rodrigoqweds90/Proyecto-Robot/CAD/Nuevo/vistas_torso/conceptos/estilo_2.jpg

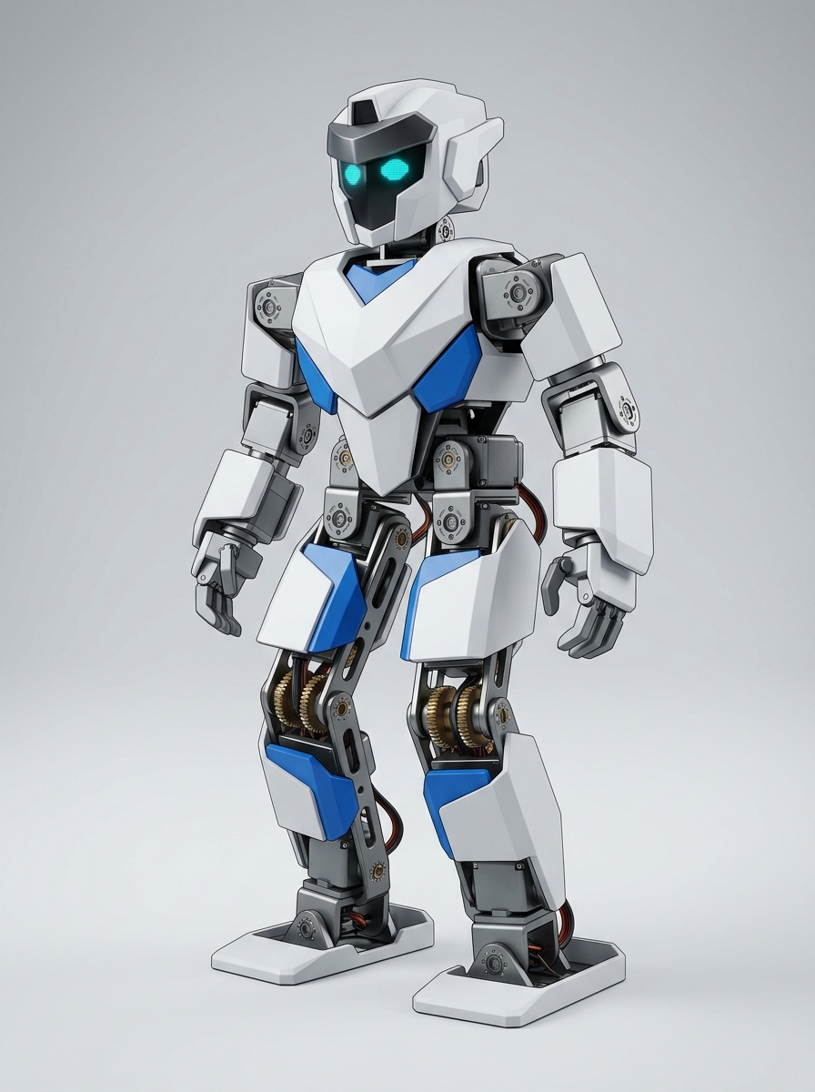
CAD/Nuevo/vistas_torso/conceptos/estilo_2.jpg
