rodrigoqweds90/Proyecto-Robot/CAD/Nuevo/vistas_torso/conceptos/concepto_4_gundam.jpg

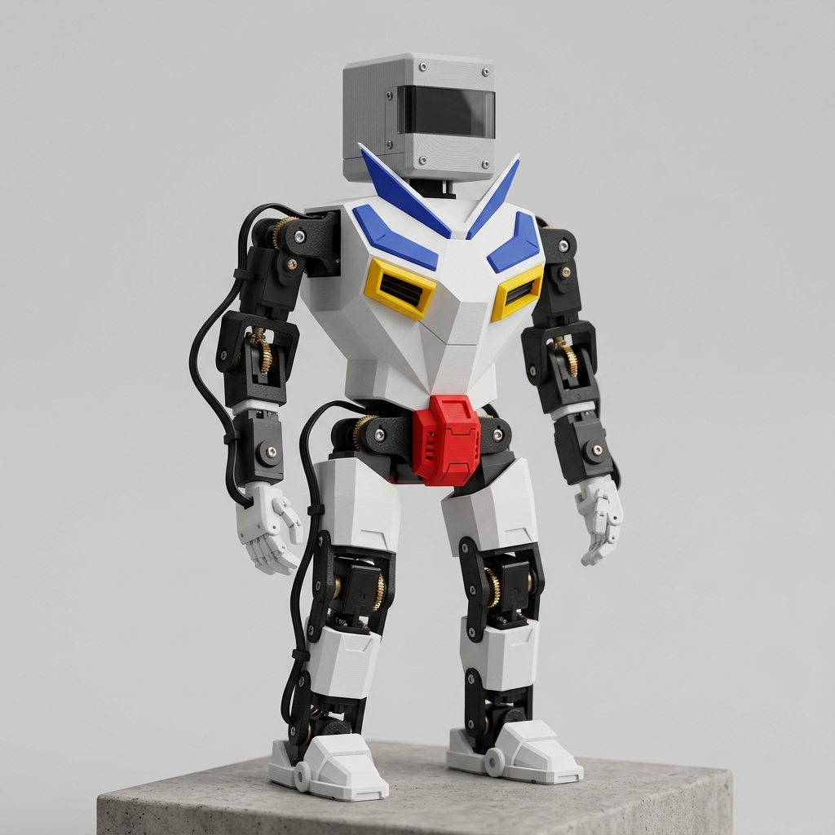
CAD/Nuevo/vistas_torso/conceptos/concepto_4_gundam.jpg
