rodrigoqweds90/Proyecto-Robot/movimientos/LEEME.txt

Poses y secuencias de la app (exportadas con "Exportar movimientos").
En otra PC: app RobotControl -> Configuracion -> Importar movimientos... -> elegir movimientos_robot.json
Cada secuencia es un ciclo de paso para "Repetir en bucle" (arrancar con el robot en Inicio).
Se actualiza corriendo herramientas/secuencias_finales.py y exportando de nuevo.
