rodrigoqweds90/Proyecto-Robot/CAD/Nuevo/conceptos/antebrazo/forearm_hand_concepts_1789850828380.jpg

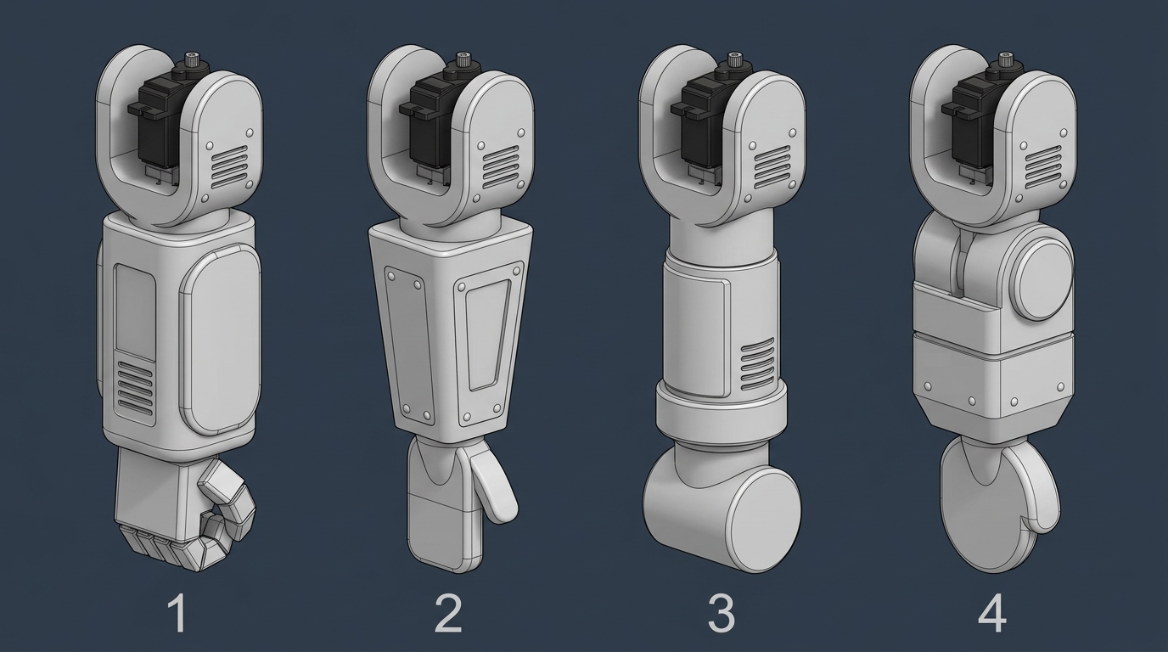
CAD/Nuevo/conceptos/antebrazo/forearm_hand_concepts_1789850828380.jpg
