rodrigoqweds90/Proyecto-Robot/CAD/Nuevo/fea/Bracket01_B_aligerada_esfuerzo.png

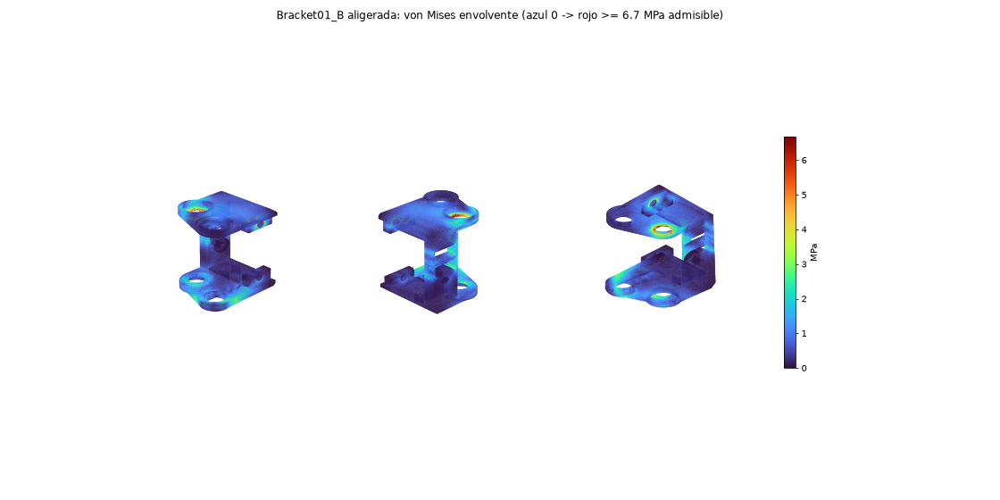
CAD/Nuevo/fea/Bracket01_B_aligerada_esfuerzo.png
