rodrigoqweds90/Proyecto-Robot/CAD/Nuevo/fea/Bracket02_W_aligerada_esfuerzo.png

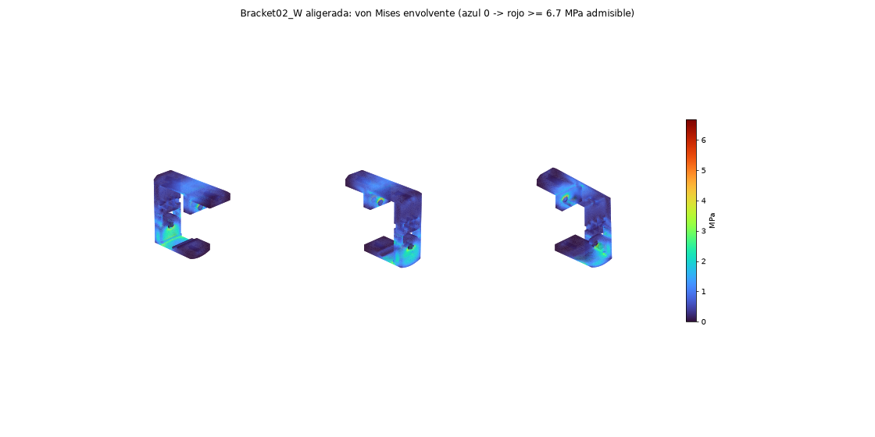
CAD/Nuevo/fea/Bracket02_W_aligerada_esfuerzo.png
