rodrigoqweds90/Proyecto-Robot/CAD/Nuevo/fea/Bracket03_B_esfuerzo.png

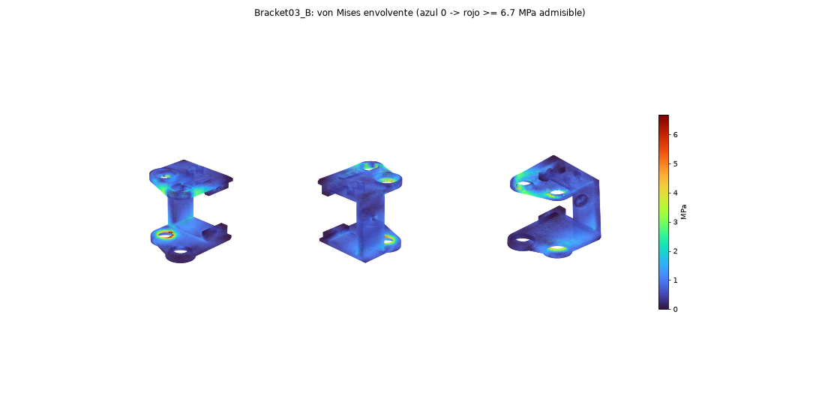
CAD/Nuevo/fea/Bracket03_B_esfuerzo.png
