rodrigoqweds90/Proyecto-Robot/CAD/Nuevo/fea/Bracket05_B_esfuerzo.png

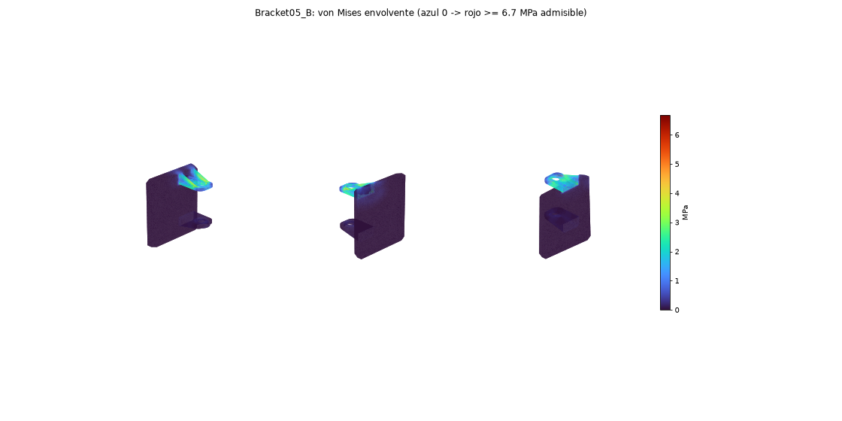
CAD/Nuevo/fea/Bracket05_B_esfuerzo.png
