rodrigoqweds90/Proyecto-Robot/CAD/Nuevo/fea/Bracket08_B_esfuerzo.png

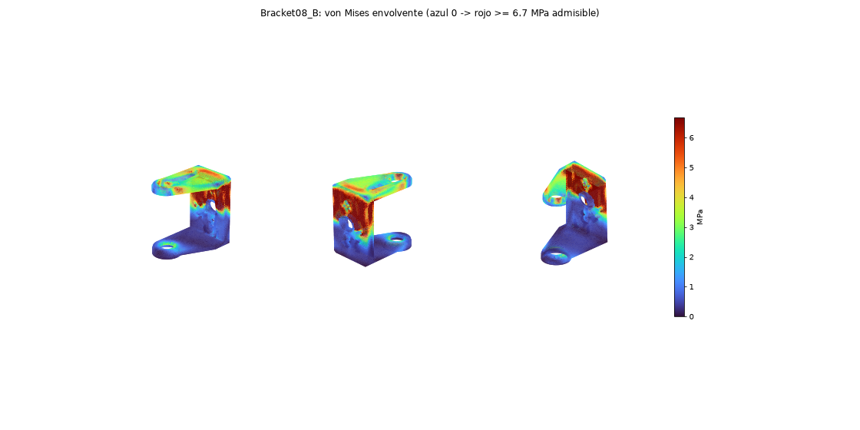
CAD/Nuevo/fea/Bracket08_B_esfuerzo.png
