rodrigoqweds90/Proyecto-Robot/CAD/Nuevo/fea/Bracket11_B_esfuerzo.png

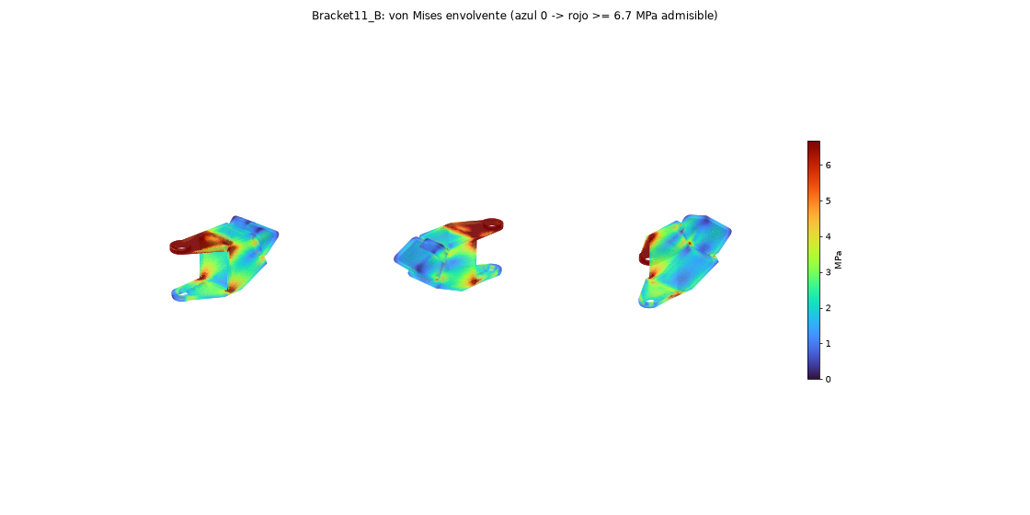
CAD/Nuevo/fea/Bracket11_B_esfuerzo.png
