rodrigoqweds90/Proyecto-Robot/CAD/Nuevo/fea/Link_W_esfuerzo.png

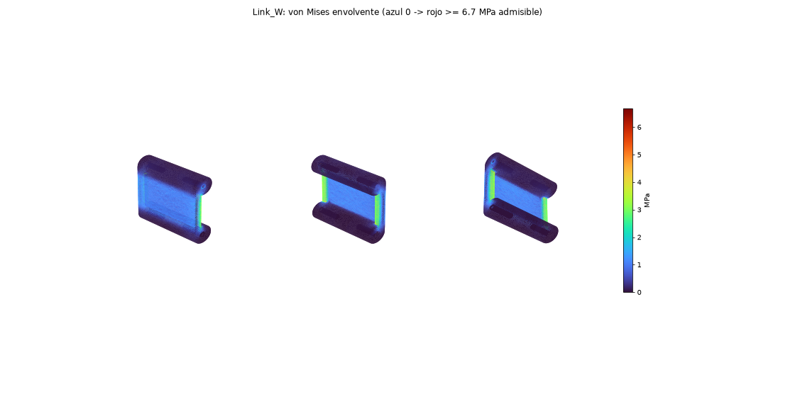
CAD/Nuevo/fea/Link_W_esfuerzo.png
