rodrigoqweds90/Proyecto-Robot/CAD/Nuevo/fea/Pelvis_esfuerzo.png

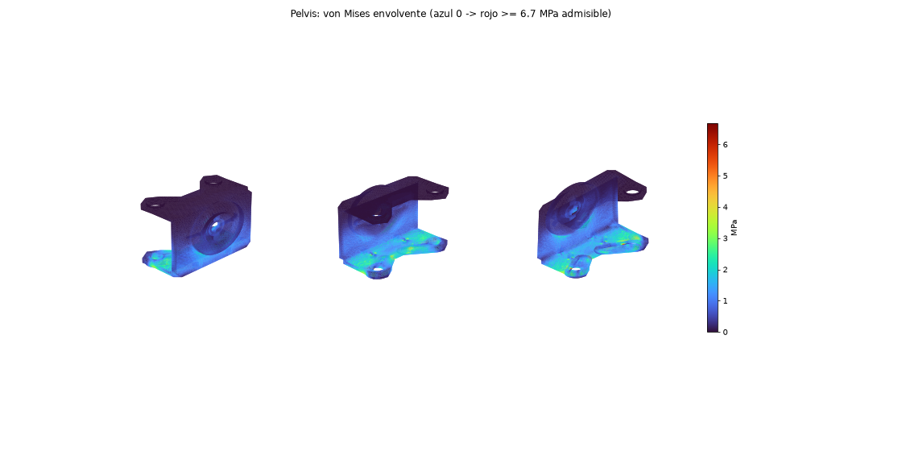
CAD/Nuevo/fea/Pelvis_esfuerzo.png
