rodrigoqweds90/Proyecto-Robot/CAD/Nuevo/fea/Torso_cuerpo_aligerada_esfuerzo.png

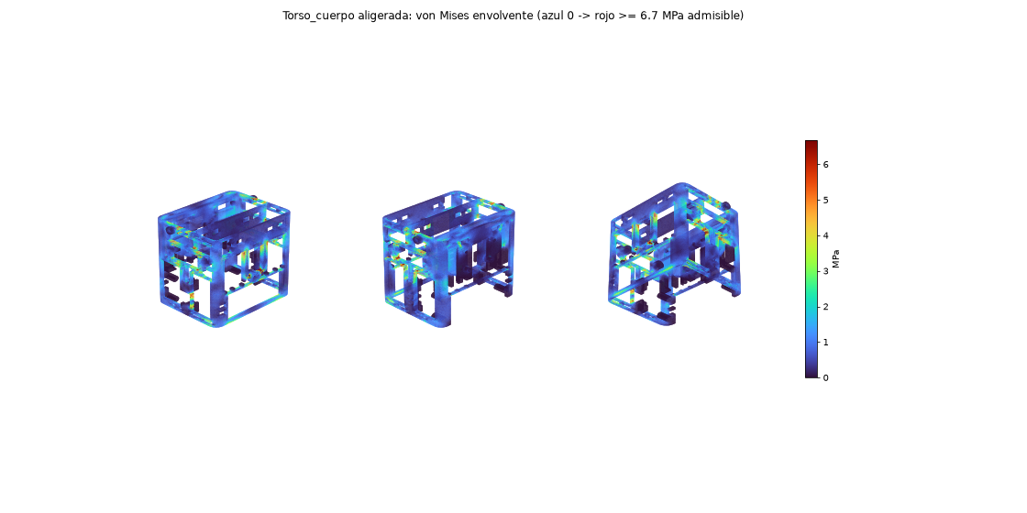
CAD/Nuevo/fea/Torso_cuerpo_aligerada_esfuerzo.png
