rodrigoqweds90/Proyecto-Robot/CAD/Nuevo/fea/ver_pelvis.png

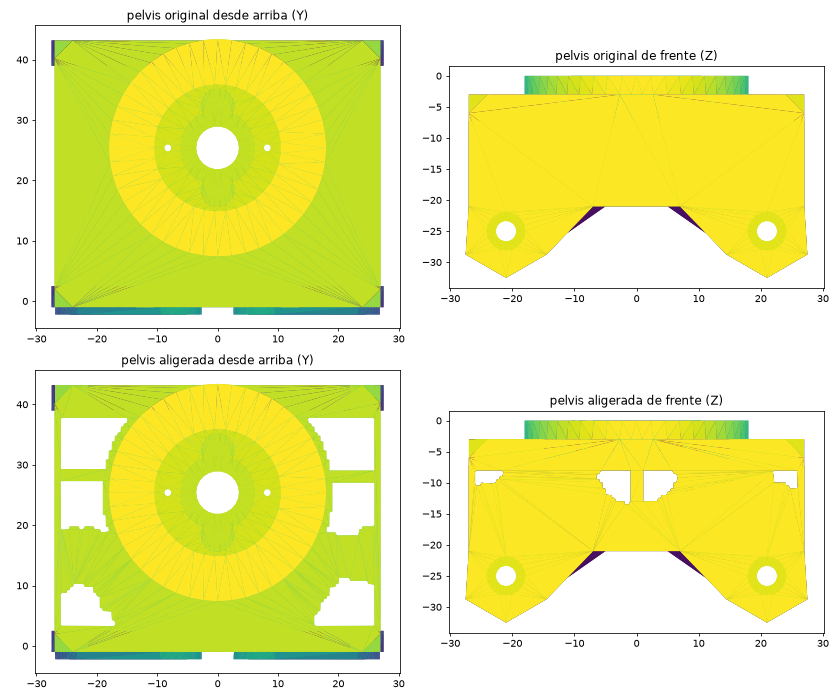
CAD/Nuevo/fea/ver_pelvis.png
