rodrigoqweds90/Proyecto-Robot/CAD/Nuevo/fea/ver_pie.png

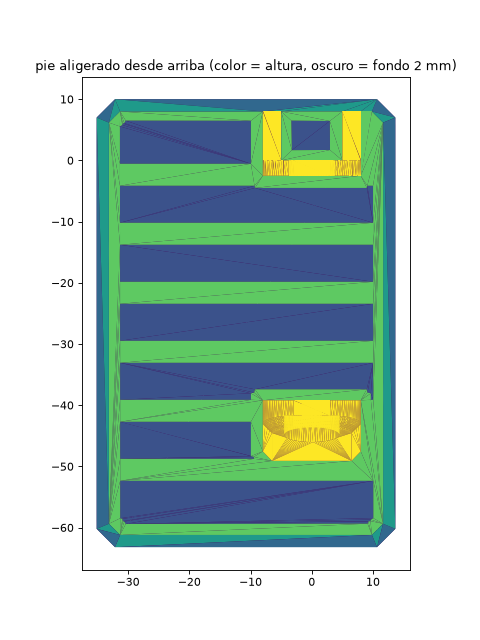
CAD/Nuevo/fea/ver_pie.png
