rodrigoqweds90/Proyecto-Robot/CAD/Nuevo/vistas/cabeza_4_vistas.png

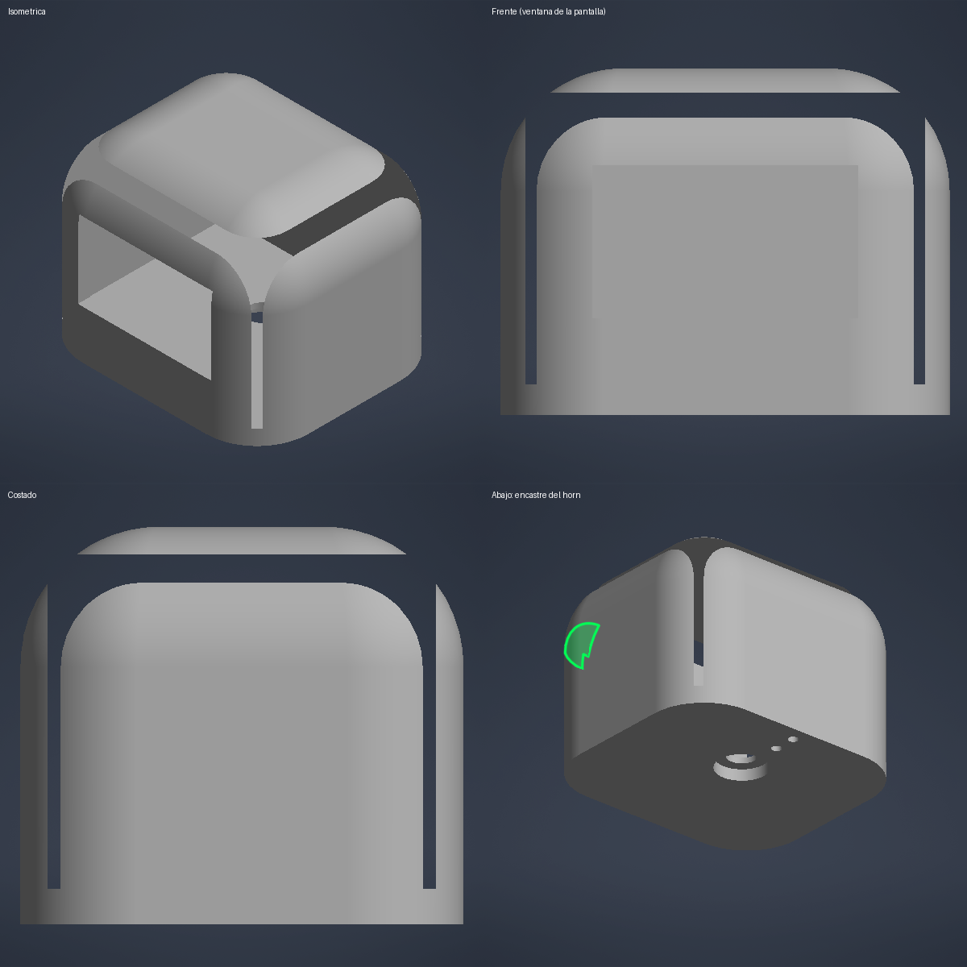
CAD/Nuevo/vistas/cabeza_4_vistas.png
