rodrigoqweds90/Proyecto-Robot/CAD/Nuevo/vistas/cabeza_abajo.png

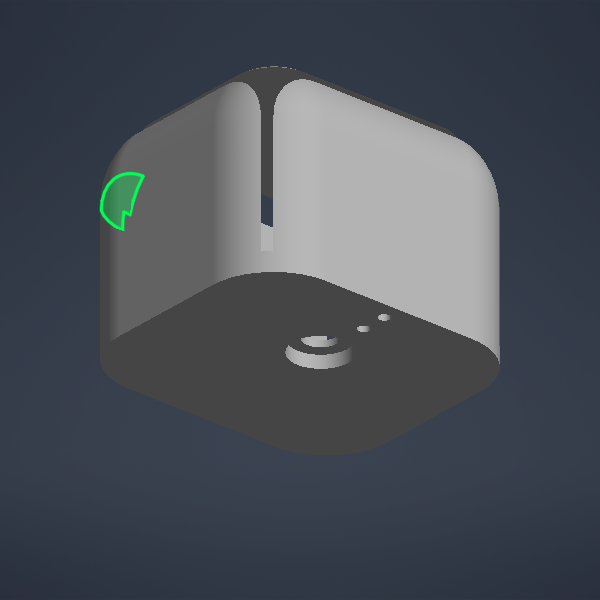
CAD/Nuevo/vistas/cabeza_abajo.png
