rodrigoqweds90/Proyecto-Robot/CAD/Nuevo/vistas/cabeza_atras.png

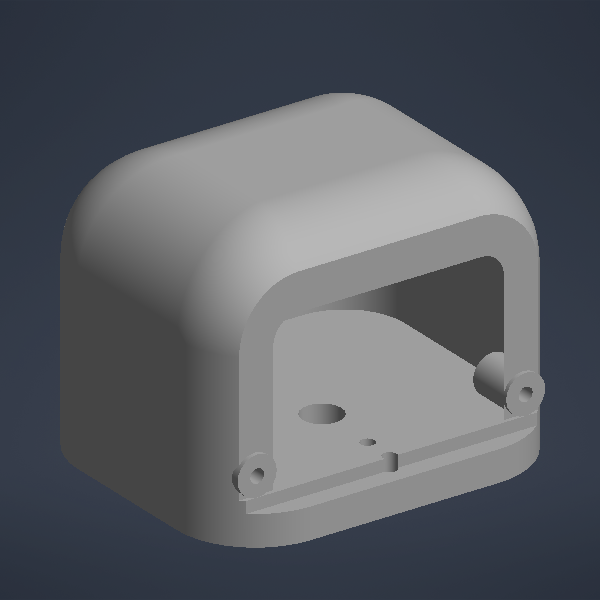
CAD/Nuevo/vistas/cabeza_atras.png
