rodrigoqweds90/Proyecto-Robot/CAD/Nuevo/vistas/cabeza_costado.png

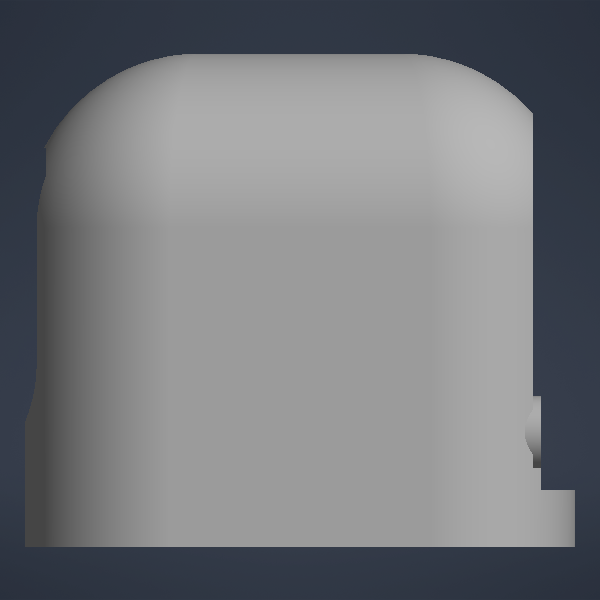
CAD/Nuevo/vistas/cabeza_costado.png
