rodrigoqweds90/Proyecto-Robot/CAD/Nuevo/vistas/cabeza_frente.png

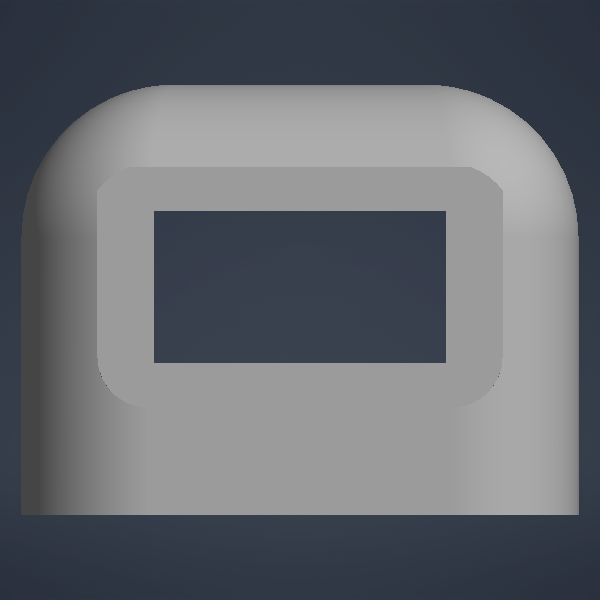
CAD/Nuevo/vistas/cabeza_frente.png
