rodrigoqweds90/Proyecto-Robot/CAD/Nuevo/vistas/cabeza_iso.png

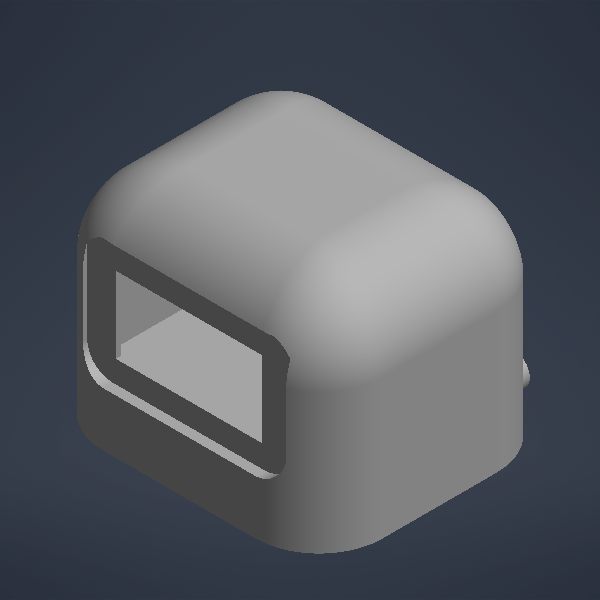
CAD/Nuevo/vistas/cabeza_iso.png
