rodrigoqweds90/Proyecto-Robot/CAD/Nuevo/vistas/cabeza_tresc.png

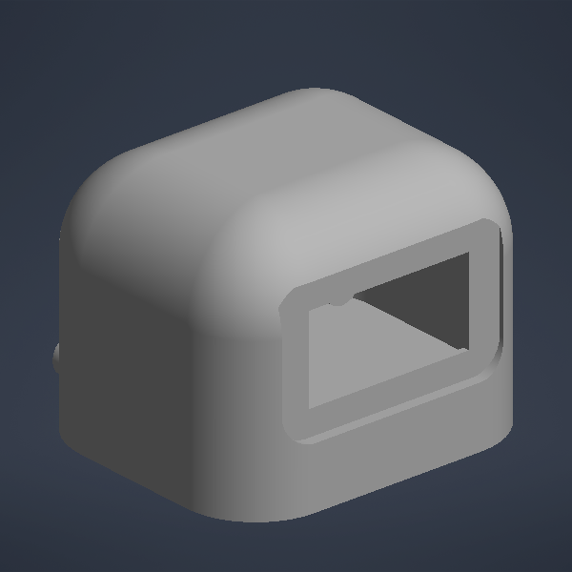
CAD/Nuevo/vistas/cabeza_tresc.png
