rodrigoqweds90/Proyecto-Robot/CAD/Nuevo/vistas_robot/atras.png

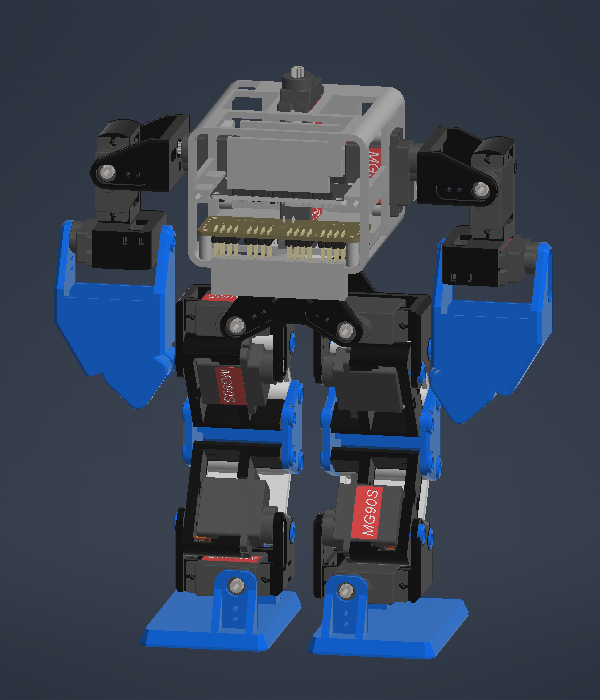
CAD/Nuevo/vistas_robot/atras.png
