rodrigoqweds90/Proyecto-Robot/CAD/Nuevo/vistas_robot/costado.png

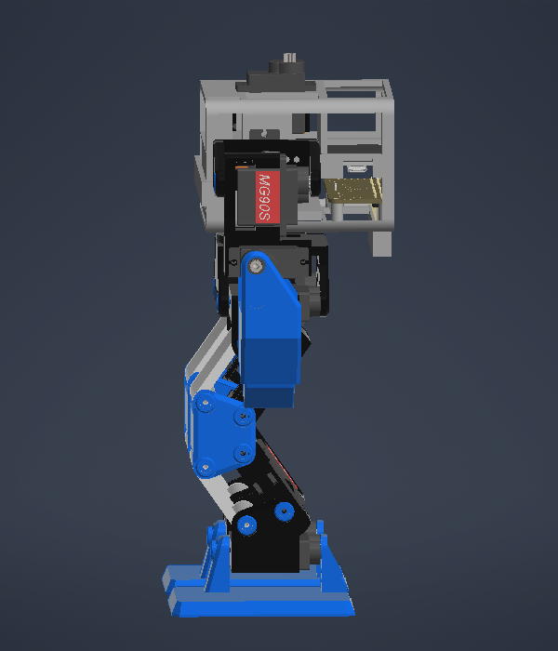
CAD/Nuevo/vistas_robot/costado.png
