rodrigoqweds90/Proyecto-Robot/CAD/Nuevo/vistas_robot/frente.png

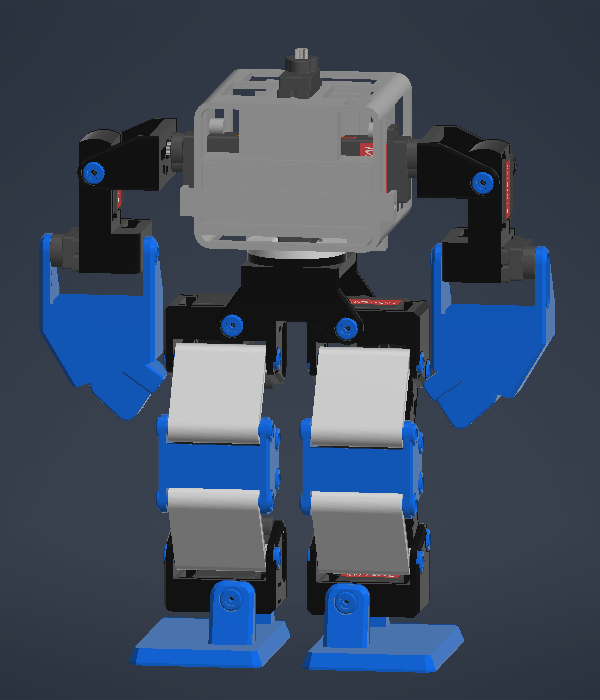
CAD/Nuevo/vistas_robot/frente.png
