rodrigoqweds90/Proyecto-Robot/CAD/Nuevo/vistas_robot/pelvis_0.png

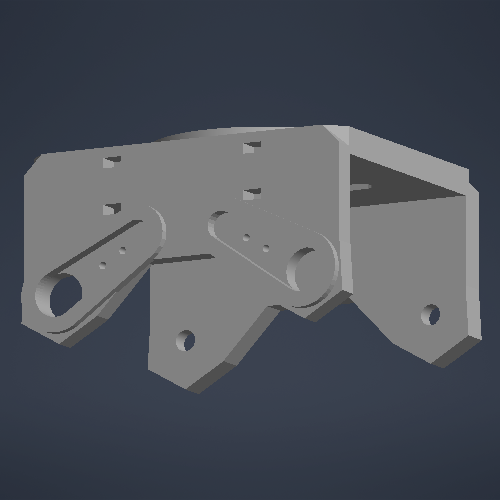
CAD/Nuevo/vistas_robot/pelvis_0.png
