rodrigoqweds90/Proyecto-Robot/CAD/Nuevo/vistas_robot/pelvis_1.png

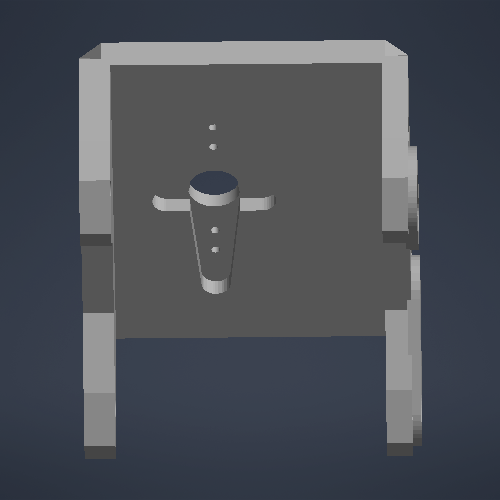
CAD/Nuevo/vistas_robot/pelvis_1.png
