rodrigoqweds90/Proyecto-Robot/CAD/Nuevo/vistas_robot/pelvis_2.png

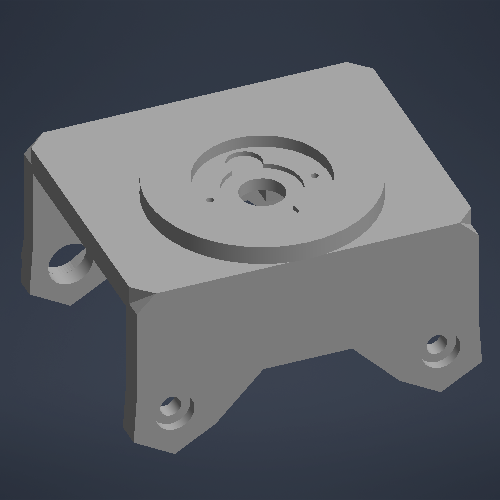
CAD/Nuevo/vistas_robot/pelvis_2.png
