rodrigoqweds90/Proyecto-Robot/CAD/Nuevo/vistas_robot/pelvis_3.png

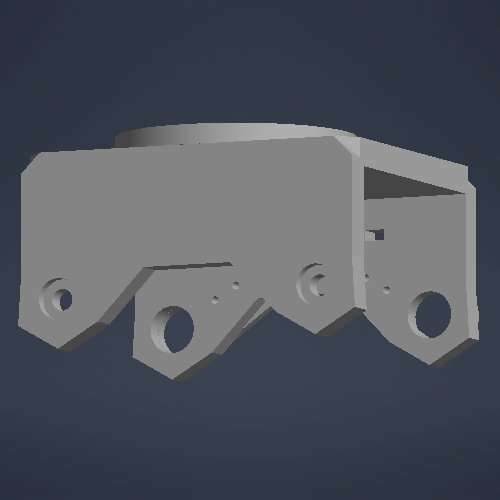
CAD/Nuevo/vistas_robot/pelvis_3.png
