rodrigoqweds90/Proyecto-Robot/CAD/Nuevo/vistas_robot/pelvis_4_vistas.png

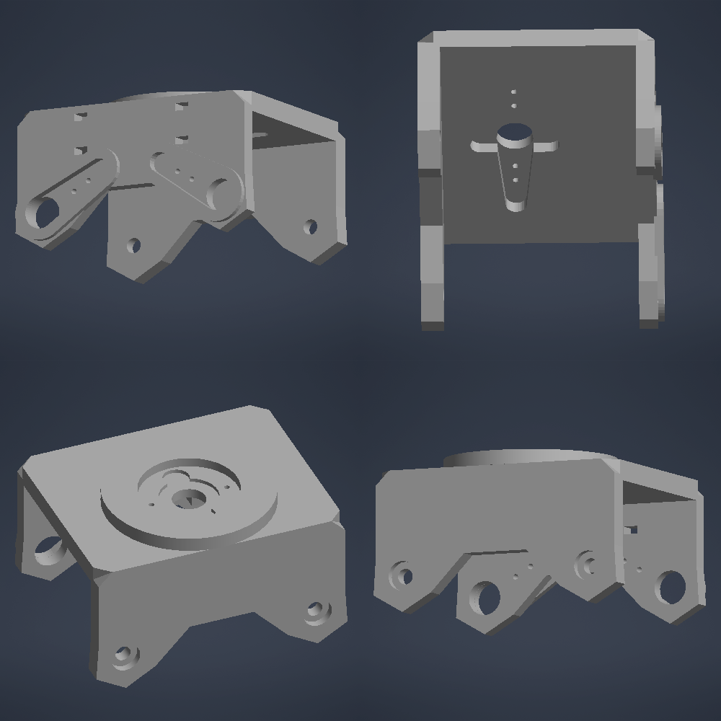
CAD/Nuevo/vistas_robot/pelvis_4_vistas.png
