rodrigoqweds90/Proyecto-Robot/CAD/Nuevo/vistas_robot/tres_cuartos_atras.png

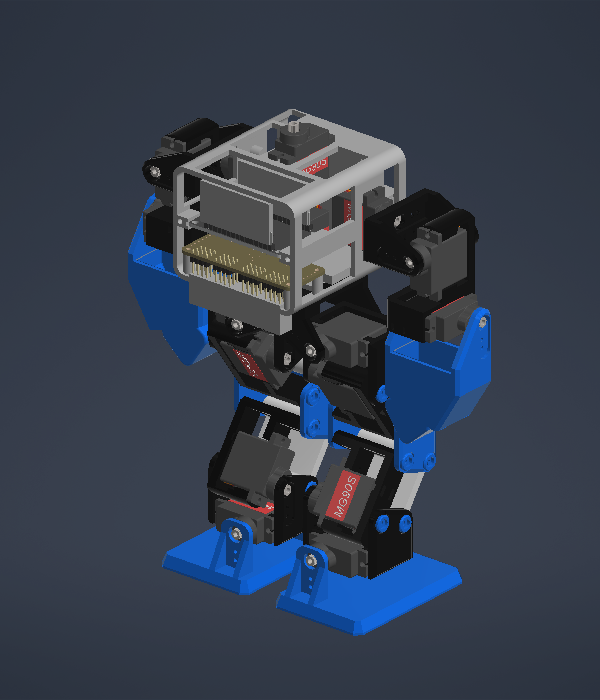
CAD/Nuevo/vistas_robot/tres_cuartos_atras.png
