rodrigoqweds90/Proyecto-Robot/CAD/Nuevo/vistas_torso/analisis_desplazamiento_torso.png

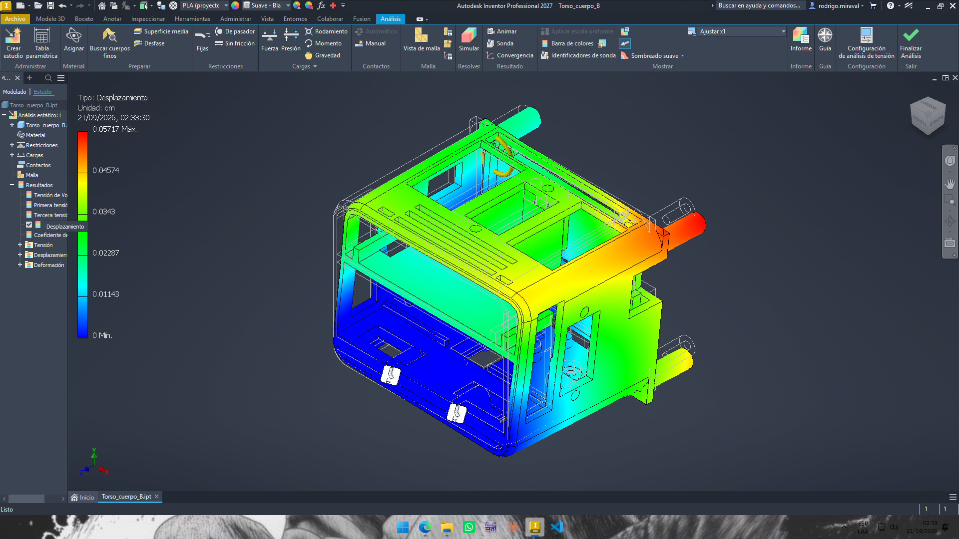
CAD/Nuevo/vistas_torso/analisis_desplazamiento_torso.png
