rodrigoqweds90/Proyecto-Robot/CAD/Nuevo/vistas_torso/b02A_2.png

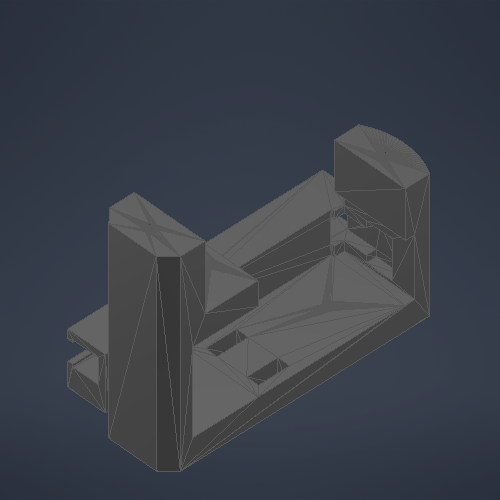
CAD/Nuevo/vistas_torso/b02A_2.png
