rodrigoqweds90/Proyecto-Robot/CAD/Nuevo/vistas_torso/b02A_3.png

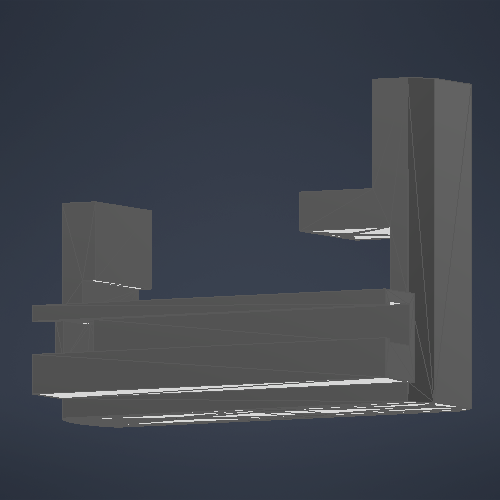
CAD/Nuevo/vistas_torso/b02A_3.png
