rodrigoqweds90/Proyecto-Robot/CAD/Nuevo/vistas_torso/boceto_atras.png

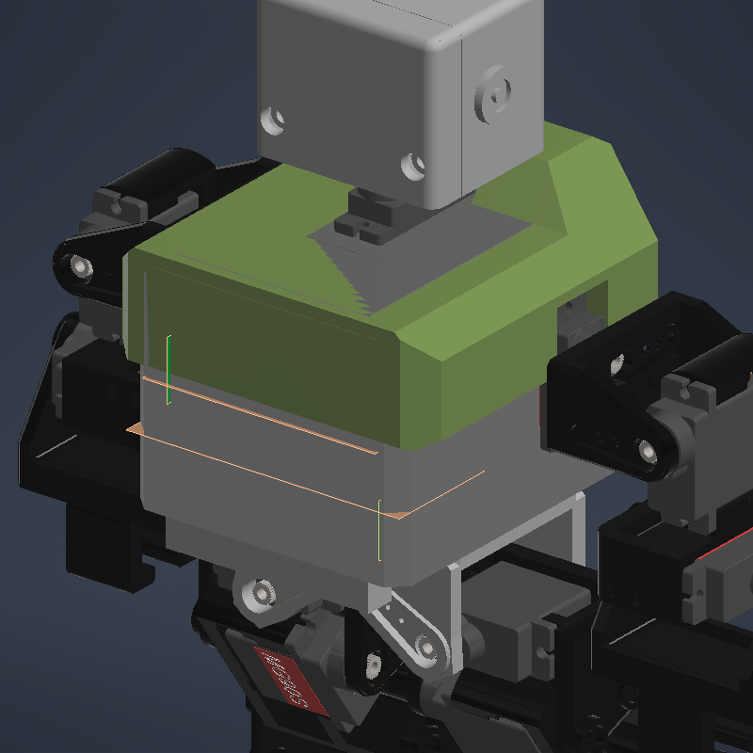
CAD/Nuevo/vistas_torso/boceto_atras.png
