rodrigoqweds90/Proyecto-Robot/CAD/Nuevo/vistas_torso/boceto_costado.png

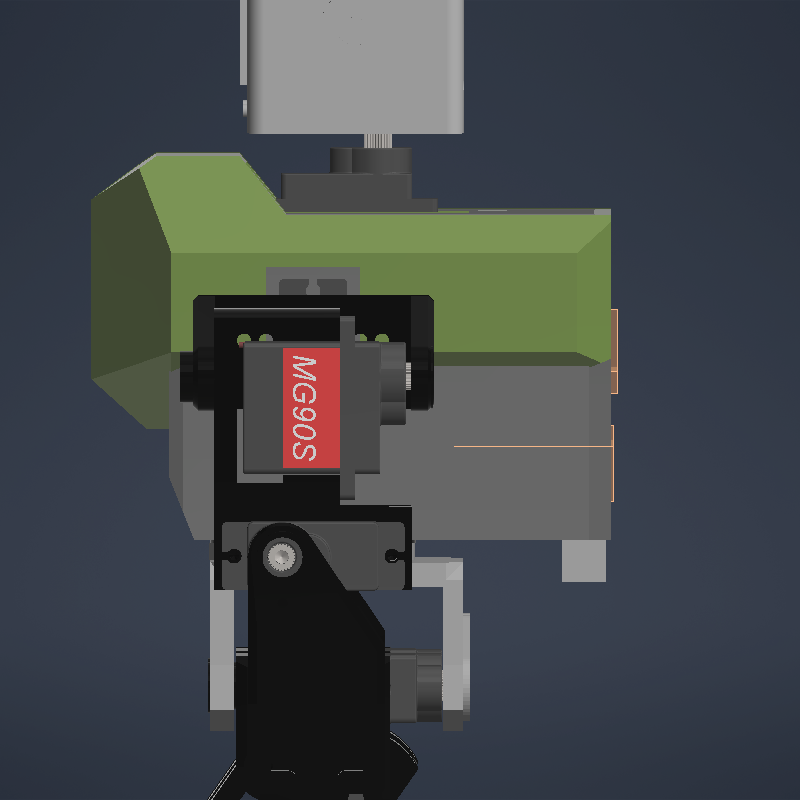
CAD/Nuevo/vistas_torso/boceto_costado.png
