rodrigoqweds90/Proyecto-Robot/CAD/Nuevo/vistas_torso/boceto_frente.png

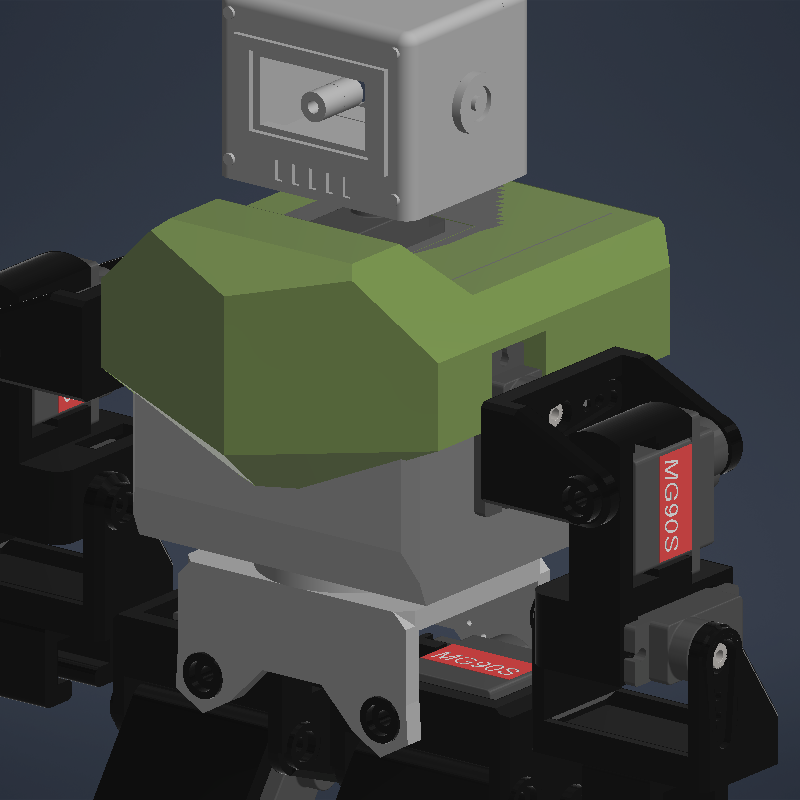
CAD/Nuevo/vistas_torso/boceto_frente.png
