rodrigoqweds90/Proyecto-Robot/CAD/Nuevo/vistas_torso/boceto_robot.png

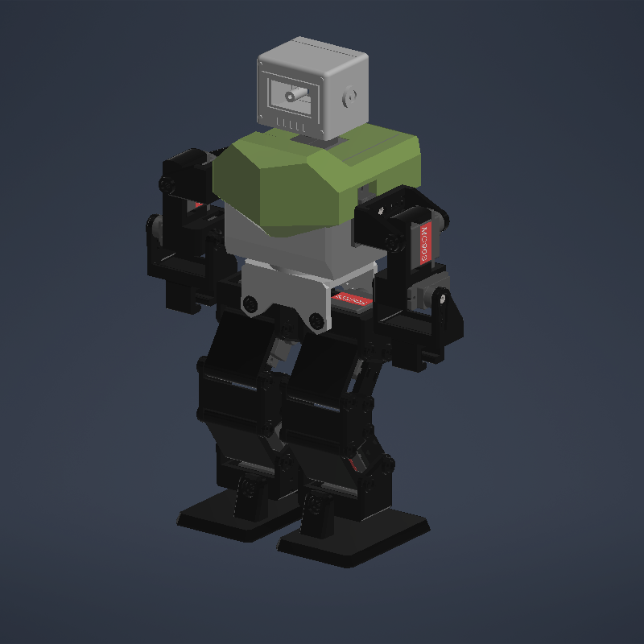
CAD/Nuevo/vistas_torso/boceto_robot.png
