rodrigoqweds90/Proyecto-Robot/CAD/Nuevo/vistas_torso/Bracket02_A_canal.png

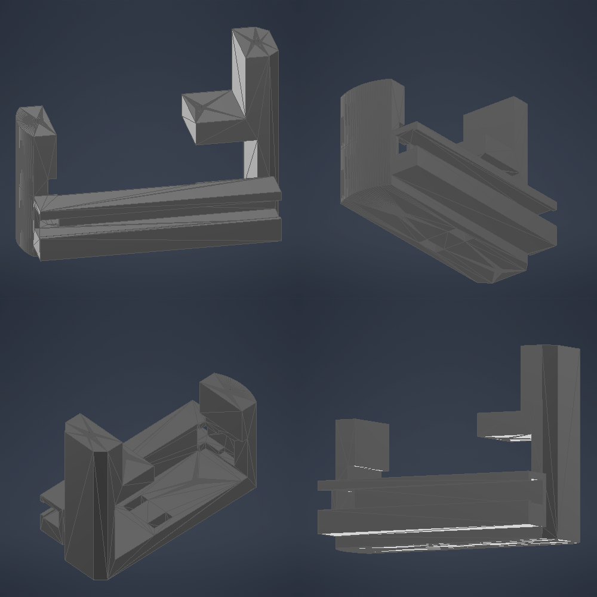
CAD/Nuevo/vistas_torso/Bracket02_A_canal.png
