rodrigoqweds90/Proyecto-Robot/CAD/Nuevo/vistas_torso/Bracket02_brida.png

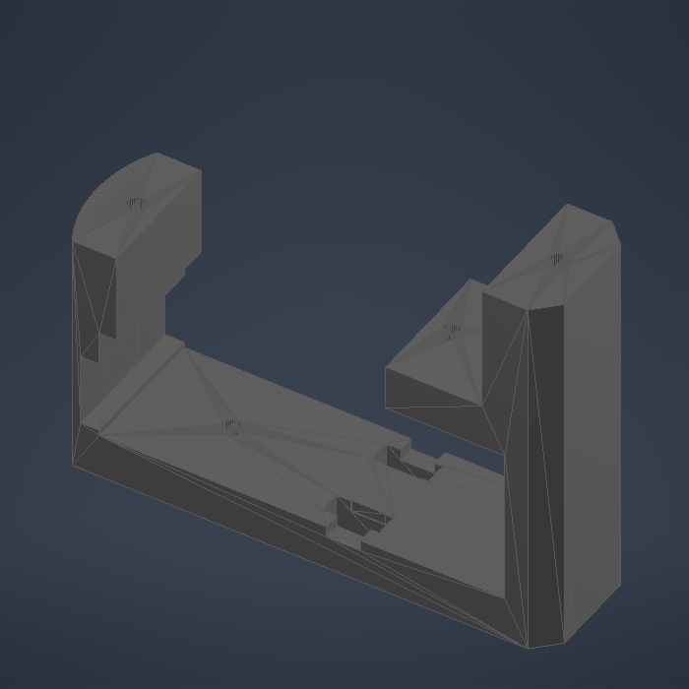
CAD/Nuevo/vistas_torso/Bracket02_brida.png
