rodrigoqweds90/Proyecto-Robot/CAD/Nuevo/vistas_torso/cabeza_0.png

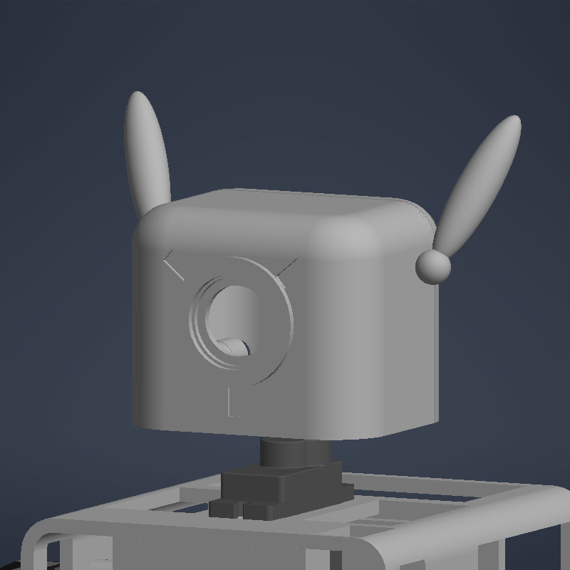
CAD/Nuevo/vistas_torso/cabeza_0.png
