rodrigoqweds90/Proyecto-Robot/CAD/Nuevo/vistas_torso/cabeza_1.png

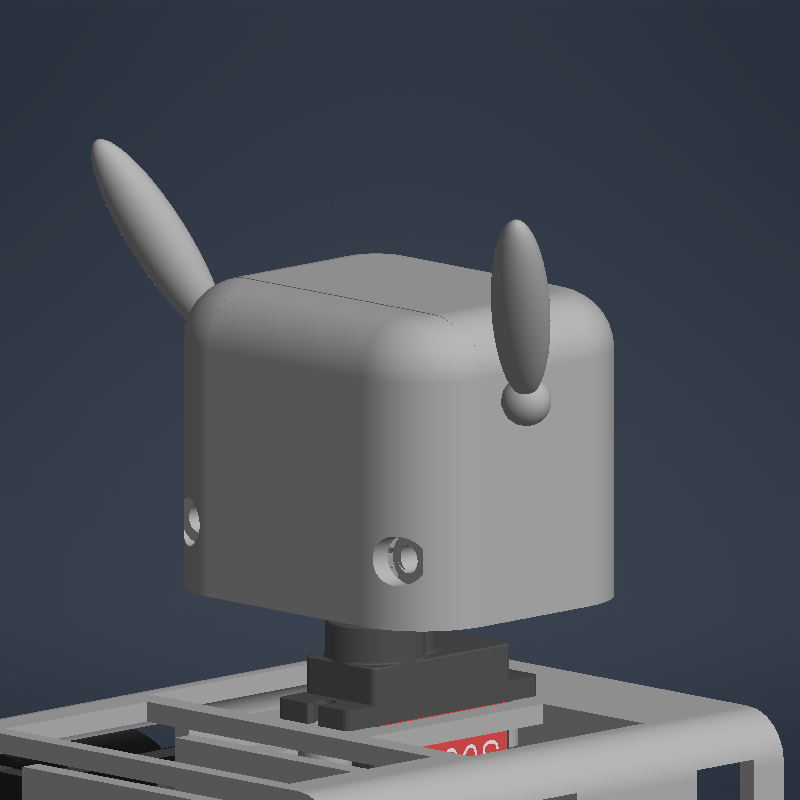
CAD/Nuevo/vistas_torso/cabeza_1.png
