rodrigoqweds90/Proyecto-Robot/CAD/Nuevo/vistas_torso/cabeza_2.png

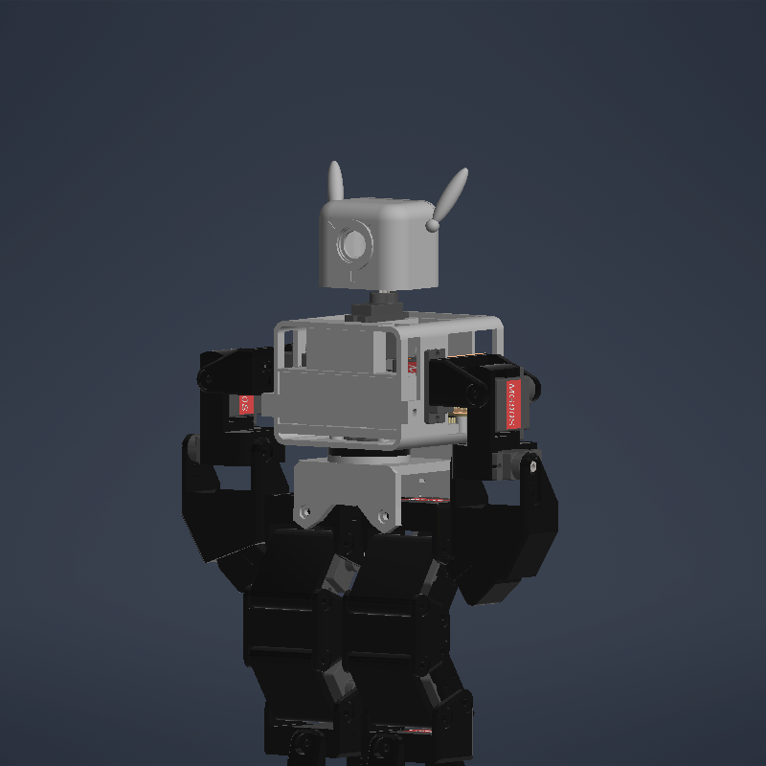
CAD/Nuevo/vistas_torso/cabeza_2.png
