rodrigoqweds90/Proyecto-Robot/CAD/Nuevo/vistas_torso/cabeza_check.png

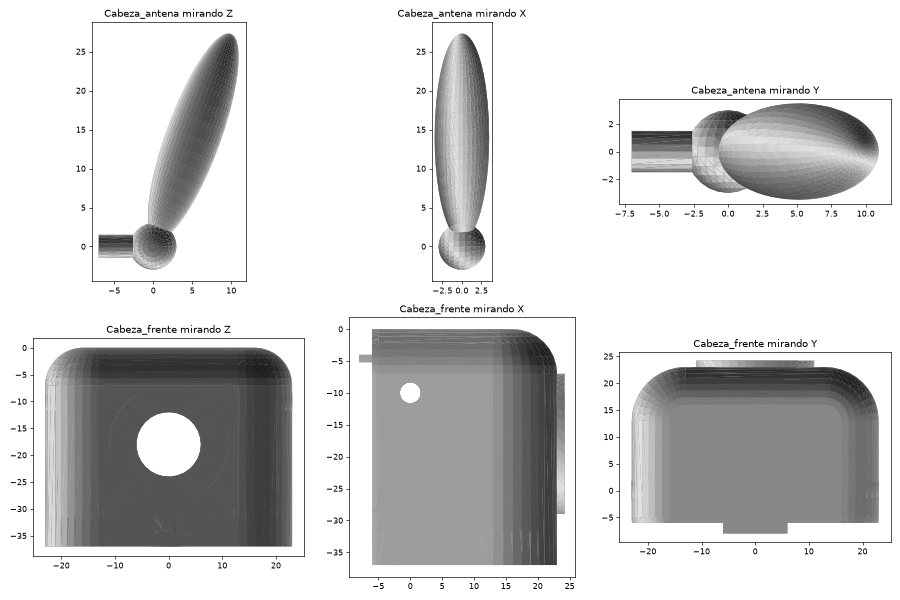
CAD/Nuevo/vistas_torso/cabeza_check.png
