rodrigoqweds90/Proyecto-Robot/CAD/Nuevo/vistas_torso/cabeza_nueva.png

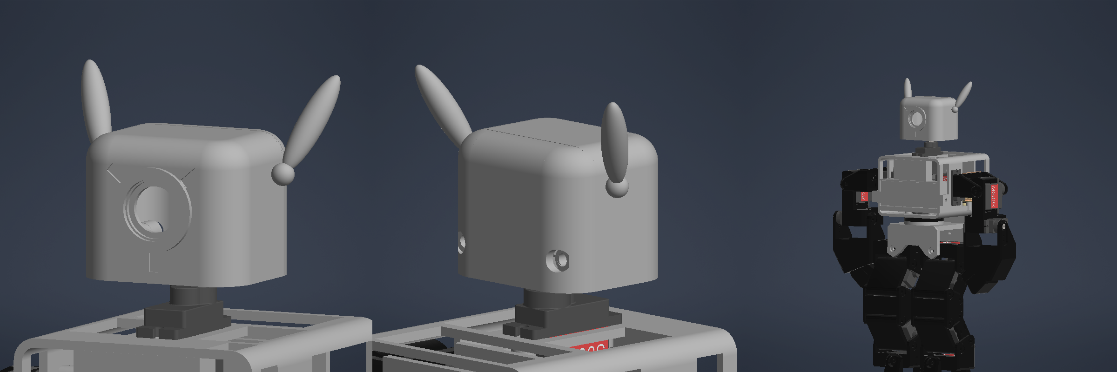
CAD/Nuevo/vistas_torso/cabeza_nueva.png
