rodrigoqweds90/Proyecto-Robot/CAD/Nuevo/vistas_torso/canal_Bracket02_W_iso3.png

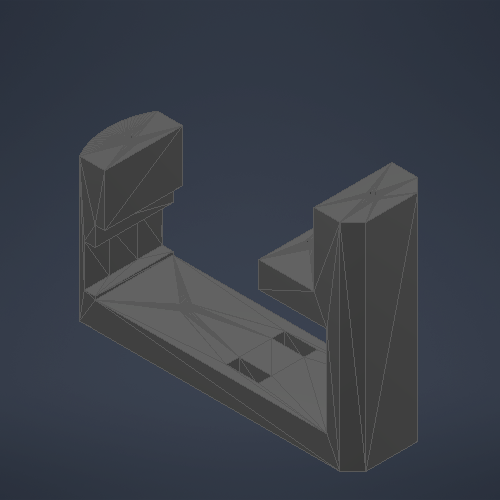
CAD/Nuevo/vistas_torso/canal_Bracket02_W_iso3.png
