rodrigoqweds90/Proyecto-Robot/CAD/Nuevo/vistas_torso/canal_brazo.png

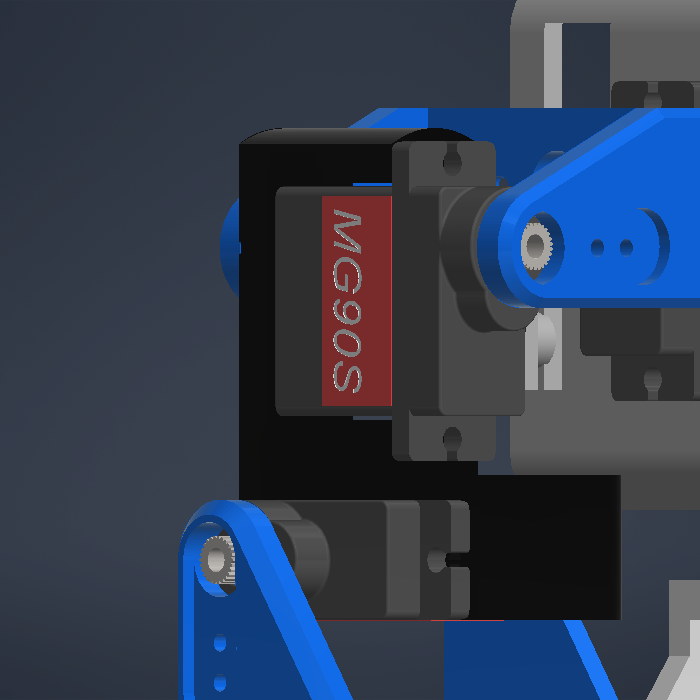
CAD/Nuevo/vistas_torso/canal_brazo.png
