rodrigoqweds90/Proyecto-Robot/CAD/Nuevo/vistas_torso/canal_muslo_afuera.png

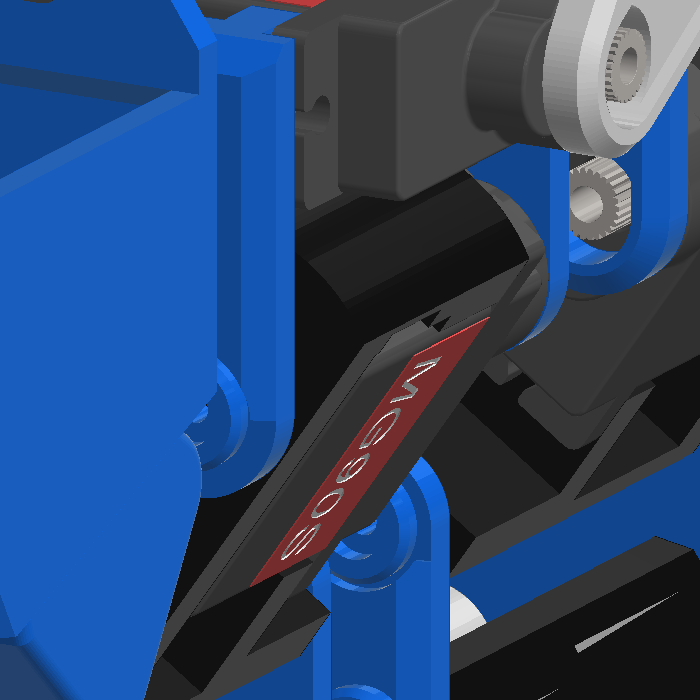
CAD/Nuevo/vistas_torso/canal_muslo_afuera.png
