rodrigoqweds90/Proyecto-Robot/CAD/Nuevo/vistas_torso/canal_muslo_atras.png

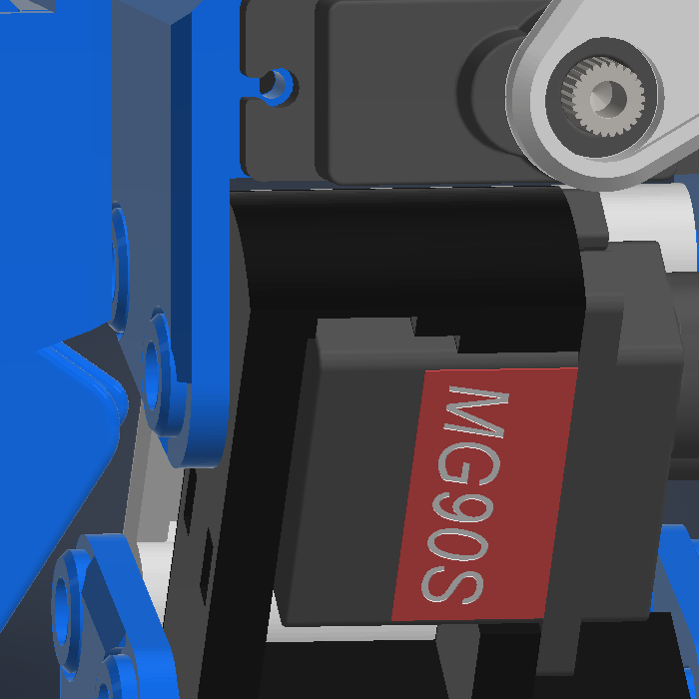
CAD/Nuevo/vistas_torso/canal_muslo_atras.png
