rodrigoqweds90/Proyecto-Robot/CAD/Nuevo/vistas_torso/canal_tibia_atras.png

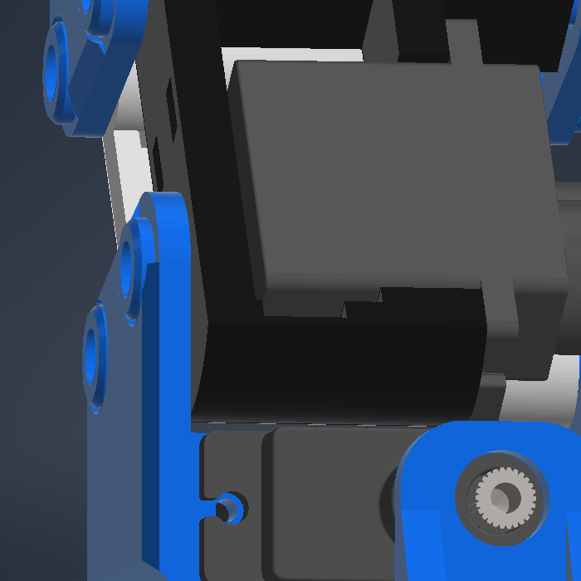
CAD/Nuevo/vistas_torso/canal_tibia_atras.png
