rodrigoqweds90/Proyecto-Robot/CAD/Nuevo/vistas_torso/caras_estilo.png

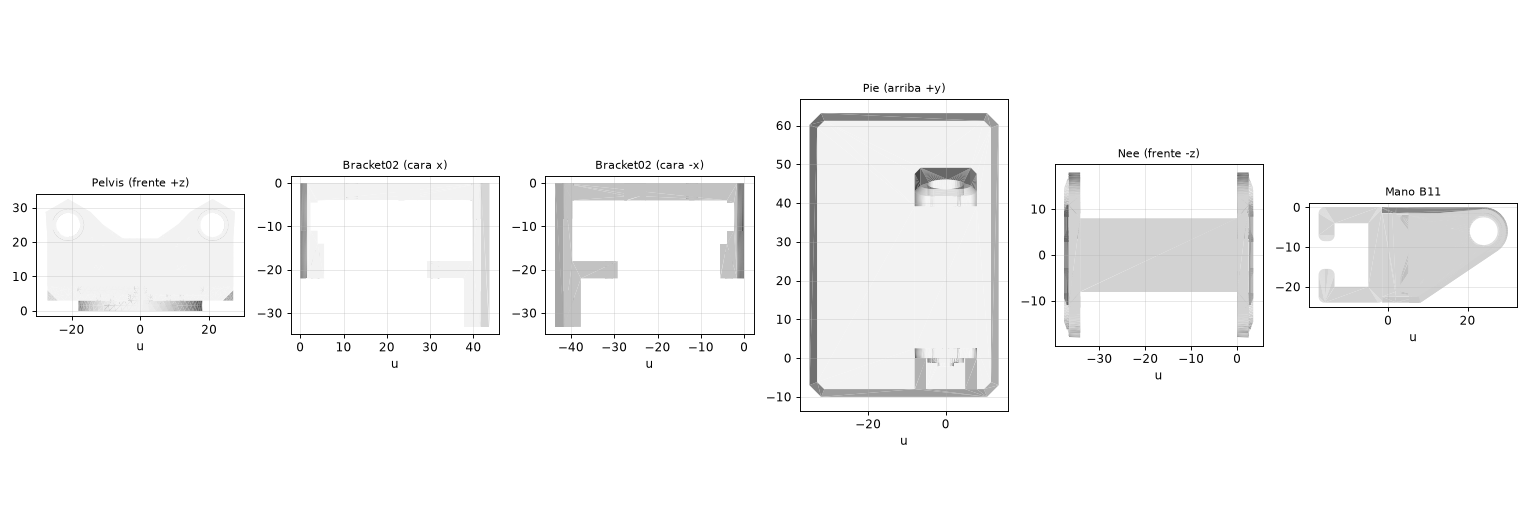
CAD/Nuevo/vistas_torso/caras_estilo.png
