rodrigoqweds90/Proyecto-Robot/CAD/Nuevo/vistas_torso/chaflan_esquina.png

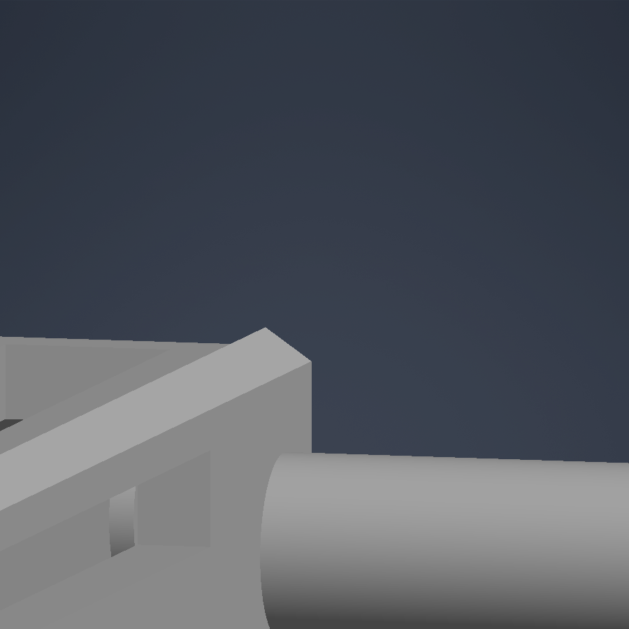
CAD/Nuevo/vistas_torso/chaflan_esquina.png
