rodrigoqweds90/Proyecto-Robot/CAD/Nuevo/vistas_torso/chaflan_frente.png

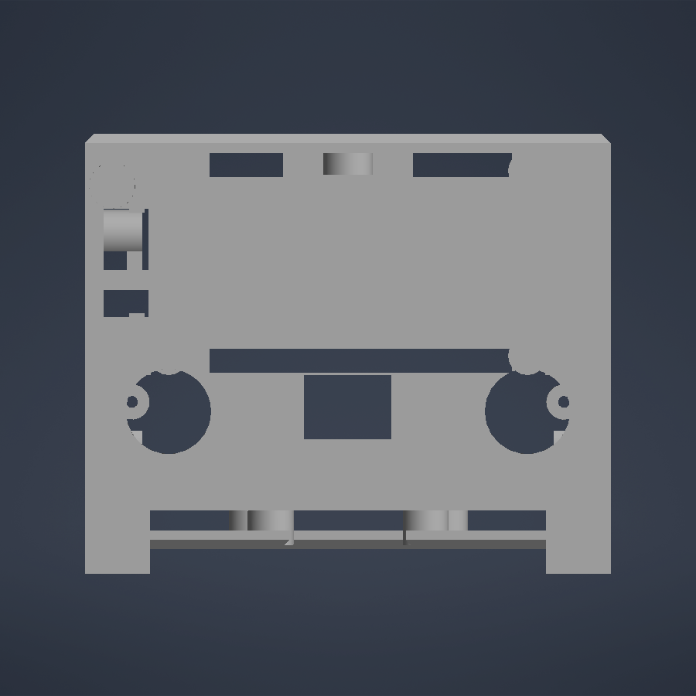
CAD/Nuevo/vistas_torso/chaflan_frente.png
