rodrigoqweds90/Proyecto-Robot/CAD/Nuevo/vistas_torso/chaflan_recto.png

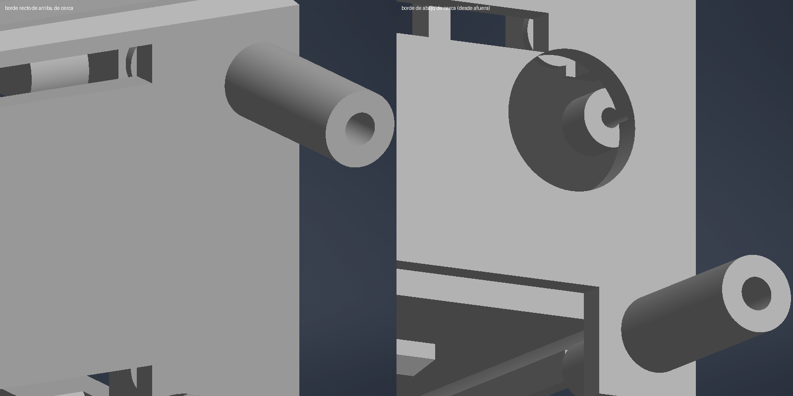
CAD/Nuevo/vistas_torso/chaflan_recto.png
