rodrigoqweds90/Proyecto-Robot/CAD/Nuevo/vistas_torso/chaflan_revision.png

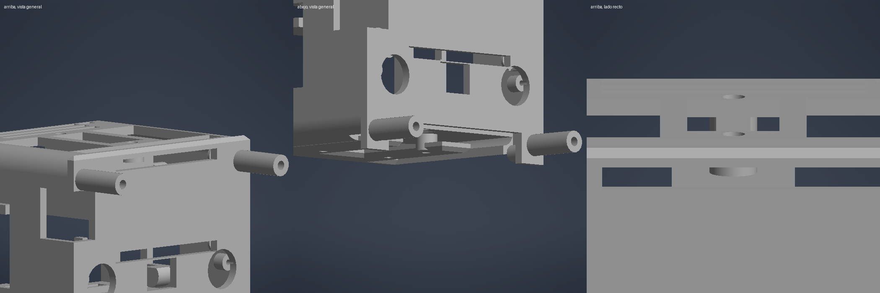
CAD/Nuevo/vistas_torso/chaflan_revision.png
