rodrigoqweds90/Proyecto-Robot/CAD/Nuevo/vistas_torso/clasico_0.png

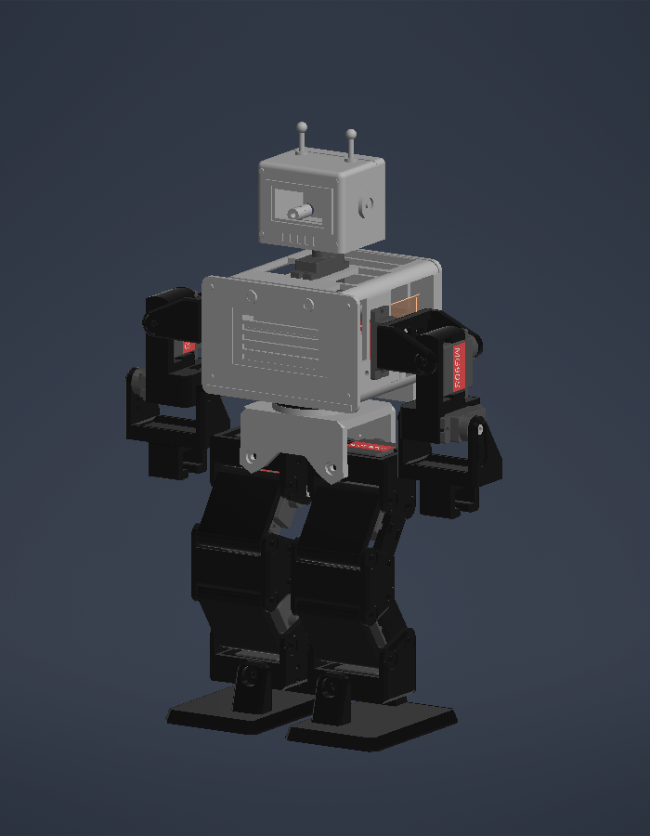
CAD/Nuevo/vistas_torso/clasico_0.png
