rodrigoqweds90/Proyecto-Robot/CAD/Nuevo/vistas_torso/clasico_1.png

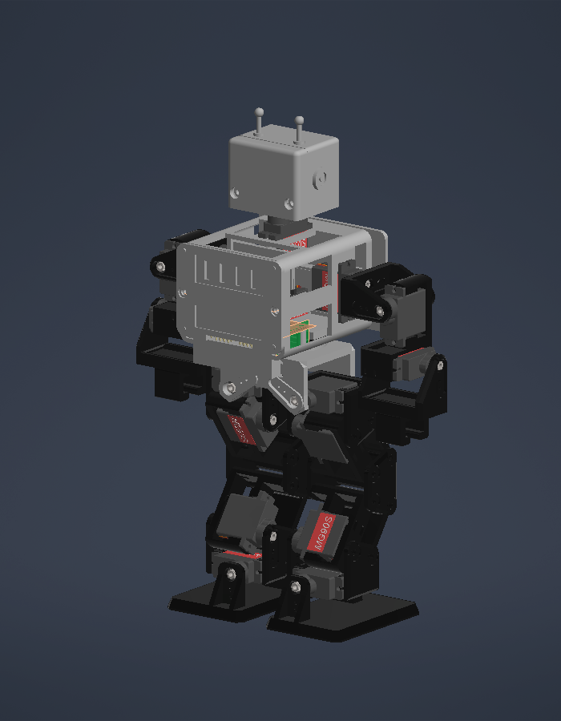
CAD/Nuevo/vistas_torso/clasico_1.png
