rodrigoqweds90/Proyecto-Robot/CAD/Nuevo/vistas_torso/clasico_2.png

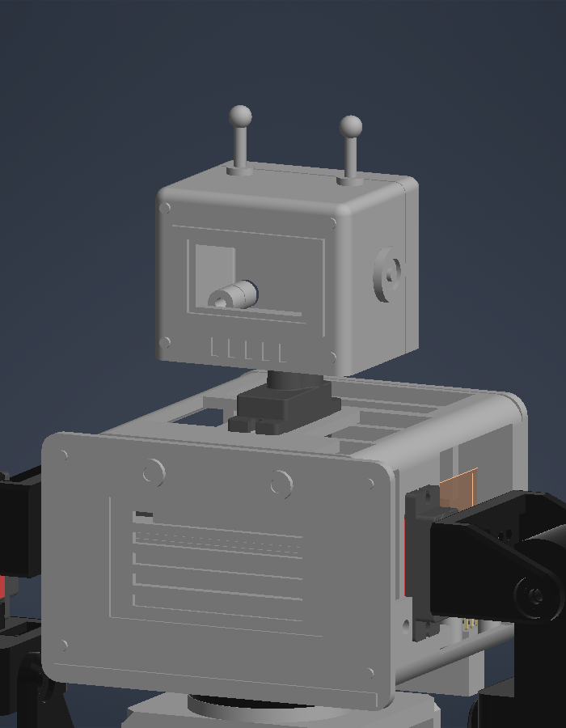
CAD/Nuevo/vistas_torso/clasico_2.png
