rodrigoqweds90/Proyecto-Robot/CAD/Nuevo/vistas_torso/clasico_atras.png

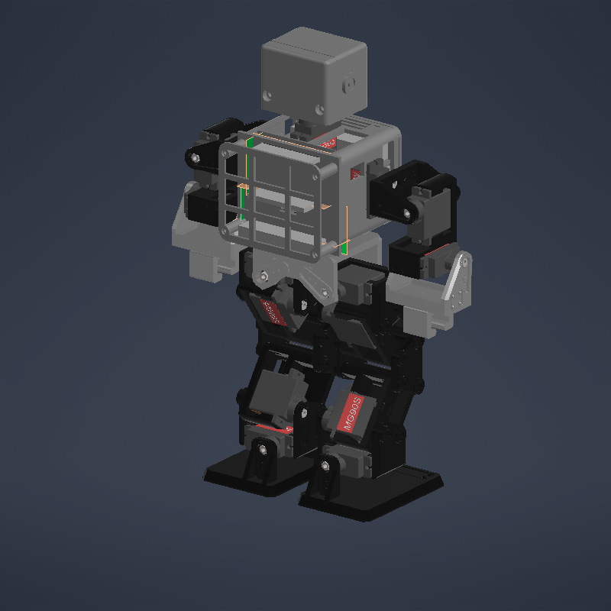
CAD/Nuevo/vistas_torso/clasico_atras.png
