rodrigoqweds90/Proyecto-Robot/CAD/Nuevo/vistas_torso/clasico_piernas.png

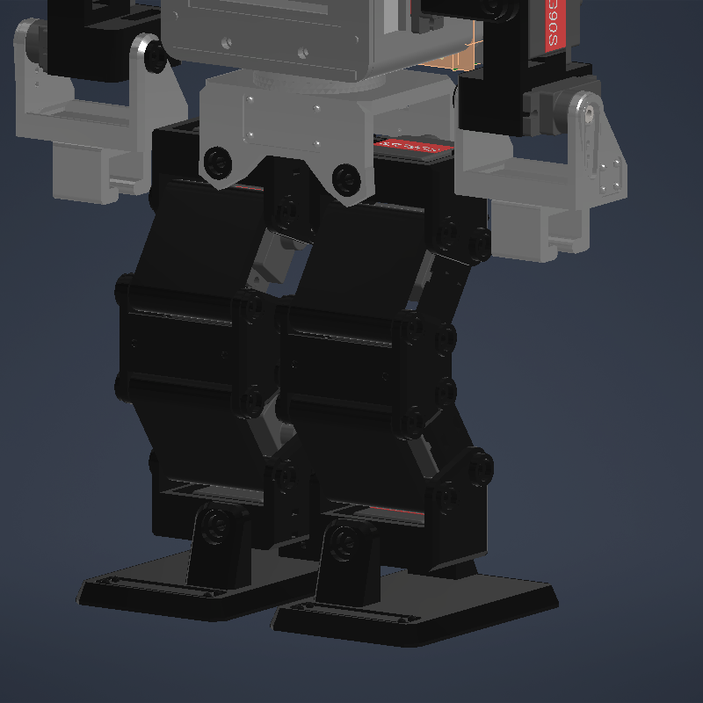
CAD/Nuevo/vistas_torso/clasico_piernas.png
