rodrigoqweds90/Proyecto-Robot/CAD/Nuevo/vistas_torso/clasico_piernas_torso.png

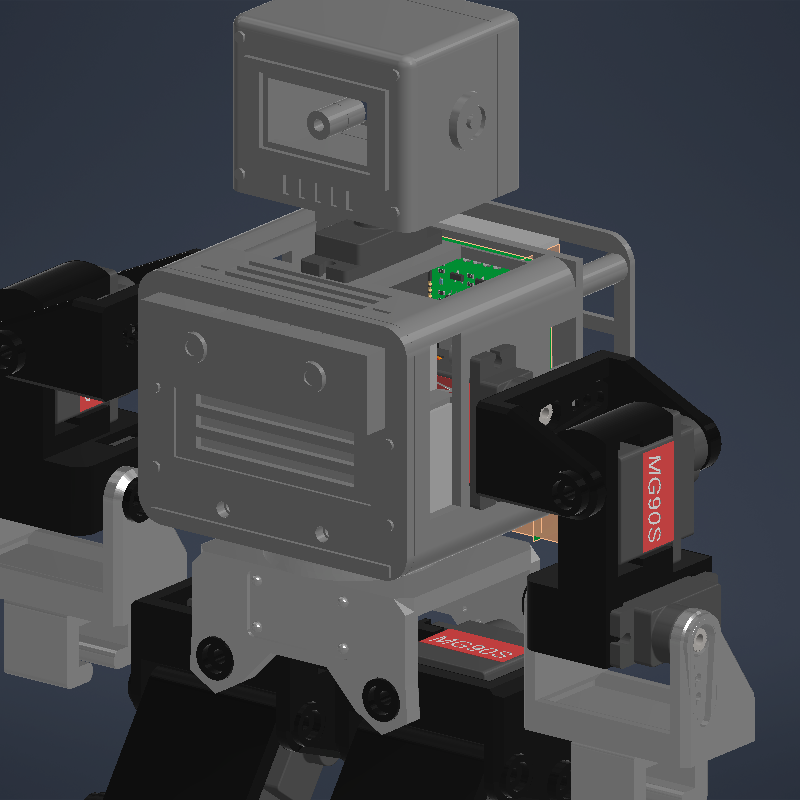
CAD/Nuevo/vistas_torso/clasico_piernas_torso.png
