rodrigoqweds90/Proyecto-Robot/CAD/Nuevo/vistas_torso/collar_opciones.png

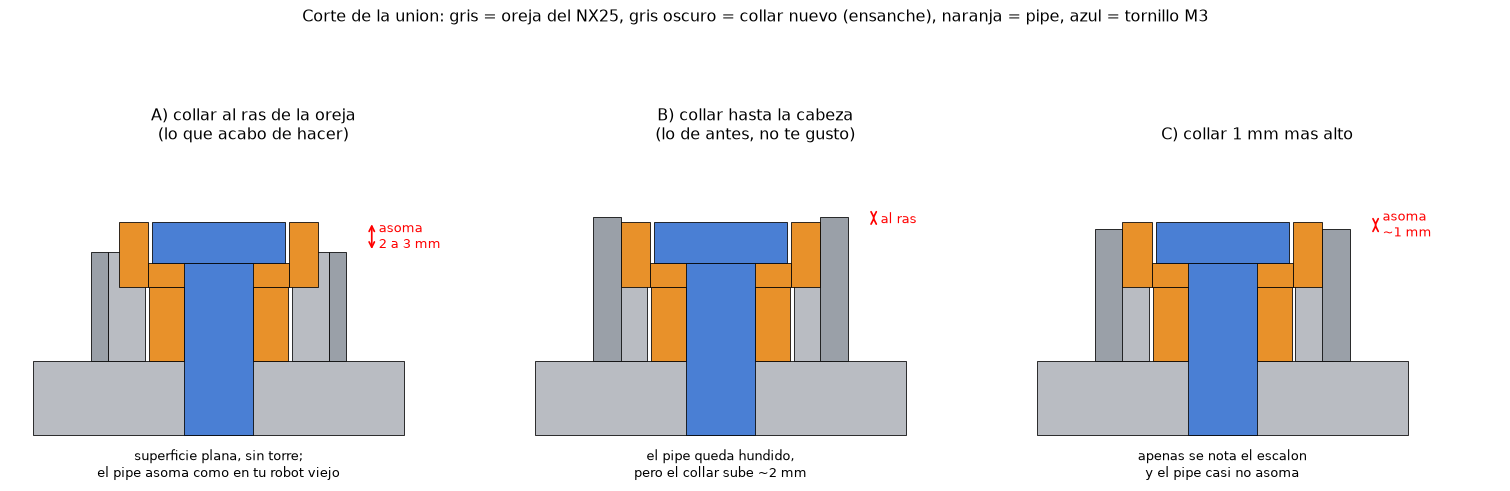
CAD/Nuevo/vistas_torso/collar_opciones.png
