rodrigoqweds90/Proyecto-Robot/CAD/Nuevo/vistas_torso/comparacion_mio_vs_suyo.png

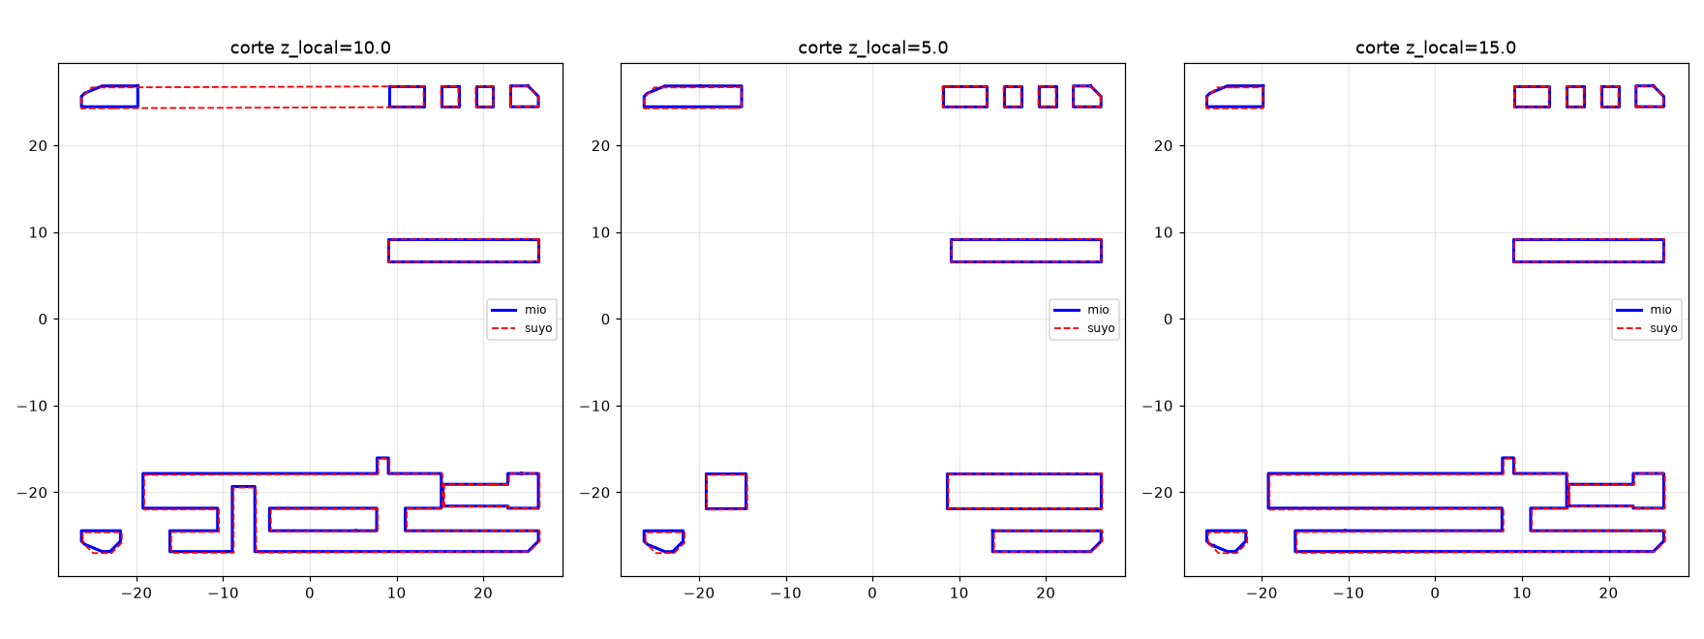
CAD/Nuevo/vistas_torso/comparacion_mio_vs_suyo.png
