rodrigoqweds90/Proyecto-Robot/CAD/Nuevo/vistas_torso/completo_0.png

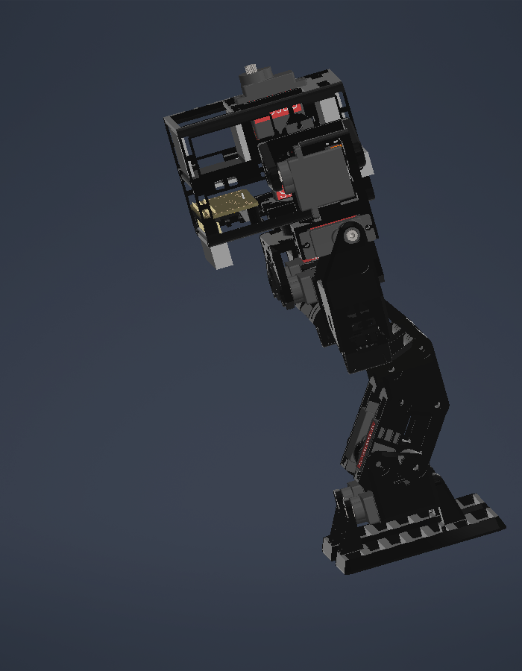
CAD/Nuevo/vistas_torso/completo_0.png
