rodrigoqweds90/Proyecto-Robot/CAD/Nuevo/vistas_torso/completo_1.png

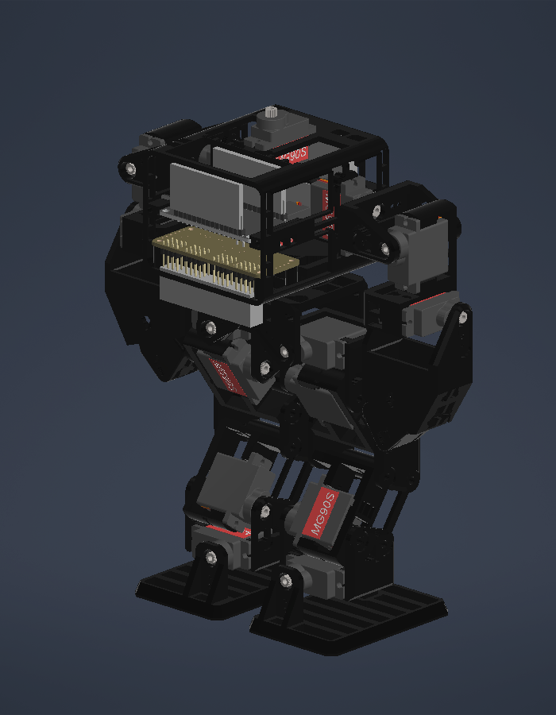
CAD/Nuevo/vistas_torso/completo_1.png
