rodrigoqweds90/Proyecto-Robot/CAD/Nuevo/vistas_torso/completo_2.png

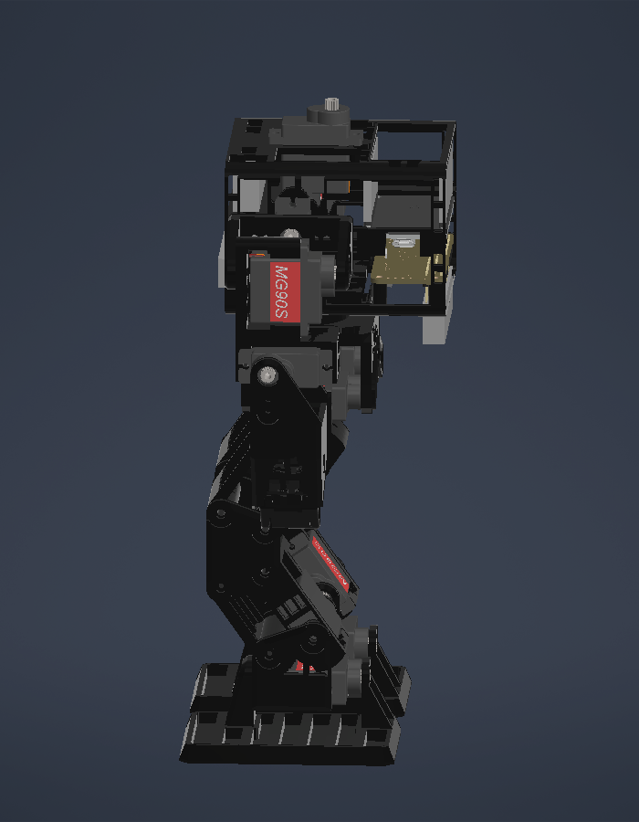
CAD/Nuevo/vistas_torso/completo_2.png
