rodrigoqweds90/Proyecto-Robot/CAD/Nuevo/vistas_torso/completo_3.png

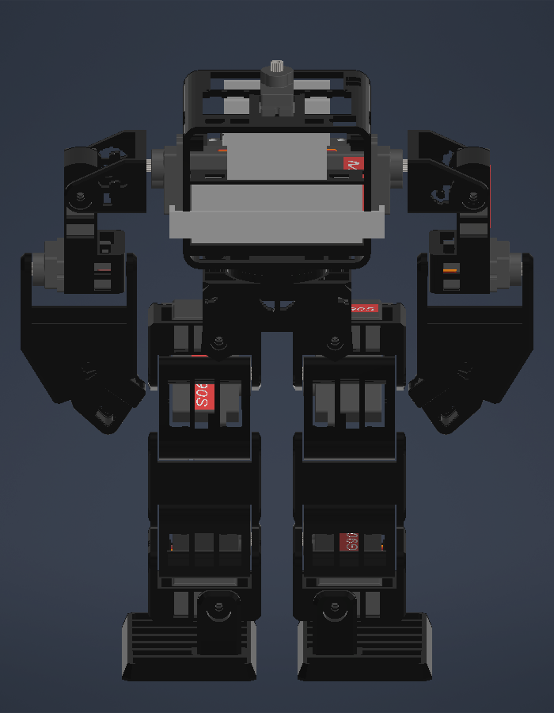
CAD/Nuevo/vistas_torso/completo_3.png
