rodrigoqweds90/Proyecto-Robot/CAD/Nuevo/vistas_torso/conceptos/concepto_1_mecha.jpg

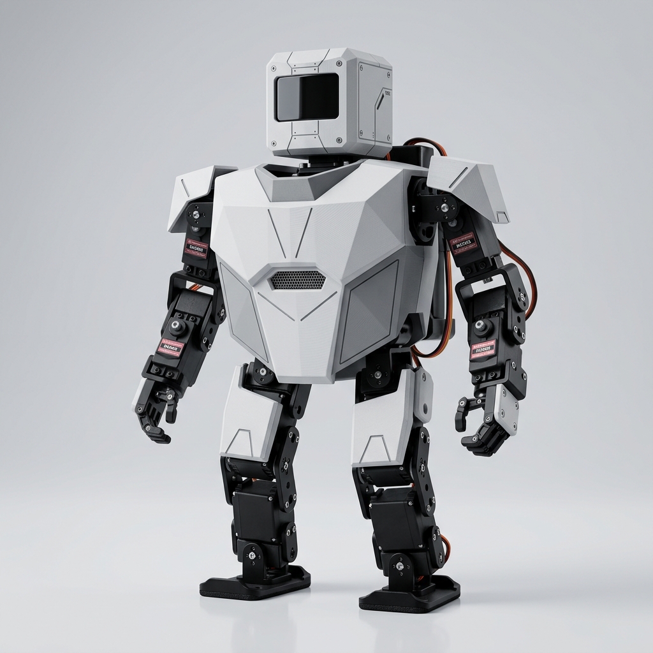
CAD/Nuevo/vistas_torso/conceptos/concepto_1_mecha.jpg
