rodrigoqweds90/Proyecto-Robot/CAD/Nuevo/vistas_torso/conceptos/concepto_2_retro.jpg

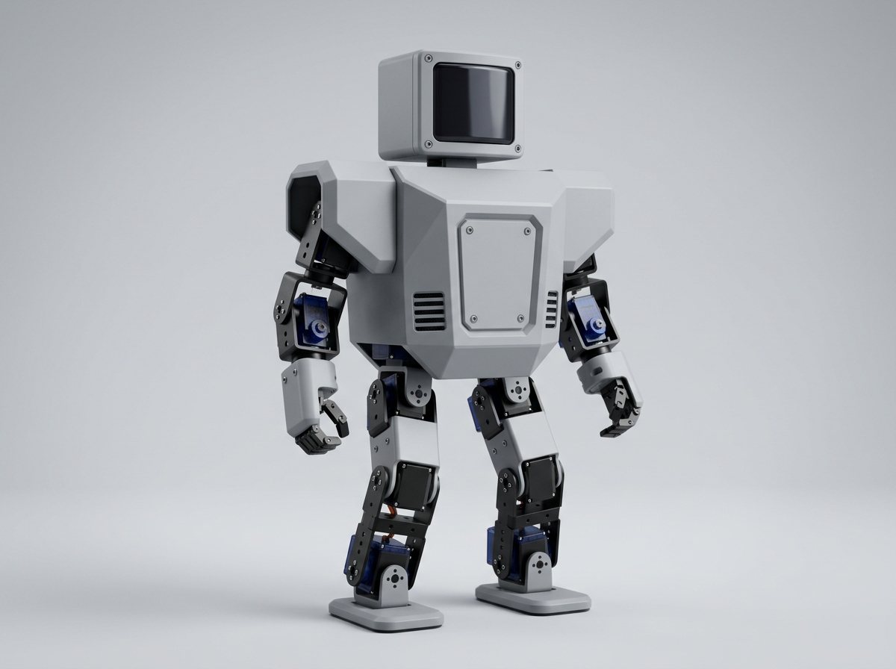
CAD/Nuevo/vistas_torso/conceptos/concepto_2_retro.jpg
