rodrigoqweds90/Proyecto-Robot/CAD/Nuevo/vistas_torso/conceptos/concepto_3_deportivo.jpg

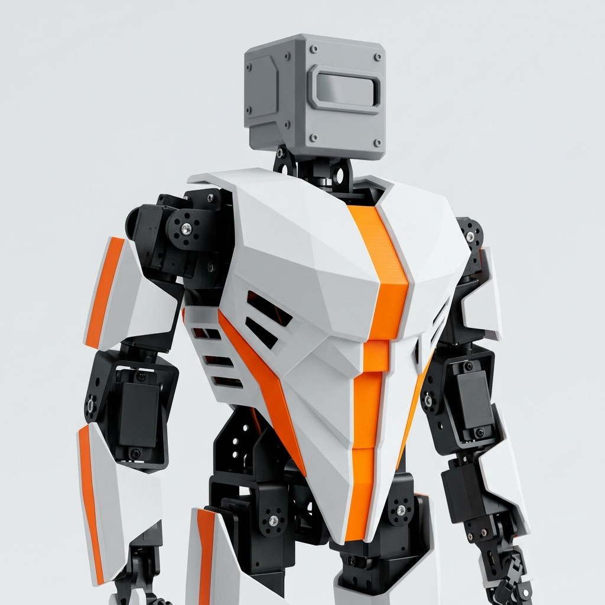
CAD/Nuevo/vistas_torso/conceptos/concepto_3_deportivo.jpg
