rodrigoqweds90/Proyecto-Robot/CAD/Nuevo/vistas_torso/conceptos/concepto_5_hojalata.jpg

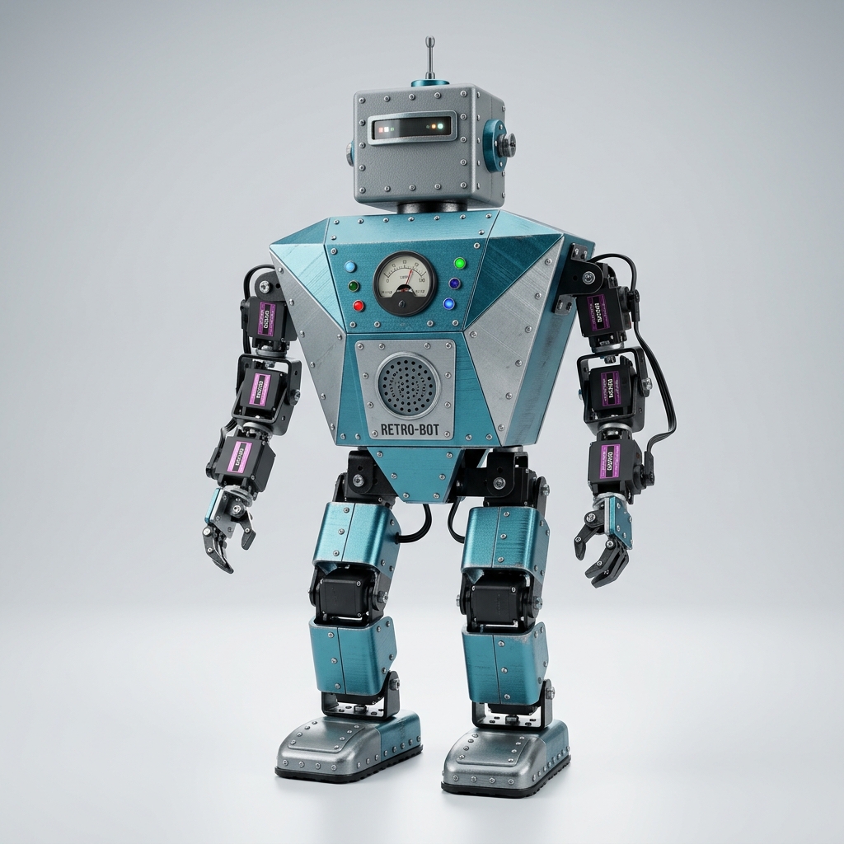
CAD/Nuevo/vistas_torso/conceptos/concepto_5_hojalata.jpg
