rodrigoqweds90/Proyecto-Robot/CAD/Nuevo/vistas_torso/conceptos/concepto_6_blindado.jpg

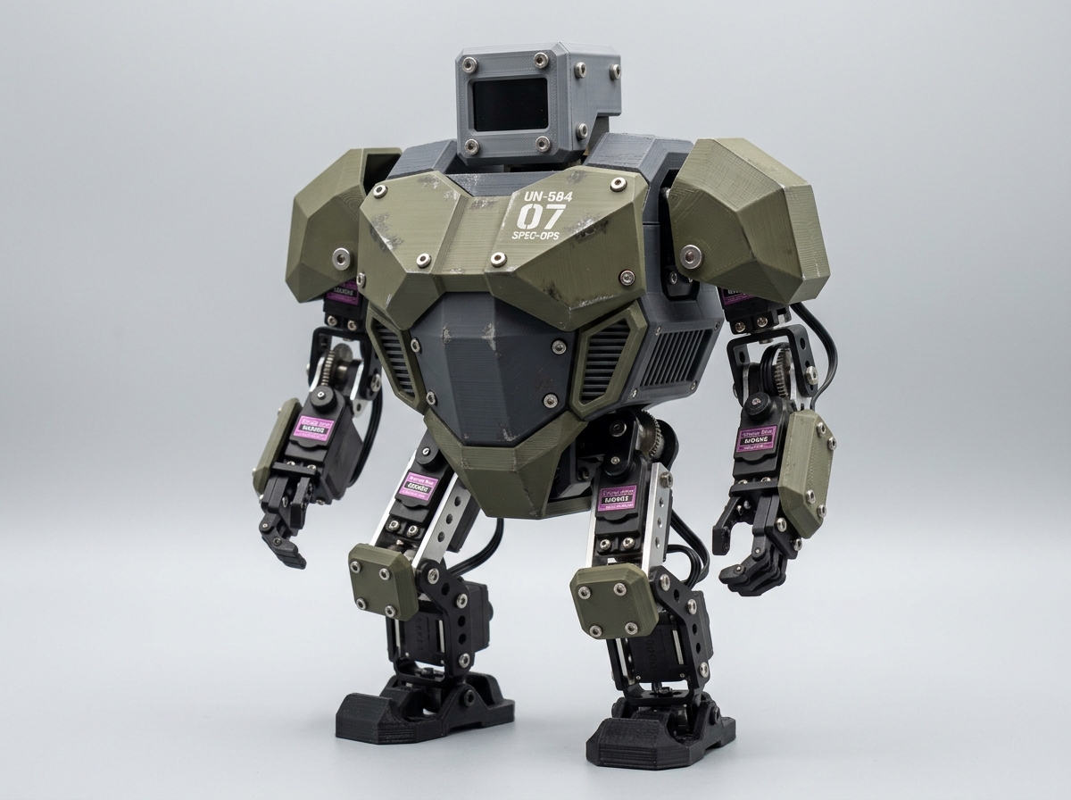
CAD/Nuevo/vistas_torso/conceptos/concepto_6_blindado.jpg
