rodrigoqweds90/Proyecto-Robot/CAD/Nuevo/vistas_torso/conceptos/concepto_7_nucleo.jpg

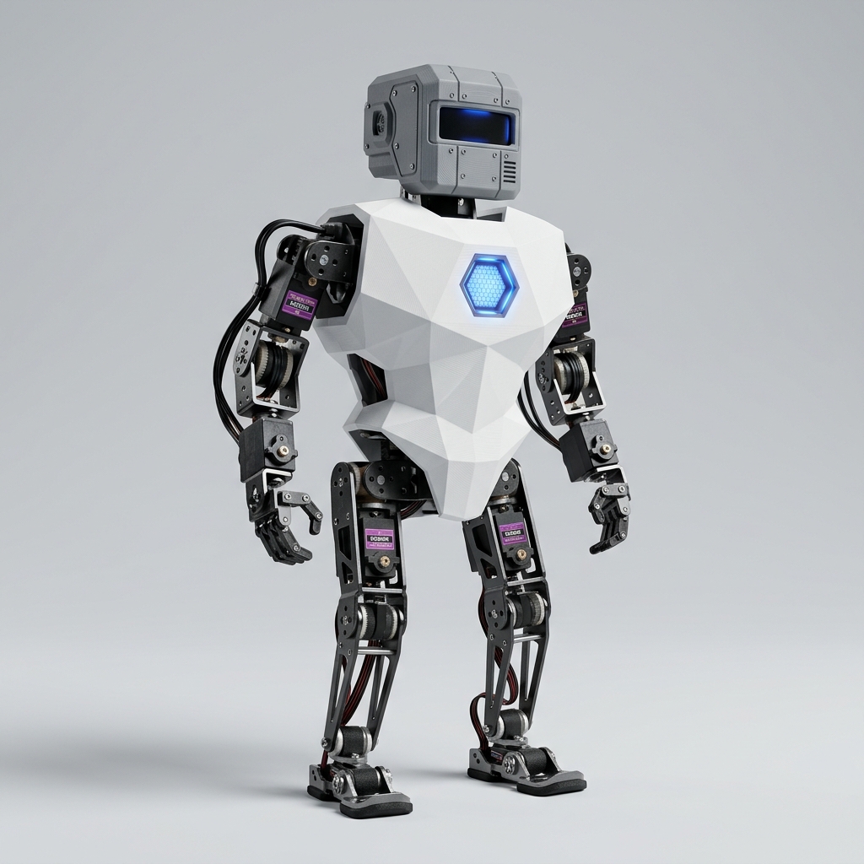
CAD/Nuevo/vistas_torso/conceptos/concepto_7_nucleo.jpg
