rodrigoqweds90/Proyecto-Robot/CAD/Nuevo/vistas_torso/conceptos/estilo_1.jpg

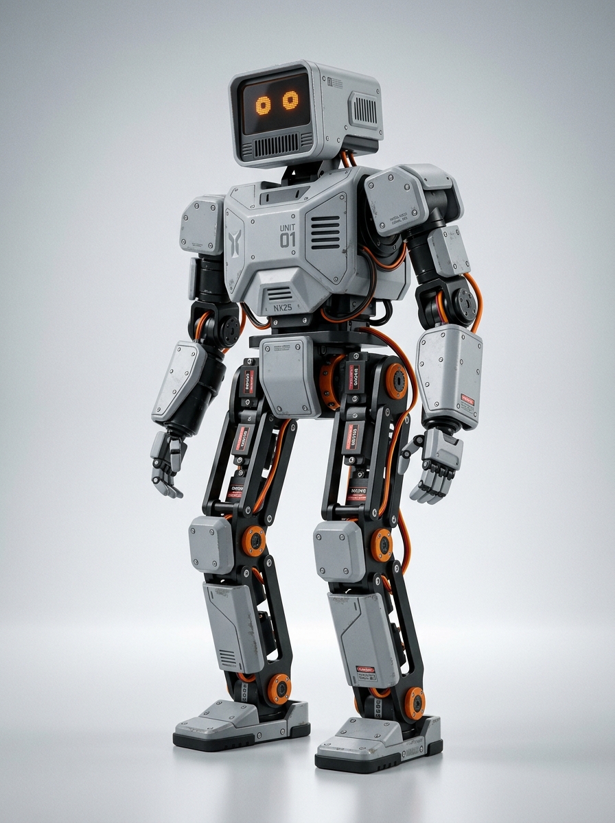
CAD/Nuevo/vistas_torso/conceptos/estilo_1.jpg
