rodrigoqweds90/Proyecto-Robot/CAD/Nuevo/vistas_torso/conceptos/estilo_3.jpg

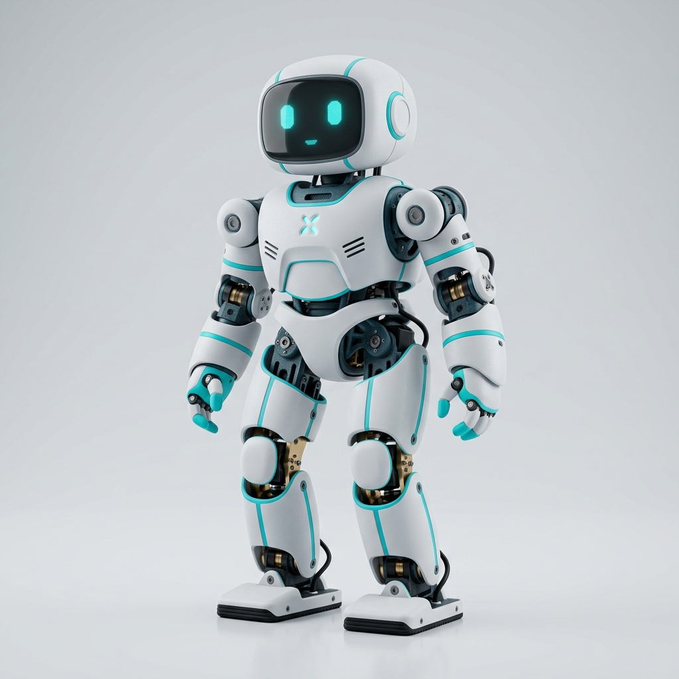
CAD/Nuevo/vistas_torso/conceptos/estilo_3.jpg
