rodrigoqweds90/Proyecto-Robot/CAD/Nuevo/vistas_torso/conceptos/hoja_1_oliva.jpg

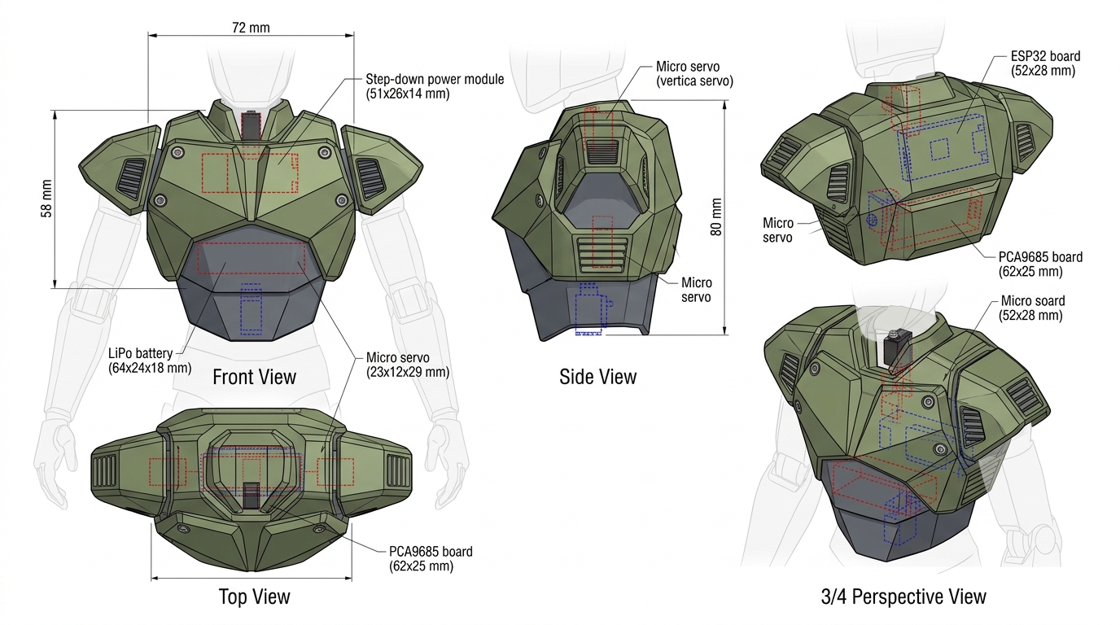
CAD/Nuevo/vistas_torso/conceptos/hoja_1_oliva.jpg
