rodrigoqweds90/Proyecto-Robot/CAD/Nuevo/vistas_torso/conceptos/hoja_2_quilla.jpg

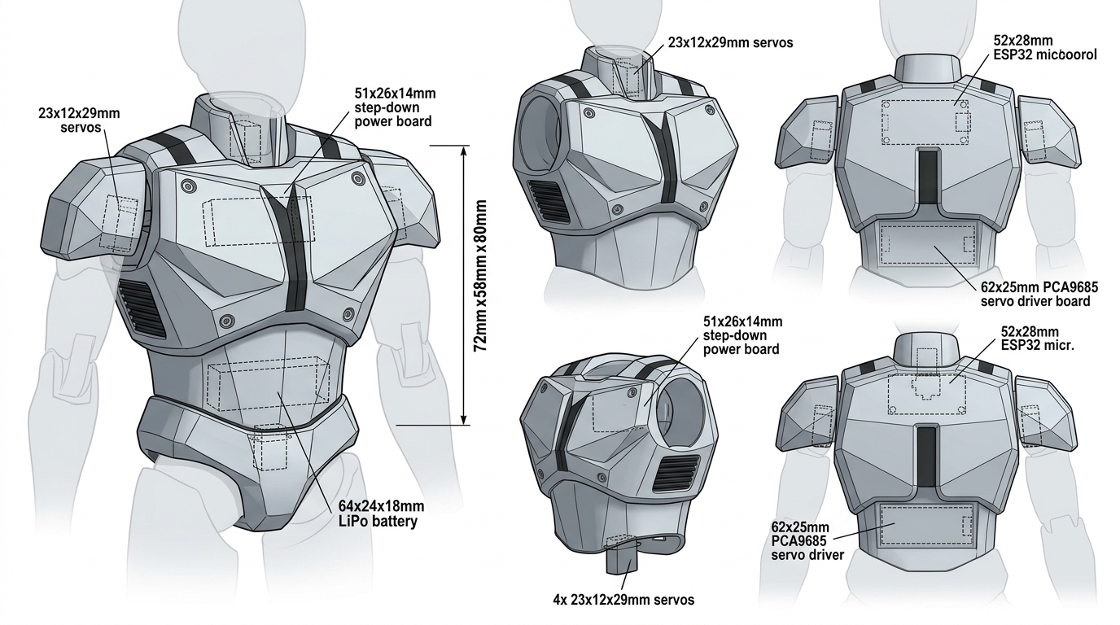
CAD/Nuevo/vistas_torso/conceptos/hoja_2_quilla.jpg
