rodrigoqweds90/Proyecto-Robot/CAD/Nuevo/vistas_torso/corte_collar.png

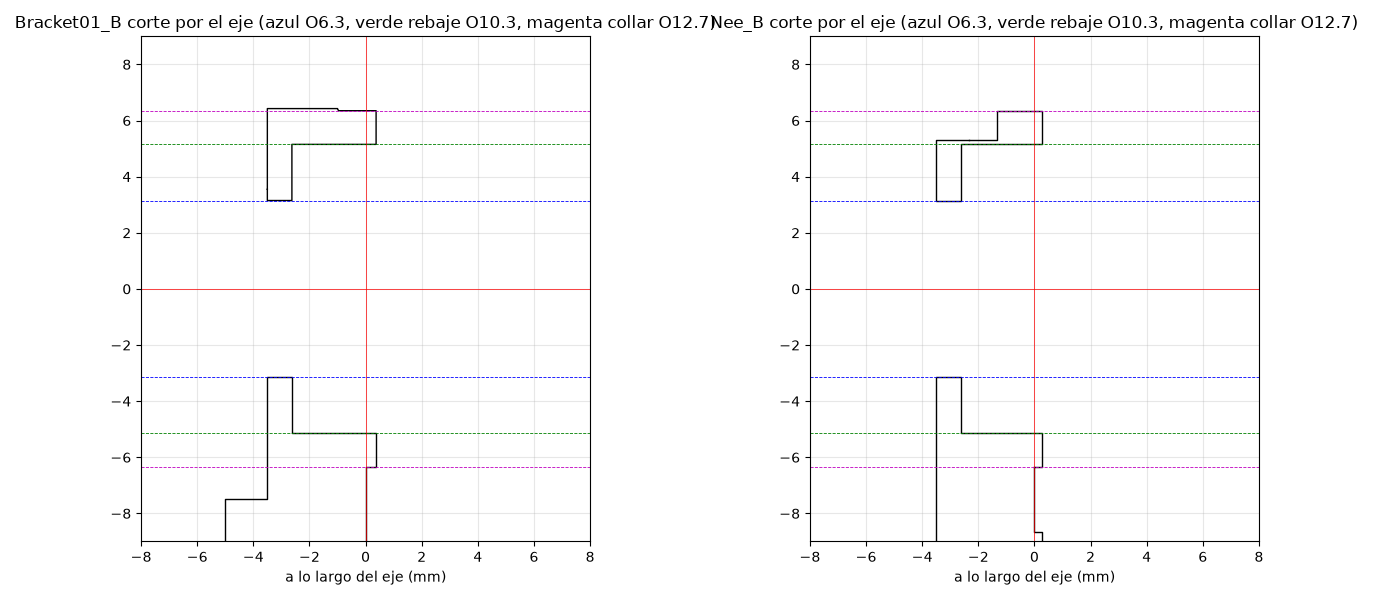
CAD/Nuevo/vistas_torso/corte_collar.png
