rodrigoqweds90/Proyecto-Robot/CAD/Nuevo/vistas_torso/corte_pipe_v7.png

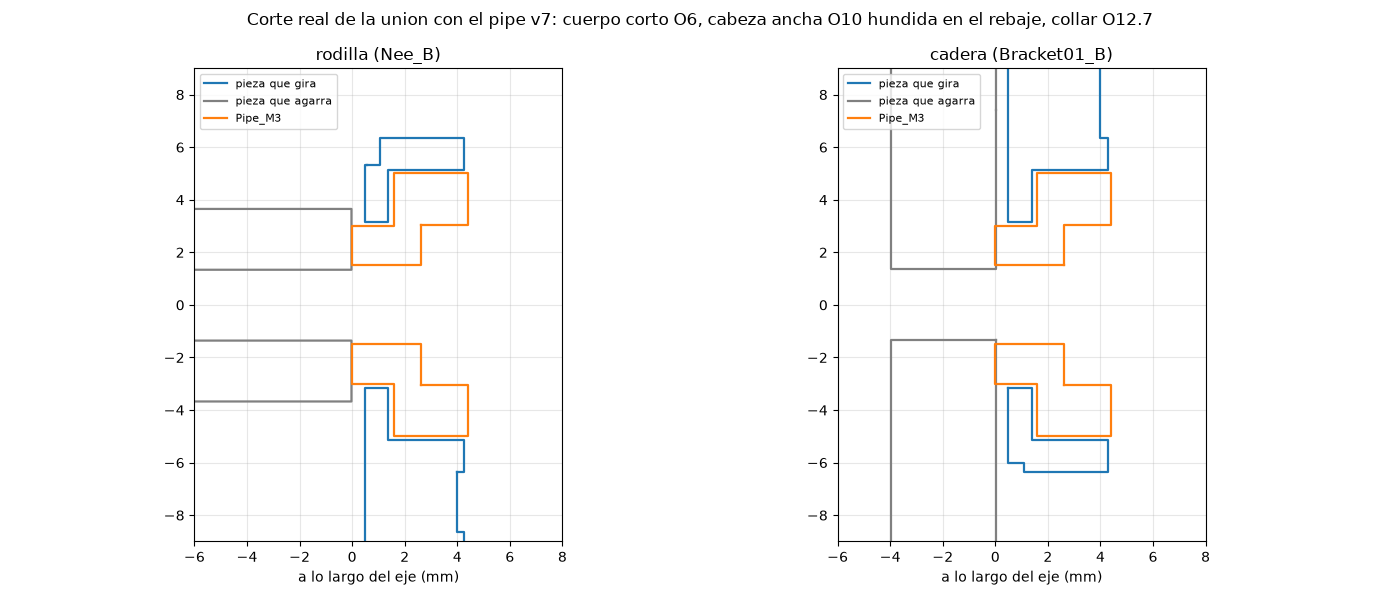
CAD/Nuevo/vistas_torso/corte_pipe_v7.png
