rodrigoqweds90/Proyecto-Robot/CAD/Nuevo/vistas_torso/corte_xl4015.png

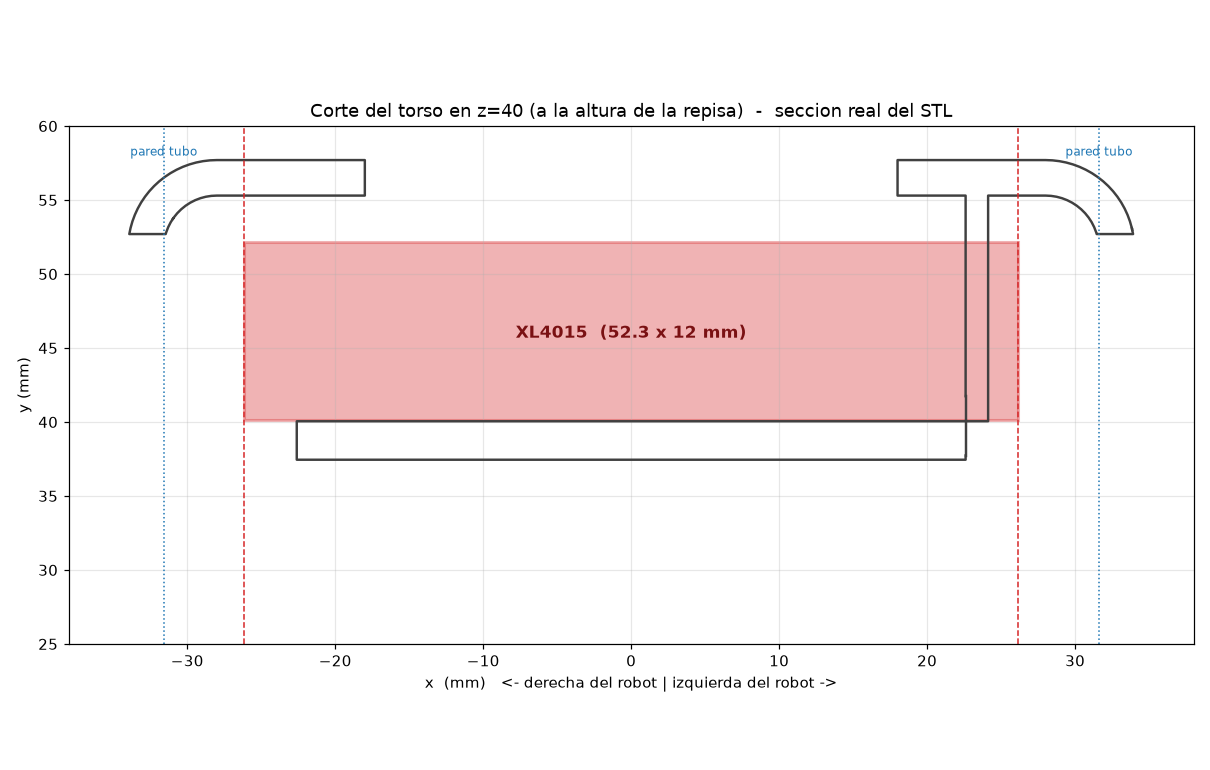
CAD/Nuevo/vistas_torso/corte_xl4015.png
