rodrigoqweds90/Proyecto-Robot/CAD/Nuevo/vistas_torso/costado.png

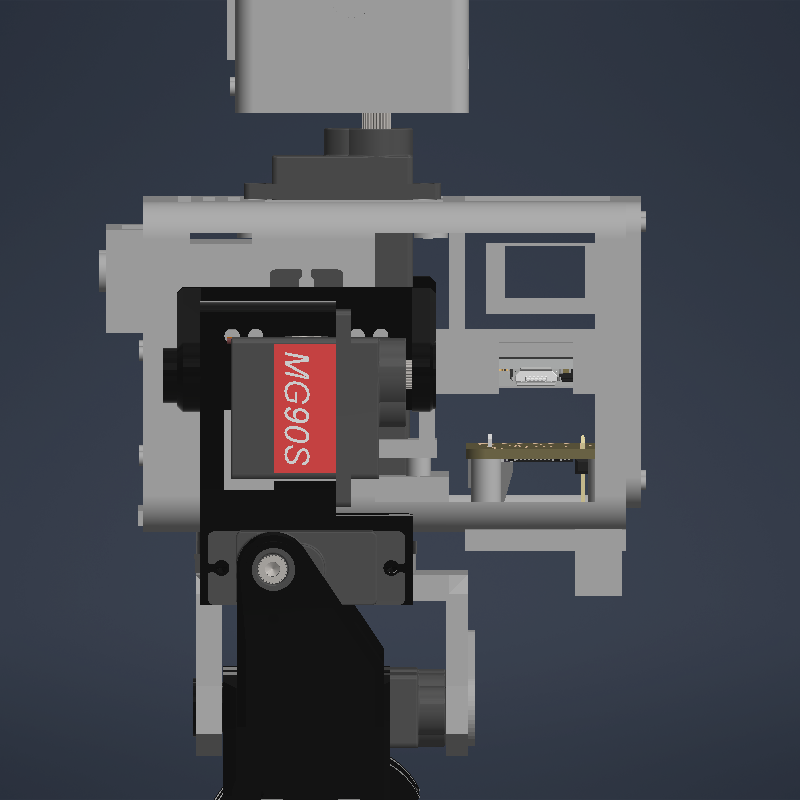
CAD/Nuevo/vistas_torso/costado.png
