rodrigoqweds90/Proyecto-Robot/CAD/Nuevo/vistas_torso/costado_aligerado.png

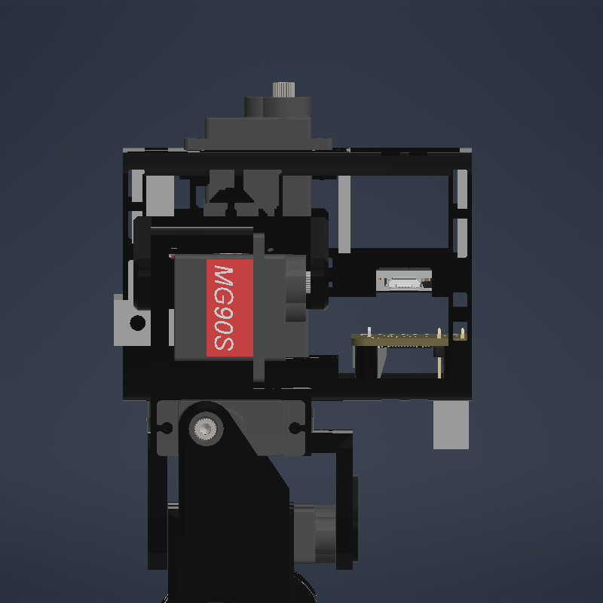
CAD/Nuevo/vistas_torso/costado_aligerado.png
