rodrigoqweds90/Proyecto-Robot/CAD/Nuevo/vistas_torso/costado_B.png

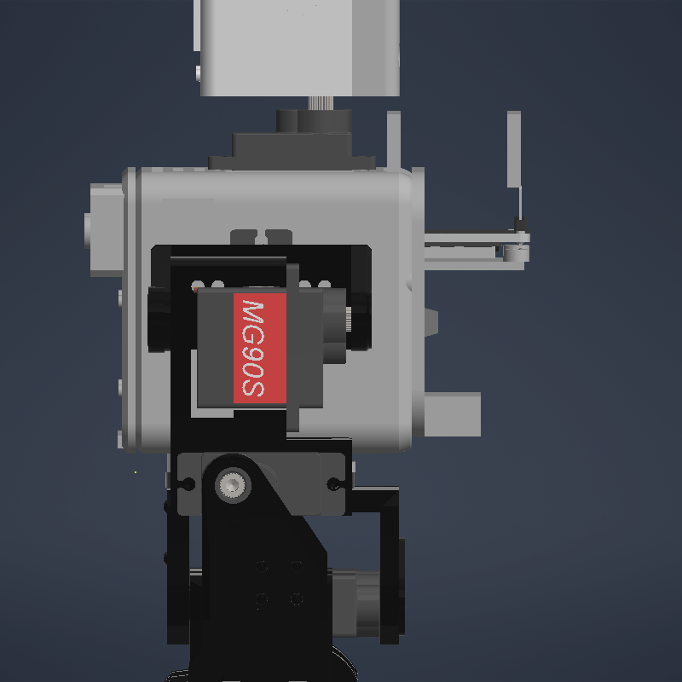
CAD/Nuevo/vistas_torso/costado_B.png
