rodrigoqweds90/Proyecto-Robot/CAD/Nuevo/vistas_torso/costado_B_fichas.png

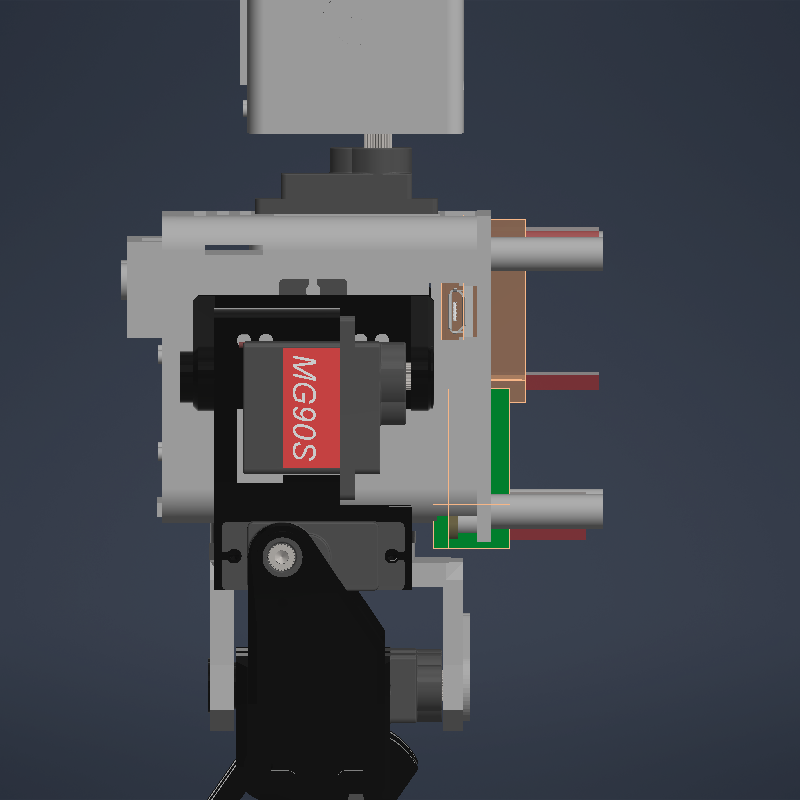
CAD/Nuevo/vistas_torso/costado_B_fichas.png
