rodrigoqweds90/Proyecto-Robot/CAD/Nuevo/vistas_torso/dentro_1.png

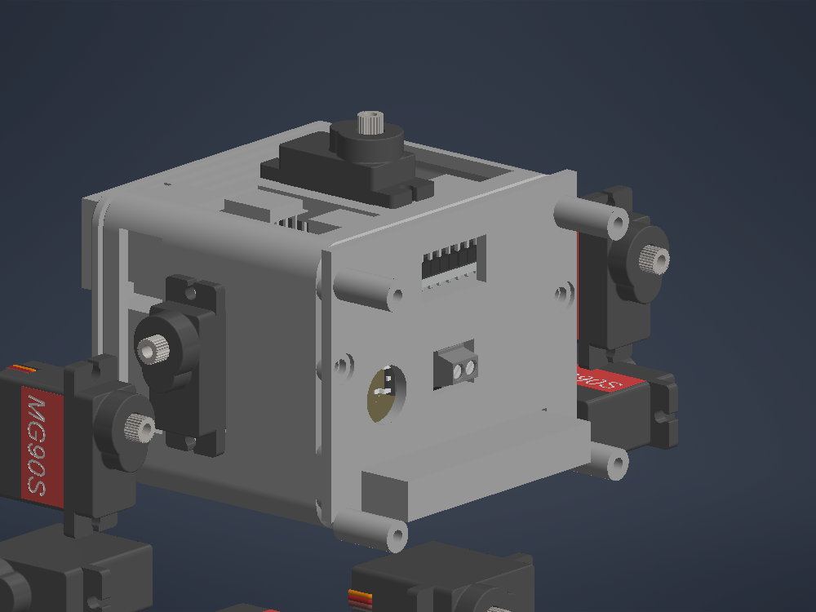
CAD/Nuevo/vistas_torso/dentro_1.png
