rodrigoqweds90/Proyecto-Robot/CAD/Nuevo/vistas_torso/dentro_2.png

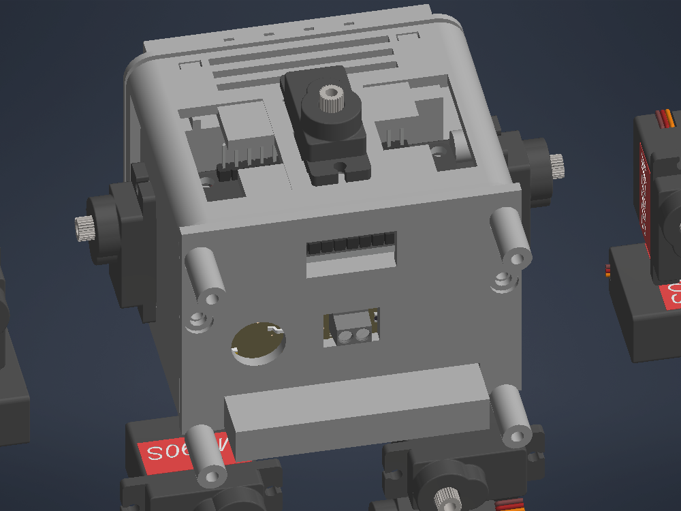
CAD/Nuevo/vistas_torso/dentro_2.png
