rodrigoqweds90/Proyecto-Robot/CAD/Nuevo/vistas_torso/despues_return.png

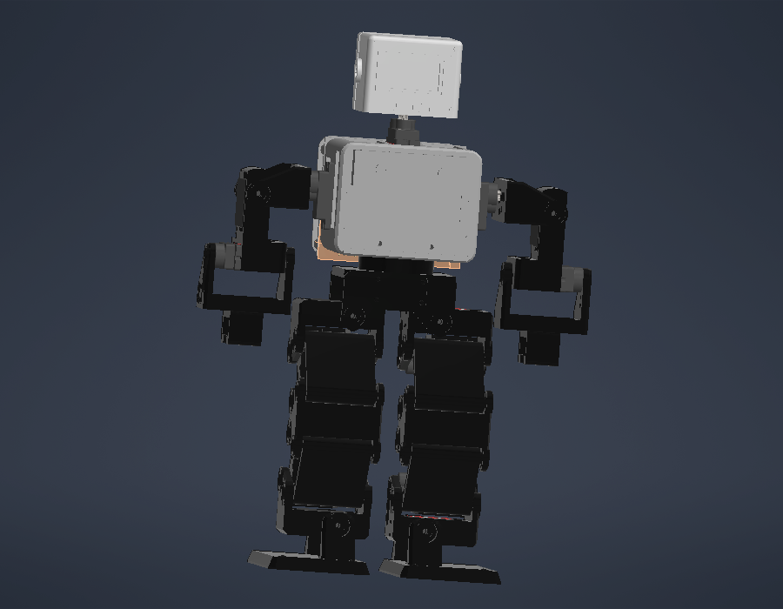
CAD/Nuevo/vistas_torso/despues_return.png
