rodrigoqweds90/Proyecto-Robot/CAD/Nuevo/vistas_torso/disposicion_final.png

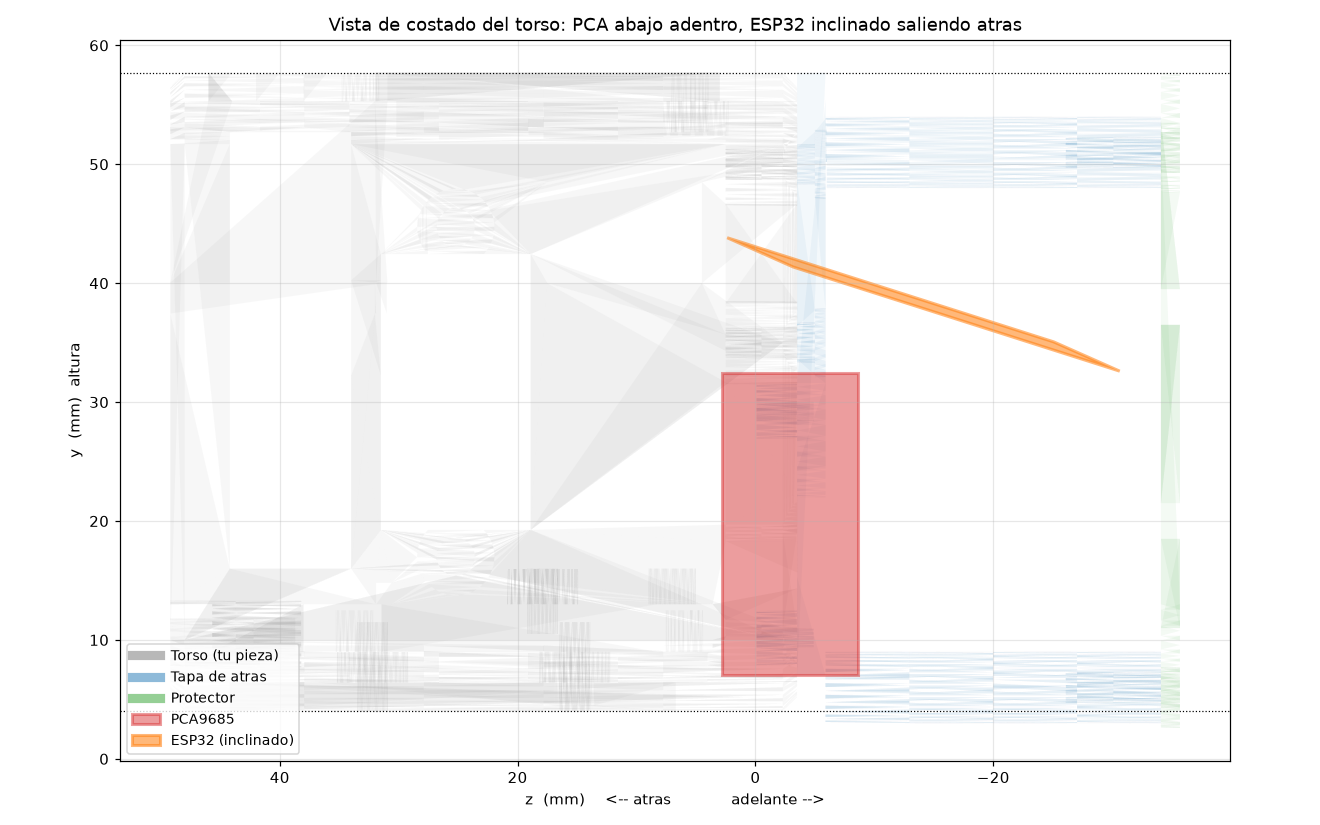
CAD/Nuevo/vistas_torso/disposicion_final.png
