rodrigoqweds90/Proyecto-Robot/CAD/Nuevo/vistas_torso/electronica_completa.png

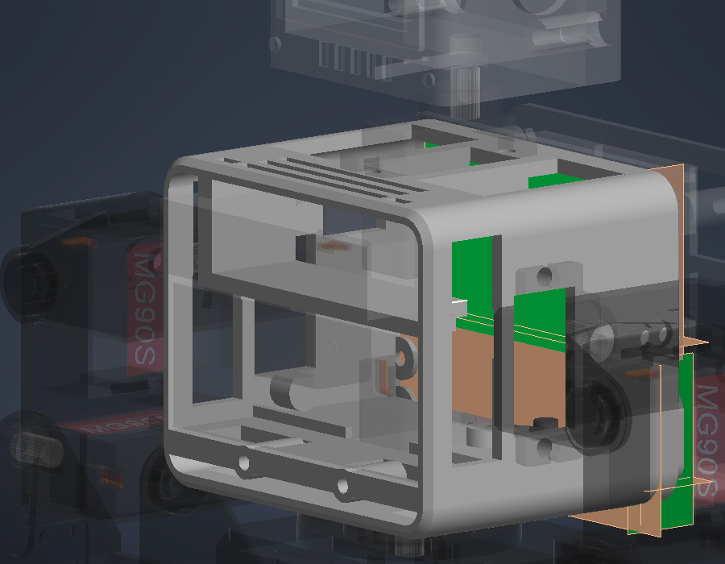
CAD/Nuevo/vistas_torso/electronica_completa.png
