rodrigoqweds90/Proyecto-Robot/CAD/Nuevo/vistas_torso/estilo1_piernas.png

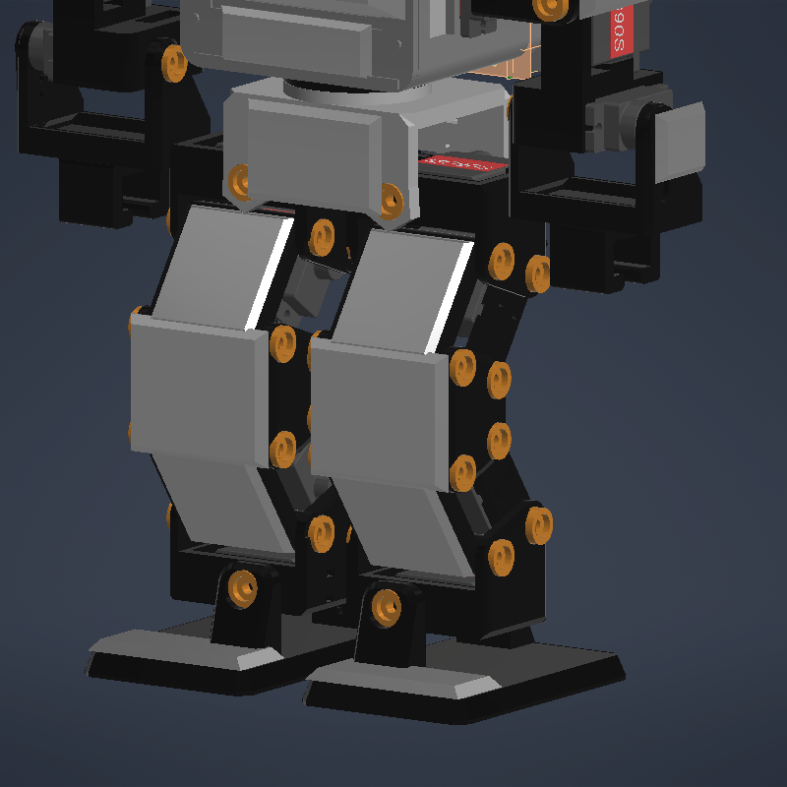
CAD/Nuevo/vistas_torso/estilo1_piernas.png
