rodrigoqweds90/Proyecto-Robot/CAD/Nuevo/vistas_torso/estilo1_robot.png

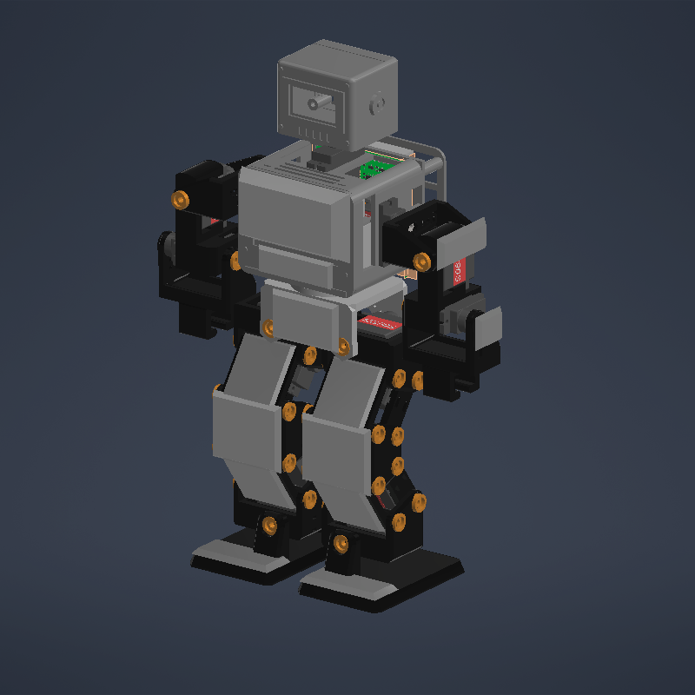
CAD/Nuevo/vistas_torso/estilo1_robot.png
