rodrigoqweds90/Proyecto-Robot/CAD/Nuevo/vistas_torso/estilo1_torso.png

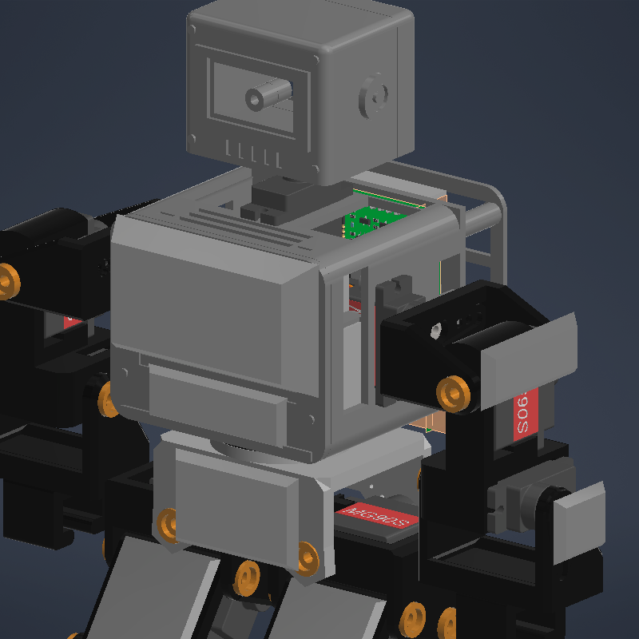
CAD/Nuevo/vistas_torso/estilo1_torso.png
