rodrigoqweds90/Proyecto-Robot/CAD/Nuevo/vistas_torso/estilo_piernas1_atras.png

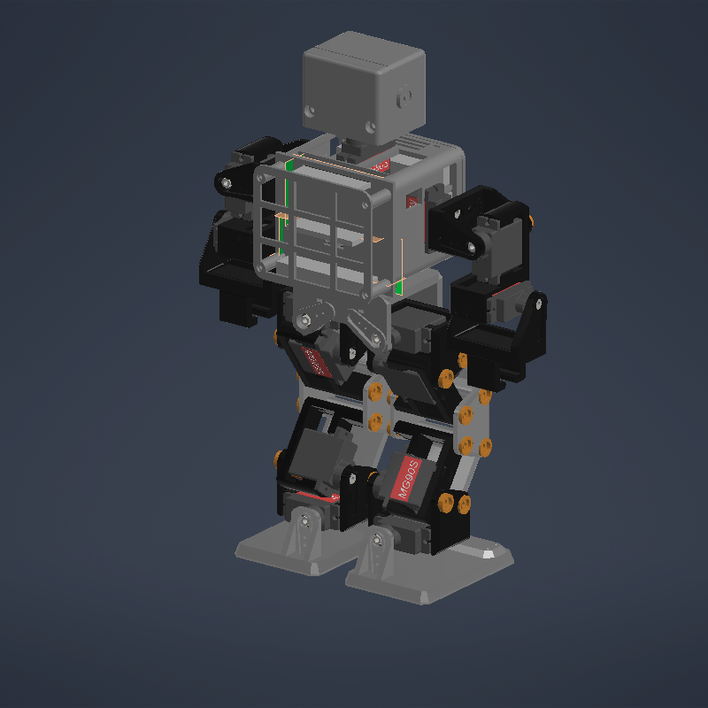
CAD/Nuevo/vistas_torso/estilo_piernas1_atras.png
