rodrigoqweds90/Proyecto-Robot/CAD/Nuevo/vistas_torso/estilo_piernas1_torso.png

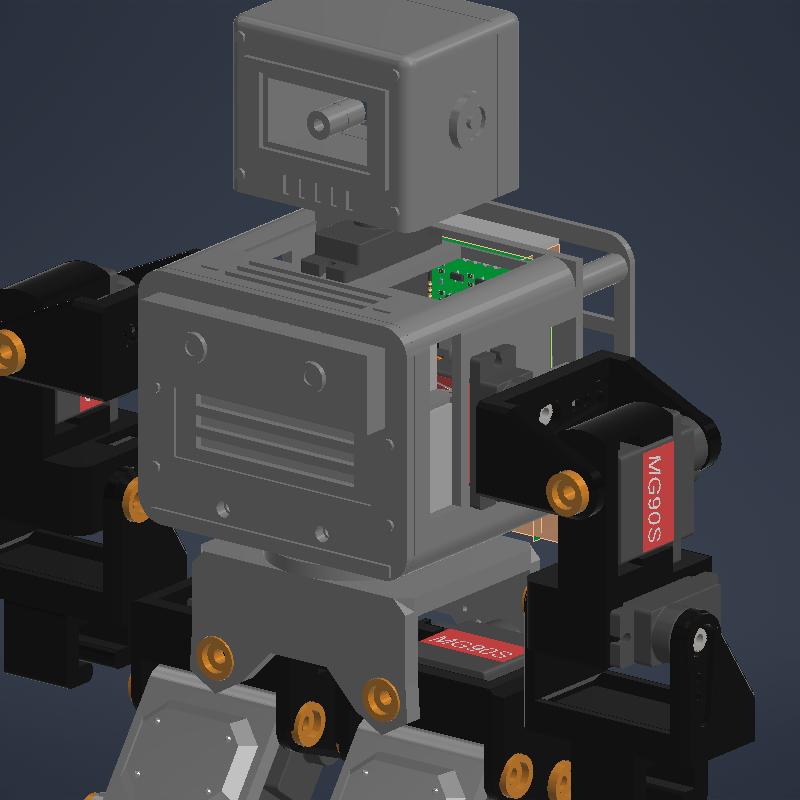
CAD/Nuevo/vistas_torso/estilo_piernas1_torso.png
