rodrigoqweds90/Proyecto-Robot/CAD/Nuevo/vistas_torso/final_atras.png

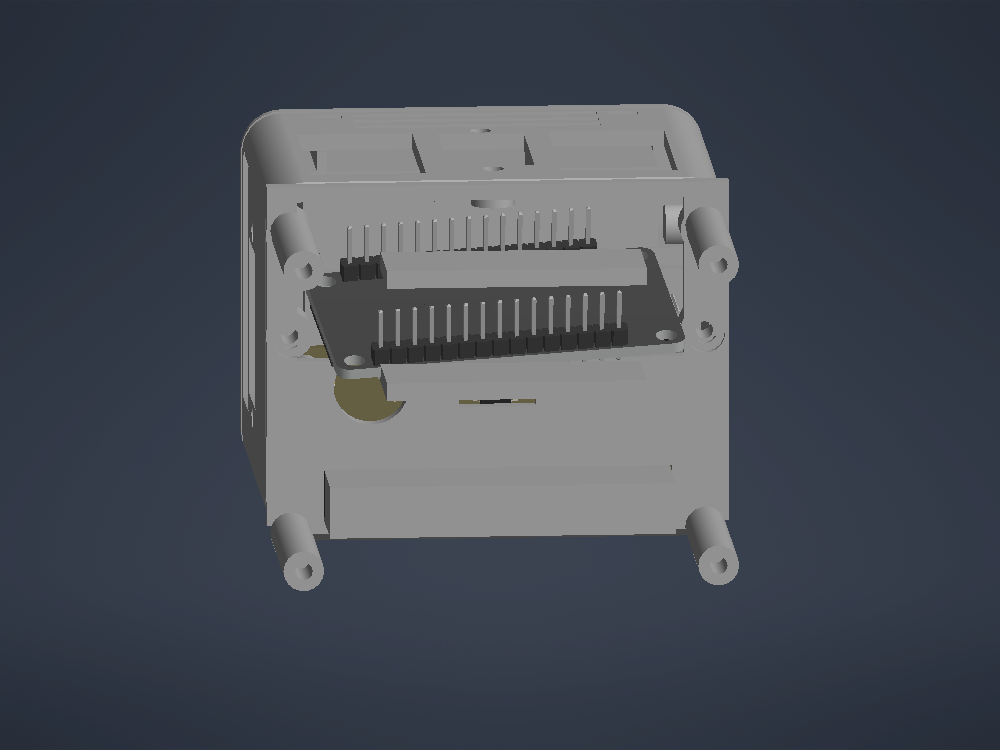
CAD/Nuevo/vistas_torso/final_atras.png
