rodrigoqweds90/Proyecto-Robot/CAD/Nuevo/vistas_torso/final_atras_izq.png

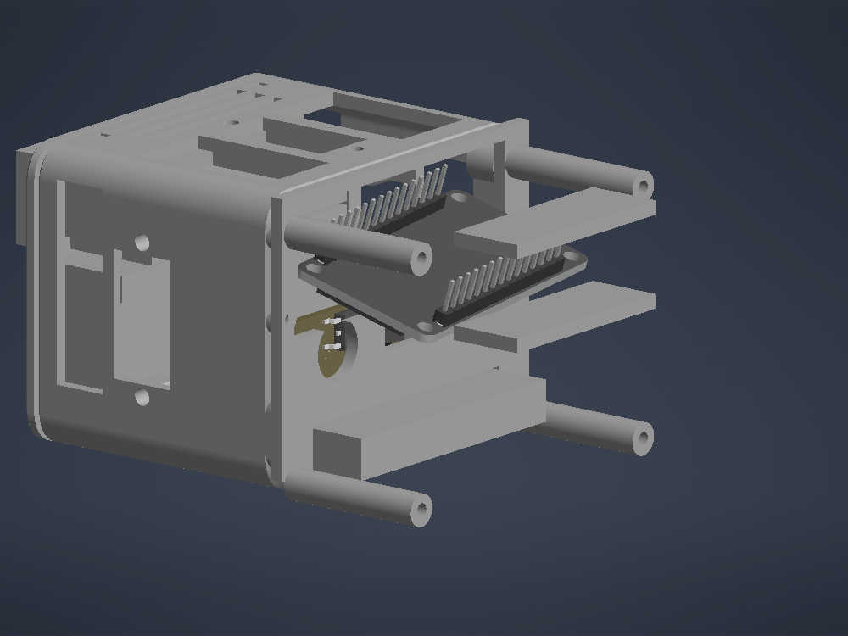
CAD/Nuevo/vistas_torso/final_atras_izq.png
