rodrigoqweds90/Proyecto-Robot/CAD/Nuevo/vistas_torso/final_costado.png

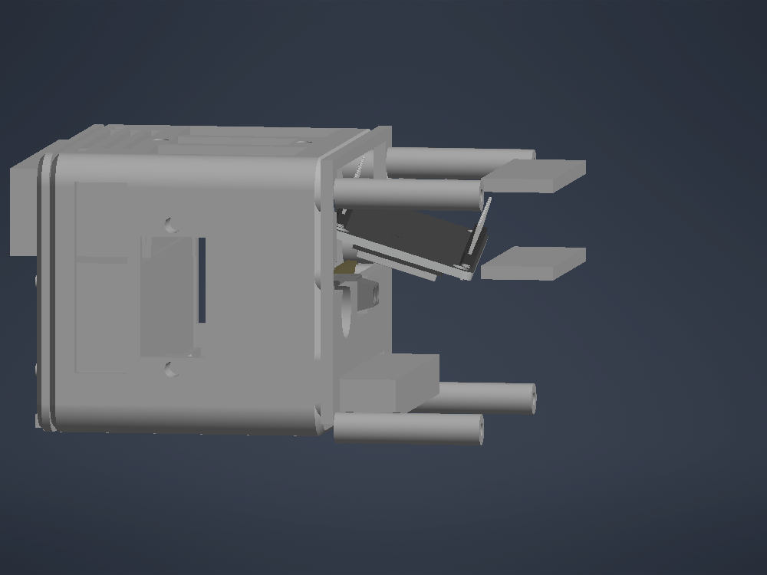
CAD/Nuevo/vistas_torso/final_costado.png
