rodrigoqweds90/Proyecto-Robot/CAD/Nuevo/vistas_torso/horn_Bracket01_B.png

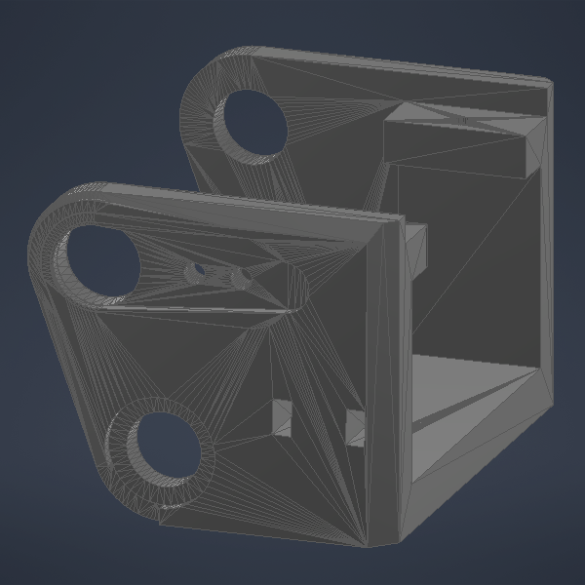
CAD/Nuevo/vistas_torso/horn_Bracket01_B.png
