rodrigoqweds90/Proyecto-Robot/CAD/Nuevo/vistas_torso/horn_Bracket07_B.png

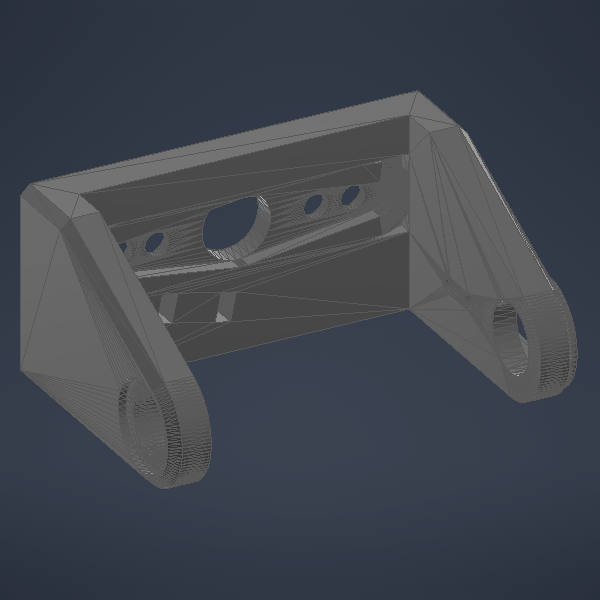
CAD/Nuevo/vistas_torso/horn_Bracket07_B.png
