rodrigoqweds90/Proyecto-Robot/CAD/Nuevo/vistas_torso/horn_cortes.png

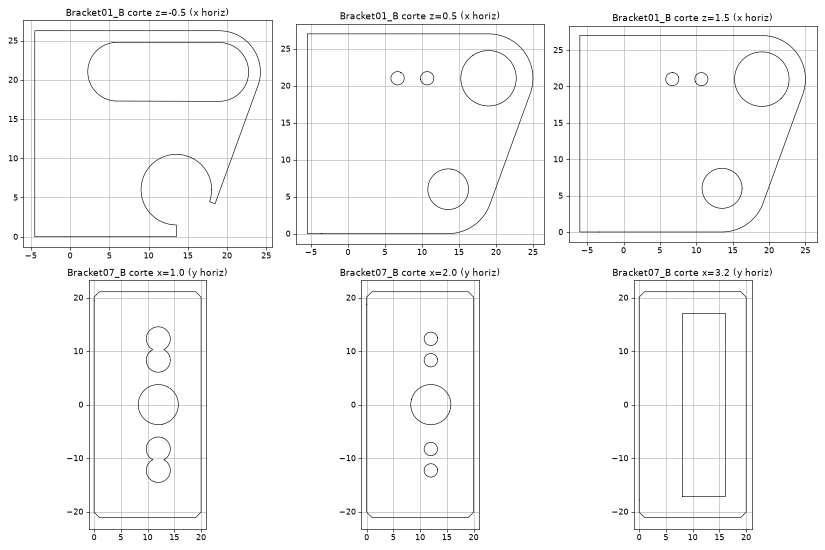
CAD/Nuevo/vistas_torso/horn_cortes.png
