rodrigoqweds90/Proyecto-Robot/CAD/Nuevo/vistas_torso/hueco_cable2.png

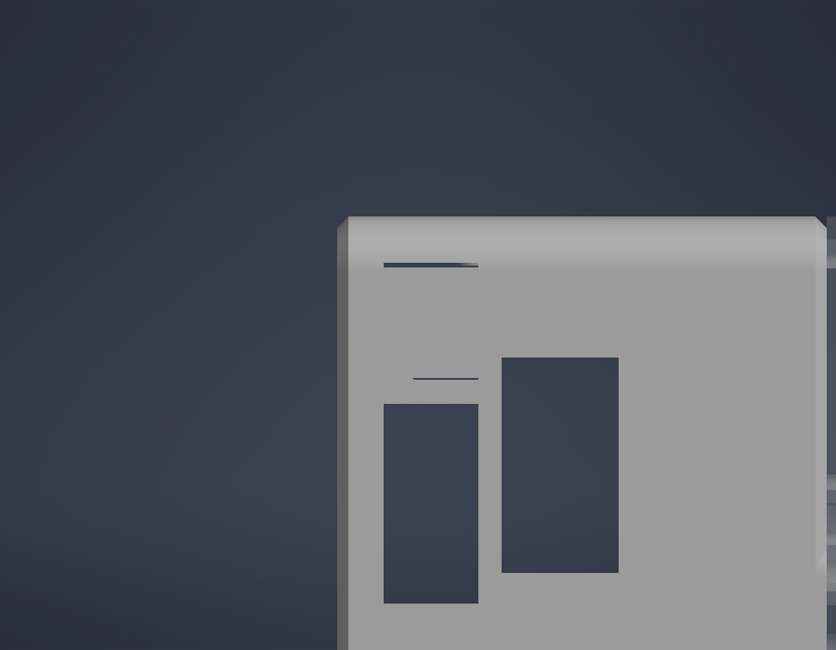
CAD/Nuevo/vistas_torso/hueco_cable2.png
