rodrigoqweds90/Proyecto-Robot/CAD/Nuevo/vistas_torso/hueco_cable.png

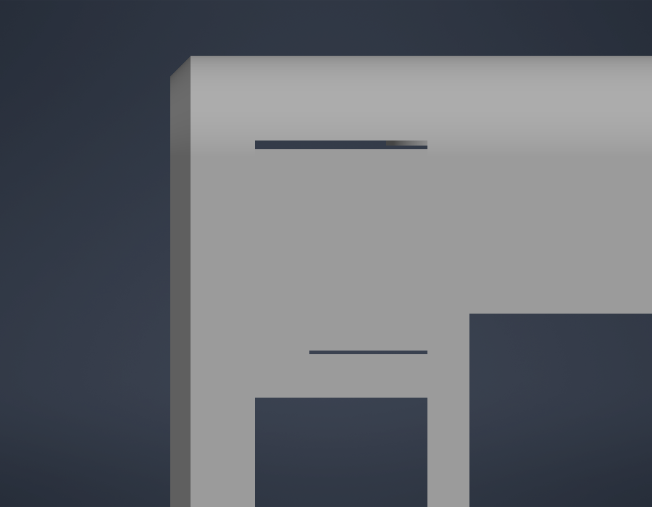
CAD/Nuevo/vistas_torso/hueco_cable.png
