rodrigoqweds90/Proyecto-Robot/CAD/Nuevo/vistas_torso/imu.png

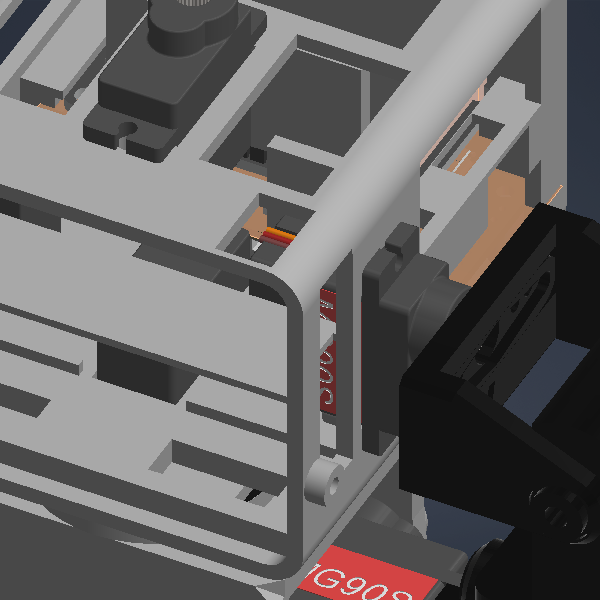
CAD/Nuevo/vistas_torso/imu.png
