rodrigoqweds90/Proyecto-Robot/CAD/Nuevo/vistas_torso/inventor_final.png

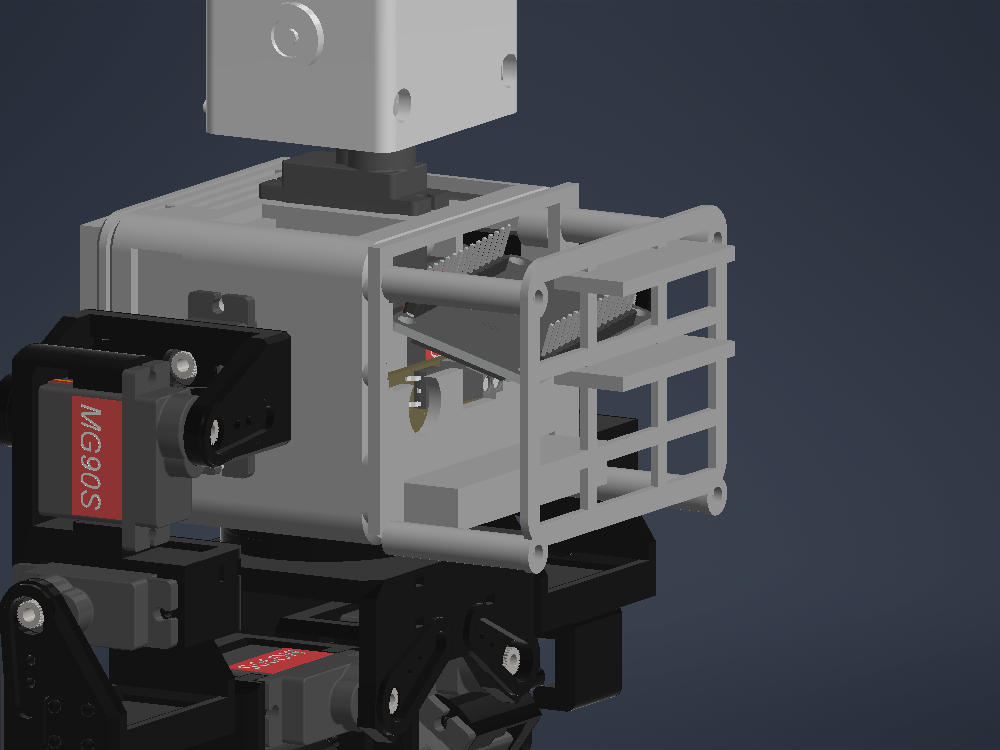
CAD/Nuevo/vistas_torso/inventor_final.png
