rodrigoqweds90/Proyecto-Robot/CAD/Nuevo/vistas_torso/mano_1.png

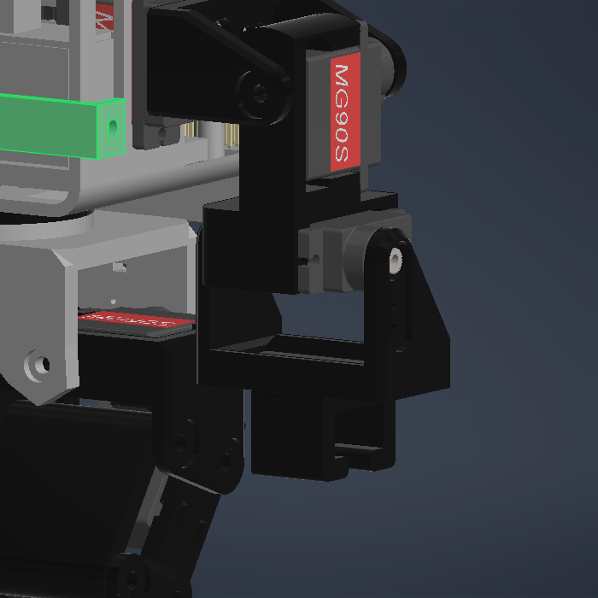
CAD/Nuevo/vistas_torso/mano_1.png
