rodrigoqweds90/Proyecto-Robot/CAD/Nuevo/vistas_torso/mano_2.png

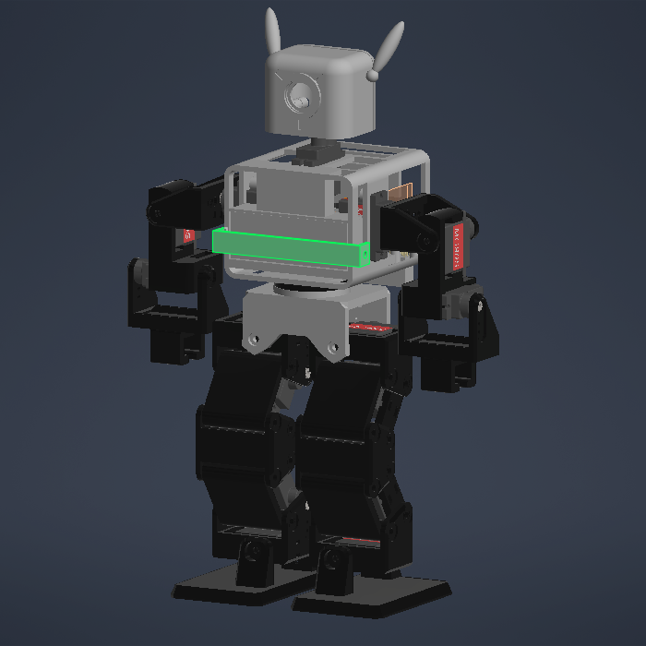
CAD/Nuevo/vistas_torso/mano_2.png
