rodrigoqweds90/Proyecto-Robot/CAD/Nuevo/vistas_torso/mano_ahora_0.png

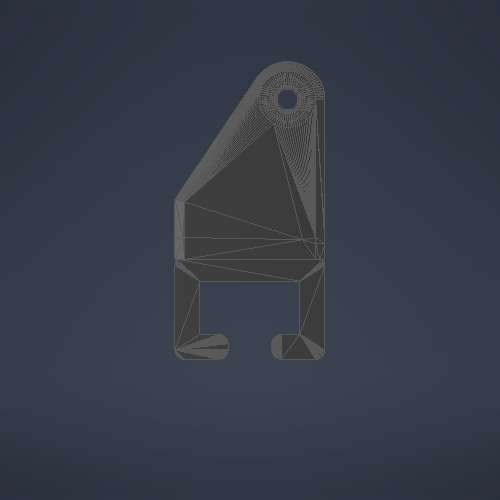
CAD/Nuevo/vistas_torso/mano_ahora_0.png
