rodrigoqweds90/Proyecto-Robot/CAD/Nuevo/vistas_torso/mano_antes_0.png

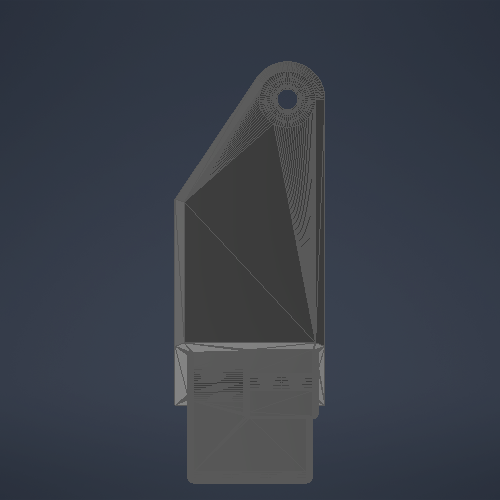
CAD/Nuevo/vistas_torso/mano_antes_0.png
