rodrigoqweds90/Proyecto-Robot/CAD/Nuevo/vistas_torso/mano_bocetos_afuera.png

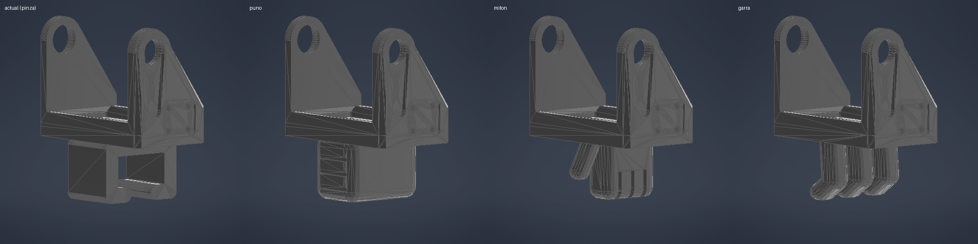
CAD/Nuevo/vistas_torso/mano_bocetos_afuera.png
