rodrigoqweds90/Proyecto-Robot/CAD/Nuevo/vistas_torso/mano_bocetos_robot.png

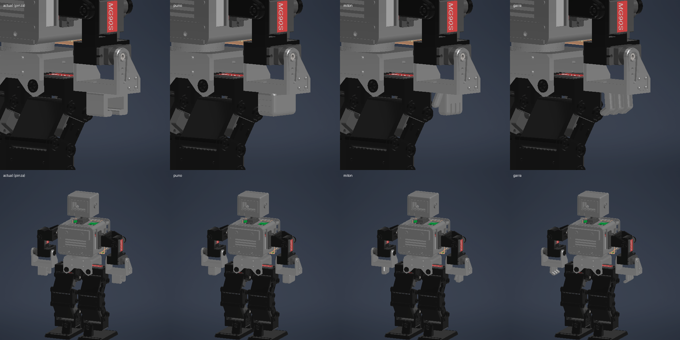
CAD/Nuevo/vistas_torso/mano_bocetos_robot.png
