rodrigoqweds90/Proyecto-Robot/CAD/Nuevo/vistas_torso/mano_comparacion.png

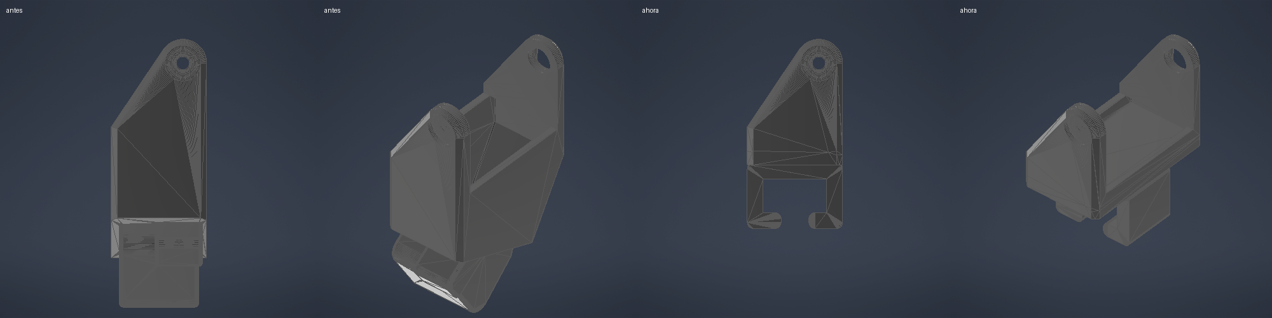
CAD/Nuevo/vistas_torso/mano_comparacion.png
