rodrigoqweds90/Proyecto-Robot/CAD/Nuevo/vistas_torso/mano_cortes.png

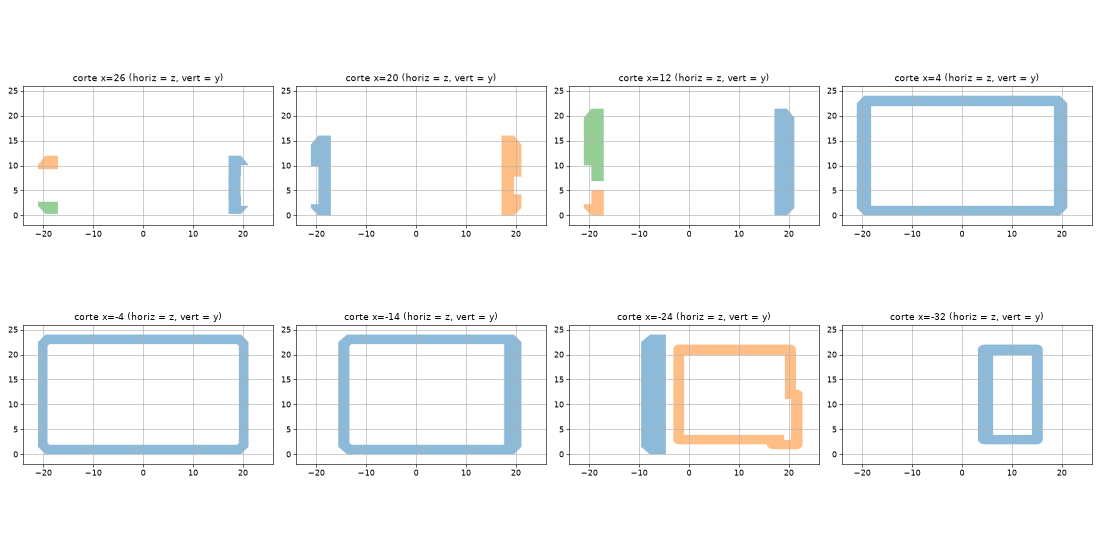
CAD/Nuevo/vistas_torso/mano_cortes.png
