rodrigoqweds90/Proyecto-Robot/CAD/Nuevo/vistas_torso/mano_espacio_cortes.png

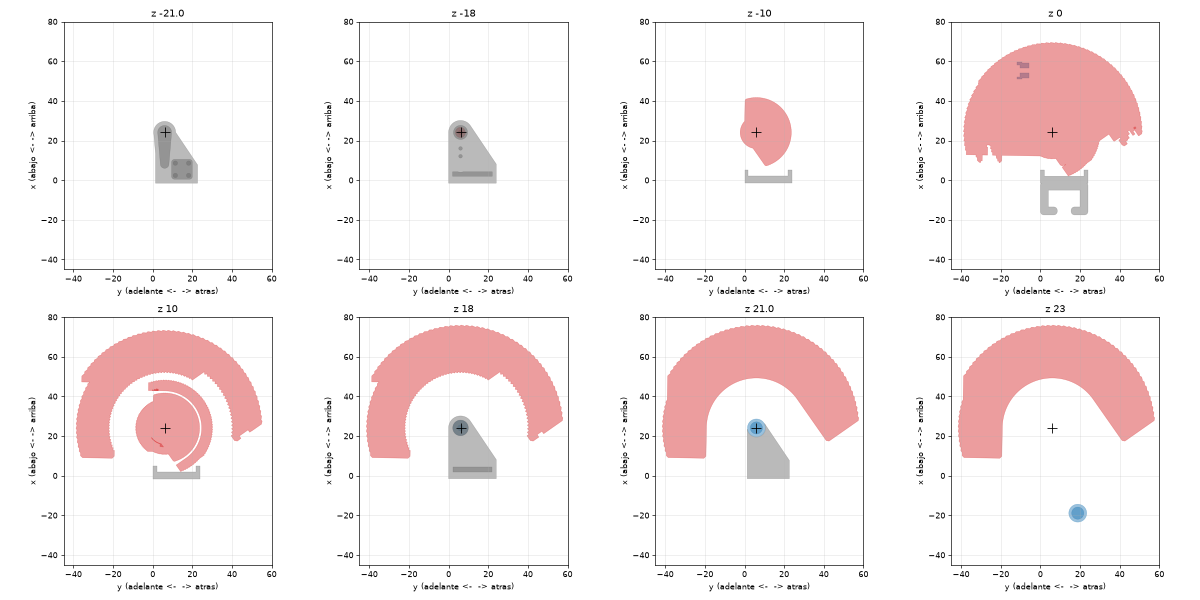
CAD/Nuevo/vistas_torso/mano_espacio_cortes.png
