rodrigoqweds90/Proyecto-Robot/CAD/Nuevo/vistas_torso/mano_nueva.png

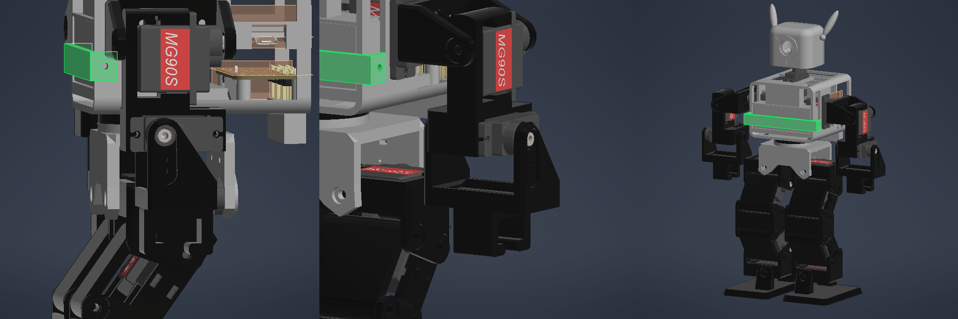
CAD/Nuevo/vistas_torso/mano_nueva.png
