rodrigoqweds90/Proyecto-Robot/CAD/Nuevo/vistas_torso/mejoras.png

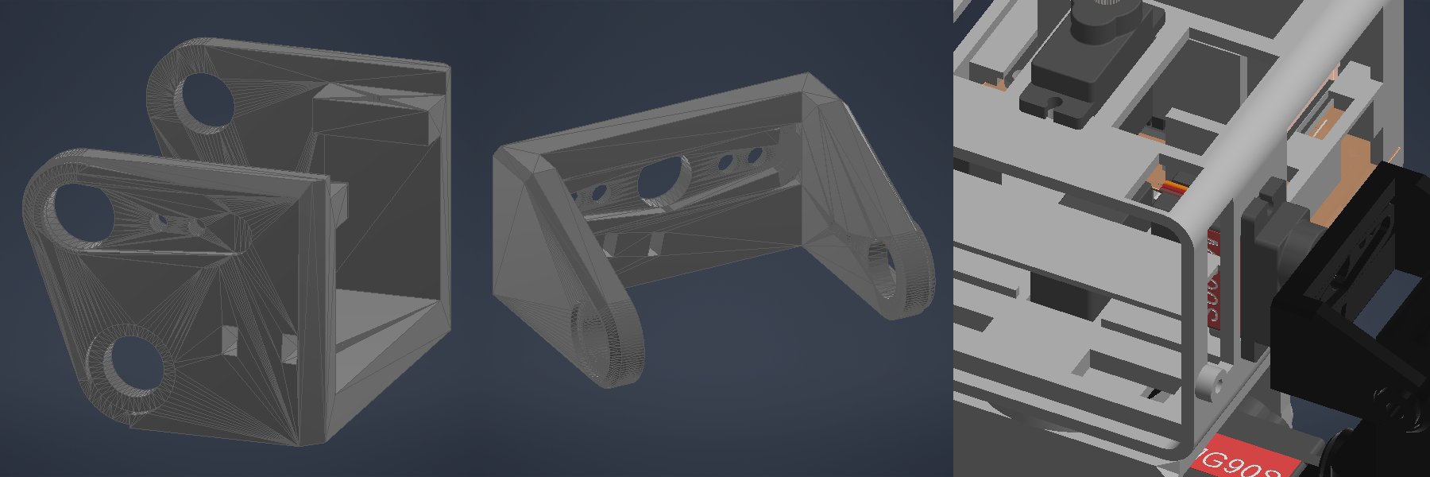
CAD/Nuevo/vistas_torso/mejoras.png
