rodrigoqweds90/Proyecto-Robot/CAD/Nuevo/vistas_torso/molde_pierna_detalle.png

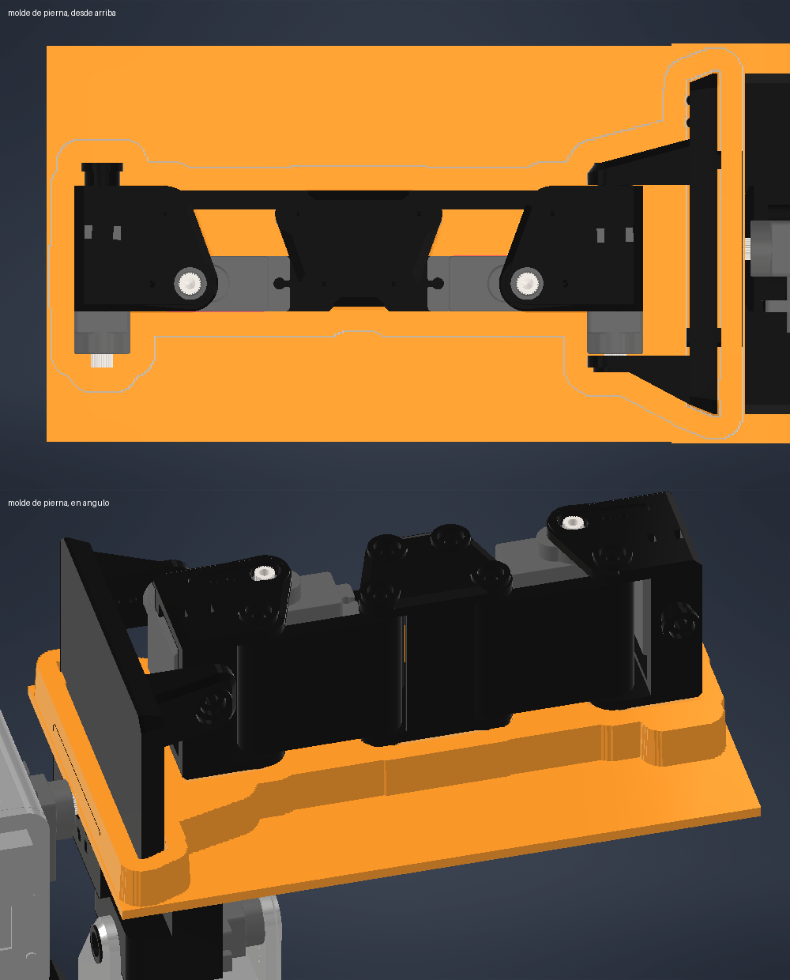
CAD/Nuevo/vistas_torso/molde_pierna_detalle.png
