rodrigoqweds90/Proyecto-Robot/CAD/Nuevo/vistas_torso/muescas_cable.png

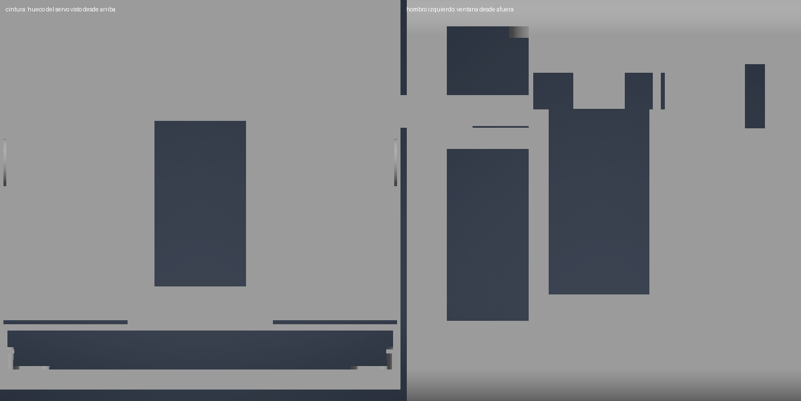
CAD/Nuevo/vistas_torso/muescas_cable.png
