rodrigoqweds90/Proyecto-Robot/CAD/Nuevo/vistas_torso/orientacion_impresion.png

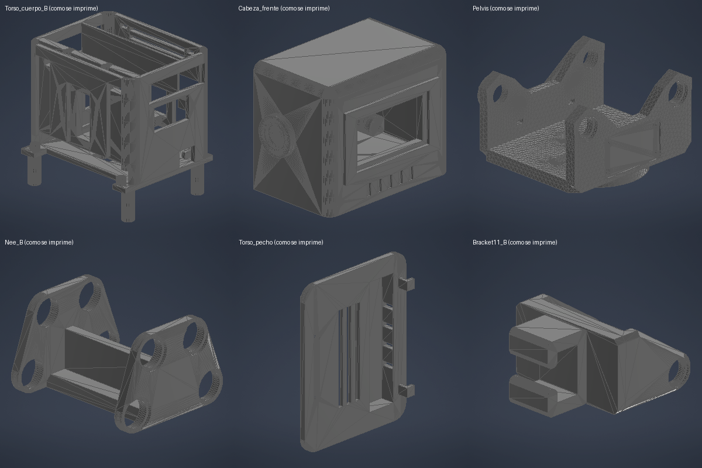
CAD/Nuevo/vistas_torso/orientacion_impresion.png
