rodrigoqweds90/Proyecto-Robot/CAD/Nuevo/vistas_torso/pecho_chaflan2.png

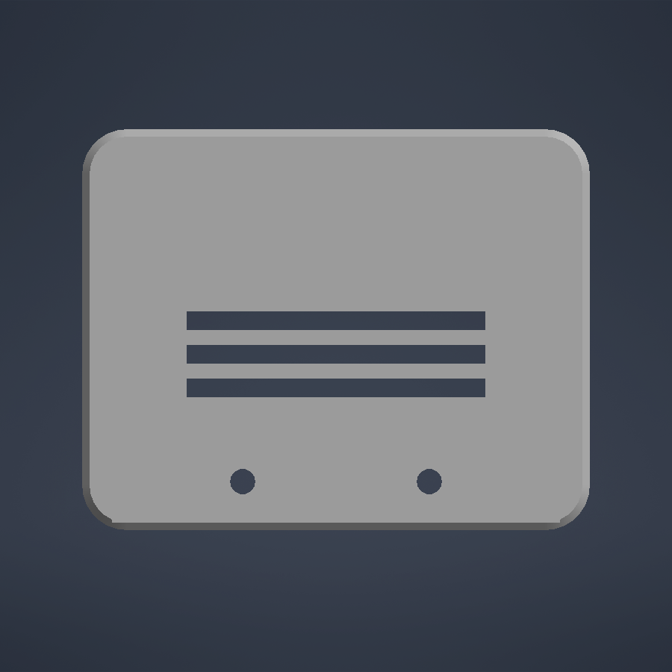
CAD/Nuevo/vistas_torso/pecho_chaflan2.png
