rodrigoqweds90/Proyecto-Robot/CAD/Nuevo/vistas_torso/pecho_chaflan.png

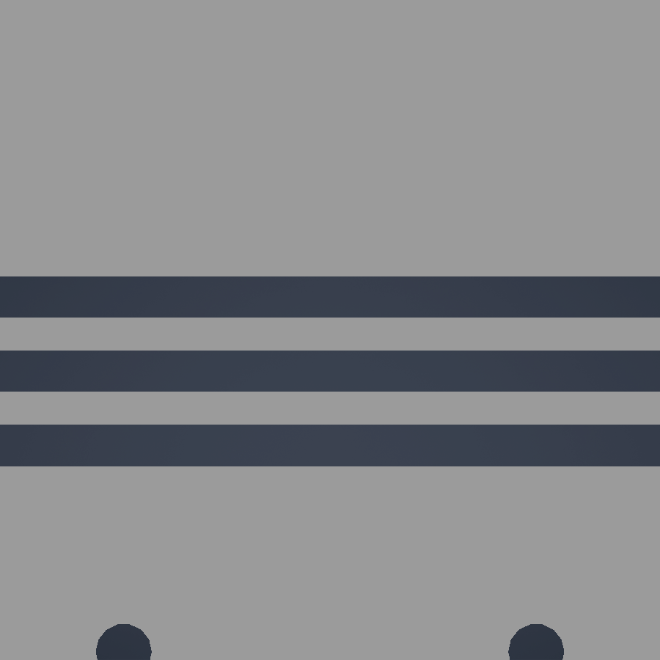
CAD/Nuevo/vistas_torso/pecho_chaflan.png
