rodrigoqweds90/Proyecto-Robot/CAD/Nuevo/vistas_torso/piezas_complejas.png

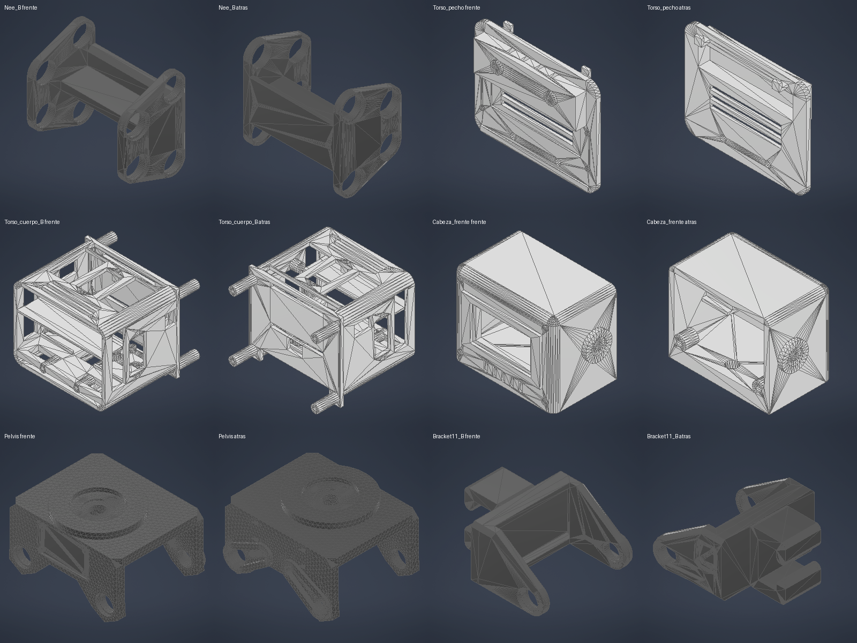
CAD/Nuevo/vistas_torso/piezas_complejas.png
