rodrigoqweds90/Proyecto-Robot/CAD/Nuevo/vistas_torso/piezas_pierna.png

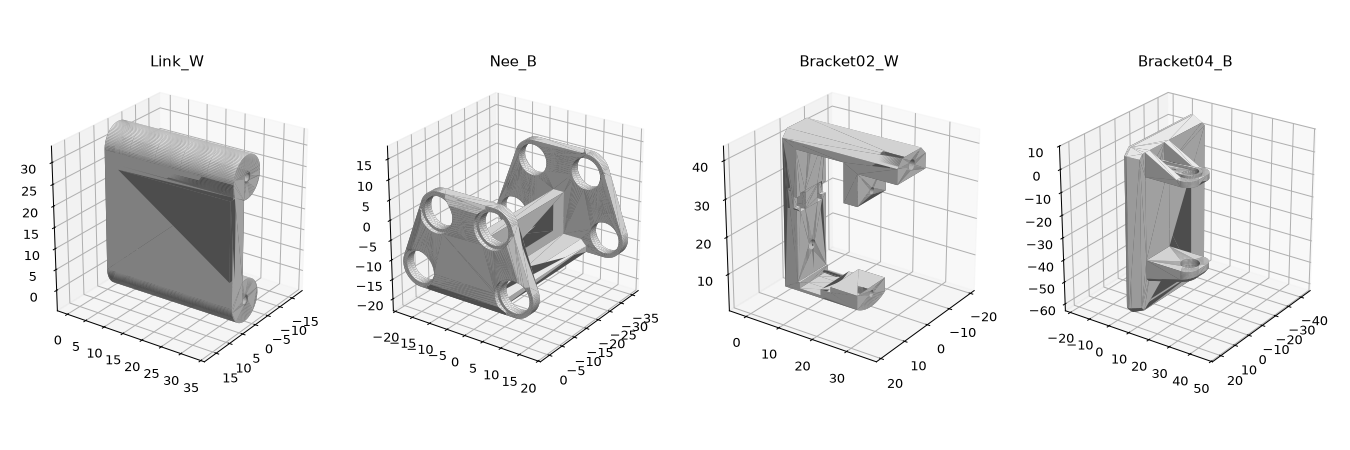
CAD/Nuevo/vistas_torso/piezas_pierna.png
