rodrigoqweds90/Proyecto-Robot/CAD/Nuevo/vistas_torso/pipe_0.png

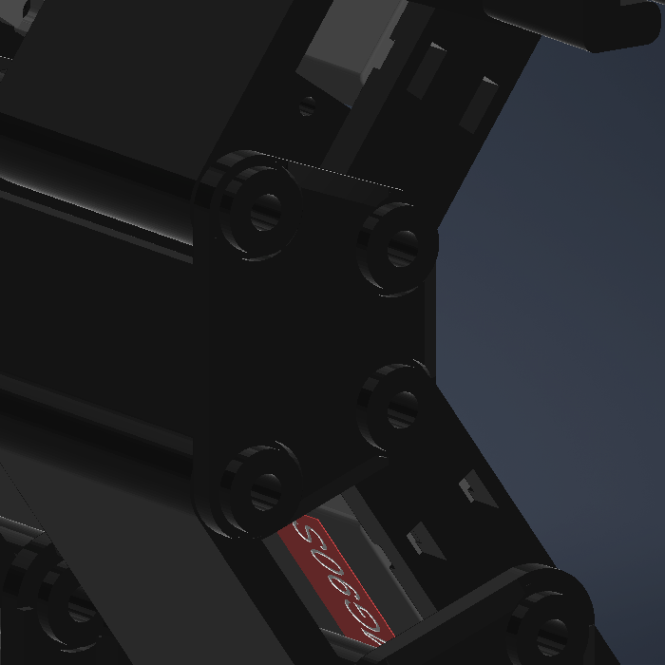
CAD/Nuevo/vistas_torso/pipe_0.png
