rodrigoqweds90/Proyecto-Robot/CAD/Nuevo/vistas_torso/pipe_1.png

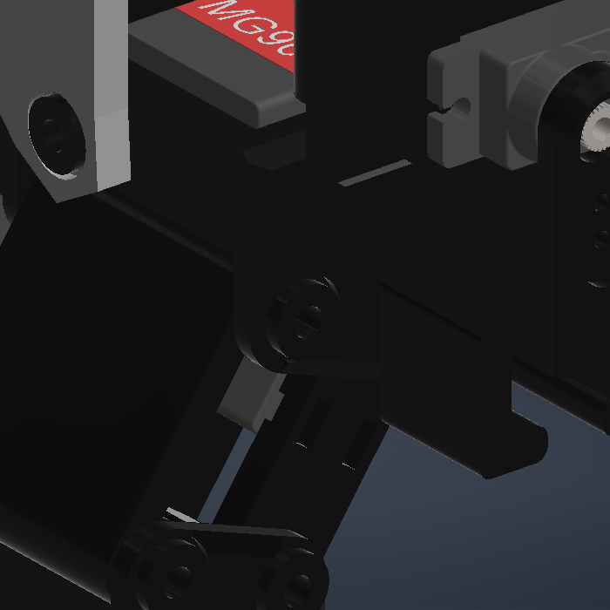
CAD/Nuevo/vistas_torso/pipe_1.png
