rodrigoqweds90/Proyecto-Robot/CAD/Nuevo/vistas_torso/pipe_2.png

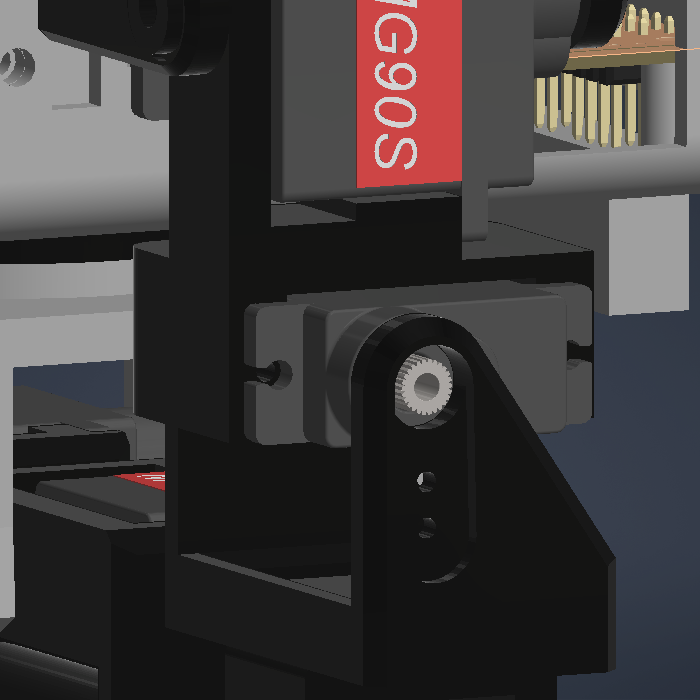
CAD/Nuevo/vistas_torso/pipe_2.png
