rodrigoqweds90/Proyecto-Robot/CAD/Nuevo/vistas_torso/pipe_collar.png

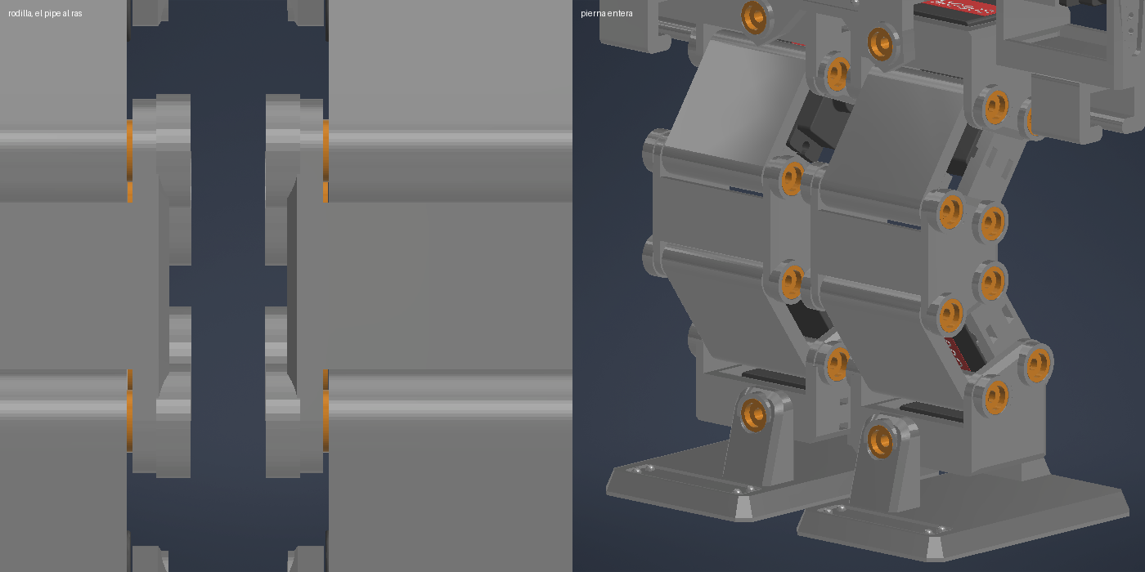
CAD/Nuevo/vistas_torso/pipe_collar.png
