rodrigoqweds90/Proyecto-Robot/CAD/Nuevo/vistas_torso/pipe_opciones.png

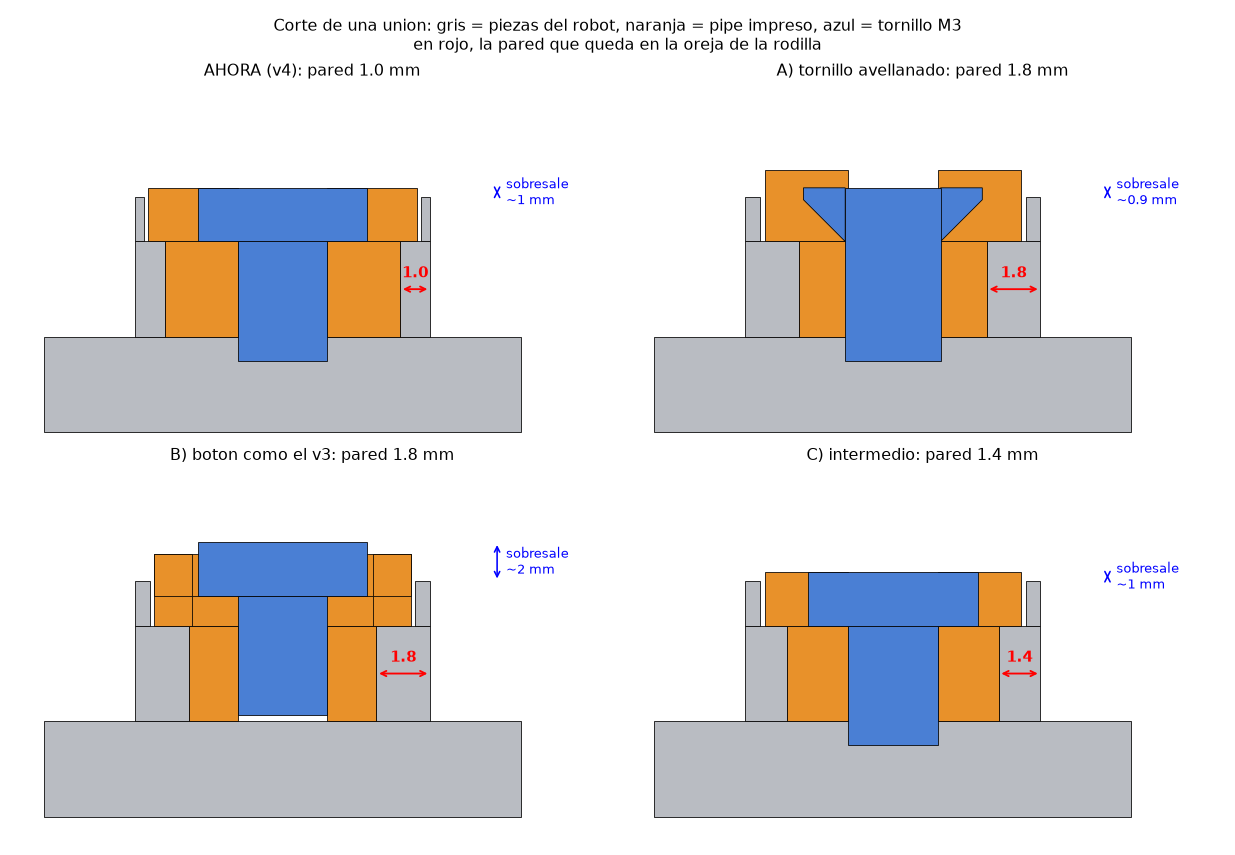
CAD/Nuevo/vistas_torso/pipe_opciones.png
