rodrigoqweds90/Proyecto-Robot/CAD/Nuevo/vistas_torso/pipe_v5_rodilla.png

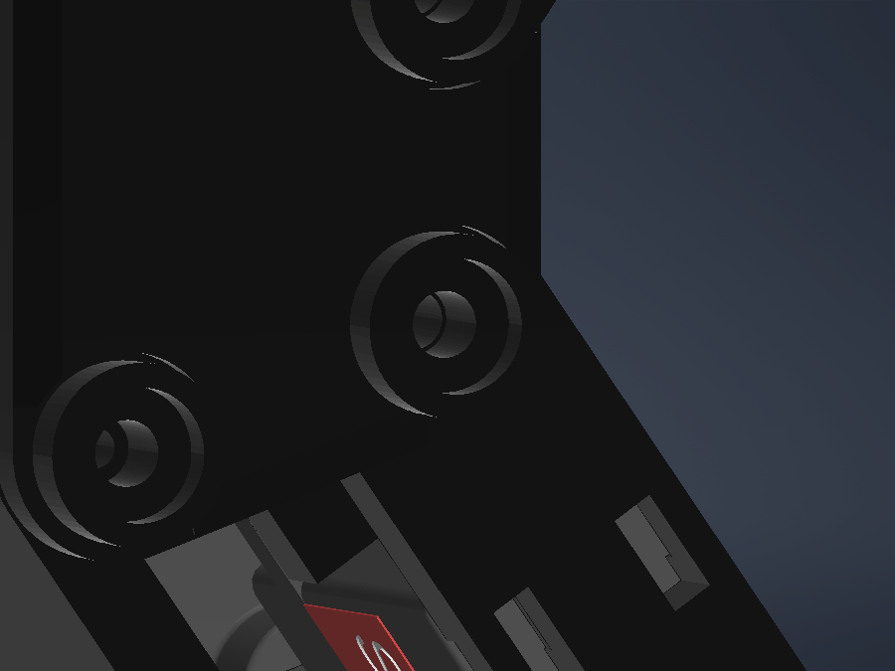
CAD/Nuevo/vistas_torso/pipe_v5_rodilla.png
