rodrigoqweds90/Proyecto-Robot/CAD/Nuevo/vistas_torso/pipes.png

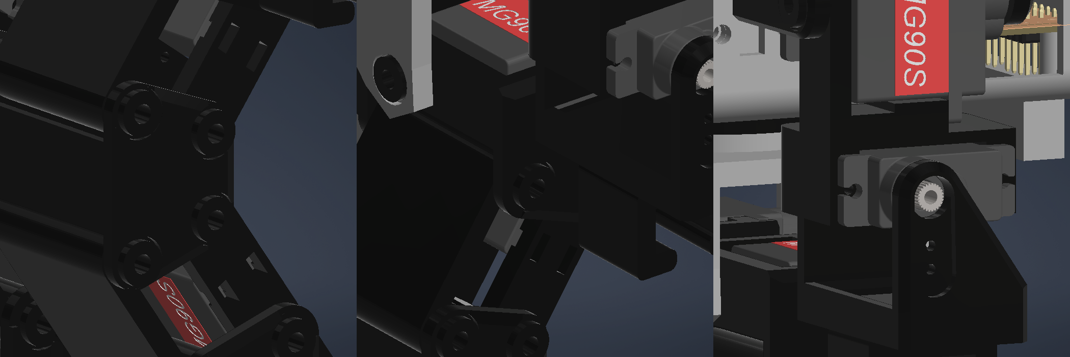
CAD/Nuevo/vistas_torso/pipes.png
