rodrigoqweds90/Proyecto-Robot/CAD/Nuevo/vistas_torso/placa_impresion.png

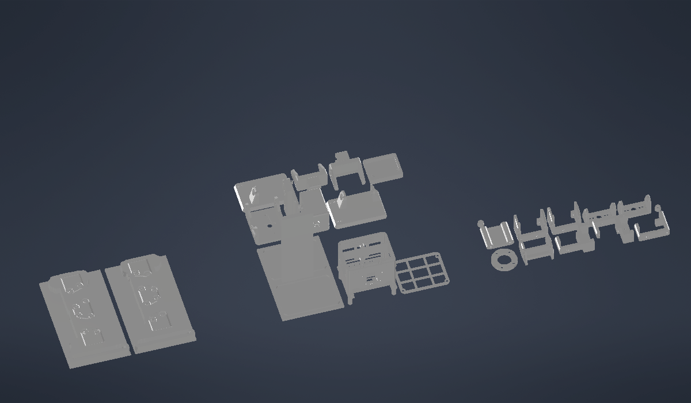
CAD/Nuevo/vistas_torso/placa_impresion.png
