rodrigoqweds90/Proyecto-Robot/CAD/Nuevo/vistas_torso/propuesta_costado.png

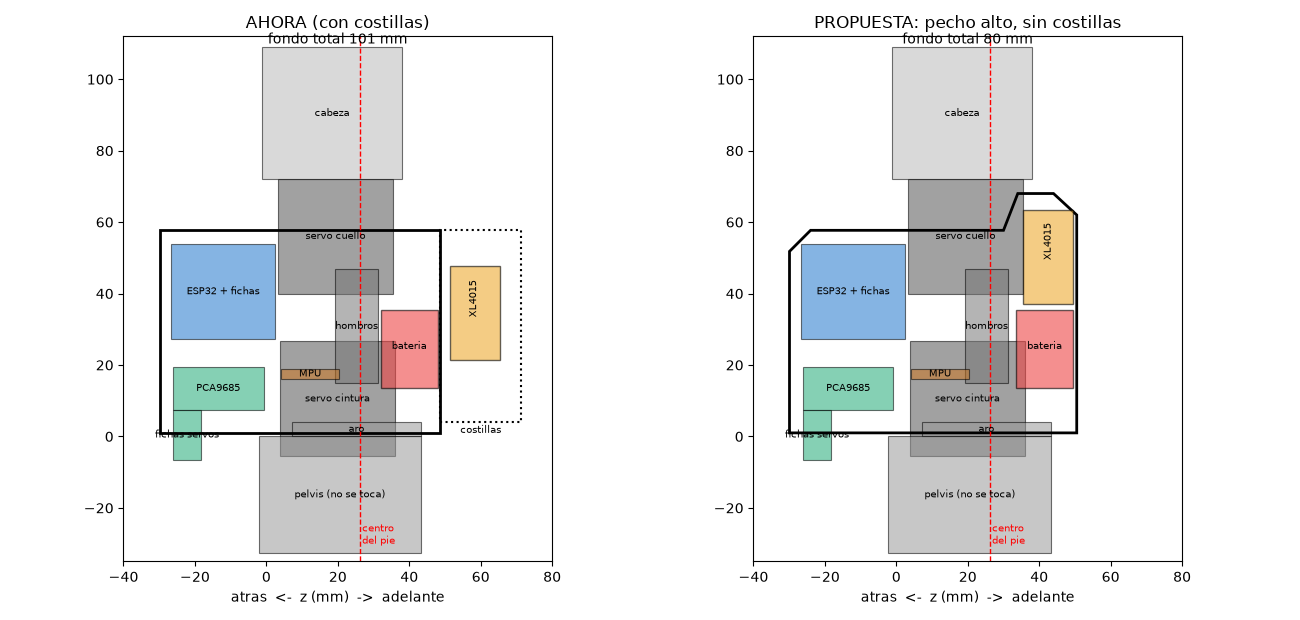
CAD/Nuevo/vistas_torso/propuesta_costado.png
