rodrigoqweds90/Proyecto-Robot/CAD/Nuevo/vistas_torso/recto_1.png

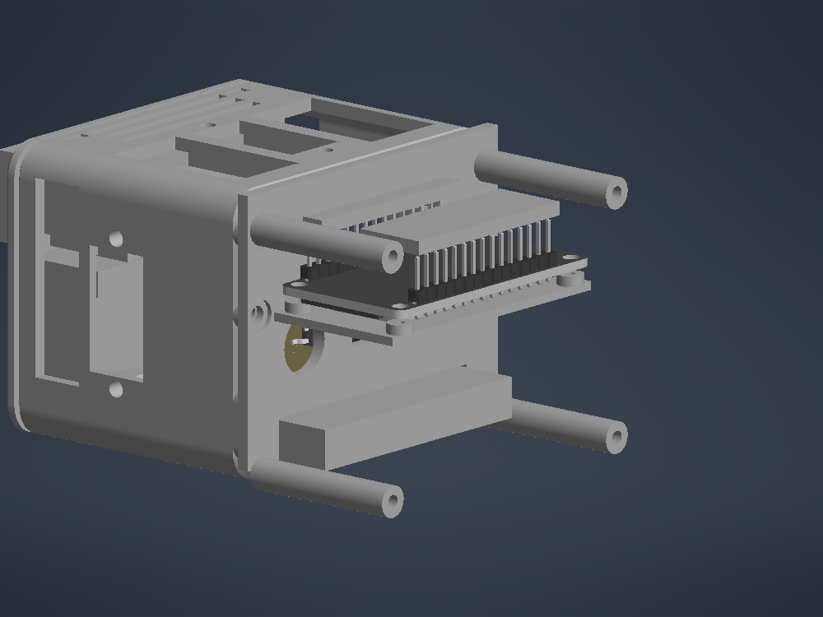
CAD/Nuevo/vistas_torso/recto_1.png
