rodrigoqweds90/Proyecto-Robot/CAD/Nuevo/vistas_torso/recto_2.png

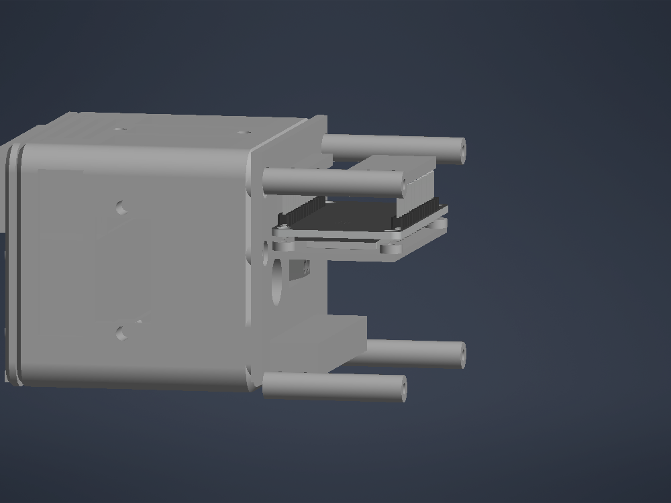
CAD/Nuevo/vistas_torso/recto_2.png
