rodrigoqweds90/Proyecto-Robot/CAD/Nuevo/vistas_torso/revision_frente.png

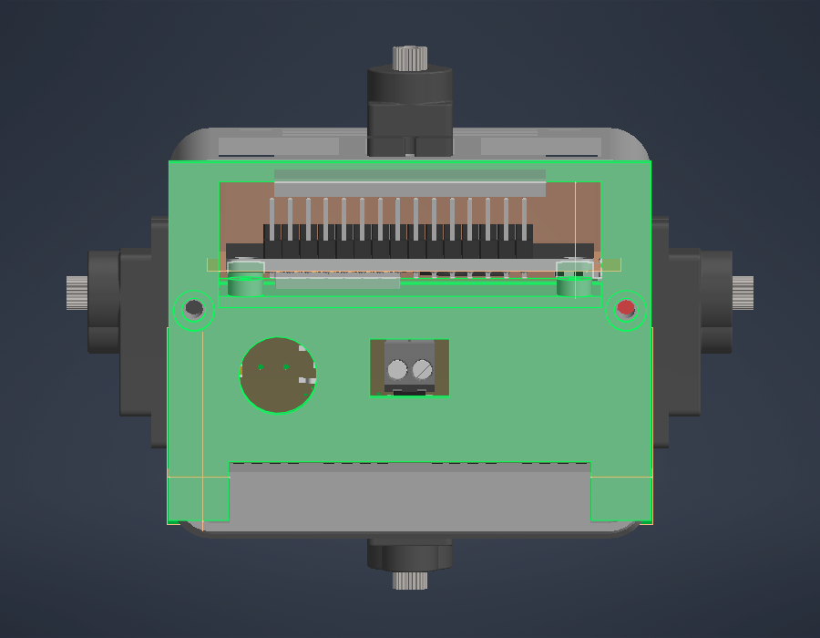
CAD/Nuevo/vistas_torso/revision_frente.png
