rodrigoqweds90/Proyecto-Robot/CAD/Nuevo/vistas_torso/robot_aligerado.png

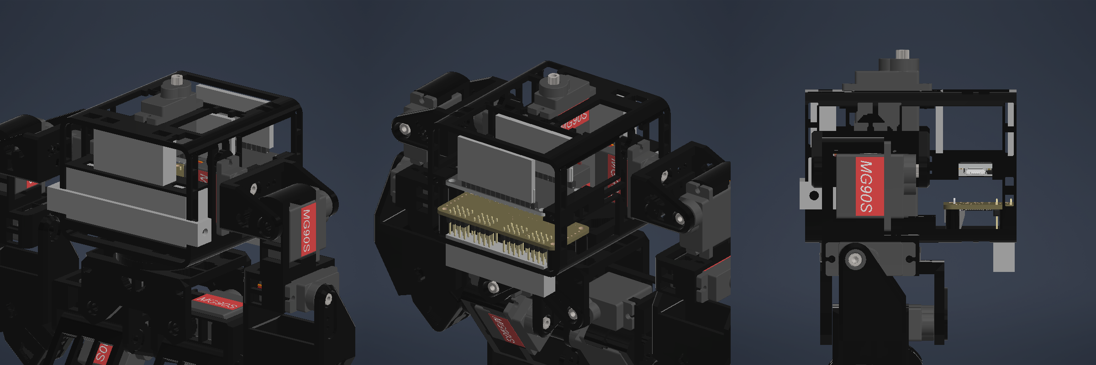
CAD/Nuevo/vistas_torso/robot_aligerado.png
