rodrigoqweds90/Proyecto-Robot/CAD/Nuevo/vistas_torso/robot_aligerado_completo.png

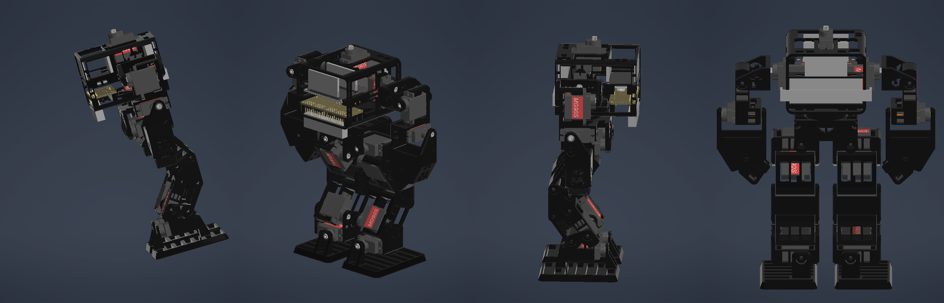
CAD/Nuevo/vistas_torso/robot_aligerado_completo.png
