rodrigoqweds90/Proyecto-Robot/CAD/Nuevo/vistas_torso/robot_clasico.png

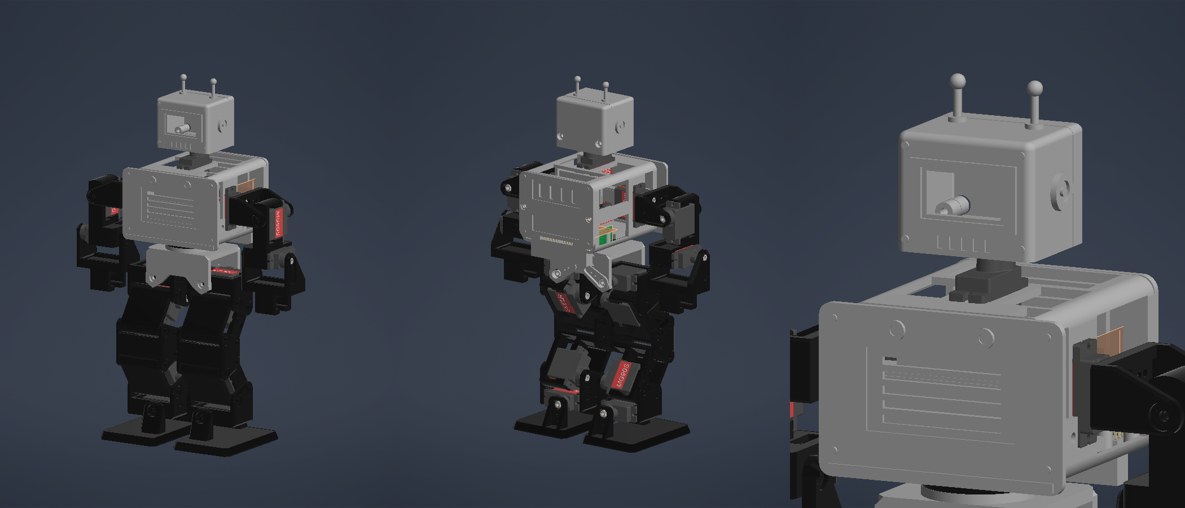
CAD/Nuevo/vistas_torso/robot_clasico.png
