rodrigoqweds90/Proyecto-Robot/CAD/Nuevo/vistas_torso/robot_en_soporte.png

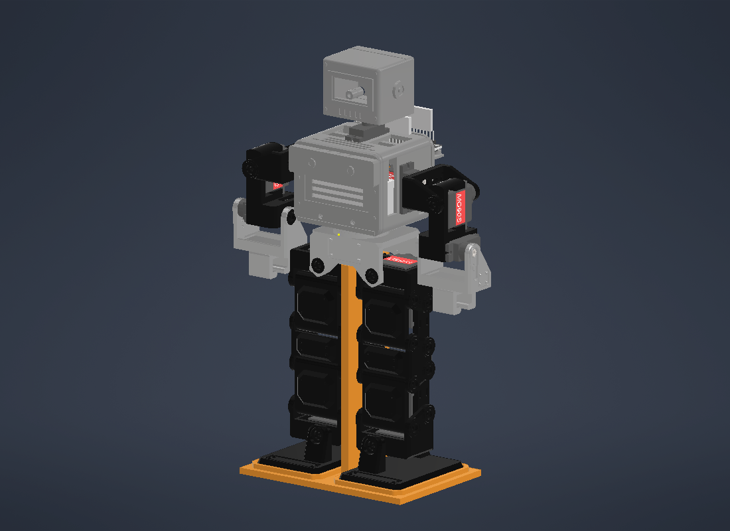
CAD/Nuevo/vistas_torso/robot_en_soporte.png
