rodrigoqweds90/Proyecto-Robot/CAD/Nuevo/vistas_torso/robot_y_piezas.png

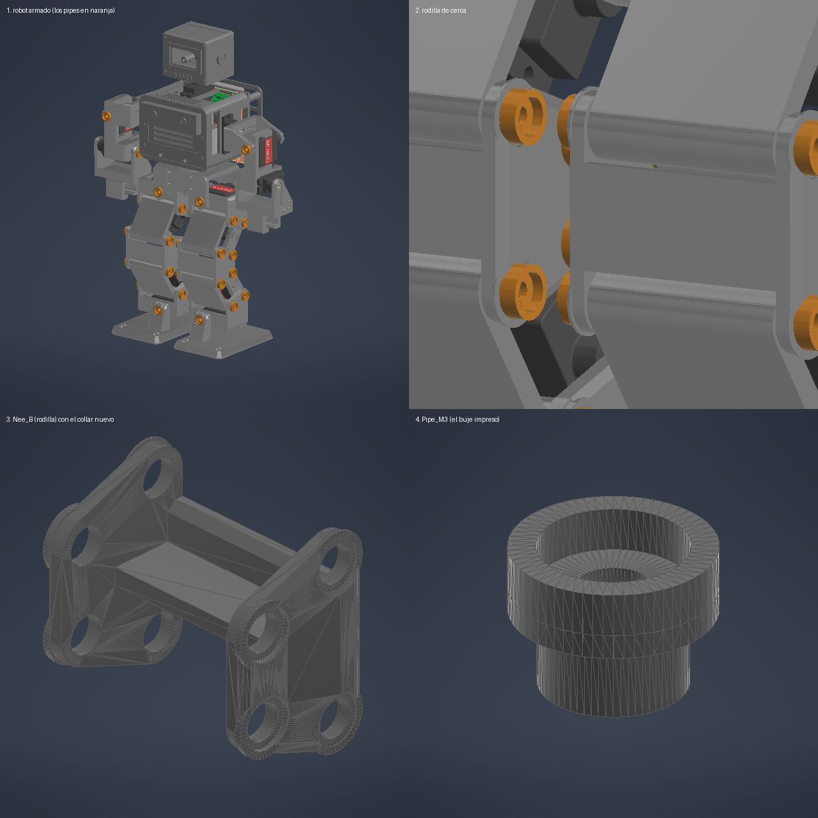
CAD/Nuevo/vistas_torso/robot_y_piezas.png
