rodrigoqweds90/Proyecto-Robot/CAD/Nuevo/vistas_torso/solo_torso.png

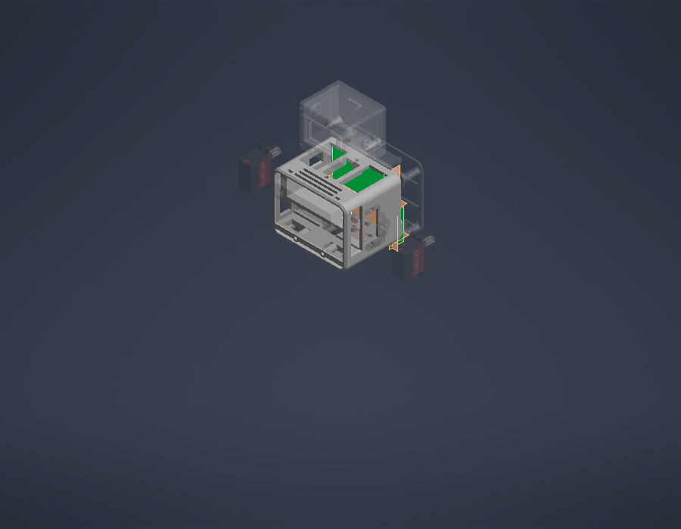
CAD/Nuevo/vistas_torso/solo_torso.png
