rodrigoqweds90/Proyecto-Robot/CAD/Nuevo/vistas_torso/soporte_parado_frente.png

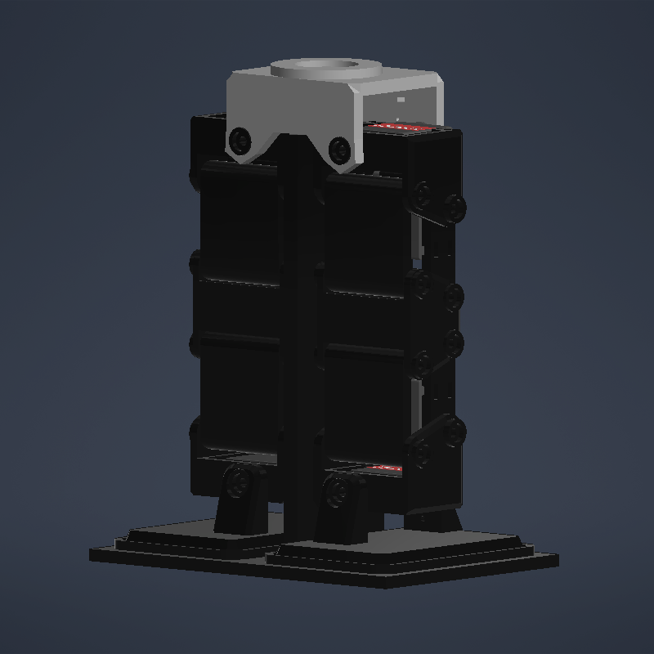
CAD/Nuevo/vistas_torso/soporte_parado_frente.png
