rodrigoqweds90/Proyecto-Robot/CAD/Nuevo/vistas_torso/soportes_pierna_atras.png

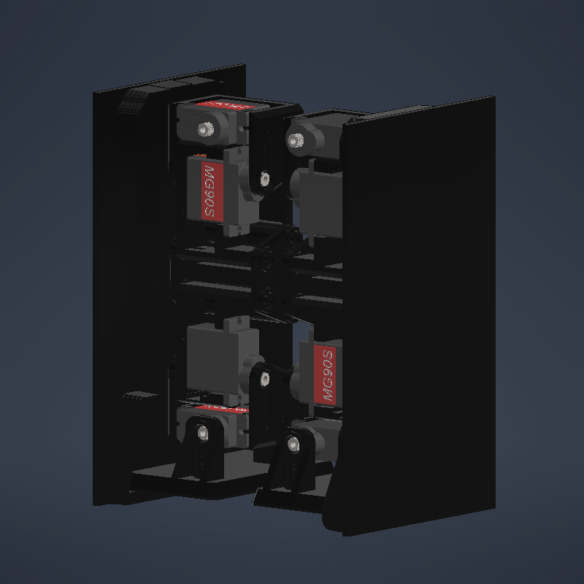
CAD/Nuevo/vistas_torso/soportes_pierna_atras.png
