rodrigoqweds90/Proyecto-Robot/CAD/Nuevo/vistas_torso/torso_ajustes.png

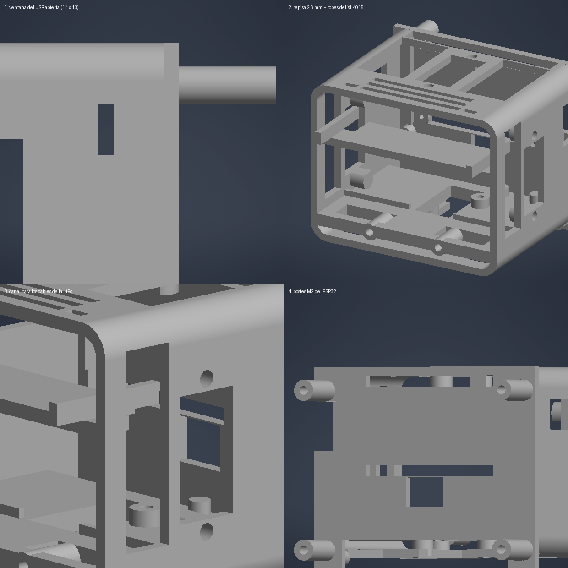
CAD/Nuevo/vistas_torso/torso_ajustes.png
