rodrigoqweds90/Proyecto-Robot/CAD/Nuevo/vistas_torso/torso_condensador.png

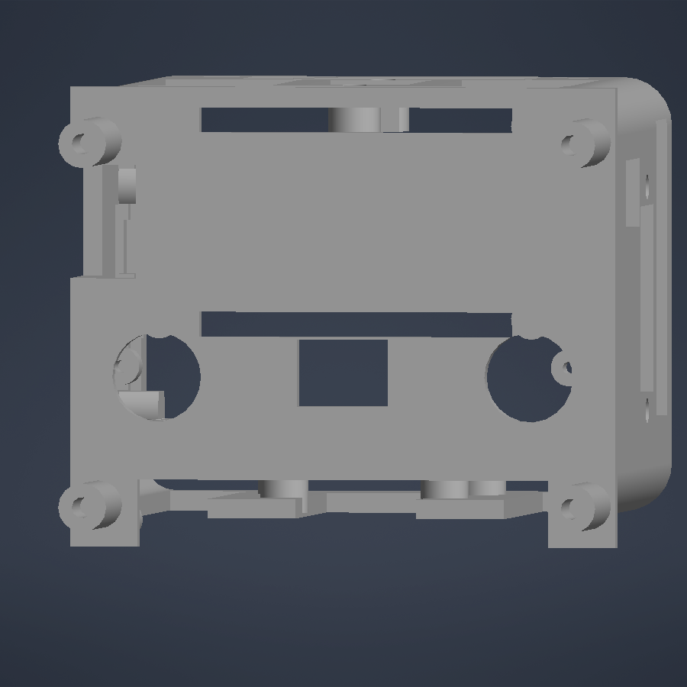
CAD/Nuevo/vistas_torso/torso_condensador.png
