rodrigoqweds90/Proyecto-Robot/CAD/Nuevo/vistas_torso/torso_techo.png

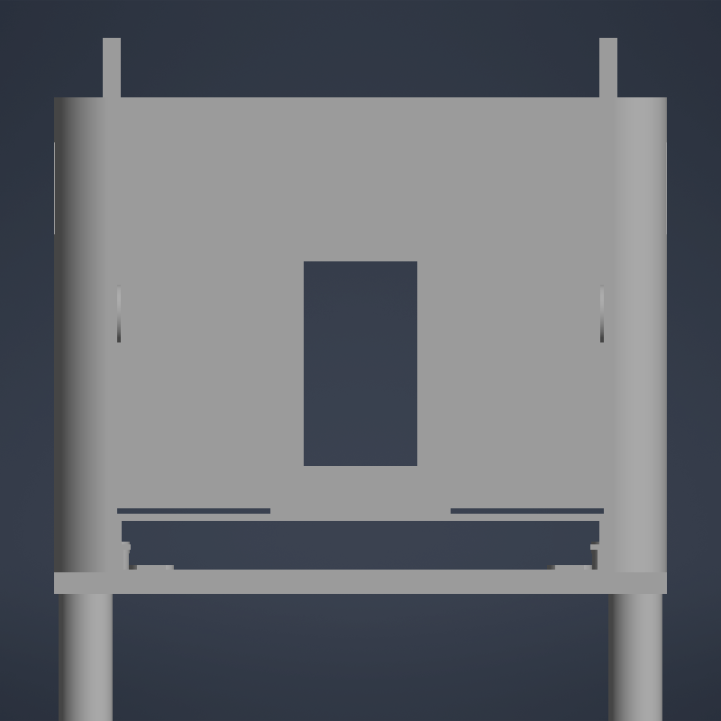
CAD/Nuevo/vistas_torso/torso_techo.png
