rodrigoqweds90/Proyecto-Robot/CAD/Nuevo/vistas_torso/tresc_atras_B.png

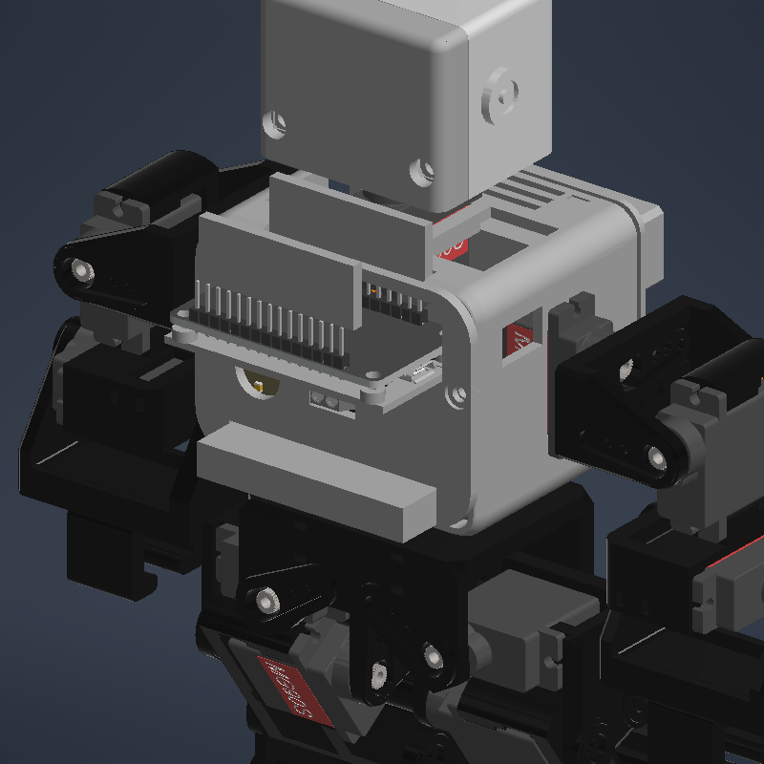
CAD/Nuevo/vistas_torso/tresc_atras_B.png
