rodrigoqweds90/Proyecto-Robot/CAD/Nuevo/vistas_torso/tresc_frente_aligerado.png

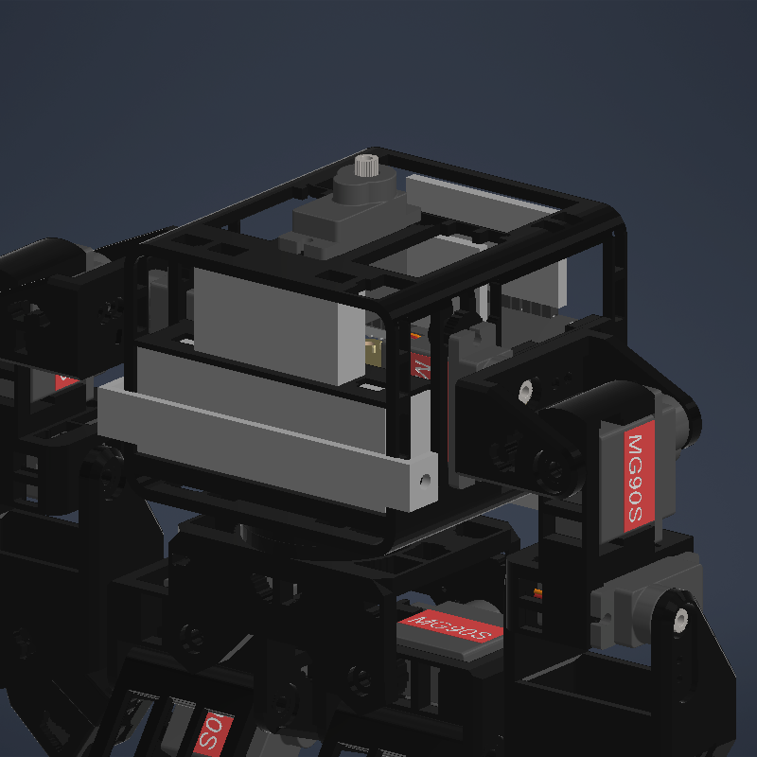
CAD/Nuevo/vistas_torso/tresc_frente_aligerado.png
