rodrigoqweds90/Proyecto-Robot/CAD/Nuevo/vistas_torso/usuario_editado.png

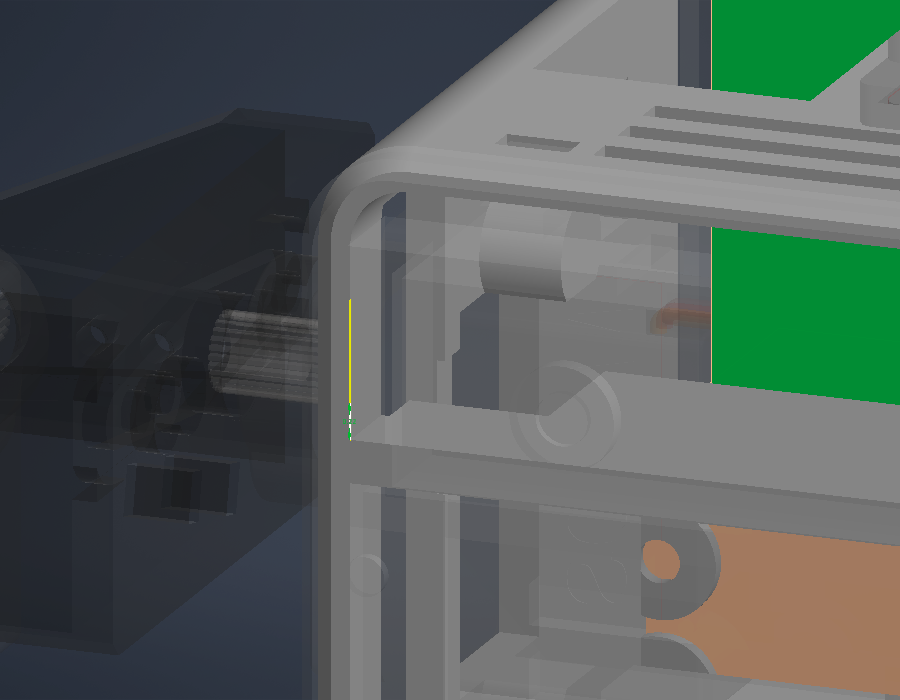
CAD/Nuevo/vistas_torso/usuario_editado.png
