rodrigoqweds90/Proyecto-Robot/CAD/Nuevo/vistas_torso/xl4015_arriba2.png

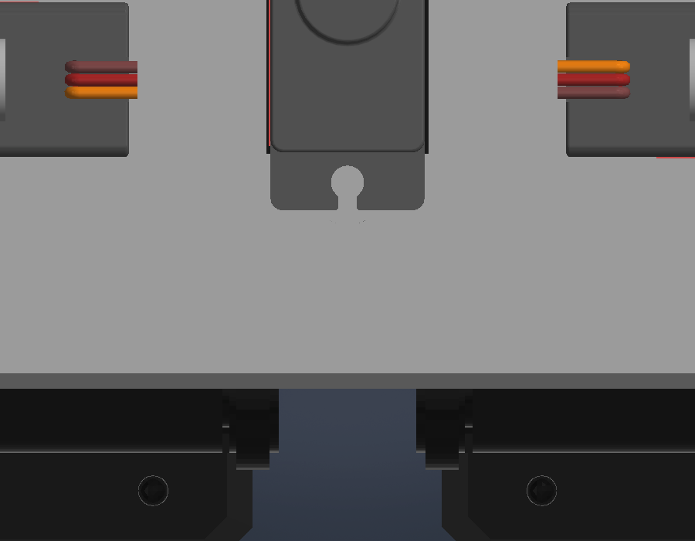
CAD/Nuevo/vistas_torso/xl4015_arriba2.png
