rodrigoqweds90/Proyecto-Robot/CAD/Nuevo/vistas_torso/xl4015_costado.png

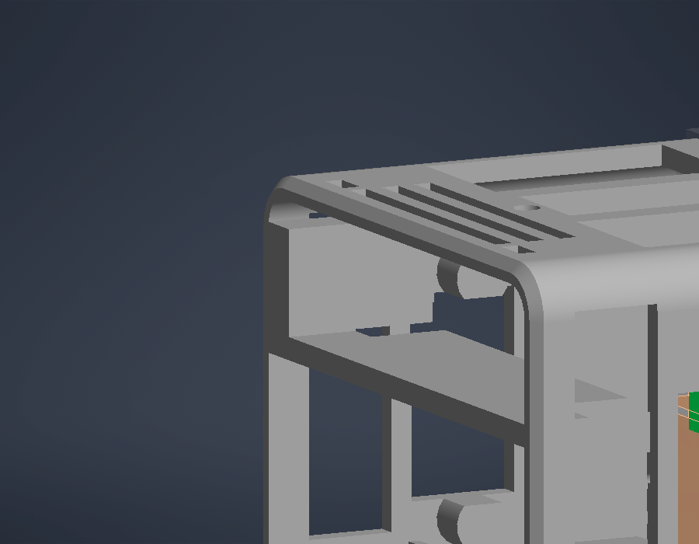
CAD/Nuevo/vistas_torso/xl4015_costado.png
