rodrigoqweds90/Proyecto-Robot/CAD/Nuevo/vistas_torso/xl4015_nuevo.png

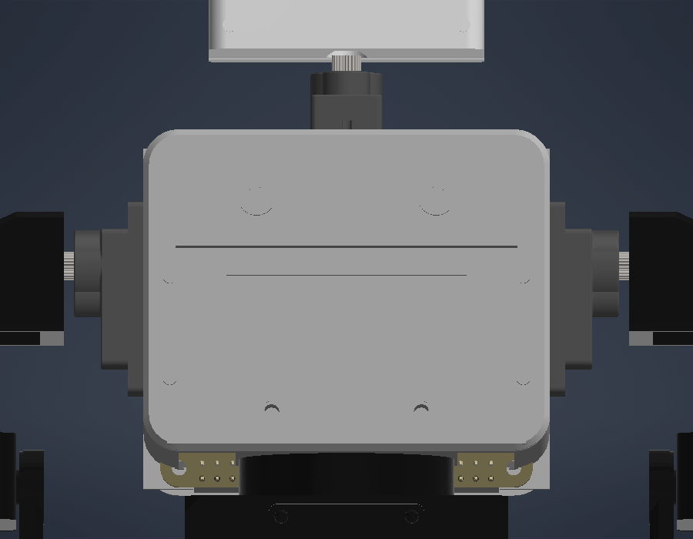
CAD/Nuevo/vistas_torso/xl4015_nuevo.png
