rodrigoqweds90/Proyecto-Robot/CAD/Nuevo/vistas_torso/xl4015_v4.png

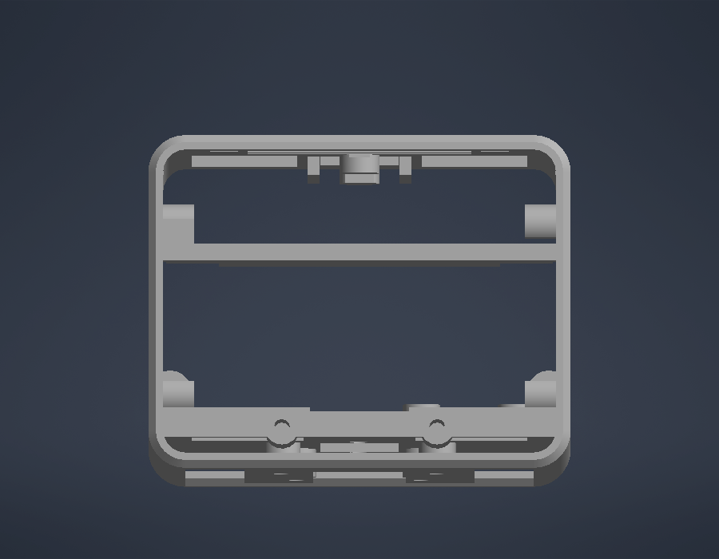
CAD/Nuevo/vistas_torso/xl4015_v4.png
