rodrigoqweds90/Proyecto-Robot/CAD/NX25_original/vistas/Bracket02_W_iso1.png

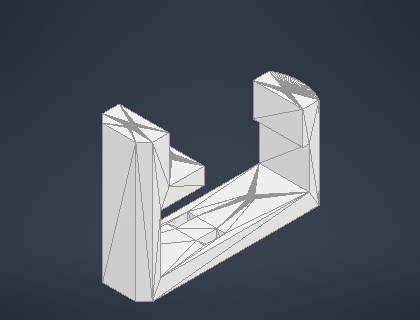
CAD/NX25_original/vistas/Bracket02_W_iso1.png
