rodrigoqweds90/Proyecto-Robot/CAD/NX25_original/vistas/Bracket04_B_iso2.png

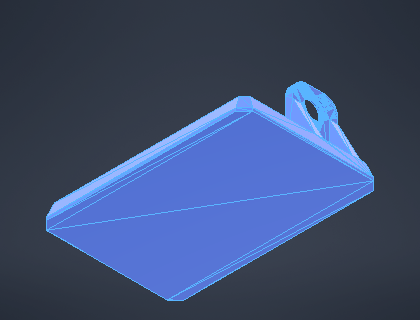
CAD/NX25_original/vistas/Bracket04_B_iso2.png
