rodrigoqweds90/Proyecto-Robot/CAD/NX25_original/vistas/Bracket06_W_iso1.png

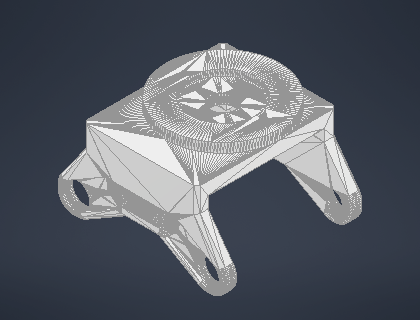
CAD/NX25_original/vistas/Bracket06_W_iso1.png
