rodrigoqweds90/Proyecto-Robot/CAD/NX25_original/vistas/Bracket09_W_iso2.png

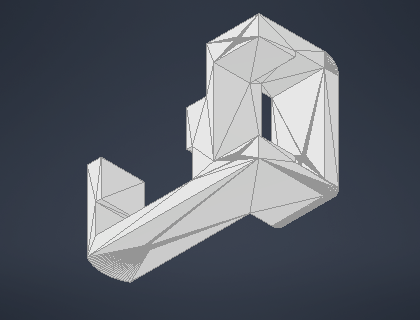
CAD/NX25_original/vistas/Bracket09_W_iso2.png
