rodrigoqweds90/Proyecto-Robot/CAD/NX25_original/vistas/hoja_pierna_3.png

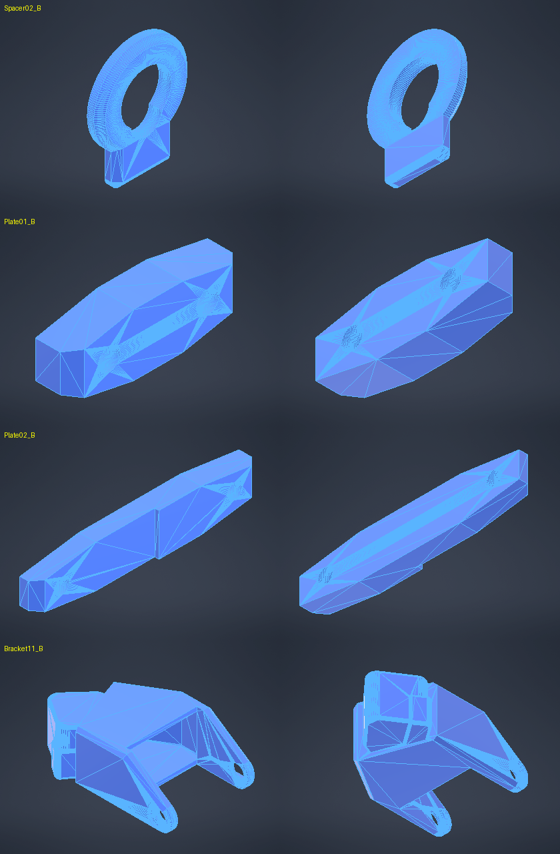
CAD/NX25_original/vistas/hoja_pierna_3.png
