rodrigoqweds90/Proyecto-Robot/CAD/NX25_original/vistas/Link_W_iso1.png

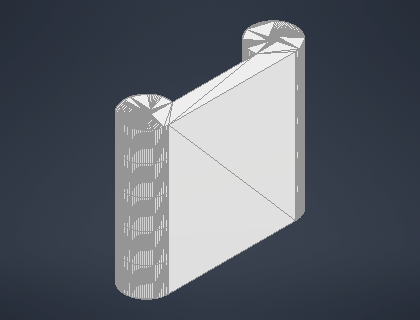
CAD/NX25_original/vistas/Link_W_iso1.png
