rodrigoqweds90/Proyecto-Robot/CAD/NX25_original/vistas/Plate02_B_iso1.png

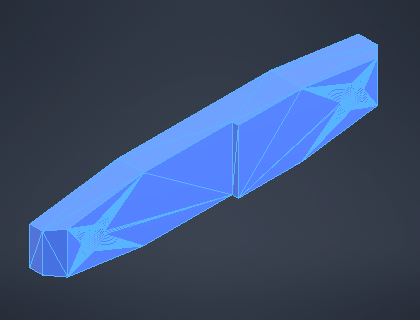
CAD/NX25_original/vistas/Plate02_B_iso1.png
