rodrigoqweds90/Proyecto-Robot/CAD/Robot2/revision/robot2_inventor_34.png

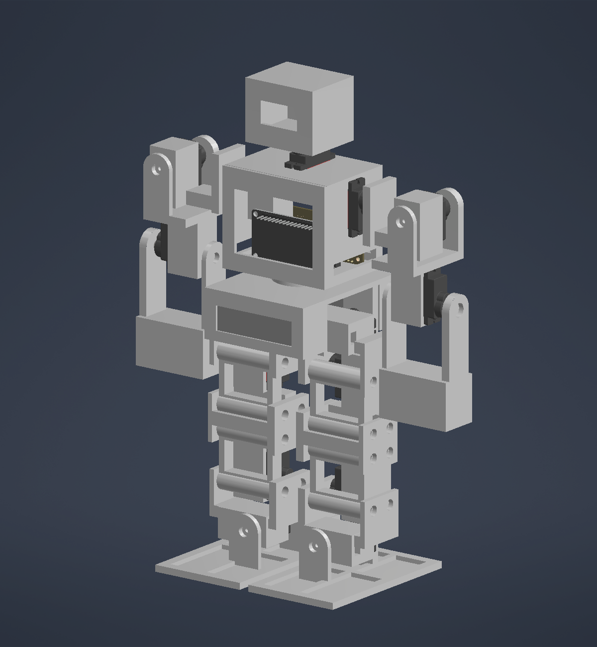
CAD/Robot2/revision/robot2_inventor_34.png
