rodrigoqweds90/Proyecto-Robot/CAD/Robot2/revision/robot2_vistas.png

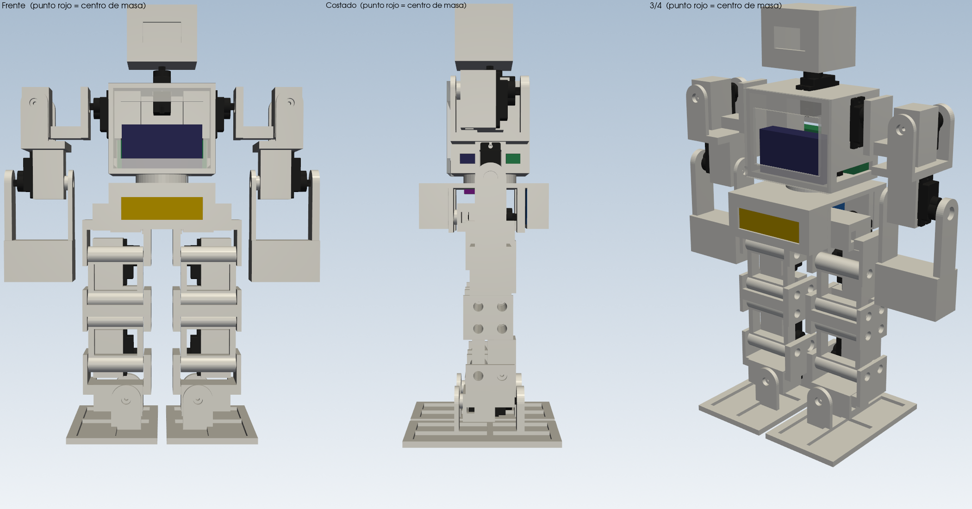
CAD/Robot2/revision/robot2_vistas.png
