rodrigoqweds90/Proyecto-Robot/CAD/Componentes/MG90S_horns_tipos.png

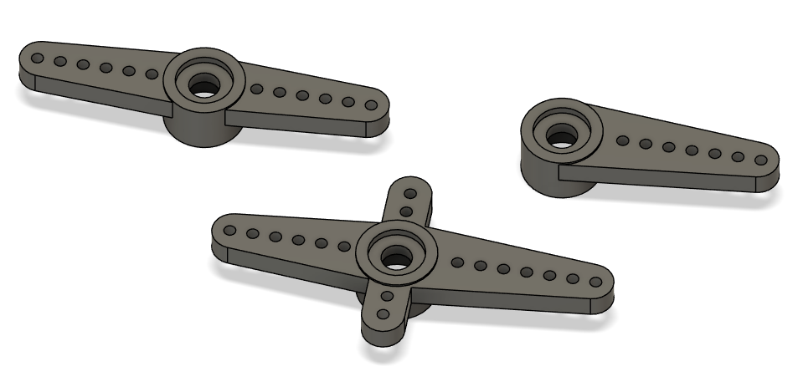
CAD/Componentes/MG90S_horns_tipos.png
