rodrigoqweds90/Proyecto-Robot/CAD/Componentes/vistas/freecad_SG90-1-arm-horn.png

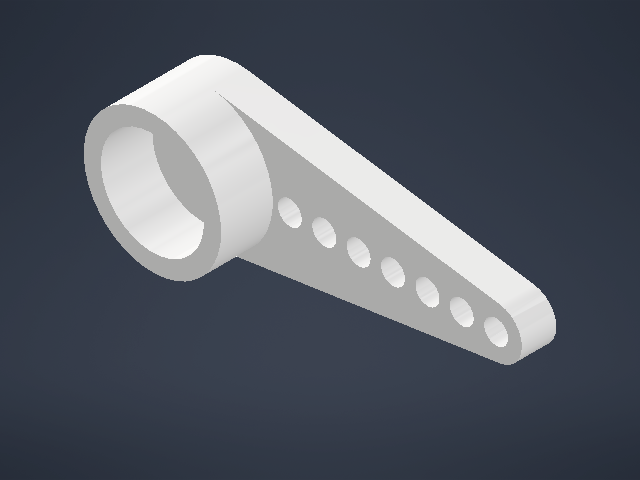
CAD/Componentes/vistas/freecad_SG90-1-arm-horn.png
