rodrigoqweds90/Proyecto-Robot/CAD/Componentes/vistas/freecad_SG90-2-arms-horn.png

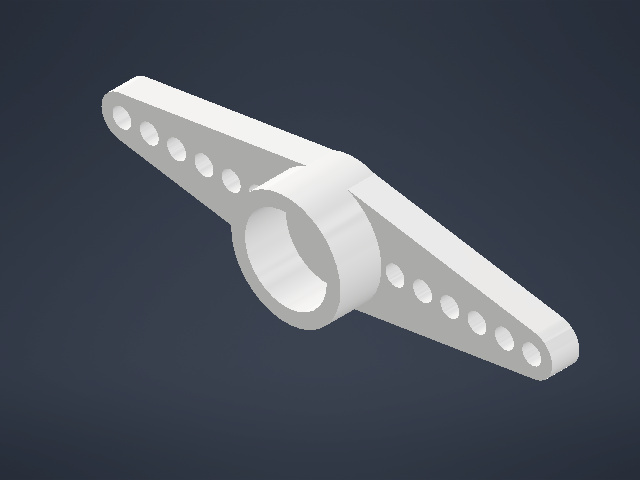
CAD/Componentes/vistas/freecad_SG90-2-arms-horn.png
