rodrigoqweds90/Proyecto-Robot/CAD/Componentes/vistas/MG90S_grabcad_mg90s9.png

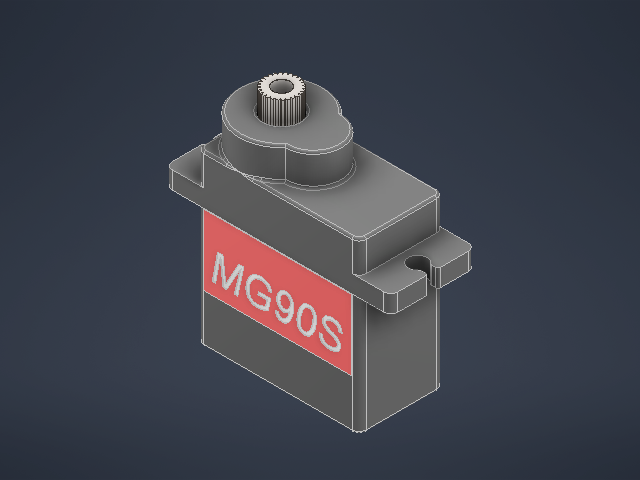
CAD/Componentes/vistas/MG90S_grabcad_mg90s9.png
