rodrigoqweds90/Proyecto-Robot/CAD/Componentes/vistas/MG90S_grabcad_towerpro.png

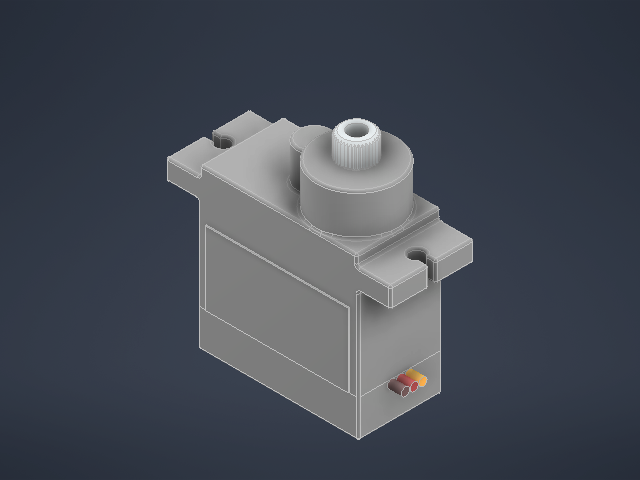
CAD/Componentes/vistas/MG90S_grabcad_towerpro.png
