rodrigoqweds90/Proyecto-Robot/CAD/Componentes/vistas/PCA9685_adafruit_815.png

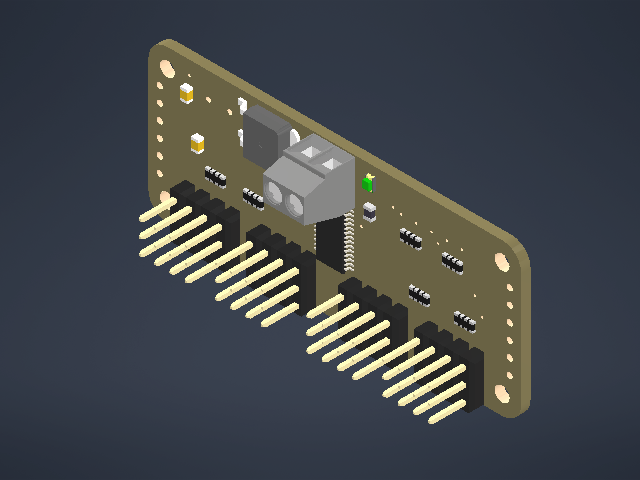
CAD/Componentes/vistas/PCA9685_adafruit_815.png
