rodrigoqweds90/Proyecto-Robot/CAD/Componentes/MG90S_horn_github.stl

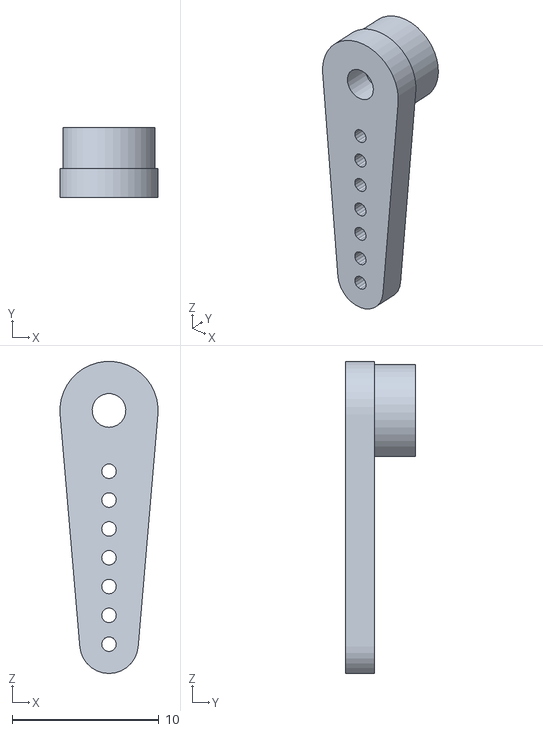
[picture p216: CAD file, 2026-09-30]
CAD/Componentes/MG90S_horn_github.stl
6.68 x 4.80 x 21.3
