rodrigoqweds90/Proyecto-Robot/CAD/Nuevo/__tracked_surface.stl

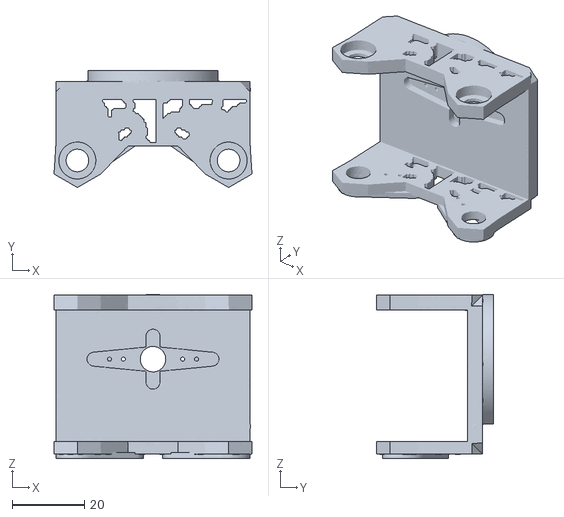
[picture p217: CAD file, 2026-09-30]
CAD/Nuevo/__tracked_surface.stl
55.0 x 32.5 x 45.6
