rodrigoqweds90/Proyecto-Robot/CAD/Nuevo/fea/aligeradas/Bracket10_W.stl

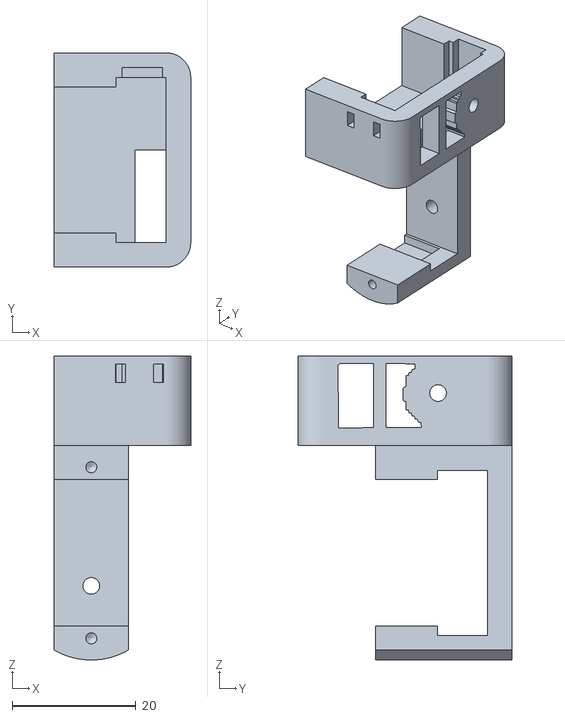
[picture p218: CAD file, 2026-09-30]
CAD/Nuevo/fea/aligeradas/Bracket10_W.stl
22.1 x 34.7 x 49.2
