rodrigoqweds90/Proyecto-Robot/CAD/Nuevo/fea/aligeradas_sin_filtro/Bracket04_B.stl

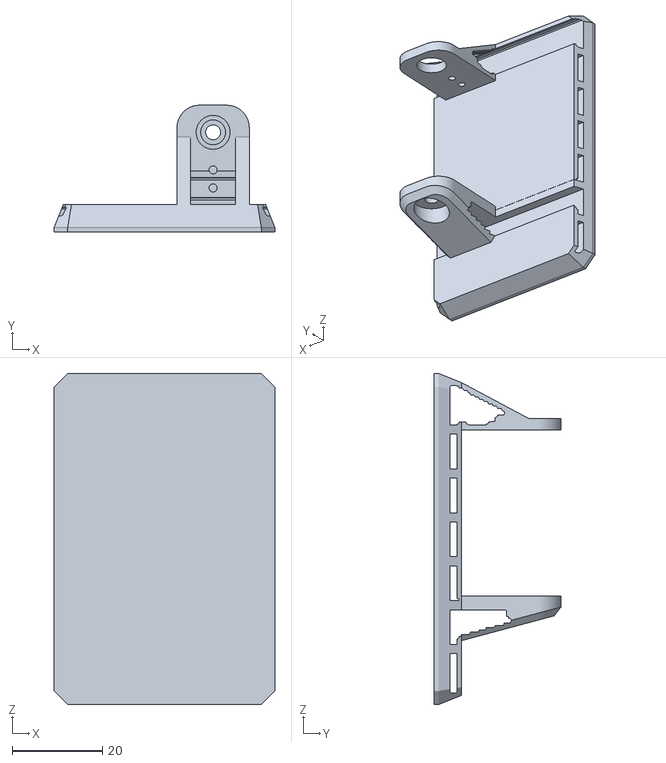
[picture p219: CAD file, 2026-09-30]
CAD/Nuevo/fea/aligeradas_sin_filtro/Bracket04_B.stl
48.8 x 28.0 x 73.2
