rodrigoqweds90/Proyecto-Robot/CAD/Nuevo/fea/tmp_aligerada_27964.stl

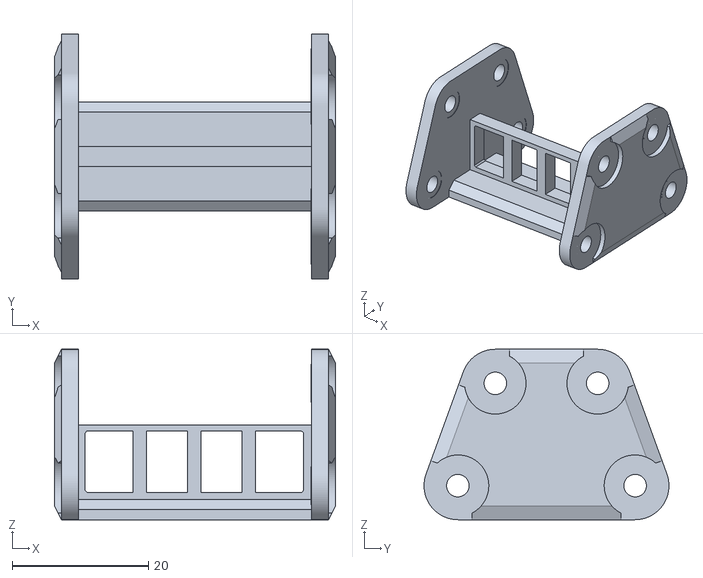
[picture p220: CAD file, 2026-09-30]
CAD/Nuevo/fea/tmp_aligerada_27964.stl
41.2 x 35.9 x 25.0
