rodrigoqweds90/Proyecto-Robot/CAD/Nuevo/imprimir_B/Bracket03_B_cadera.stl

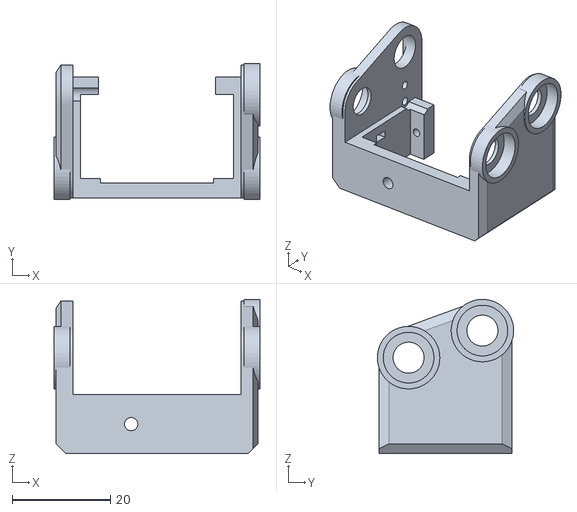
[picture p221: CAD file, 2026-10-19]
CAD/Nuevo/imprimir_B/Bracket03_B_cadera.stl
41.8 x 27.7 x 31.4
