rodrigoqweds90/Proyecto-Robot/CAD/Nuevo/para_imprimir/sin_aligerar/Nee_B.stl

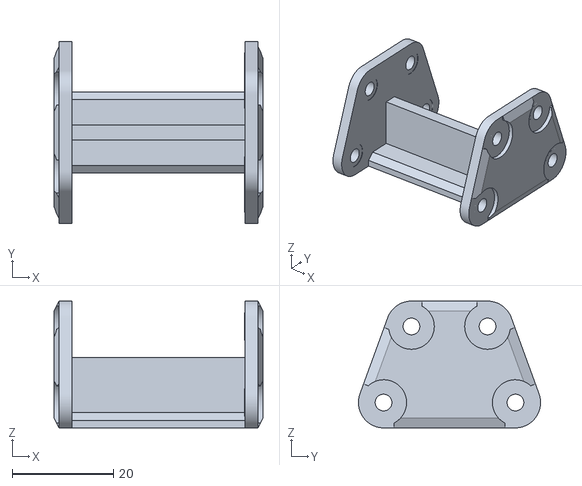
[picture p223: CAD file, 2026-09-30]
CAD/Nuevo/para_imprimir/sin_aligerar/Nee_B.stl
41.2 x 35.9 x 25.0
