rodrigoqweds90/Proyecto-Robot/CAD/Nuevo/piezas_boceto/espacio_codo.stl

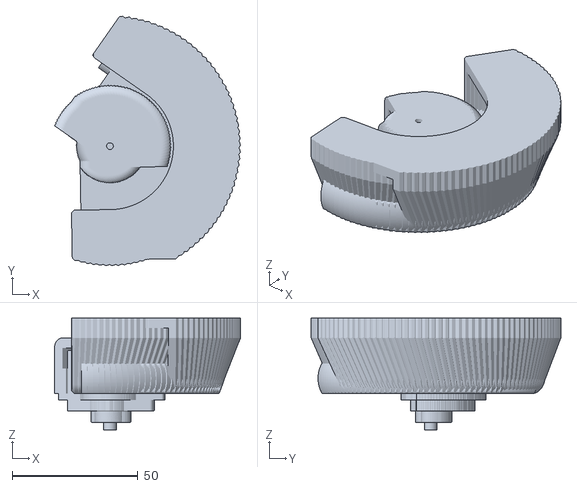
[picture p224: CAD file, 2026-09-30]
CAD/Nuevo/piezas_boceto/espacio_codo.stl
73.9 x 99.2 x 44.5
