rodrigoqweds90/Proyecto-Robot/CAD/Nuevo/piezas_boceto/mano_garra/Bracket12_B.stl

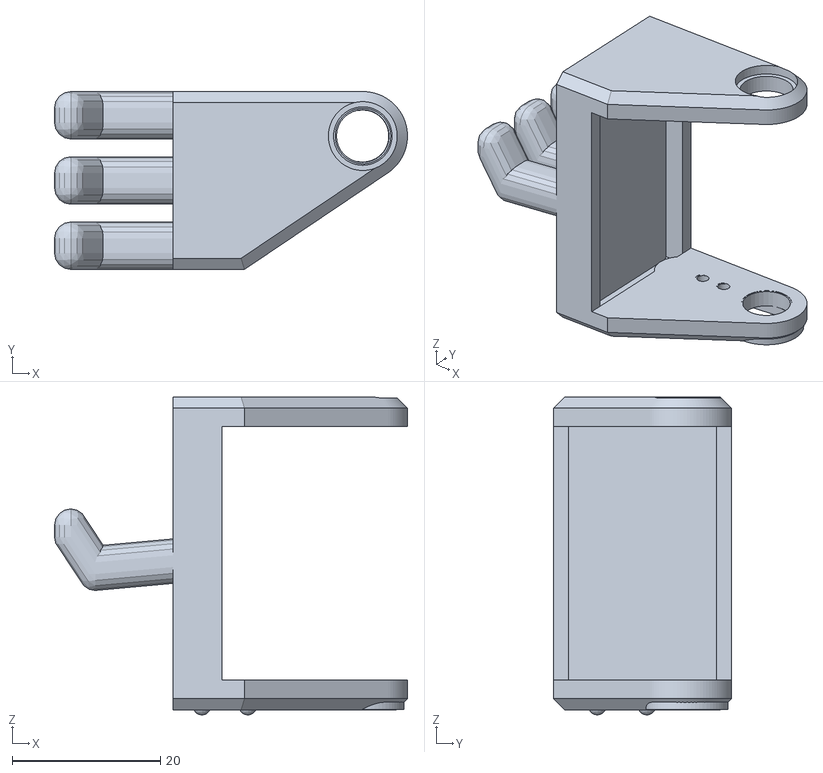
[picture p225: CAD file, 2026-09-30]
CAD/Nuevo/piezas_boceto/mano_garra/Bracket12_B.stl
47.6 x 24.0 x 42.9
