rodrigoqweds90/Proyecto-Robot/CAD/Nuevo/piezas_canales/Bracket08_B_brida.stl

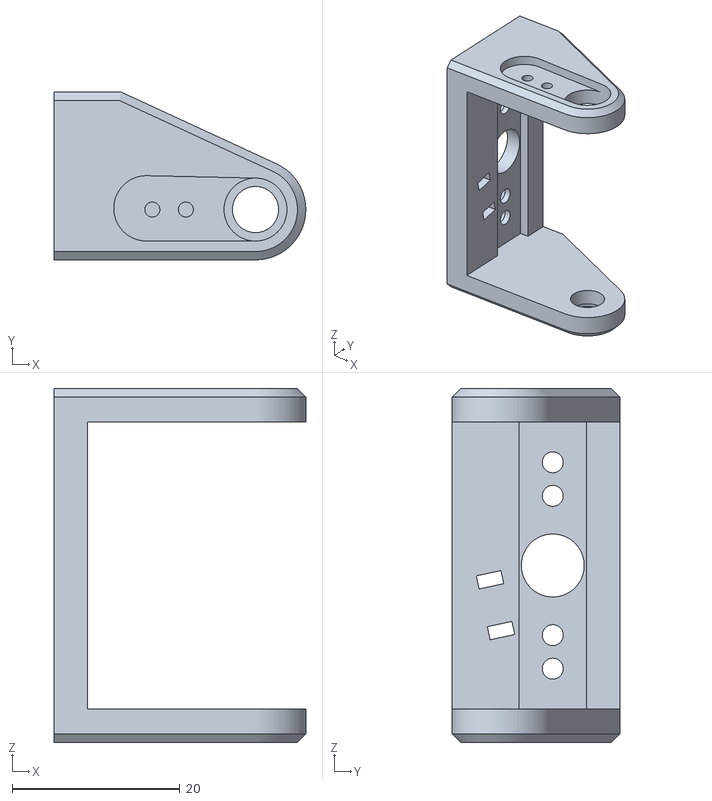
[picture p227: CAD file, 2026-09-30]
CAD/Nuevo/piezas_canales/Bracket08_B_brida.stl
30.0 x 20.0 x 42.2
