rodrigoqweds90/Proyecto-Robot/CAD/Nuevo/piezas_rediseno/Bracket11_B.stl

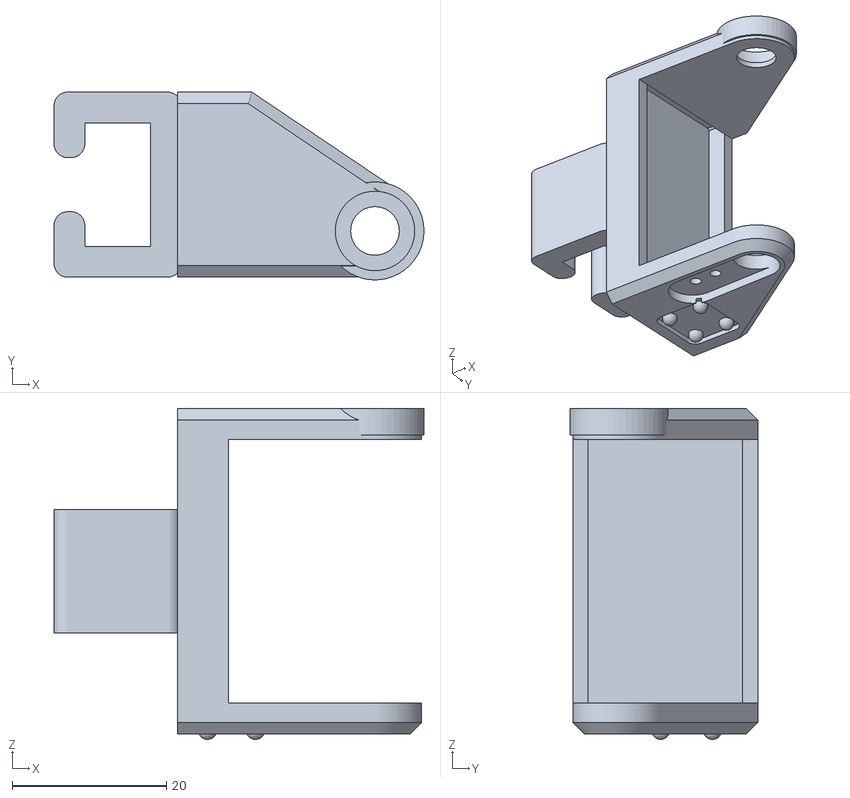
[picture p228: CAD file, 2026-09-30]
CAD/Nuevo/piezas_rediseno/Bracket11_B.stl
48.0 x 24.3 x 42.9
