rodrigoqweds90/Proyecto-Robot/CAD/Nuevo/piezas_soportes/Molde_calibrador_der.stl

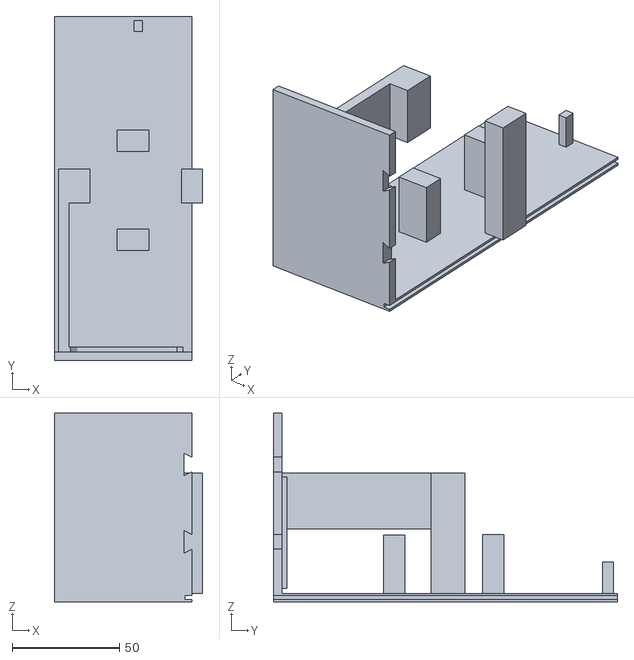
[picture p229: CAD file, 2026-10-19]
CAD/Nuevo/piezas_soportes/Molde_calibrador_der.stl
68.9 x 160.4 x 88.0
