rodrigoqweds90/Proyecto-Robot/CAD/Nuevo/Robot_imprimir_2026-09-17/1_piernas/2x_Bracket01_B.stl

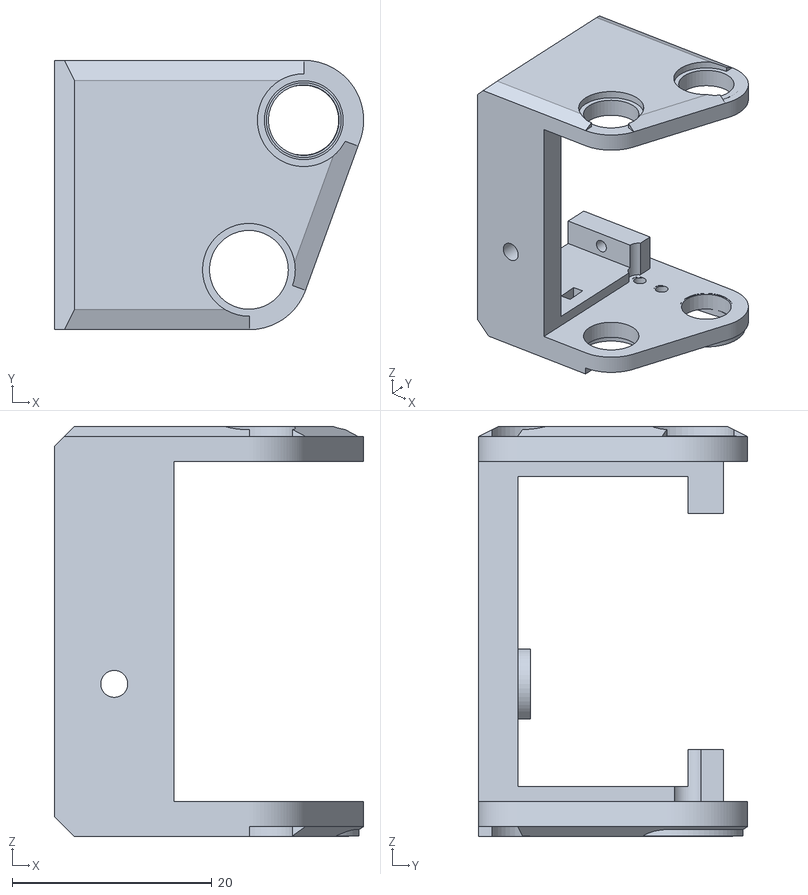
[picture p230: CAD file, 2026-09-30]
CAD/Nuevo/Robot_imprimir_2026-09-17/1_piernas/2x_Bracket01_B.stl
31.0 x 27.0 x 41.1
