rodrigoqweds90/Proyecto-Robot/CAD/Nuevo/Robot_imprimir_2026-09-17/2_cadera_y_torso/1x_Torso_cuerpo.stl

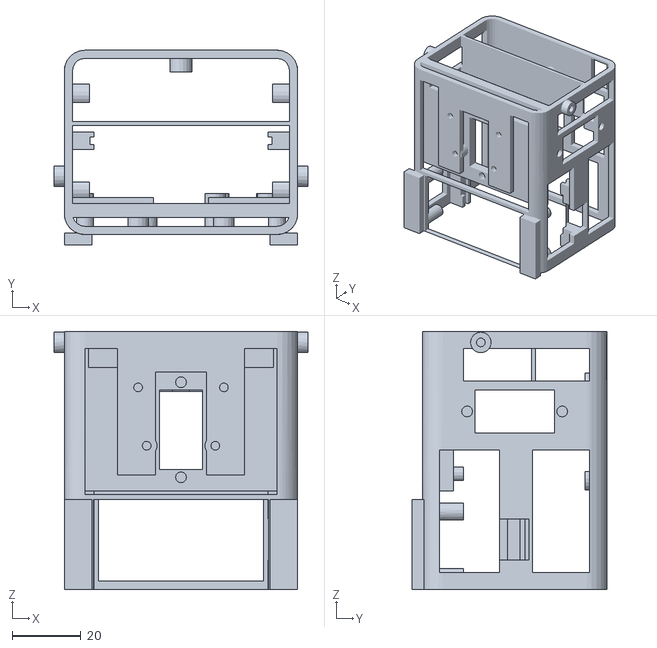
[picture p231: CAD file, 2026-09-30]
CAD/Nuevo/Robot_imprimir_2026-09-17/2_cadera_y_torso/1x_Torso_cuerpo.stl
74.0 x 56.7 x 75.2
