rodrigoqweds90/Proyecto-Robot/CAD/Nuevo/Robot_imprimir_2026-09-17/3_brazos/1x_Bracket10_W.stl

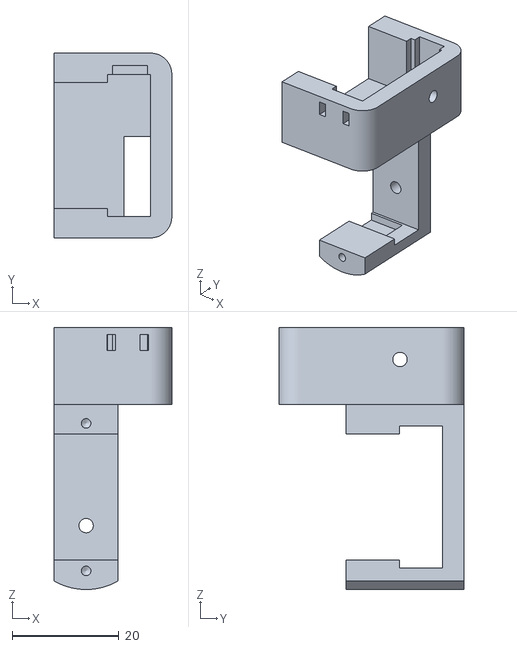
[picture p232: CAD file, 2026-09-30]
CAD/Nuevo/Robot_imprimir_2026-09-17/3_brazos/1x_Bracket10_W.stl
22.1 x 34.7 x 49.2
