rodrigoqweds90/Proyecto-Robot/CAD/Nuevo/Robot_imprimir_2026-09-17/4_cabeza/1x_Cabeza_tapa.stl

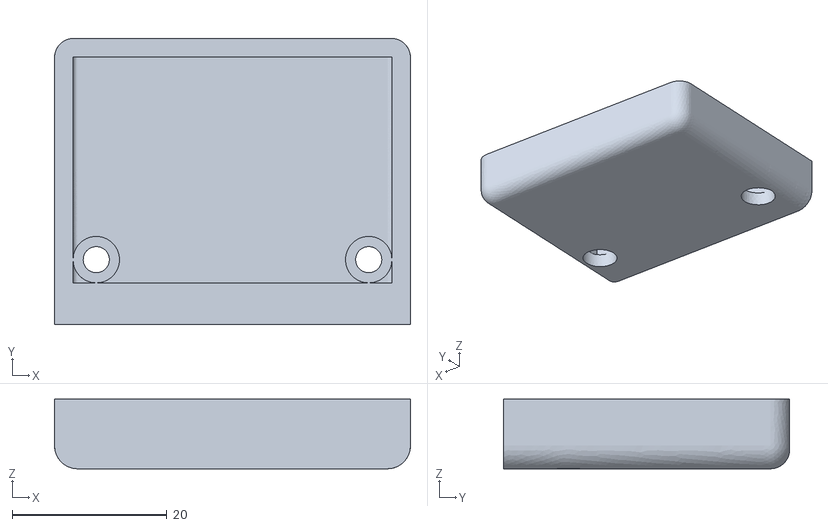
[picture p233: CAD file, 2026-09-30]
CAD/Nuevo/Robot_imprimir_2026-09-17/4_cabeza/1x_Cabeza_tapa.stl
46.0 x 37.0 x 9.00
