rodrigoqweds90/Proyecto-Robot/CAD/Nuevo/Robot_imprimir_2026-09-17/5_pipes/33x_Pipe_M3.stl

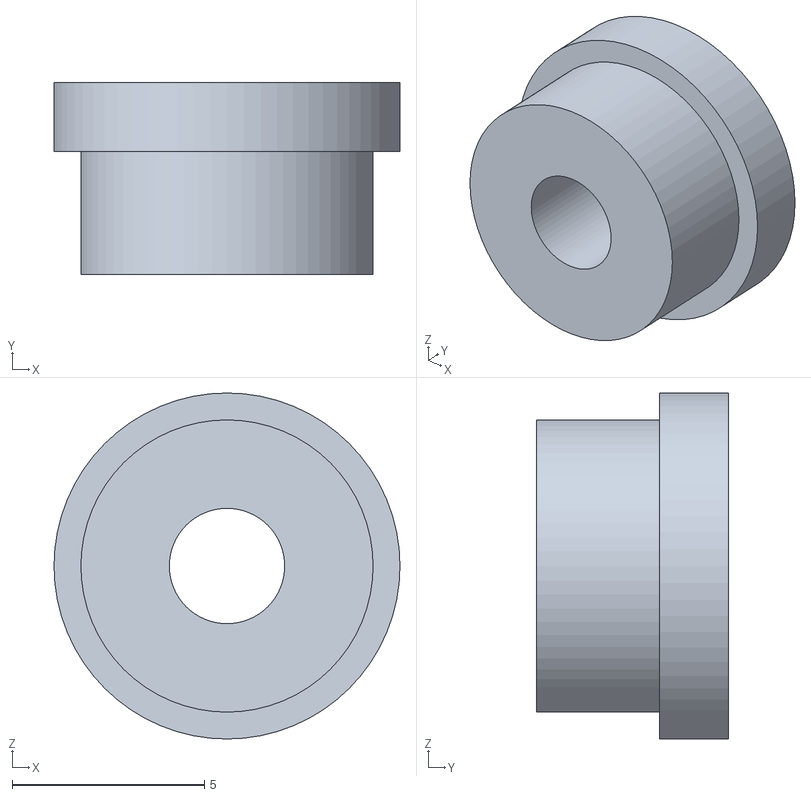
[picture p234: CAD file, 2026-09-30]
CAD/Nuevo/Robot_imprimir_2026-09-17/5_pipes/33x_Pipe_M3.stl
9.00 x 5.00 x 9.00
