rodrigoqweds90/Proyecto-Robot/CAD/Nuevo/step/Torso_barra_bateria.stp

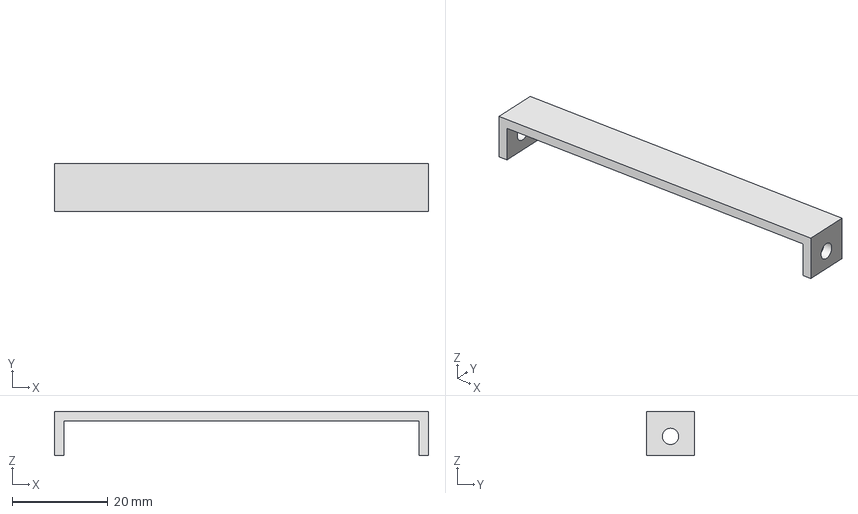
[picture p235: CAD file, 2026-09-30]
CAD/Nuevo/step/Torso_barra_bateria.stp
78.0 x 10.0 x 9.20 mm
