rodrigoqweds90/Proyecto-Robot/CAD/Nuevo/stl/ESP32_real.stl

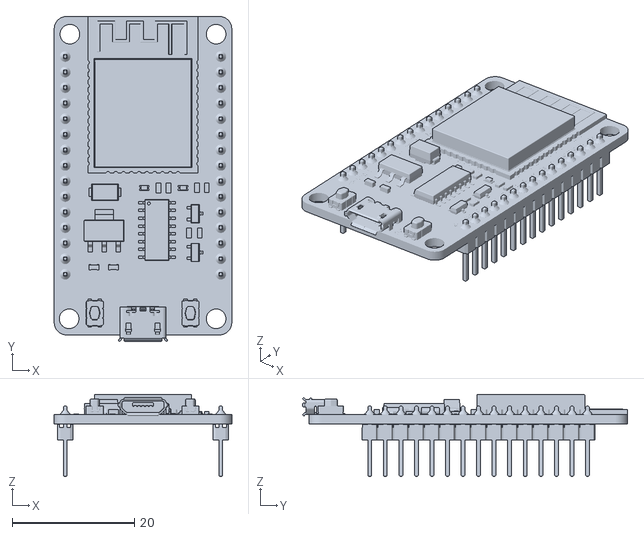
[picture p236: CAD file, 2026-09-30]
CAD/Nuevo/stl/ESP32_real.stl
29.0 x 53.1 x 13.4
