rodrigoqweds90/Proyecto-Robot/CAD/Nuevo/stl_con_canales/Bracket09_W.stl

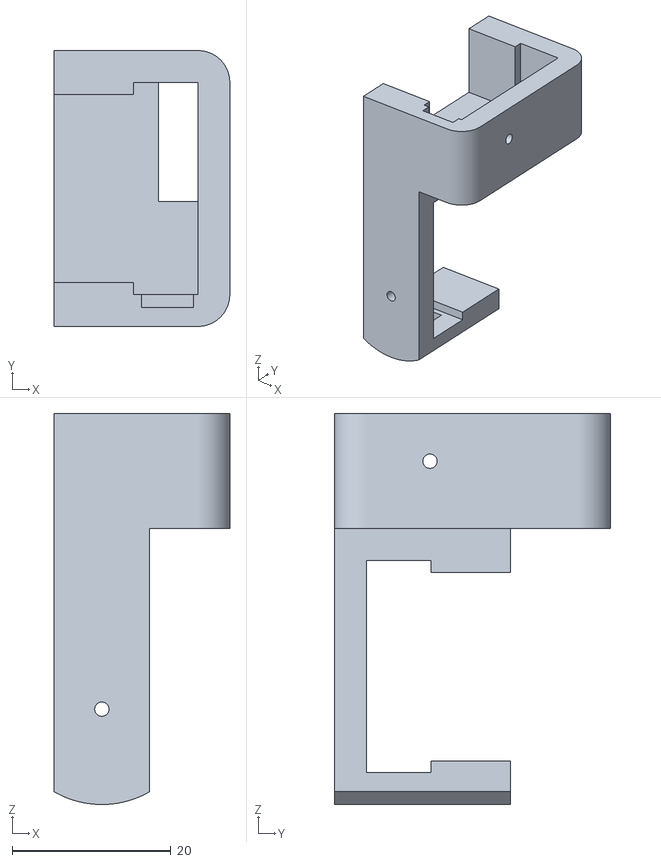
[picture p237: CAD file, 2026-09-30]
CAD/Nuevo/stl_con_canales/Bracket09_W.stl
22.1 x 34.7 x 49.2
