rodrigoqweds90/Proyecto-Robot/CAD/NX25_original/stl/UpperCover_Plate.stl

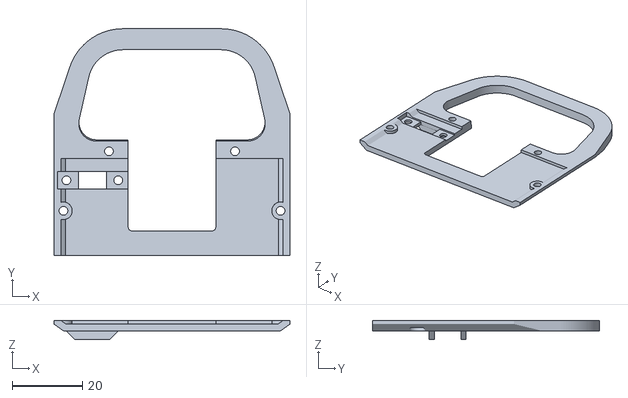
[picture p238: CAD file, 2026-09-30]
CAD/NX25_original/stl/UpperCover_Plate.stl
67.4 x 64.7 x 5.50
