rodrigoqweds90/Proyecto-Robot/CAD/Robot2/piezas/R2_canilla_izq.stl

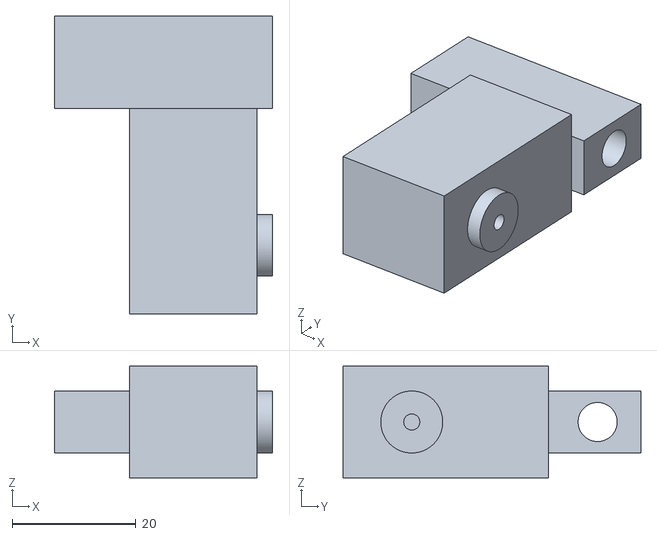
[picture p239: CAD file, 2026-10-19]
CAD/Robot2/piezas/R2_canilla_izq.stl
35.2 x 48.1 x 18.0
