rodrigoqweds90/Proyecto-Robot/CAD/Robot2/revision/R2_pie_der.stl

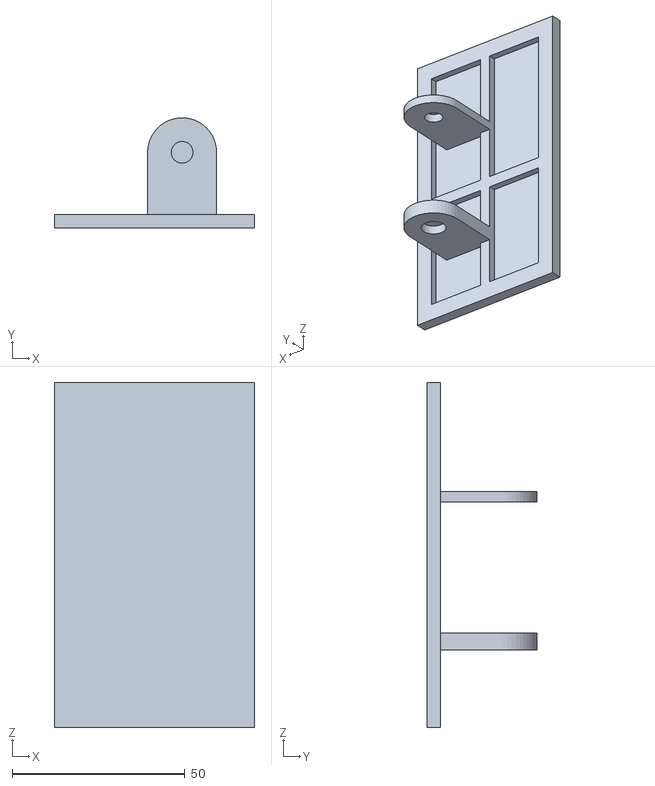
[picture p240: CAD file, 2026-10-19]
CAD/Robot2/revision/R2_pie_der.stl
58.0 x 32.0 x 100.0
