rodrigoqweds90/Proyecto-Robot/CAD/Nuevo/fea/aligeradas/Bracket04_B.stl

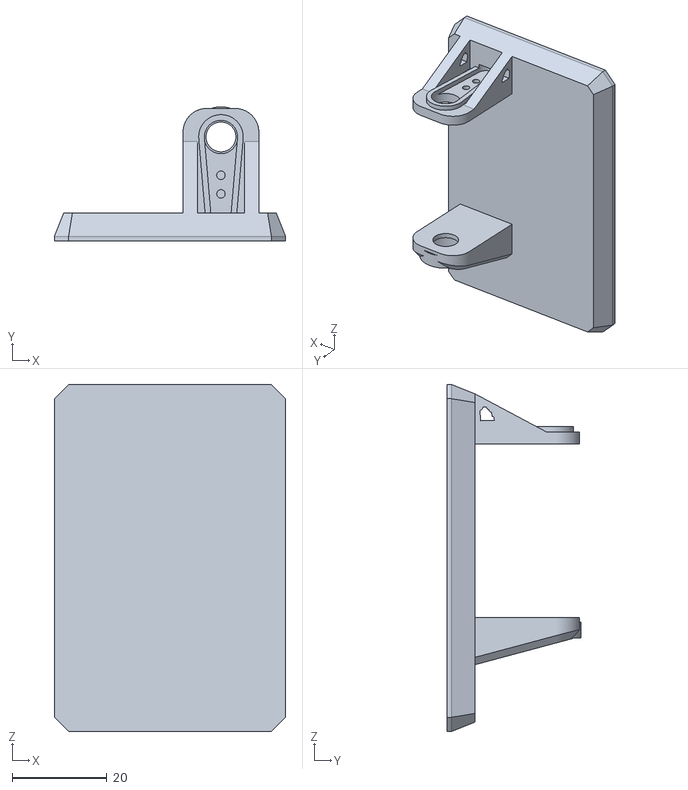
[picture p241: CAD file, 2026-09-30]
CAD/Nuevo/fea/aligeradas/Bracket04_B.stl
48.8 x 28.4 x 73.2
