rodrigoqweds90/Proyecto-Robot/CAD/Nuevo/mio_centrado.stl

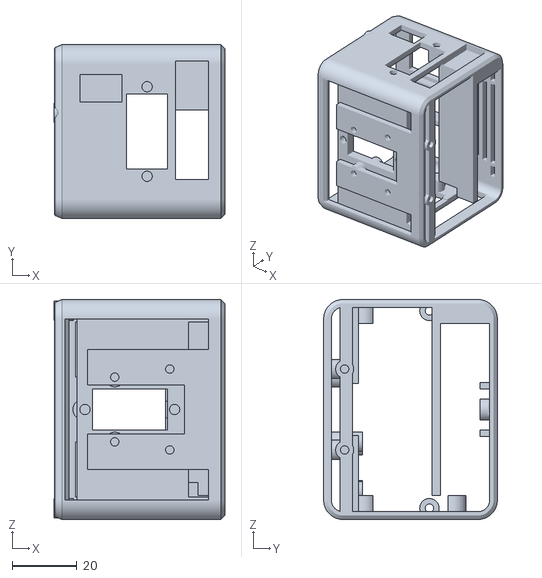
[picture p243: CAD file, 2026-09-30]
CAD/Nuevo/mio_centrado.stl
52.7 x 53.7 x 68.0
