rodrigoqweds90/Proyecto-Robot/CAD/Nuevo/para_imprimir/Torso_espalda.stl

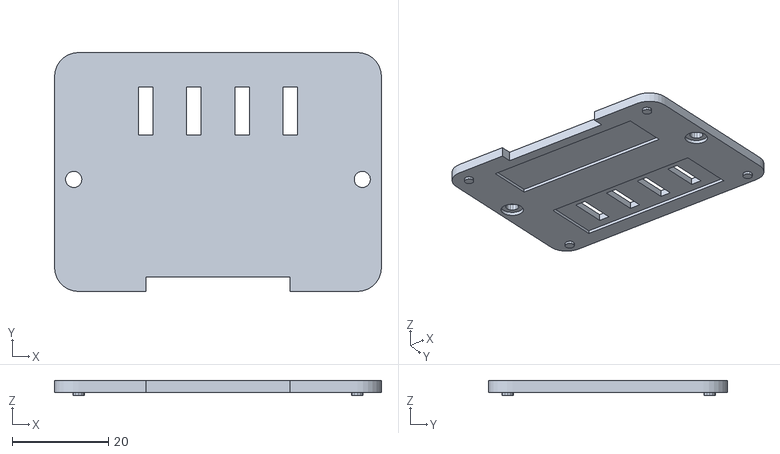
[picture p244: CAD file, 2026-09-30]
CAD/Nuevo/para_imprimir/Torso_espalda.stl
68.0 x 49.7 x 3.20
