rodrigoqweds90/Proyecto-Robot/CAD/Nuevo/piezas_boceto/_Cabeza_tapa_0.stl

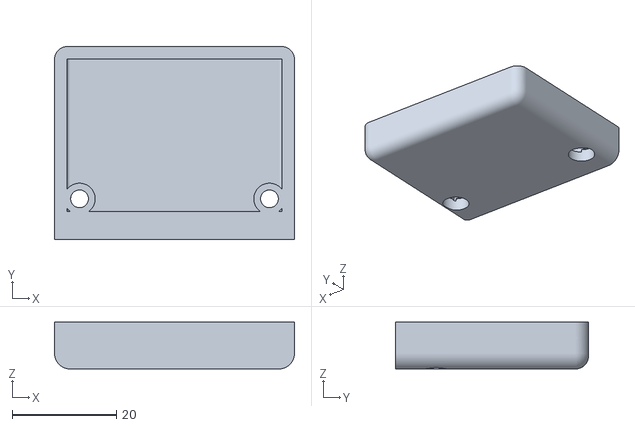
[picture p245: CAD file, 2026-09-30]
CAD/Nuevo/piezas_boceto/_Cabeza_tapa_0.stl
46.0 x 37.0 x 9.00
