rodrigoqweds90/Proyecto-Robot/CAD/Nuevo/piezas_canales/Bracket02_W_brida.stl

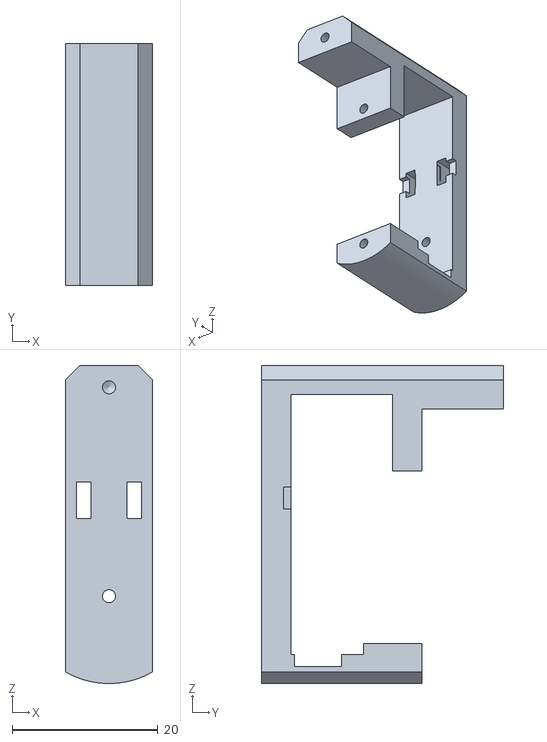
[picture p246: CAD file, 2026-09-30]
CAD/Nuevo/piezas_canales/Bracket02_W_brida.stl
12.0 x 33.2 x 43.7
