rodrigoqweds90/Proyecto-Robot/CAD/Nuevo/piezas_soportes/Molde_calibrador.stl

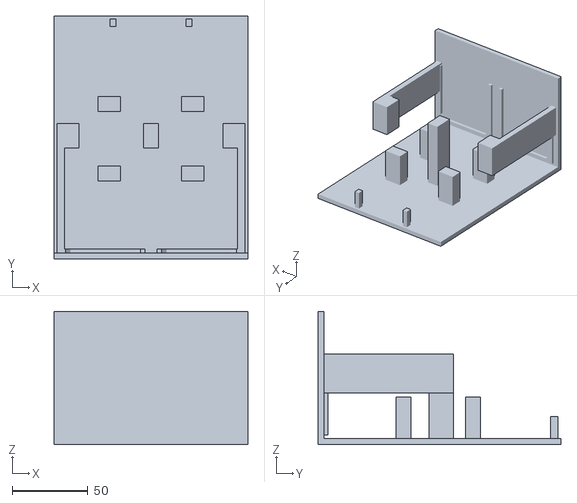
[picture p247: CAD file, 2026-10-19]
CAD/Nuevo/piezas_soportes/Molde_calibrador.stl
128.0 x 160.4 x 88.0
