rodrigoqweds90/Proyecto-Robot/CAD/Nuevo/Robot_imprimir_2026-09-17/2_cadera_y_torso/1x_Spacer01_W.stl

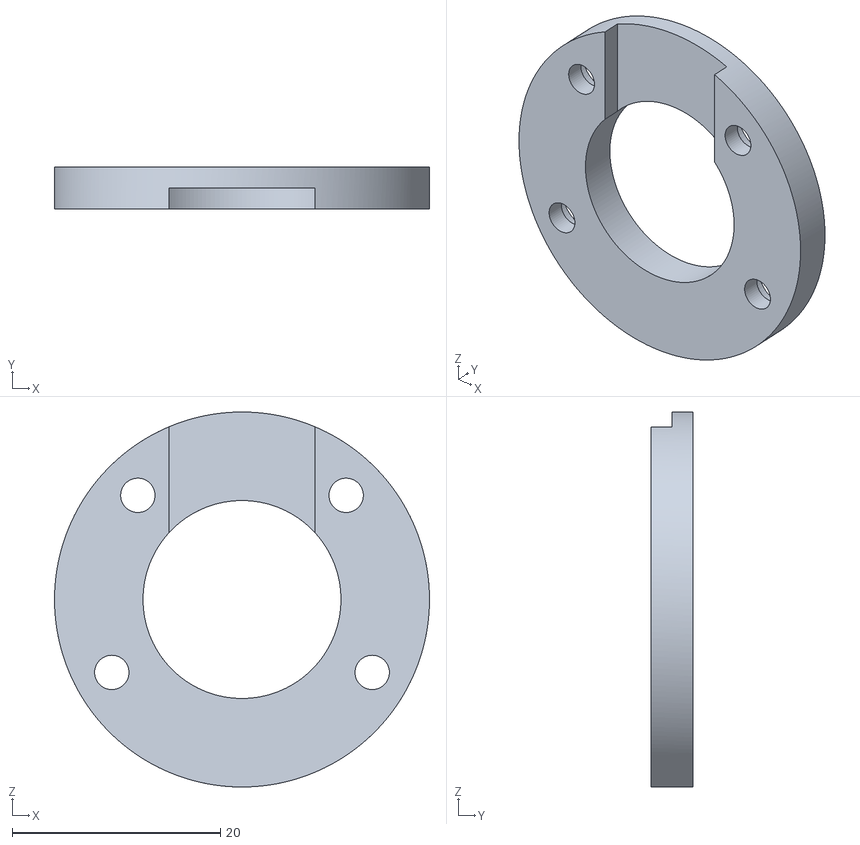
[picture p248: CAD file, 2026-09-30]
CAD/Nuevo/Robot_imprimir_2026-09-17/2_cadera_y_torso/1x_Spacer01_W.stl
36.0 x 4.00 x 36.0
