rodrigoqweds90/Proyecto-Robot/CAD/Nuevo/Robot_imprimir_2026-09-17/3_brazos/1x_Bracket11_B.stl

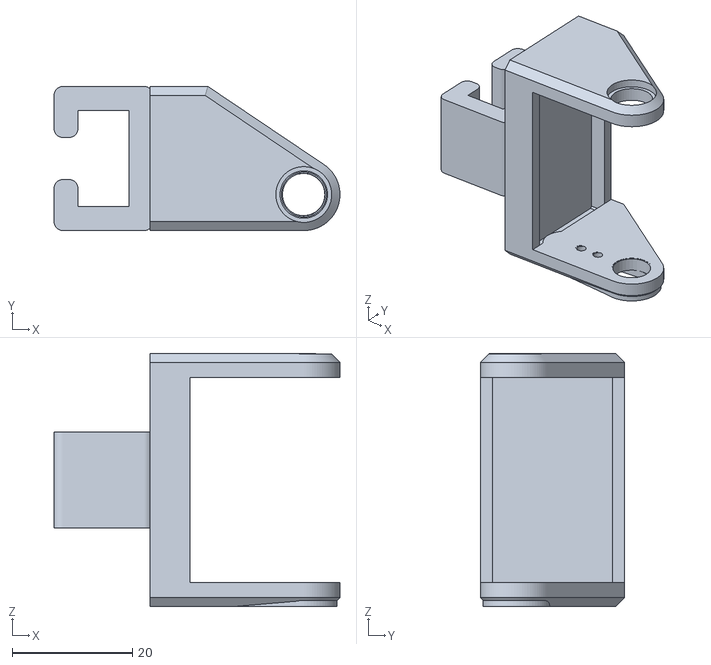
[picture p249: CAD file, 2026-09-30]
CAD/Nuevo/Robot_imprimir_2026-09-17/3_brazos/1x_Bracket11_B.stl
47.6 x 24.0 x 42.2
