rodrigoqweds90/Proyecto-Robot/CAD/Nuevo/Robot_imprimir_2026-09-17/4_cabeza/1x_Cabeza_frente.stl

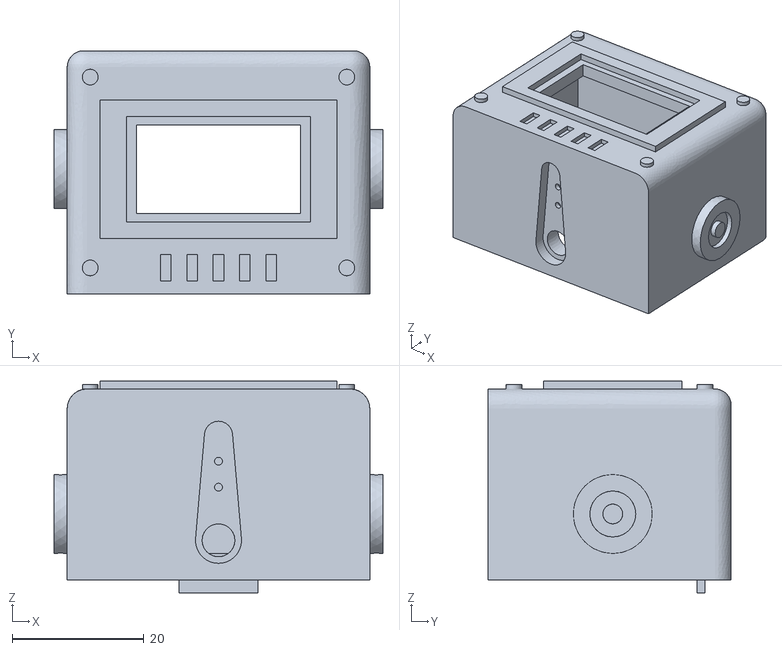
[picture p250: CAD file, 2026-09-30]
CAD/Nuevo/Robot_imprimir_2026-09-17/4_cabeza/1x_Cabeza_frente.stl
50.0 x 37.0 x 32.2
