rodrigoqweds90/Proyecto-Robot/CAD/Nuevo/step/Pelvis.stp

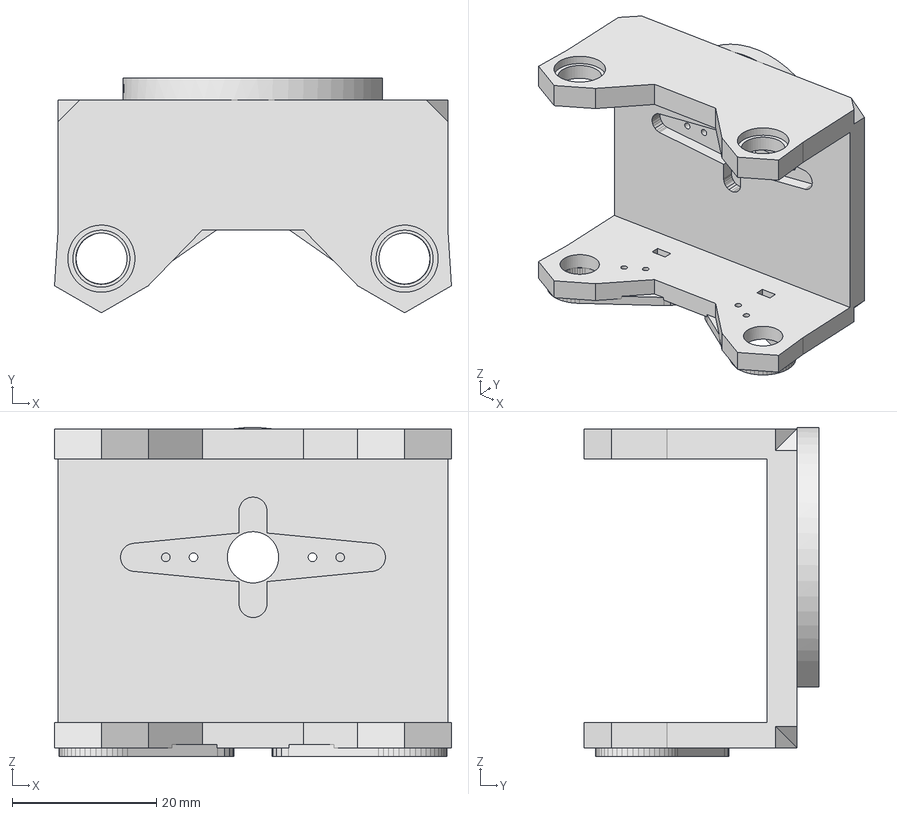
[picture p251: CAD file, 2026-09-30]
CAD/Nuevo/step/Pelvis.stp
55.0 x 32.5 x 45.6 mm
