rodrigoqweds90/Proyecto-Robot/CAD/Nuevo/stl/Torso_atras_B.stl

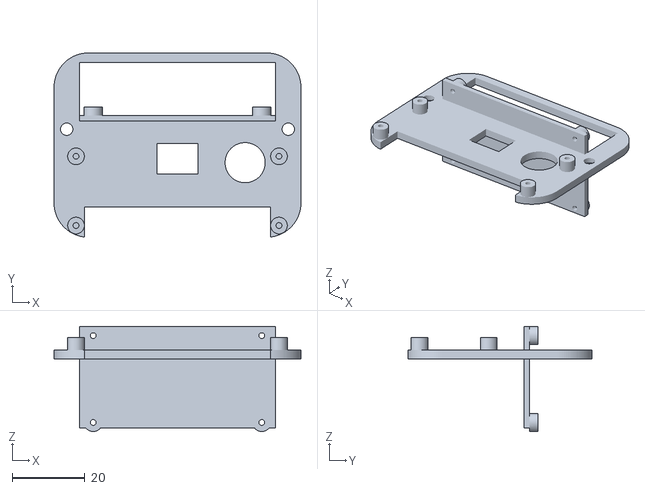
[picture p252: CAD file, 2026-09-30]
CAD/Nuevo/stl/Torso_atras_B.stl
68.0 x 50.7 x 28.9
