rodrigoqweds90/Proyecto-Robot/CAD/Robot2/piezas/R2_canilla_link_der.stl

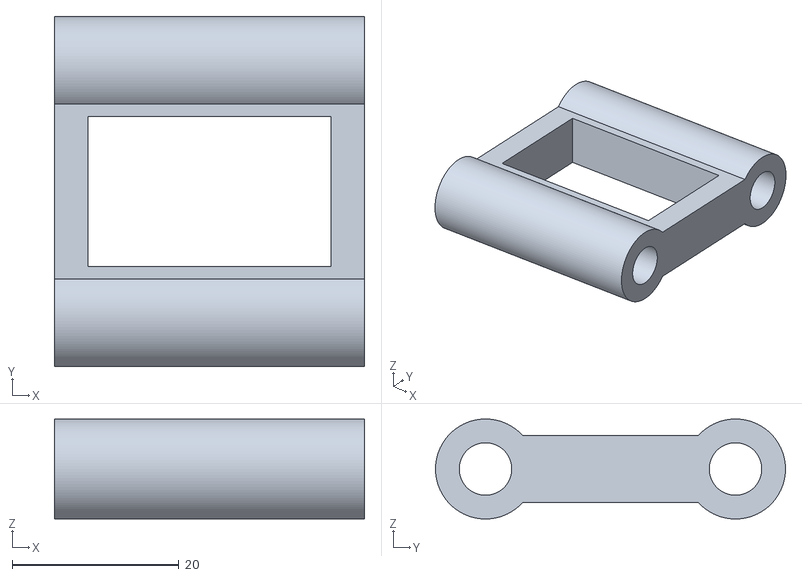
[picture p253: CAD file, 2026-10-19]
CAD/Robot2/piezas/R2_canilla_link_der.stl
37.2 x 42.0 x 12.0
