rodrigoqweds90/Proyecto-Robot/CAD/Robot2/revision/R2_tobillo_izq.stl

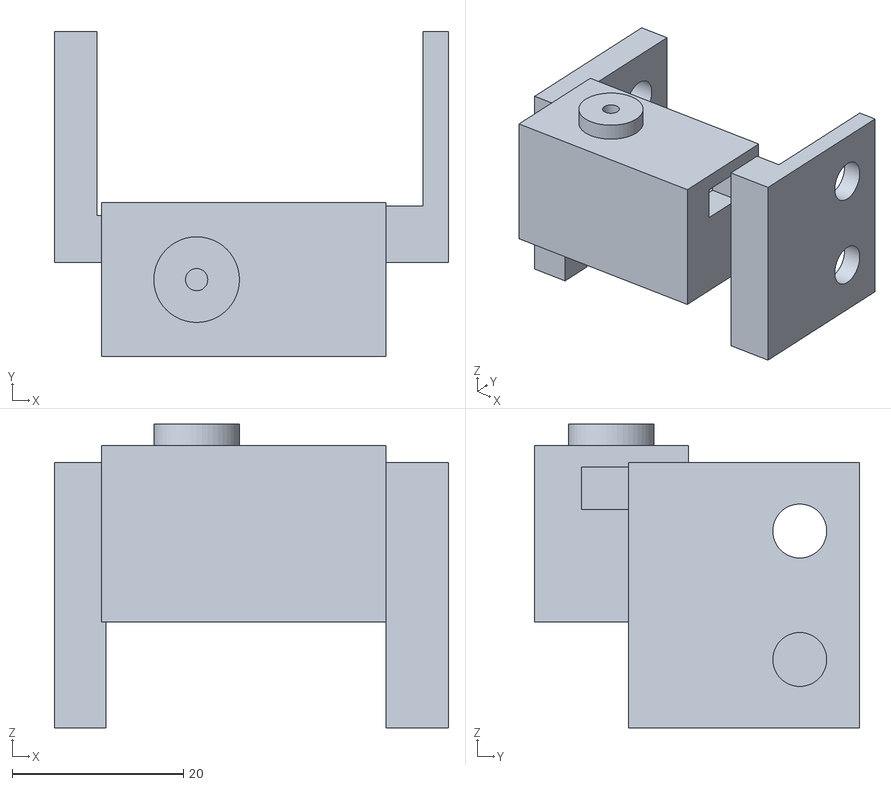
[picture p254: CAD file, 2026-10-19]
CAD/Robot2/revision/R2_tobillo_izq.stl
46.0 x 38.0 x 35.5
