rodrigoqweds90/Proyecto-Robot/CAD/Componentes/MG90S_horn_cruz.SLDPRT

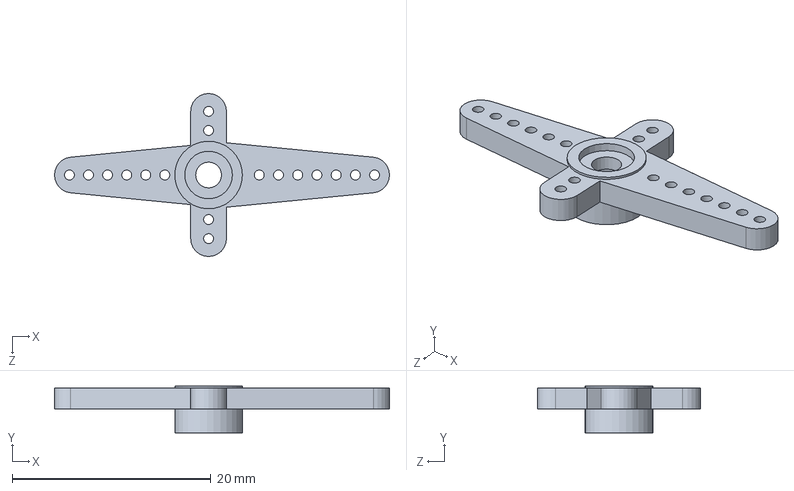
[picture p255: CAD file, 2026-09-30]
CAD/Componentes/MG90S_horn_cruz.SLDPRT
33.7 x 4.70 x 16.4 mm
