rodrigoqweds90/Proyecto-Robot/CAD/Nuevo/fea/aligeradas/Bracket08_B.stl

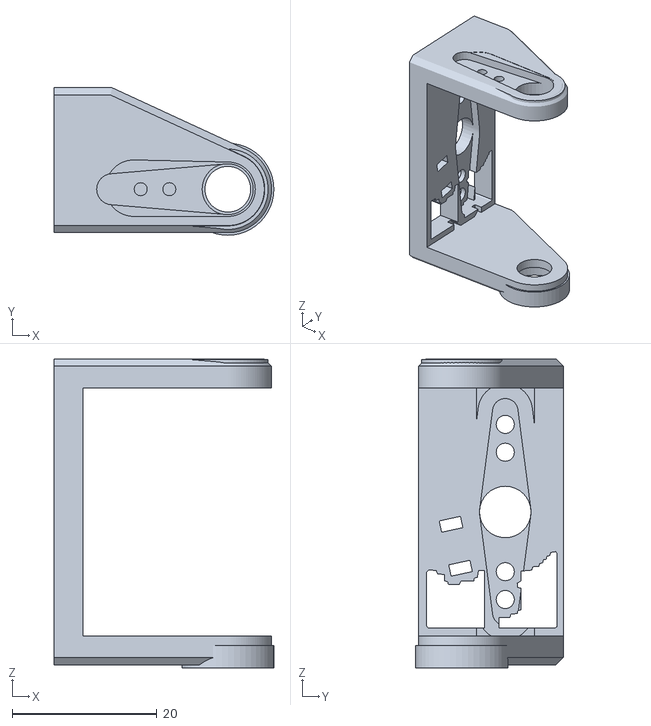
[picture p256: CAD file, 2026-09-30]
CAD/Nuevo/fea/aligeradas/Bracket08_B.stl
30.3 x 20.3 x 42.6
