rodrigoqweds90/Proyecto-Robot/CAD/Nuevo/fea/aligeradas_sin_filtro/Bracket01_B.stl

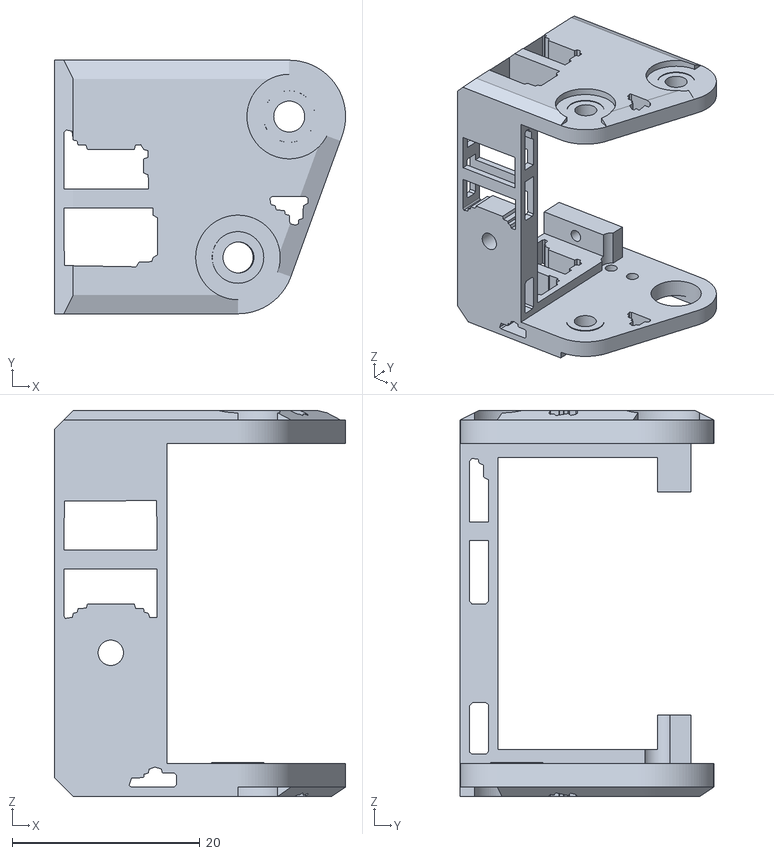
[picture p257: CAD file, 2026-09-30]
CAD/Nuevo/fea/aligeradas_sin_filtro/Bracket01_B.stl
31.0 x 27.0 x 41.1
