rodrigoqweds90/Proyecto-Robot/CAD/Nuevo/fea/tmp_espejo_28988.stl

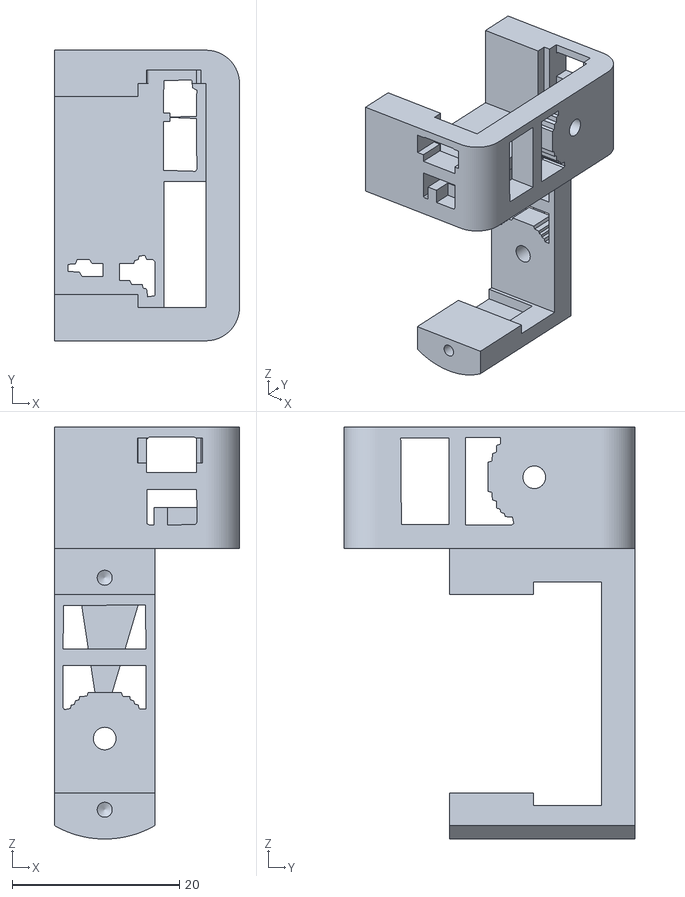
[picture p258: CAD file, 2026-09-30]
CAD/Nuevo/fea/tmp_espejo_28988.stl
22.1 x 34.7 x 49.2
