rodrigoqweds90/Proyecto-Robot/CAD/Nuevo/piezas_estilo/Nee_B.stl

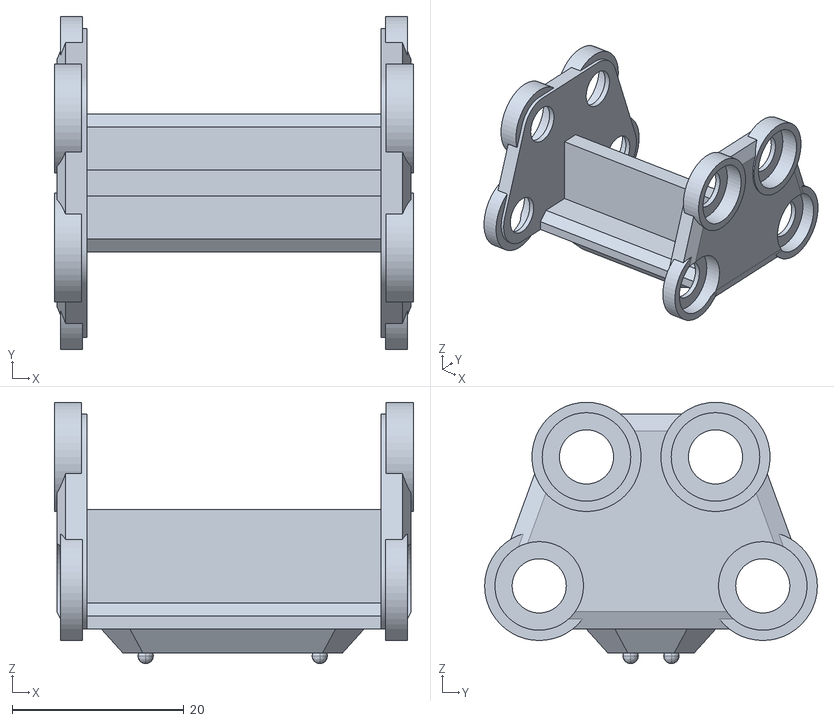
[picture p259: CAD file, 2026-09-30]
CAD/Nuevo/piezas_estilo/Nee_B.stl
41.7 x 38.7 x 30.4
