rodrigoqweds90/Proyecto-Robot/CAD/Nuevo/piezas_m3/Pipe_M3.stl

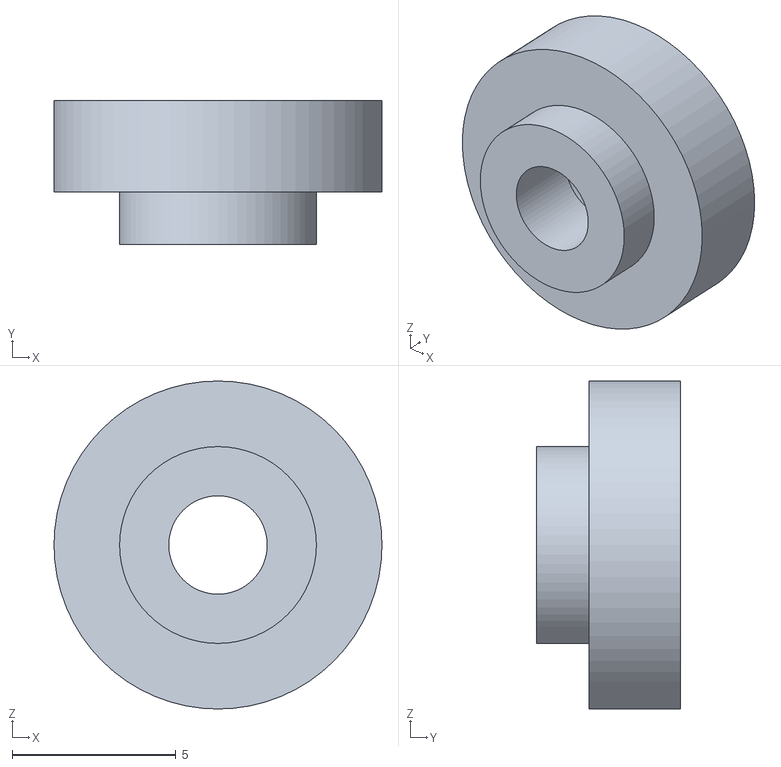
[picture p260: CAD file, 2026-09-30]
CAD/Nuevo/piezas_m3/Pipe_M3.stl
10.0 x 4.40 x 10.0
