rodrigoqweds90/Proyecto-Robot/CAD/Nuevo/piezas_soportes/Molde_calibrador_izq.stl

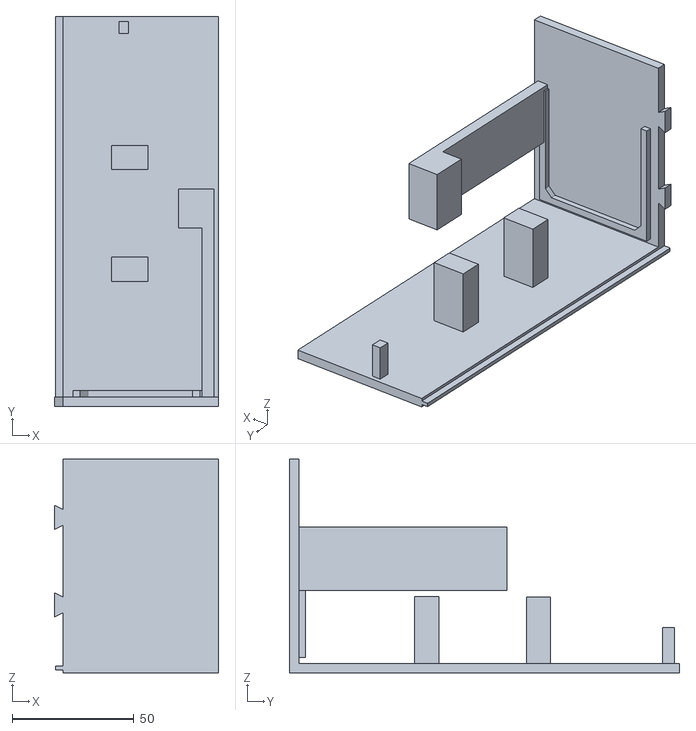
[picture p261: CAD file, 2026-10-19]
CAD/Nuevo/piezas_soportes/Molde_calibrador_izq.stl
67.5 x 160.4 x 88.0
