rodrigoqweds90/Proyecto-Robot/CAD/Nuevo/Robot_imprimir_2026-09-17/3_brazos/1x_Bracket08_B.stl

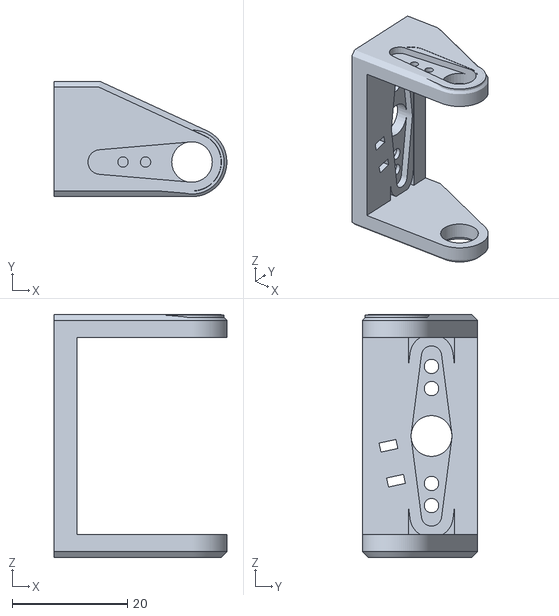
[picture p262: CAD file, 2026-09-30]
CAD/Nuevo/Robot_imprimir_2026-09-17/3_brazos/1x_Bracket08_B.stl
30.0 x 20.0 x 42.2
