rodrigoqweds90/Proyecto-Robot/CAD/Nuevo/stl/Torso_protector_B.stl

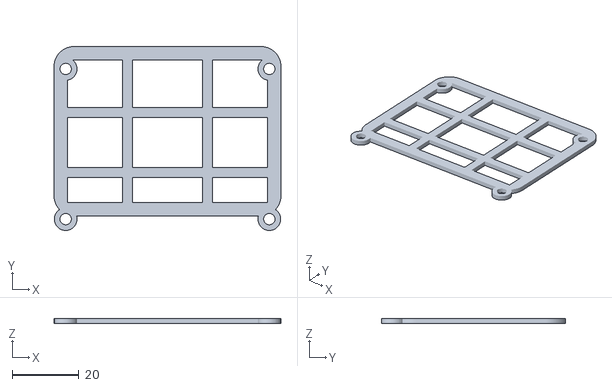
[picture p263: CAD file, 2026-09-30]
CAD/Nuevo/stl/Torso_protector_B.stl
68.0 x 55.1 x 1.60
