rodrigoqweds90/Proyecto-Robot/CAD/Nuevo/suyo_alineado_final.stl

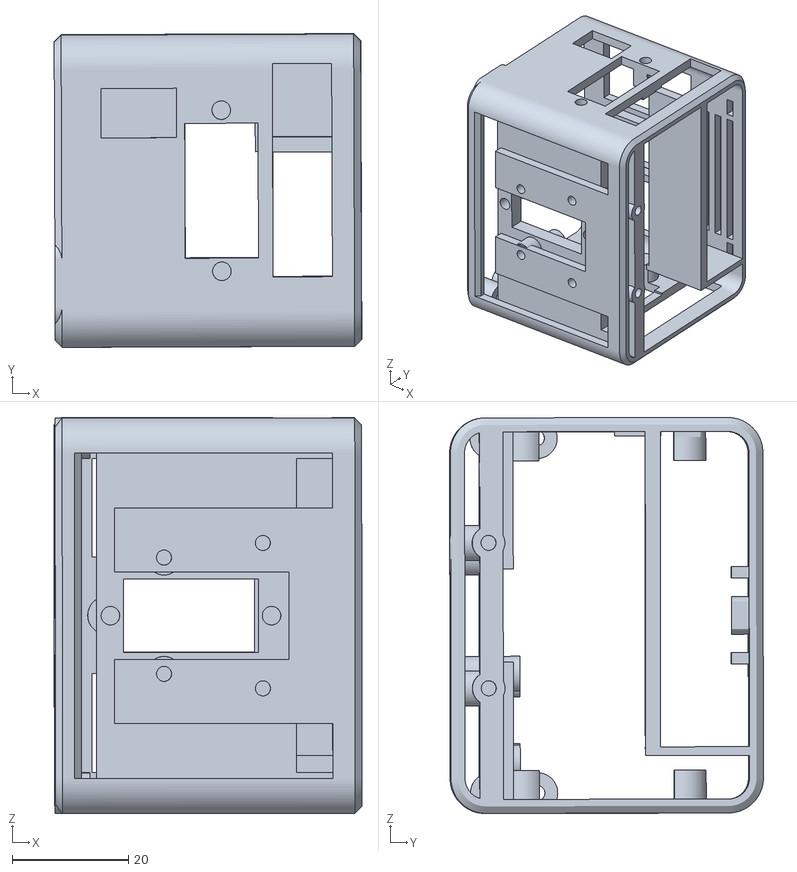
[picture p264: CAD file, 2026-09-30]
CAD/Nuevo/suyo_alineado_final.stl
52.9 x 54.0 x 68.1
