rodrigoqweds90/Proyecto-Robot/CAD/Robot2/piezas/R2_rodilla_izq.stl

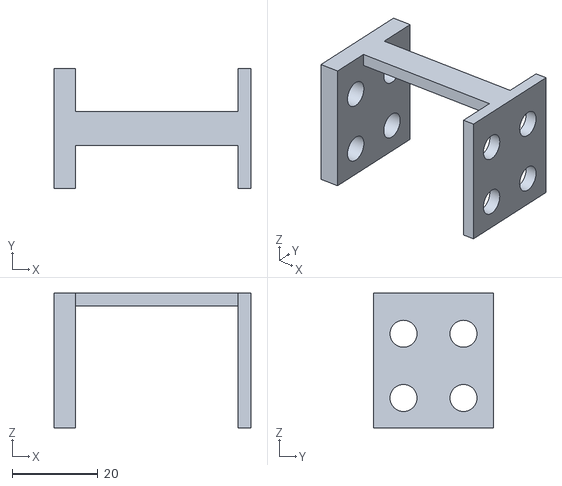
[picture p265: CAD file, 2026-10-19]
CAD/Robot2/piezas/R2_rodilla_izq.stl
46.0 x 28.0 x 31.5
