rodrigoqweds90/Proyecto-Robot/CAD/Robot2/revision/R2_cadera_izq.stl

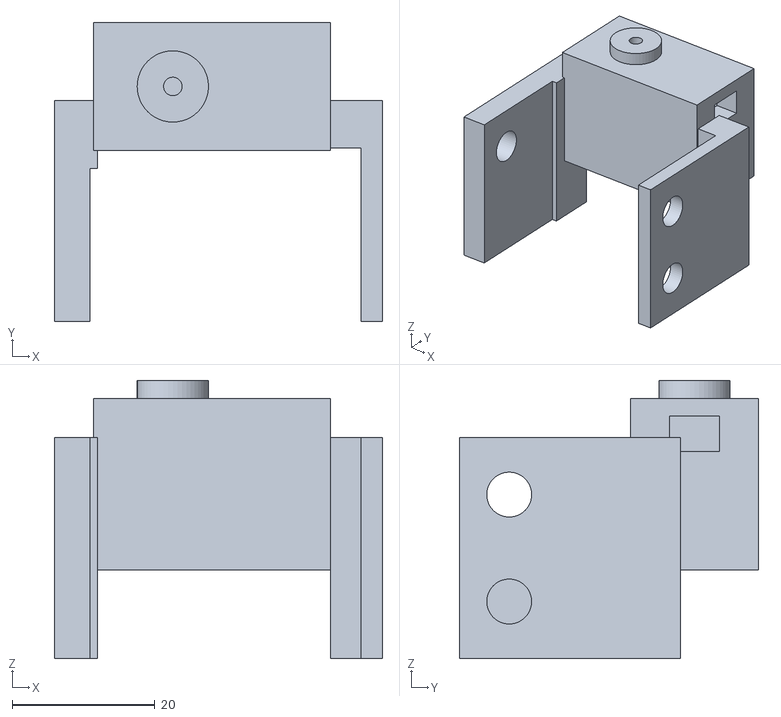
[picture p266: CAD file, 2026-10-19]
CAD/Robot2/revision/R2_cadera_izq.stl
46.0 x 42.0 x 39.0
