rodrigoqweds90/Proyecto-Robot/CAD/Componentes/MG90S_horn_doble.SLDPRT

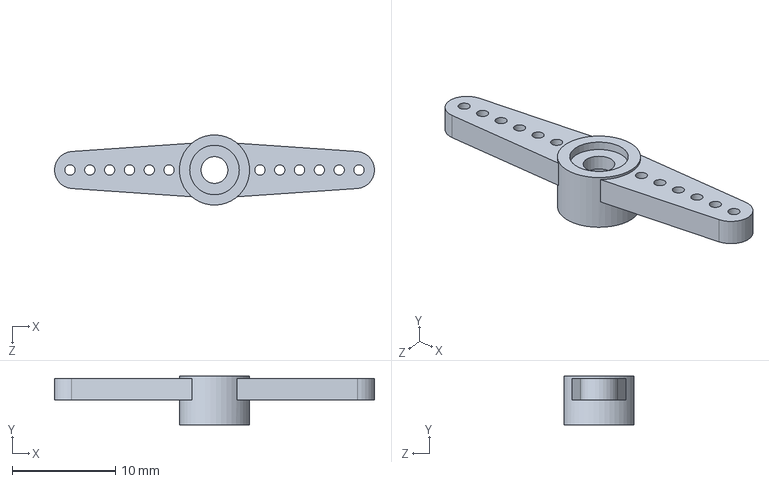
[picture p267: CAD file, 2026-09-30]
CAD/Componentes/MG90S_horn_doble.SLDPRT
31.0 x 4.70 x 6.80 mm
