rodrigoqweds90/Proyecto-Robot/CAD/Nuevo/fea/aligeradas/Link_W.stl

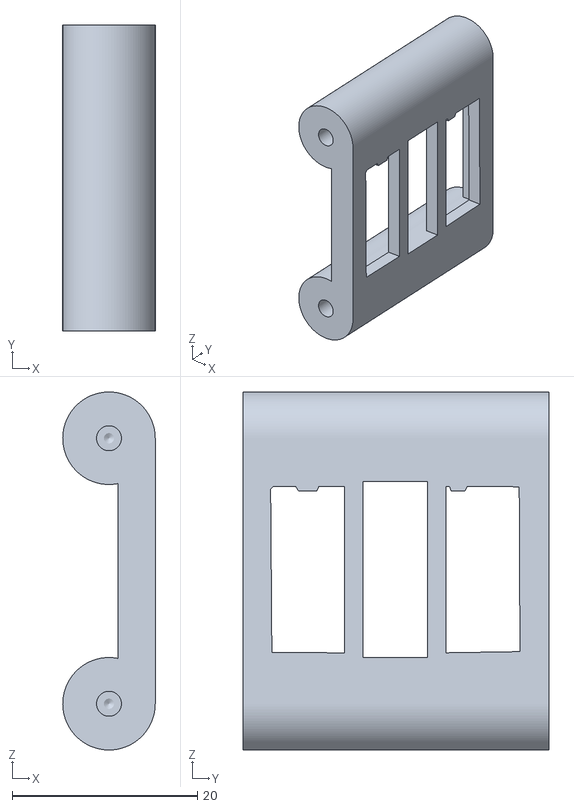
[picture p268: CAD file, 2026-09-30]
CAD/Nuevo/fea/aligeradas/Link_W.stl
10.00 x 33.1 x 38.7
