rodrigoqweds90/Proyecto-Robot/CAD/Nuevo/fea/tmp_aligerada.stl

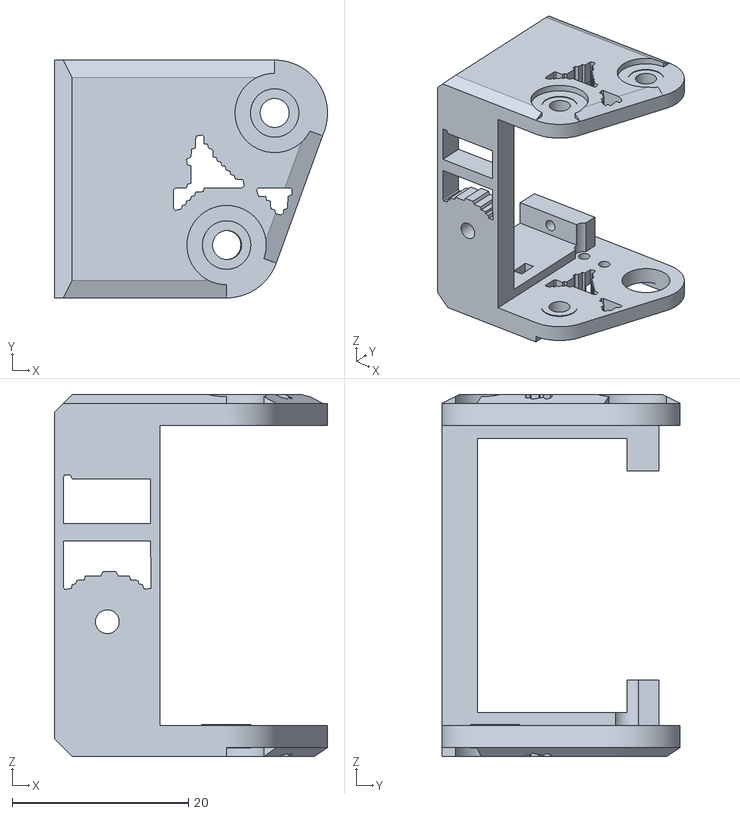
[picture p270: CAD file, 2026-09-30]
CAD/Nuevo/fea/tmp_aligerada.stl
31.0 x 27.0 x 41.1
