rodrigoqweds90/Proyecto-Robot/CAD/Nuevo/imprimir_B/Bracket02_W.stl

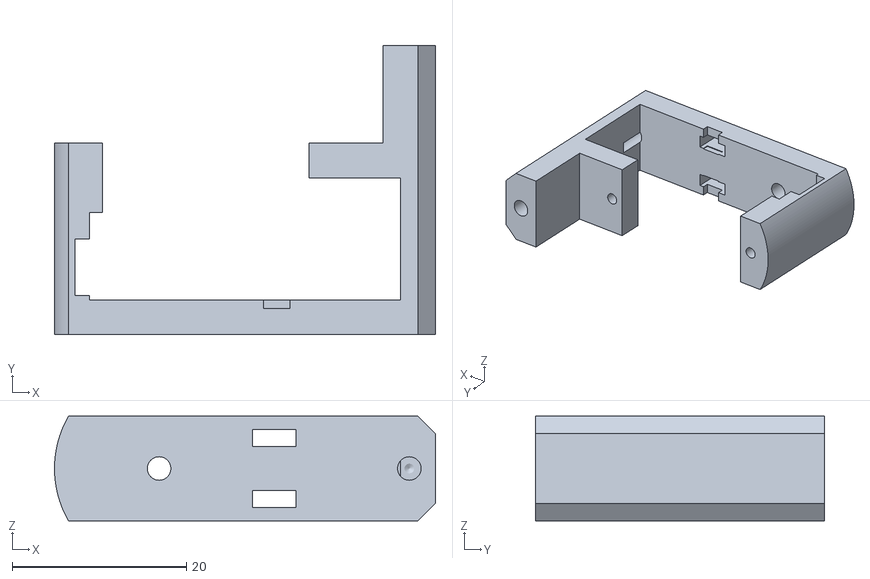
[picture p271: CAD file, 2026-09-30]
CAD/Nuevo/imprimir_B/Bracket02_W.stl
43.7 x 33.2 x 12.0
