rodrigoqweds90/Proyecto-Robot/CAD/Nuevo/para_imprimir/sin_aligerar/Bracket01_B.stl

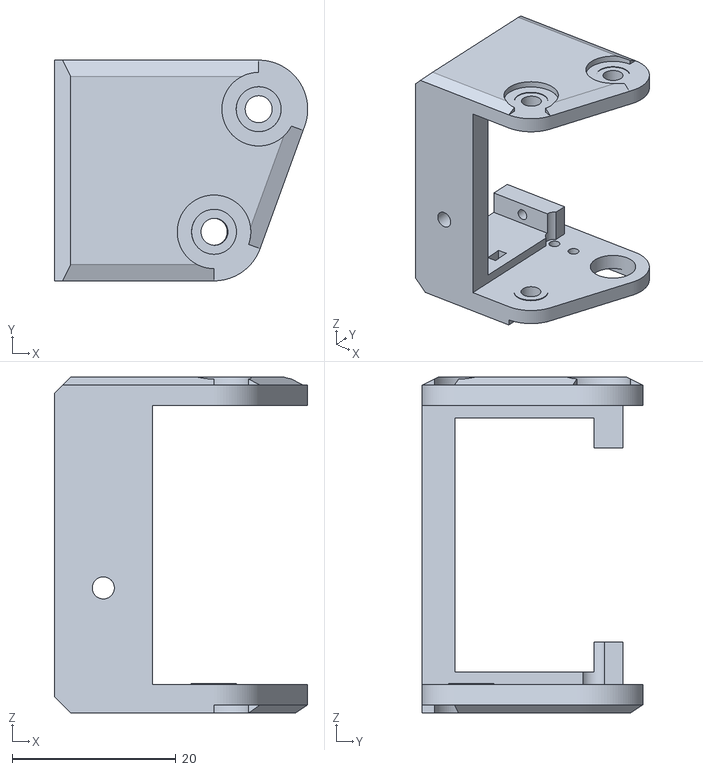
[picture p272: CAD file, 2026-09-30]
CAD/Nuevo/para_imprimir/sin_aligerar/Bracket01_B.stl
31.0 x 27.0 x 41.1
