rodrigoqweds90/Proyecto-Robot/CAD/Nuevo/piezas_boceto/_pca.stl

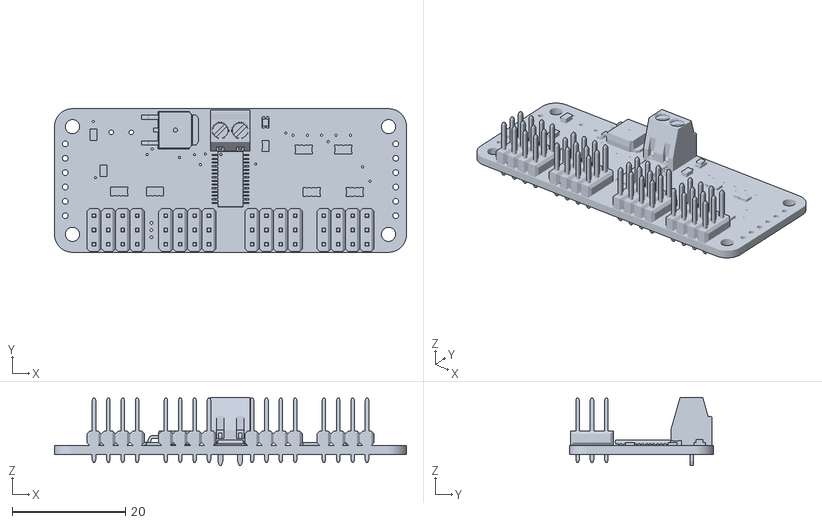
[picture p273: CAD file, 2026-09-30]
CAD/Nuevo/piezas_boceto/_pca.stl
62.2 x 25.4 x 12.1
