rodrigoqweds90/Proyecto-Robot/CAD/Nuevo/piezas_m3/Bracket01_B.stl

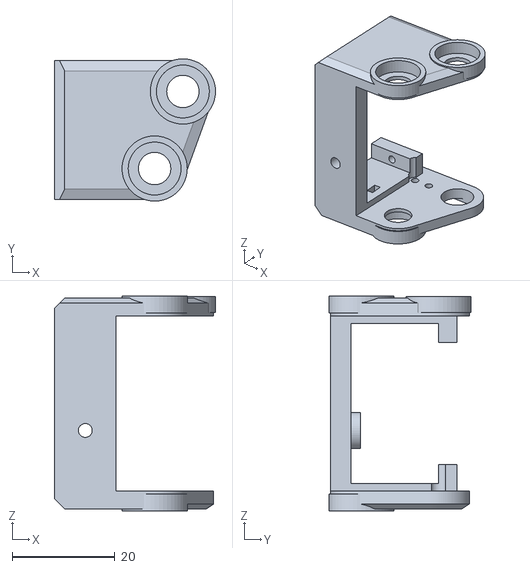
[picture p274: CAD file, 2026-09-30]
CAD/Nuevo/piezas_m3/Bracket01_B.stl
31.4 x 27.7 x 41.8
