rodrigoqweds90/Proyecto-Robot/CAD/Nuevo/piezas_soportes/Soporte_pierna_izq.stl

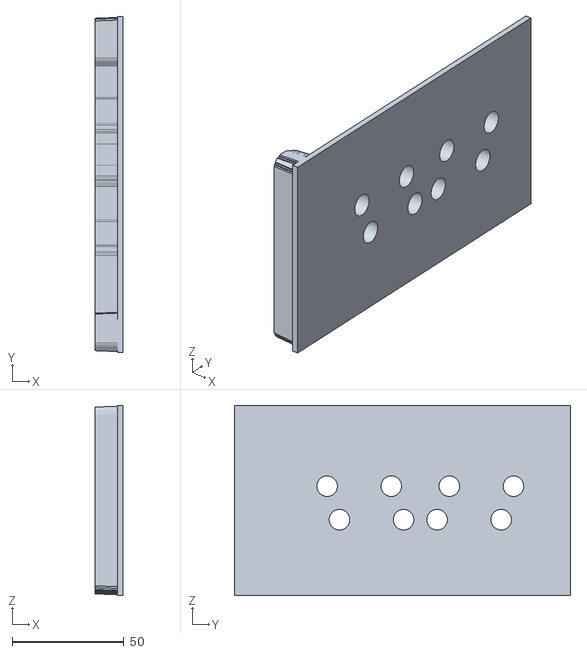
[picture p275: CAD file, 2026-09-30]
CAD/Nuevo/piezas_soportes/Soporte_pierna_izq.stl
12.5 x 150.4 x 85.2
