rodrigoqweds90/Proyecto-Robot/CAD/Nuevo/Robot_imprimir_2026-09-17/2_cadera_y_torso/1x_Torso_pecho.stl

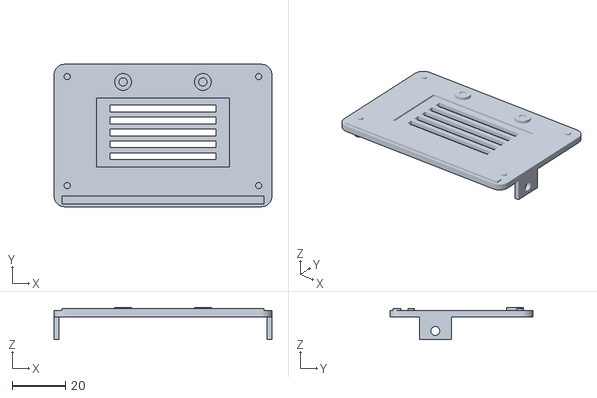
[picture p276: CAD file, 2026-09-30]
CAD/Nuevo/Robot_imprimir_2026-09-17/2_cadera_y_torso/1x_Torso_pecho.stl
82.0 x 53.7 x 12.2
