rodrigoqweds90/Proyecto-Robot/CAD/Nuevo/suyo_alineado_icp.stl

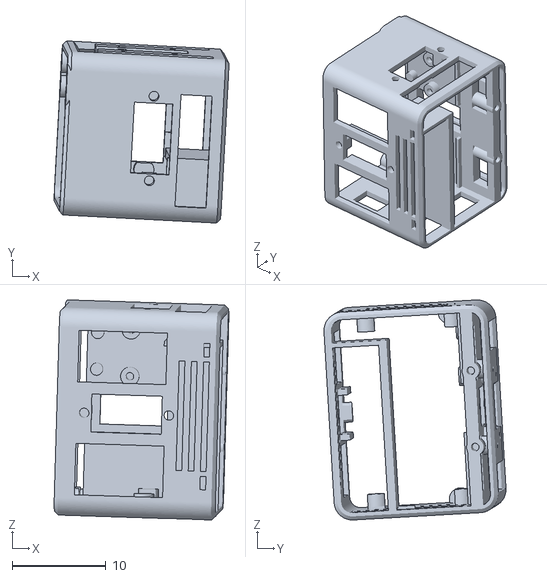
[picture p277: CAD file, 2026-09-30]
CAD/Nuevo/suyo_alineado_icp.stl
18.6 x 19.4 x 23.4
