rodrigoqweds90/Proyecto-Robot/CAD/Robot2/revision/R2_antebrazo_der.stl

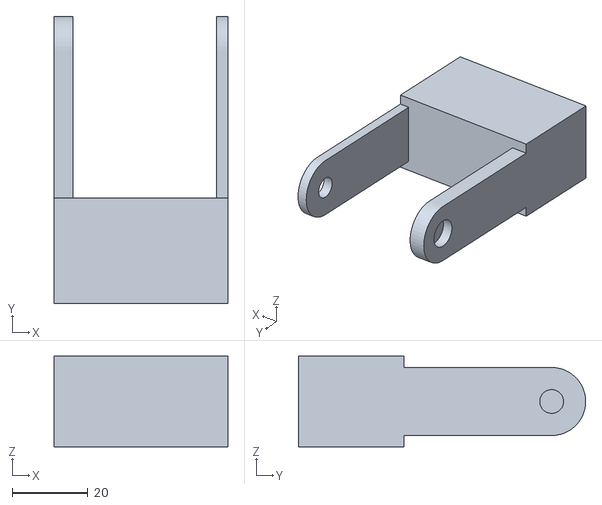
[picture p278: CAD file, 2026-10-19]
CAD/Robot2/revision/R2_antebrazo_der.stl
46.0 x 76.0 x 24.0
