rodrigoqweds90/Proyecto-Robot/CAD/Nuevo/fea/aligeradas/Bracket12_B.stl

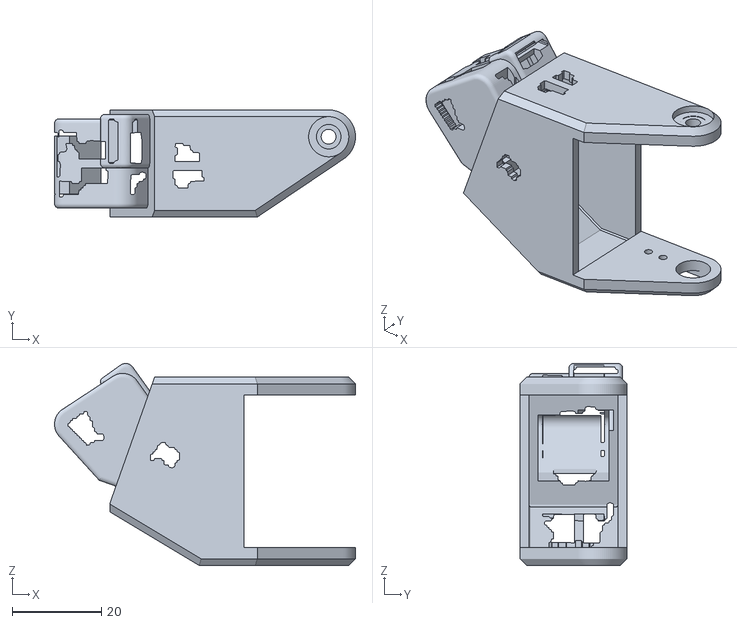
[picture p279: CAD file, 2026-09-30]
CAD/Nuevo/fea/aligeradas/Bracket12_B.stl
67.4 x 24.0 x 45.3
