rodrigoqweds90/Proyecto-Robot/CAD/Nuevo/fea/tmp_aligerada_24836.stl

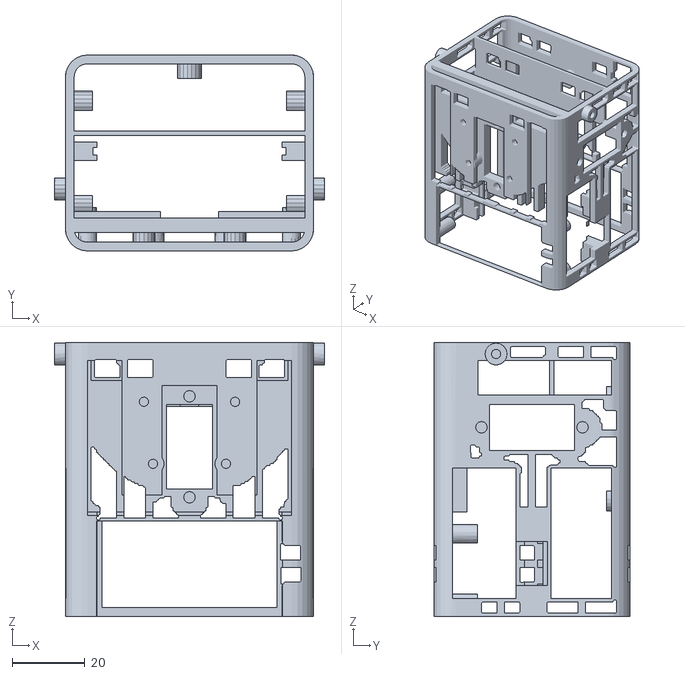
[picture p280: CAD file, 2026-09-30]
CAD/Nuevo/fea/tmp_aligerada_24836.stl
74.0 x 53.7 x 75.2
