rodrigoqweds90/Proyecto-Robot/CAD/Nuevo/para_imprimir/Torso_atras_B.stl

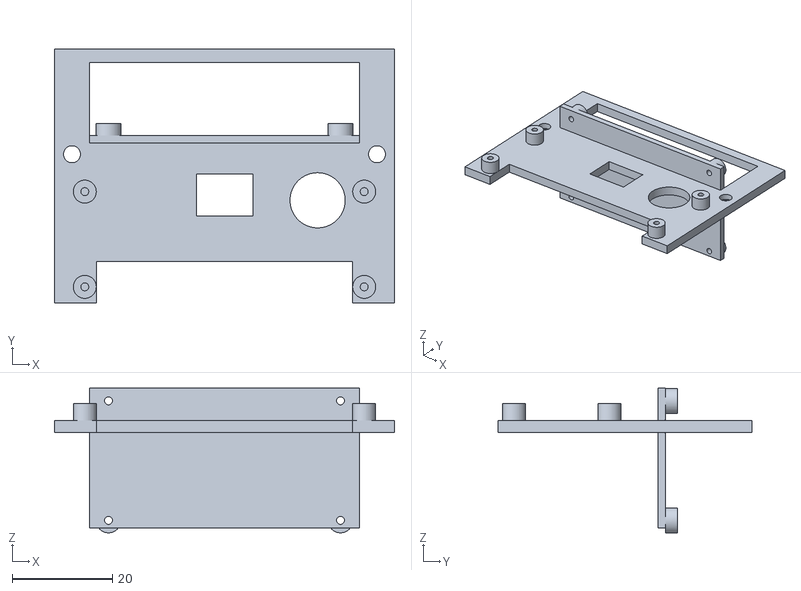
[picture p281: CAD file, 2026-09-30]
CAD/Nuevo/para_imprimir/Torso_atras_B.stl
68.0 x 50.7 x 28.9
