rodrigoqweds90/Proyecto-Robot/CAD/Nuevo/piezas_boceto/Estilo1_facetado.stl

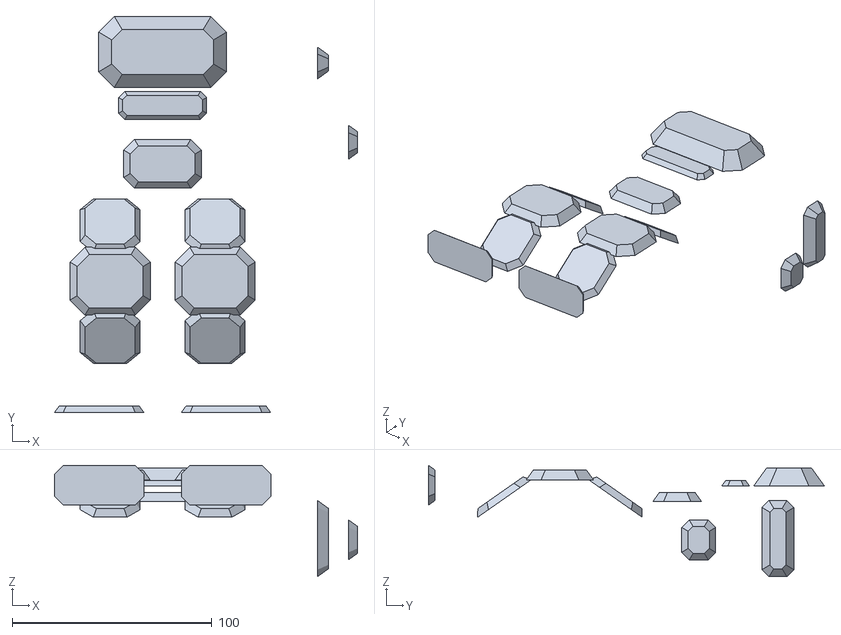
[picture p282: CAD file, 2026-09-30]
CAD/Nuevo/piezas_boceto/Estilo1_facetado.stl
151.8 x 198.3 x 55.8
