rodrigoqweds90/Proyecto-Robot/CAD/Nuevo/piezas_estilo/Link_W.stl

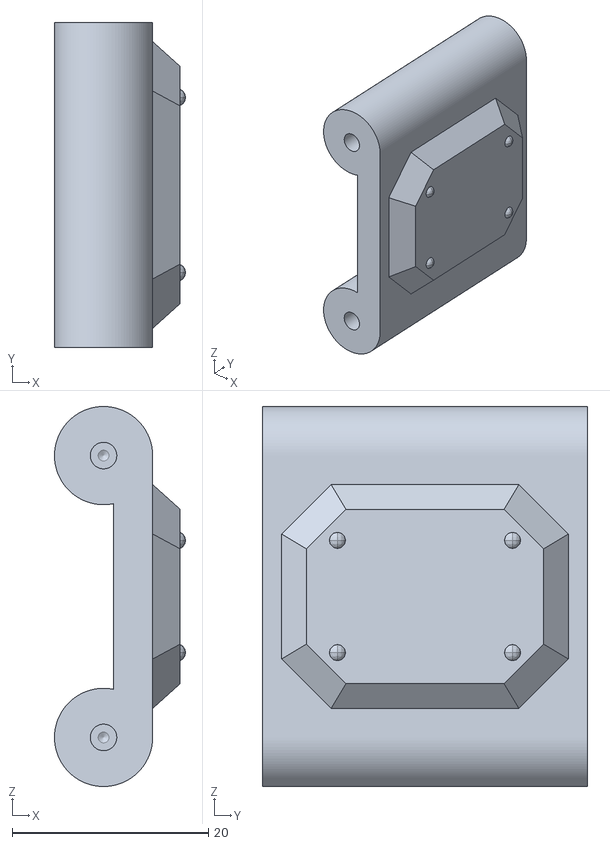
[picture p283: CAD file, 2026-09-30]
CAD/Nuevo/piezas_estilo/Link_W.stl
13.3 x 33.1 x 38.7
