rodrigoqweds90/Proyecto-Robot/CAD/Nuevo/piezas_soportes/Soporte_parado.stl

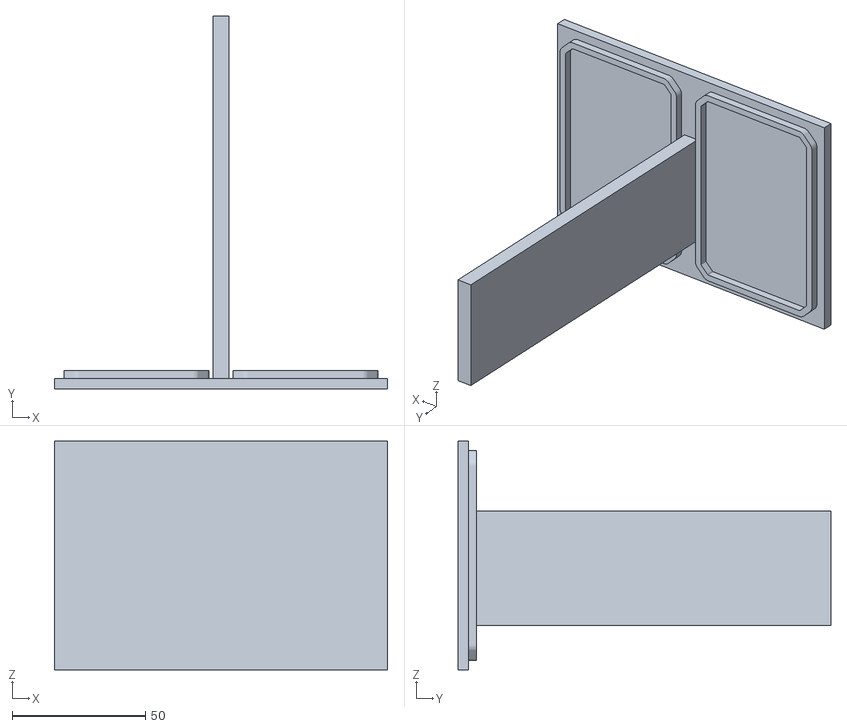
[picture p284: CAD file, 2026-09-30]
CAD/Nuevo/piezas_soportes/Soporte_parado.stl
125.1 x 140.1 x 86.0
