rodrigoqweds90/Proyecto-Robot/CAD/Robot2/revision/R2_pelvis.stl

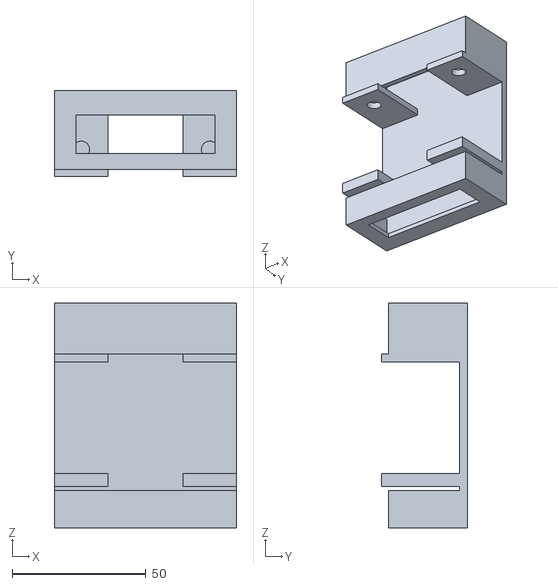
[picture p285: CAD file, 2026-10-19]
CAD/Robot2/revision/R2_pelvis.stl
68.0 x 32.0 x 84.0
