rodrigoqweds90/Proyecto-Robot/CAD/Nuevo/imprimir_B/Bracket07_B.stl

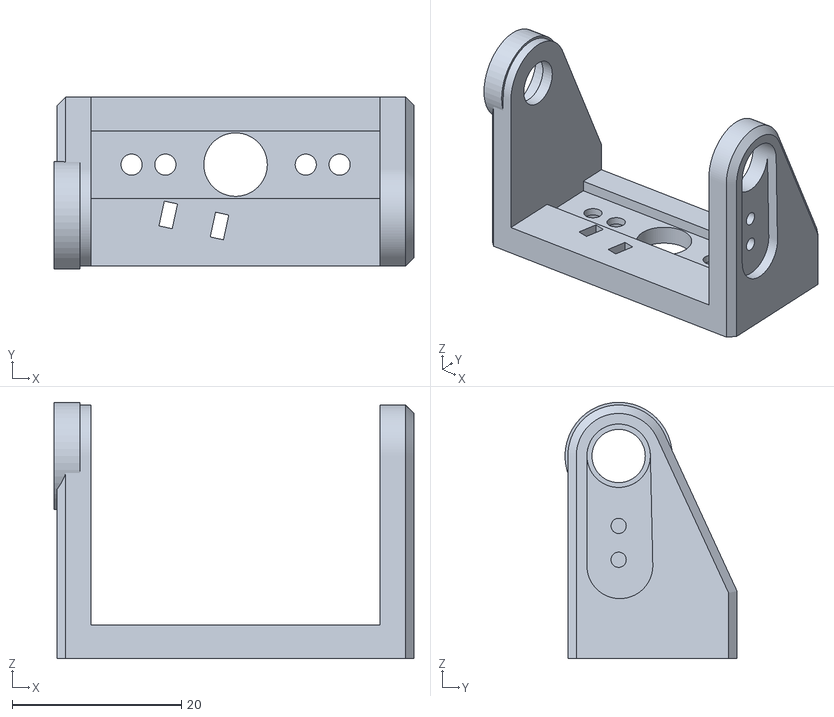
[picture p286: CAD file, 2026-09-30]
CAD/Nuevo/imprimir_B/Bracket07_B.stl
42.6 x 20.4 x 30.3
