rodrigoqweds90/Proyecto-Robot/CAD/Nuevo/piezas_boceto/Boceto_cuerpo.stl

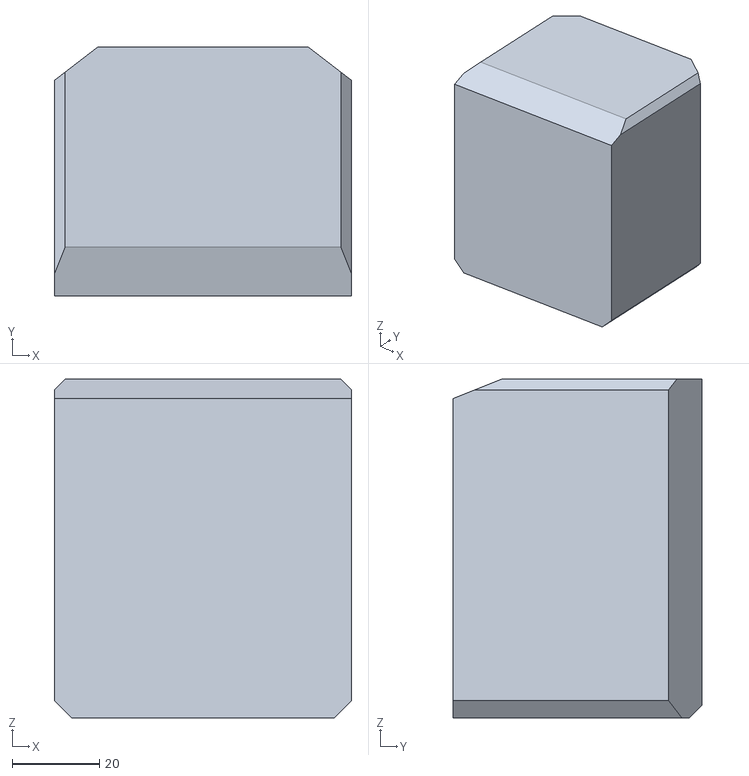
[picture p287: CAD file, 2026-09-30]
CAD/Nuevo/piezas_boceto/Boceto_cuerpo.stl
68.0 x 57.0 x 77.5
