rodrigoqweds90/Proyecto-Robot/CAD/Nuevo/step/Torso_cuerpo.stp

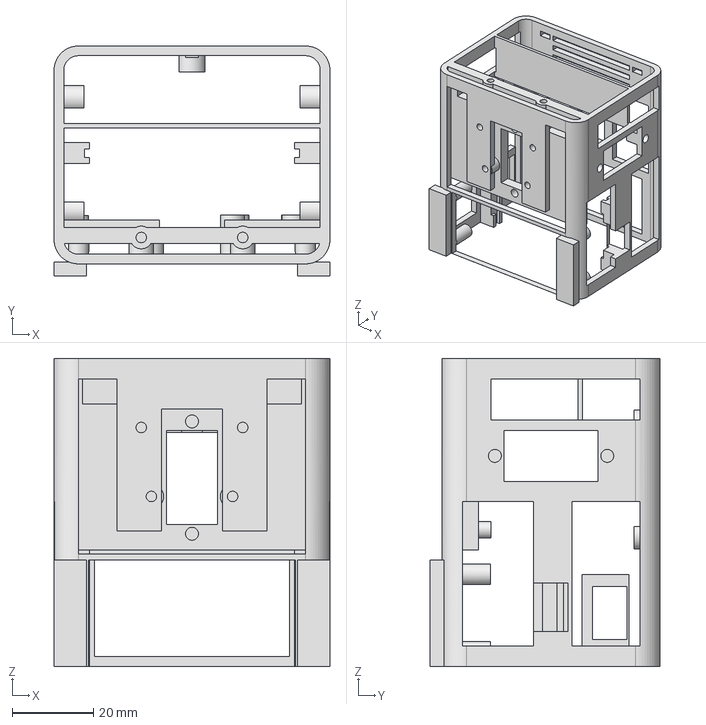
[picture p288: CAD file, 2026-09-30]
CAD/Nuevo/step/Torso_cuerpo.stp
68.0 x 56.7 x 75.9 mm
