rodrigoqweds90/Proyecto-Robot/CAD/Nuevo/fea/tmp_b10b.stl

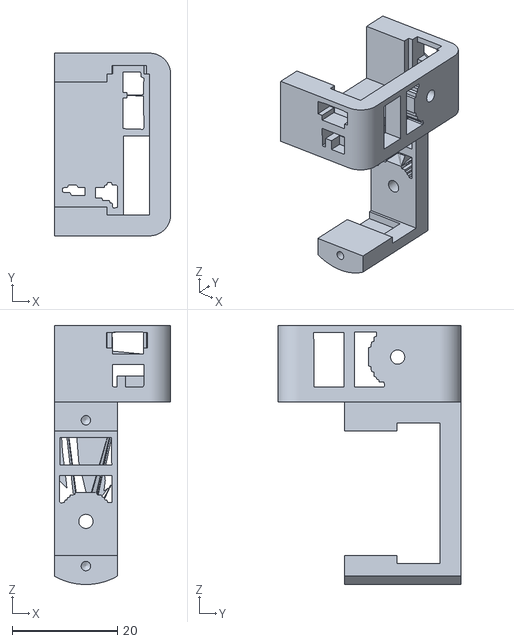
[picture p290: CAD file, 2026-09-30]
CAD/Nuevo/fea/tmp_b10b.stl
22.1 x 34.7 x 49.2
