rodrigoqweds90/Proyecto-Robot/CAD/Nuevo/para_imprimir/Pipe_M3_alto.stl

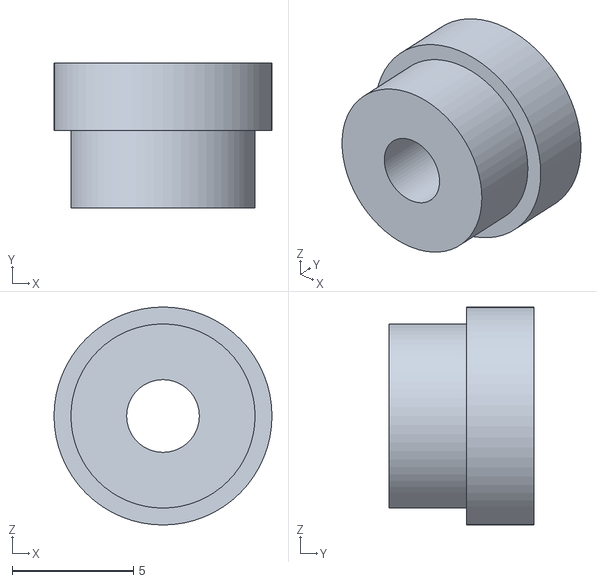
[picture p291: CAD file, 2026-09-30]
CAD/Nuevo/para_imprimir/Pipe_M3_alto.stl
9.00 x 6.00 x 9.00
