rodrigoqweds90/Proyecto-Robot/CAD/Nuevo/piezas_canales/Bracket06_W_brida.stl

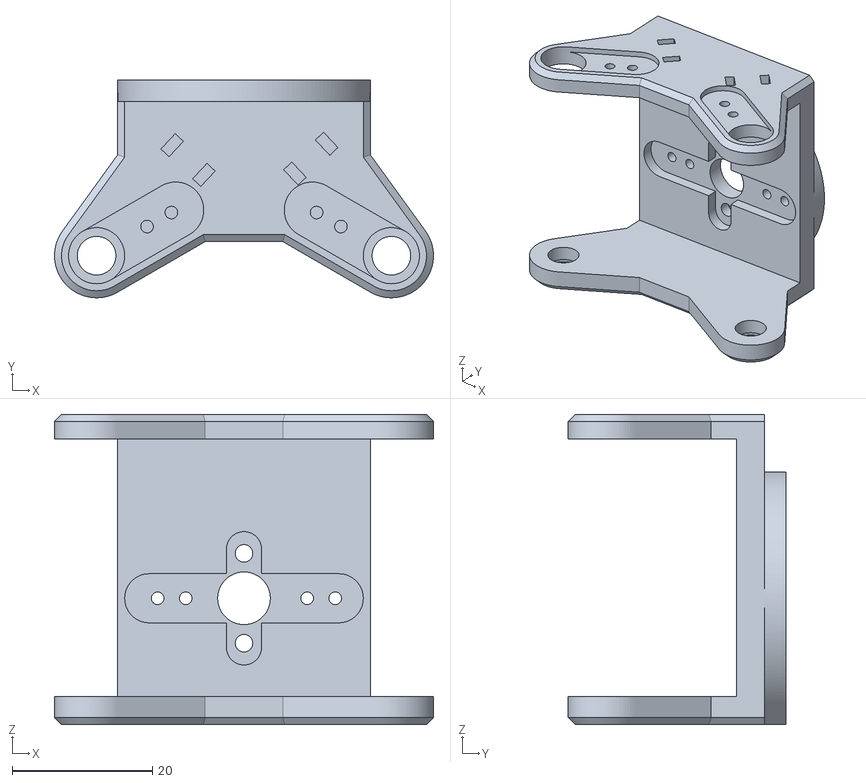
[picture p292: CAD file, 2026-09-30]
CAD/Nuevo/piezas_canales/Bracket06_W_brida.stl
54.0 x 31.0 x 44.2
