rodrigoqweds90/Proyecto-Robot/CAD/Nuevo/step/Torso_pecho.stp

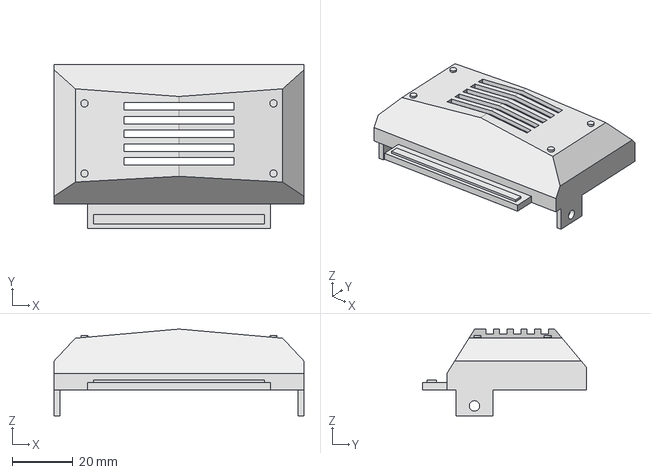
[picture p293: CAD file, 2026-09-30]
CAD/Nuevo/step/Torso_pecho.stp
82.0 x 53.7 x 28.5 mm
