rodrigoqweds90/Proyecto-Robot/CAD/Nuevo/fea/aligeradas/Bracket02_W.stl

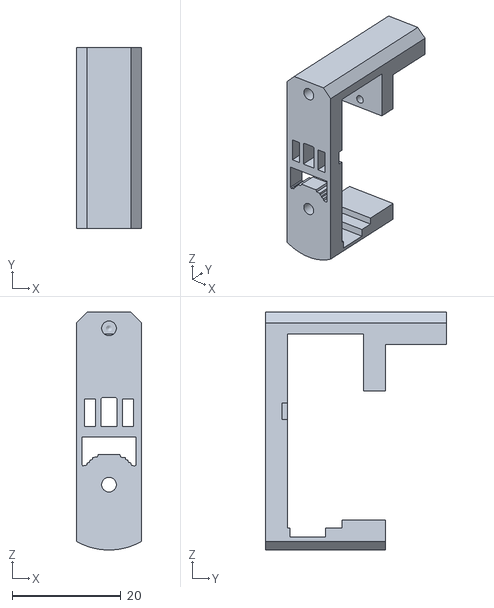
[picture p294: CAD file, 2026-09-30]
CAD/Nuevo/fea/aligeradas/Bracket02_W.stl
12.0 x 33.2 x 43.7
