rodrigoqweds90/Proyecto-Robot/CAD/Nuevo/para_imprimir/Torso_pecho.stl

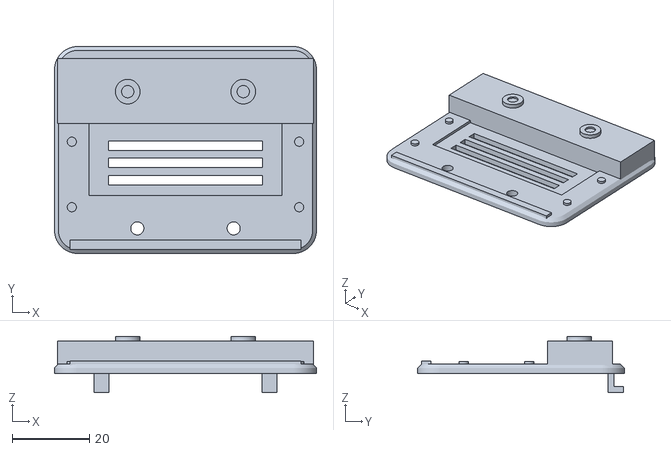
[picture p295: CAD file, 2026-09-30]
CAD/Nuevo/para_imprimir/Torso_pecho.stl
68.0 x 53.7 x 14.6
