rodrigoqweds90/Proyecto-Robot/CAD/Robot2/piezas/R2_cabeza.stl

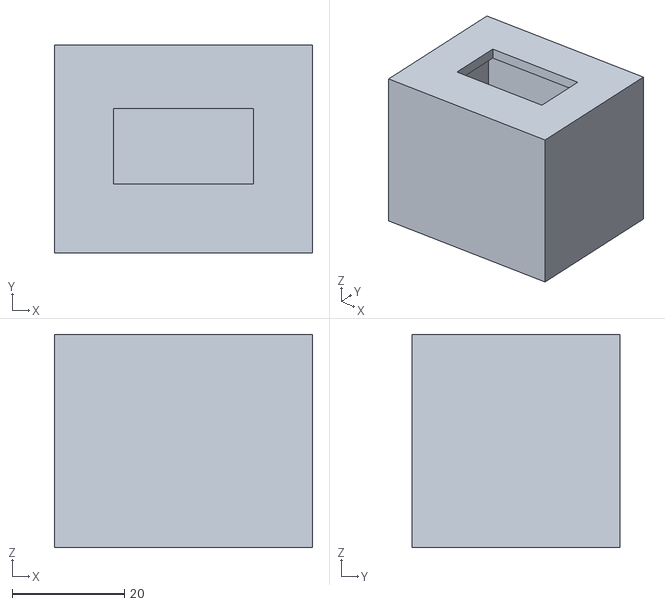
[picture p296: CAD file, 2026-10-19]
CAD/Robot2/piezas/R2_cabeza.stl
46.0 x 37.0 x 38.0
