rodrigoqweds90/Proyecto-Robot/CAD/Nuevo/para_imprimir/Prueba_horn.stl

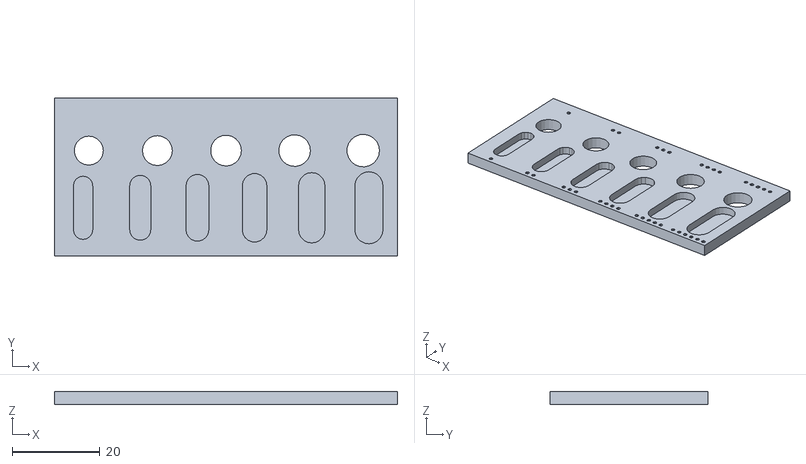
[picture p297: CAD file, 2026-09-30]
CAD/Nuevo/para_imprimir/Prueba_horn.stl
78.0 x 36.0 x 3.00
