rodrigoqweds90/Proyecto-Robot/CAD/Nuevo/piezas_boceto/Estilo1_mezcla.stl

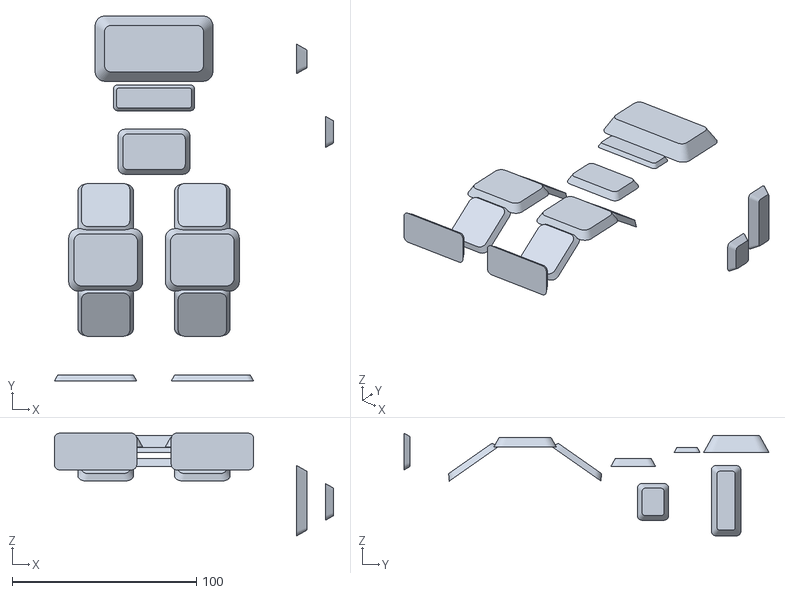
[picture p298: CAD file, 2026-09-30]
CAD/Nuevo/piezas_boceto/Estilo1_mezcla.stl
151.8 x 198.3 x 55.8
