rodrigoqweds90/Proyecto-Robot/CAD/Nuevo/piezas_m3/Bracket06_W.stl

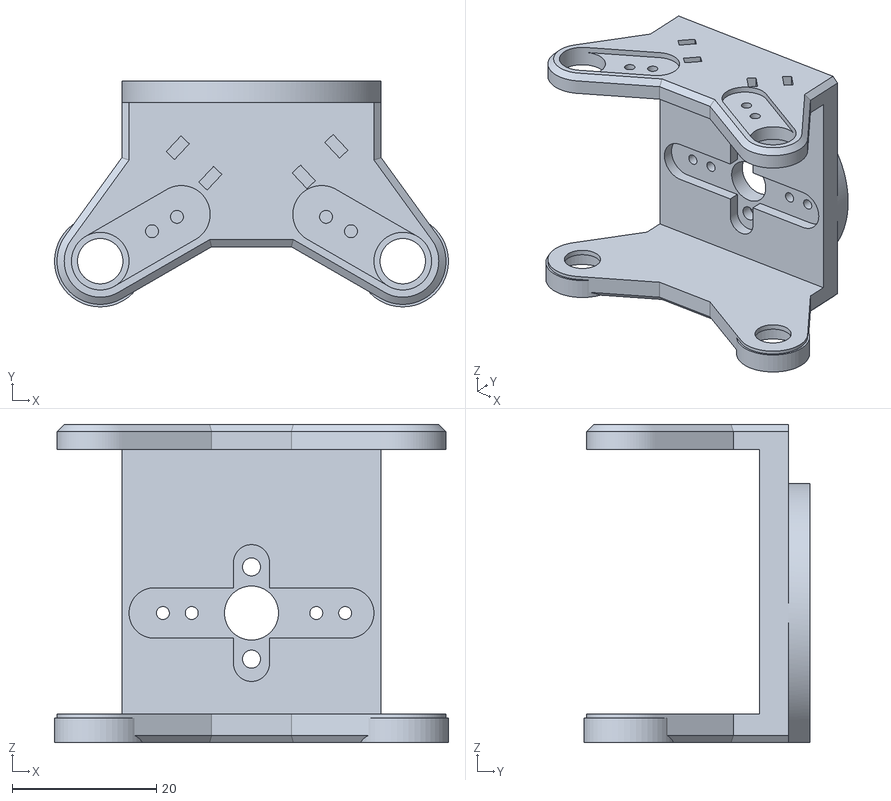
[picture p299: CAD file, 2026-09-30]
CAD/Nuevo/piezas_m3/Bracket06_W.stl
54.7 x 31.4 x 44.2
