rodrigoqweds90/Proyecto-Robot/CAD/Nuevo/fea/aligeradas/Bracket03_B.stl

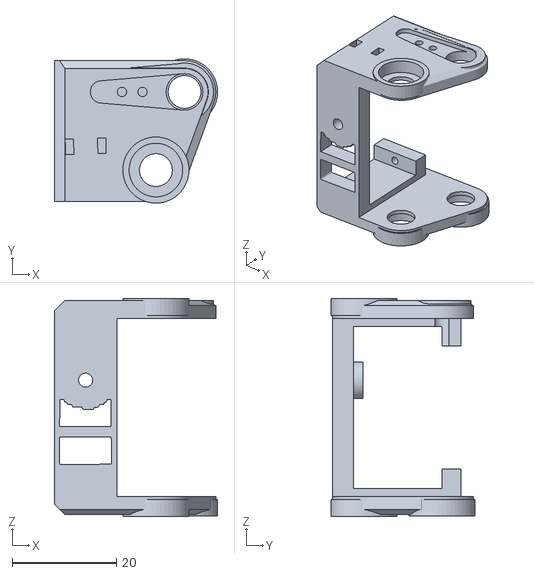
[picture p300: CAD file, 2026-09-30]
CAD/Nuevo/fea/aligeradas/Bracket03_B.stl
31.4 x 27.7 x 41.8
