rodrigoqweds90/Proyecto-Robot/CAD/Nuevo/fea/tmp_aligerada_28800.stl

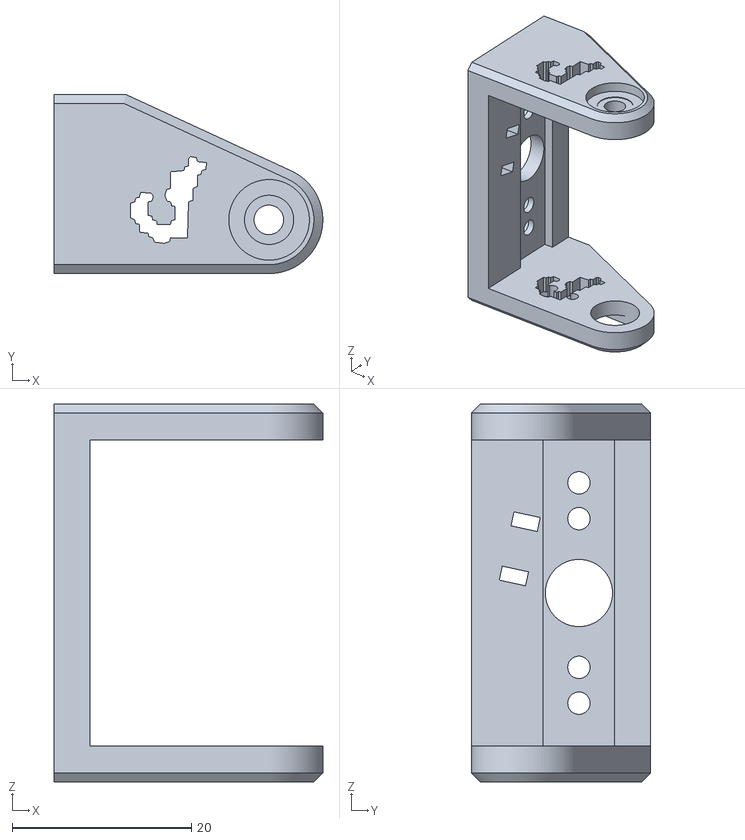
[picture p301: CAD file, 2026-09-30]
CAD/Nuevo/fea/tmp_aligerada_28800.stl
30.0 x 20.0 x 42.2
