rodrigoqweds90/Proyecto-Robot/(list of files, cad)

Other CAD files:
CAD/Nuevo/piezas_boceto/mano_puno/Bracket12_B.stl
CAD/Nuevo/piezas_estilo/Pelvis.stl
CAD/Nuevo/piezas_m3/Bracket03_B_cadera.stl
CAD/Nuevo/fea/tmp_aligerada_24136.stl
CAD/Nuevo/imprimir_B/Bracket01_B_cadera.stl
CAD/Nuevo/para_imprimir/sin_aligerar/Bracket10_W.stl
CAD/Nuevo/piezas_boceto/mano_garra/Bracket11_B.stl
CAD/Nuevo/piezas_boceto/mano_miton/Bracket11_B.stl
CAD/Nuevo/piezas_estilo/Bracket04_B.stl
CAD/Nuevo/piezas_m3/Bracket01_B_cadera.stl
CAD/Nuevo/piezas_rediseno/Bracket12_B.stl
CAD/Nuevo/Robot_imprimir_2026-09-17/1_piernas/2x_Bracket03_B.stl
CAD/Nuevo/stl_con_canales/Bracket10_W.stl
CAD/Nuevo/imprimir_B/Pelvis.stl
CAD/Nuevo/para_imprimir/Bracket09_W.stl
CAD/Nuevo/para_imprimir/sin_aligerar/Pelvis.stl
CAD/Nuevo/piezas_boceto/Mano_puno.stl
CAD/Nuevo/piezas_canales/Bracket07_B_brida.stl
CAD/Nuevo/Robot_imprimir_2026-09-17/1_piernas/1x_Bracket05_B.stl
CAD/Nuevo/Robot_imprimir_2026-09-17/2_cadera_y_torso/1x_Torso_barra_bateria.stl
CAD/Nuevo/step/Torso_cuerpo_B.stp
CAD/Nuevo/stl_con_canales/Bracket02_W.stl
CAD/Nuevo/para_imprimir/Cabeza_tapa.stl
CAD/Nuevo/piezas_canales/Bracket10_W_brida.stl
CAD/Nuevo/piezas_estilo/Bracket05_B.stl
CAD/Nuevo/Robot_imprimir_2026-09-17/3_brazos/1x_Bracket12_B.stl
CAD/Nuevo/step/Cabeza_tapa.stp
CAD/Robot2/piezas/R2_muslo_der.stl
CAD/Componentes/ESP32_devkit_v1_30pin_printables.step
CAD/Nuevo/imprimir_B/Bracket03_B.stl
CAD/Nuevo/para_imprimir/sin_aligerar/Torso_cuerpo.stl
CAD/Nuevo/piezas_canales/Bracket03_B_brida.stl
CAD/Nuevo/piezas_m3/Bracket05_B.stl
CAD/Nuevo/step/Cabeza_frente.stp
CAD/Nuevo/suyo_alineado.stl
CAD/Robot2/piezas/R2_cadera_izq.stl
CAD/Nuevo/fea/aligeradas/Torso_cuerpo.stl
CAD/Nuevo/fea/tmp_aligerada_27708.stl
CAD/Nuevo/para_imprimir/Bracket04_B.stl
CAD/Nuevo/para_imprimir/sin_aligerar/Bracket12_B.stl
CAD/Nuevo/piezas_canales/Bracket09_W_brida.stl
CAD/Nuevo/piezas_m3/Bracket03_B.stl
CAD/Nuevo/piezas_soportes/Soporte_pierna_der.stl
CAD/Robot2/piezas/R2_pelvis.stl
CAD/Robot2/revision/R2_muslo_link_izq.stl
CAD/Nuevo/imprimir_B/Soporte_pierna_izq.stl
CAD/Nuevo/para_imprimir/sin_aligerar/Bracket05_B.stl
CAD/Nuevo/piezas_boceto/_Cabeza_frente_0.stl
CAD/Nuevo/piezas_m3/Bracket02_W.stl
CAD/Robot2/piezas/R2_pie_der.stl
CAD/Robot2/revision/R2_muslo_der.stl
CAD/Nuevo/fea/tmp_aligerada_12204.stl
CAD/Nuevo/imprimir_B/Soporte_pierna_der.stl
CAD/Nuevo/para_imprimir/sin_aligerar/Bracket02_W.stl
CAD/Nuevo/piezas_boceto/_Cabeza_frente_1.stl
CAD/Nuevo/piezas_canales/Bracket01_B_brida.stl
CAD/Nuevo/piezas_m3/Bracket04_B.stl
CAD/Robot2/revision/R2_canilla_der.stl
CAD/Nuevo/fea/aligeradas/Bracket09_W.stl
CAD/Nuevo/fea/tmp_pie_26264.stl
CAD/Nuevo/imprimir_B/Bracket04_B.stl
CAD/Nuevo/para_imprimir/sin_aligerar/Bracket11_B.stl
CAD/Robot2/piezas/R2_canilla_der.stl
CAD/Robot2/revision/R2_pie_izq.stl
CAD/Componentes/Bateria_LiPo_2S_1000_62x22x16.ipt
CAD/Componentes/Bateria_LiPo_2S_1000_62x23x17.ipt
CAD/Componentes/ESP32_devkit_v1_30pin.iam
CAD/Componentes/ESP32_devkit_v1_30pin_printables/MICRO USB B.ipt
CAD/Componentes/ESP32_devkit_v1_30pin_printables/PIN.ipt
CAD/Componentes/ESP32_devkit_v1_30pin_printables/Pieza12.ipt
CAD/Componentes/ESP32_devkit_v1_30pin_printables/soudures.ipt
CAD/Componentes/Fichas_pines_ESP32.ipt
CAD/Componentes/Fichas_pines_ESP32_atras.ipt
CAD/Componentes/Fichas_pines_ESP32_atras14.ipt
CAD/Componentes/Fichas_pines_IMU.ipt
CAD/Componentes/Fichas_servos_PCA.ipt
CAD/Componentes/Fichas_servos_PCA_atras.ipt
CAD/Componentes/IMU_GY521_21x16.ipt
CAD/Componentes/MG90S_grabcad_mg90s9.ipt
CAD/Componentes/MG90S_grabcad_mg90s9.stl
CAD/Componentes/MG90S_grabcad_towerpro.ipt
CAD/Componentes/MG90S_horn_arm01.ipt
CAD/Componentes/MG90S_horn_cruz.ipt
CAD/Componentes/MG90S_horn_cruz.stl
CAD/Componentes/MG90S_horn_doble.ipt
CAD/Componentes/MG90S_horn_doble.stl
CAD/Componentes/MG90S_horn_github.ipt
CAD/Componentes/PCA9685_adafruit_815.iam
CAD/Componentes/PCA9685_adafruit_815/0805-NO.ipt
CAD/Componentes/PCA9685_adafruit_815/3X04.ipt
CAD/Componentes/PCA9685_adafruit_815/Board.ipt
CAD/Componentes/PCA9685_adafruit_815/CHIPLED_0805_NOOUTLINE.ipt
CAD/Componentes/PCA9685_adafruit_815/RESPACK_4X0603.ipt
CAD/Componentes/PCA9685_adafruit_815/TERMBLOCK_1X2-3.5MM.ipt
CAD/Componentes/PCA9685_adafruit_815/TO252.ipt
CAD/Componentes/PCA9685_adafruit_815/TSSOP28.ipt
CAD/Componentes/PCA9685_adafruit_815/_0805MP.ipt
CAD/Componentes/UBEC_6V_5A_36x18x9.ipt
CAD/Componentes/XL4015_51x14x26_acostado.ipt
CAD/Componentes/XL4015_51x26x14.ipt
CAD/Componentes/XL4015_52x12x24_acostado.ipt
CAD/Componentes/freecad_SG90-1-arm-horn.iam
CAD/Componentes/freecad_SG90-1-arm-horn/Final-1-arm-horn.ipt
CAD/Componentes/freecad_SG90-2-arms-horn.iam
CAD/Componentes/freecad_SG90-2-arms-horn/Final-2-arms-horn.ipt
CAD/Componentes/freecad_SG90-4-arms-horn.iam
CAD/Componentes/freecad_SG90-4-arms-horn/Final-4-arms-horn.ipt
CAD/NX25_original/Bracket01_B.ipt
CAD/NX25_original/Bracket02_W.ipt
CAD/NX25_original/Bracket03_B.ipt
CAD/NX25_original/Bracket04_B.ipt
CAD/NX25_original/Bracket05_B.ipt
CAD/NX25_original/Bracket06_W.ipt
CAD/NX25_original/Bracket07_B.ipt
CAD/NX25_original/Bracket08_B.ipt
CAD/NX25_original/Bracket09_W.ipt
CAD/NX25_original/Bracket10_W.ipt
CAD/NX25_original/Bracket11_B.ipt
CAD/NX25_original/Bracket12_B.ipt
CAD/NX25_original/Frame01_W.ipt
CAD/NX25_original/Head_W.ipt
CAD/NX25_original/Link_W.ipt
CAD/NX25_original/NX25_armado.iam
CAD/NX25_original/Nee_B.ipt
CAD/NX25_original/Pipe_B.ipt
CAD/NX25_original/Plate01_B.ipt
CAD/NX25_original/Plate02_B.ipt
CAD/NX25_original/Spacer01_W.ipt
CAD/NX25_original/Spacer02_2_B.ipt
CAD/NX25_original/Spacer02_B.ipt
CAD/NX25_original/UpperCover_B_B.ipt
CAD/NX25_original/UpperCover_F_B.ipt
CAD/NX25_original/UpperCover_Plate.ipt
CAD/NX25_original/UpperCover_Plate_B.ipt
CAD/Nuevo/Cabeza_frente.ipt
CAD/Nuevo/Cabeza_nueva.ipt
CAD/Nuevo/Cabeza_tapa.ipt
CAD/Nuevo/Moldes_armado.iam
CAD/Nuevo/Pelvis.ipt
CAD/Nuevo/Placa_impresion_B.iam
CAD/Nuevo/Prueba_horn.ipt
CAD/Nuevo/Robot_aligerado.iam
CAD/Nuevo/Robot_armado.iam
CAD/Nuevo/Robot_armado_B.iam
CAD/Nuevo/Robot_blanco_B.iam
CAD/Nuevo/Robot_en_molde_calibrador.iam
CAD/Nuevo/Robot_en_soporte.iam
CAD/Nuevo/Torso_atras_B.ipt
CAD/Nuevo/Torso_barra_bateria.ipt
CAD/Nuevo/Torso_cuerpo.ipt
CAD/Nuevo/Torso_cuerpo_B.ipt
CAD/Nuevo/Torso_espalda.ipt
CAD/Nuevo/Torso_estudio.iam
CAD/Nuevo/Torso_estudio_B.iam
CAD/Nuevo/Torso_pecho.ipt
CAD/Nuevo/Torso_protector_B.ipt
CAD/Nuevo/fea/aligeradas/Bracket01_B.stl
CAD/Nuevo/fea/aligeradas/Bracket07_B.stl
CAD/Nuevo/fea/aligeradas/Bracket11_B.stl
CAD/Nuevo/fea/aligeradas/Nee_B.stl
CAD/Nuevo/fea/aligeradas/Pelvis.stl
CAD/Nuevo/fea/tmp_aligerada_10704.stl
CAD/Nuevo/fea/tmp_aligerada_15952.stl
CAD/Nuevo/fea/tmp_aligerada_22952.stl
CAD/Nuevo/fea/tmp_aligerada_28472.stl
CAD/Nuevo/fea/tmp_aligerada_6152.stl
CAD/Nuevo/fea/tmp_torso_espalda.stl
CAD/Nuevo/imprimir_B/Bracket01_B.stl
CAD/Nuevo/imprimir_B/Bracket05_B.stl
CAD/Nuevo/imprimir_B/Bracket08_B.stl
CAD/Nuevo/imprimir_B/Bracket09_W.stl
CAD/Nuevo/imprimir_B/Bracket10_W.stl
CAD/Nuevo/imprimir_B/Bracket11_B.stl
CAD/Nuevo/imprimir_B/Bracket12_B.stl
CAD/Nuevo/imprimir_B/Cabeza_frente.stl
CAD/Nuevo/imprimir_B/Cabeza_tapa.stl
CAD/Nuevo/imprimir_B/Link_W.stl
CAD/Nuevo/imprimir_B/Nee_B.stl
CAD/Nuevo/imprimir_B/Pipe_M3.stl
CAD/Nuevo/imprimir_B/Soporte_parado.stl
CAD/Nuevo/imprimir_B/Spacer01_W.stl
CAD/Nuevo/imprimir_B/Torso_atras_B.stl
CAD/Nuevo/imprimir_B/Torso_cuerpo_B.stl
CAD/Nuevo/imprimir_B/Torso_pecho.stl
CAD/Nuevo/para_imprimir/Bracket07_B.stl
CAD/Nuevo/para_imprimir/Pelvis.stl
CAD/Nuevo/para_imprimir/Torso_cuerpo.stl
CAD/Nuevo/para_imprimir/Torso_cuerpo_B.stl
CAD/Nuevo/para_imprimir/sin_aligerar/Bracket03_B.stl
CAD/Nuevo/para_imprimir/sin_aligerar/Bracket04_B.stl
CAD/Nuevo/para_imprimir/sin_aligerar/Bracket07_B.stl
CAD/Nuevo/para_imprimir/sin_aligerar/Bracket08_B.stl
CAD/Nuevo/para_imprimir/sin_aligerar/Bracket09_W.stl
CAD/Nuevo/para_imprimir/sin_aligerar/Link_W.stl
CAD/Nuevo/piezas_aligeradas/Bracket01_B.ipt
CAD/Nuevo/piezas_aligeradas/Bracket02_W.ipt
CAD/Nuevo/piezas_aligeradas/Bracket03_B.ipt
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
