rodrigoqweds90/Proyecto-Robot/CAD/Nuevo/vistas_torso/moldes_armado.png

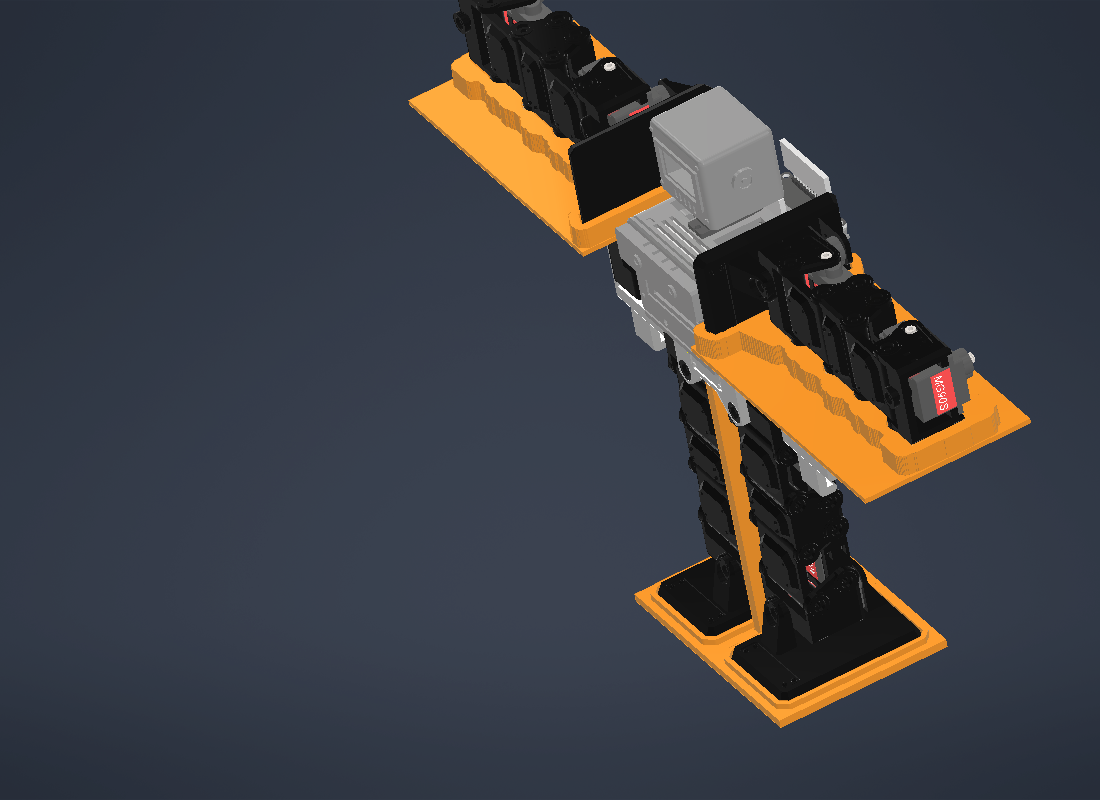
CAD/Nuevo/vistas_torso/moldes_armado.png
