rodrigoqweds90/Proyecto-Robot/CAD/Nuevo/vistas_torso/robot_ensamblado_final.png

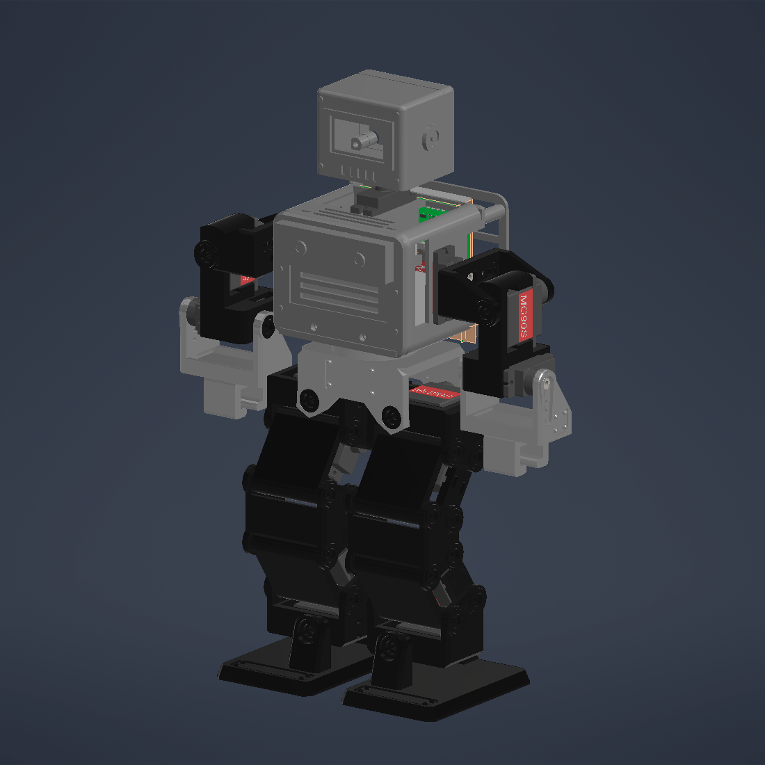
CAD/Nuevo/vistas_torso/robot_ensamblado_final.png
