rodrigoqweds90/Proyecto-Robot/CAD/NX25_original/vistas_armado/atras.png

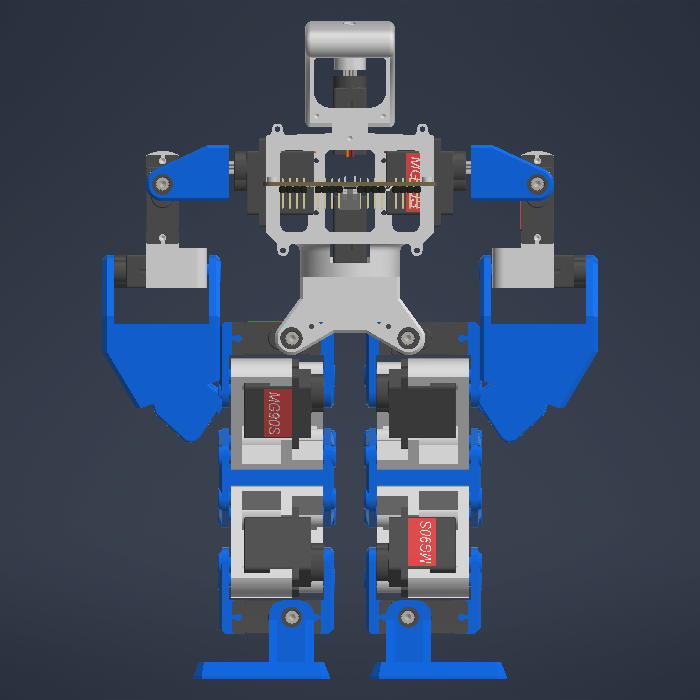
CAD/NX25_original/vistas_armado/atras.png
