rodrigoqweds90/Proyecto-Robot/CAD/NX25_original/vistas_armado/cerca_cadera.png

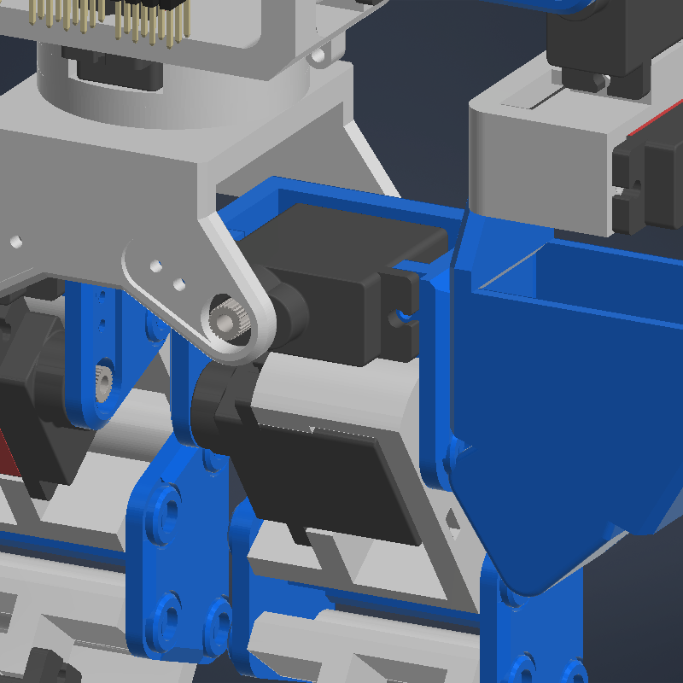
CAD/NX25_original/vistas_armado/cerca_cadera.png
