rodrigoqweds90/Proyecto-Robot/CAD/NX25_original/vistas_armado/cerca_piernas_atras.png

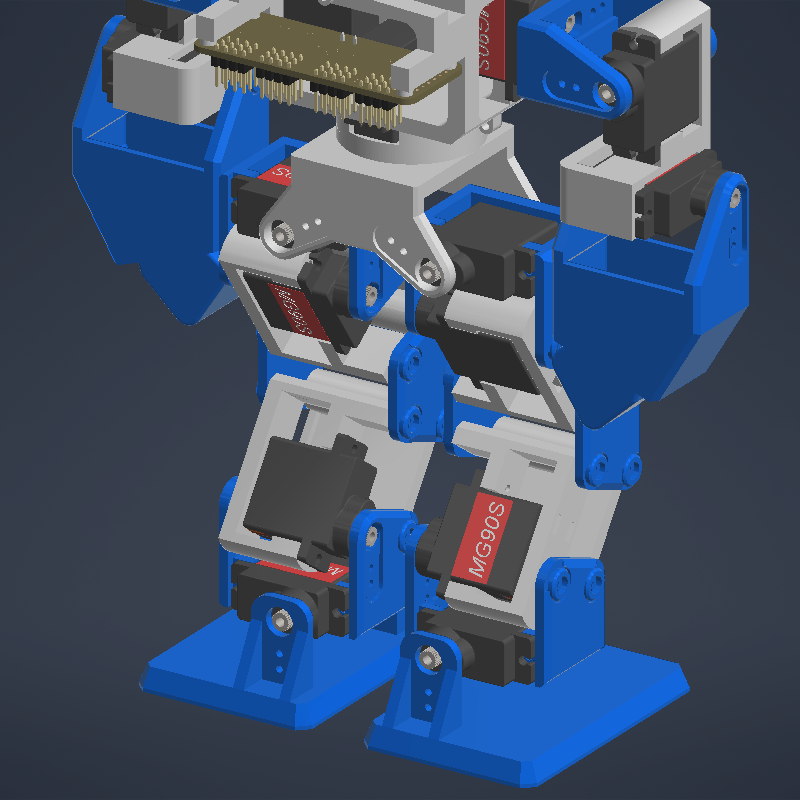
CAD/NX25_original/vistas_armado/cerca_piernas_atras.png
