rodrigoqweds90/Proyecto-Robot/CAD/NX25_original/vistas_armado/cerca_rodilla_tobillo.png

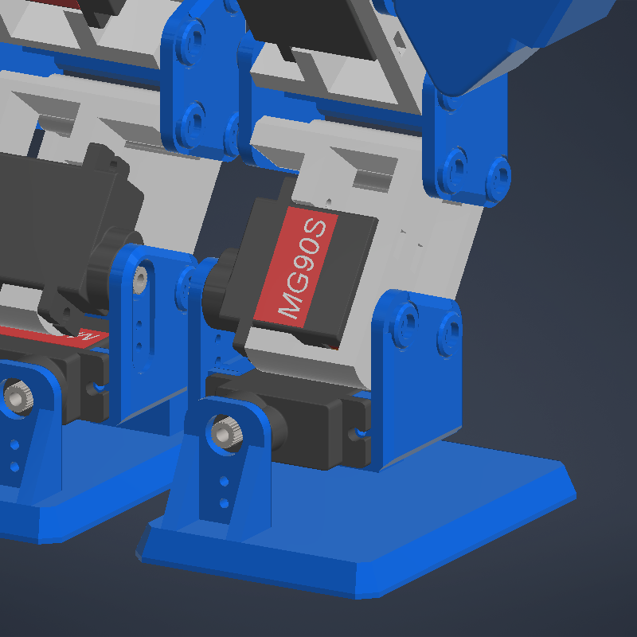
CAD/NX25_original/vistas_armado/cerca_rodilla_tobillo.png
