rodrigoqweds90/Proyecto-Robot/CAD/NX25_original/vistas_armado/cerca_torso_pca.png

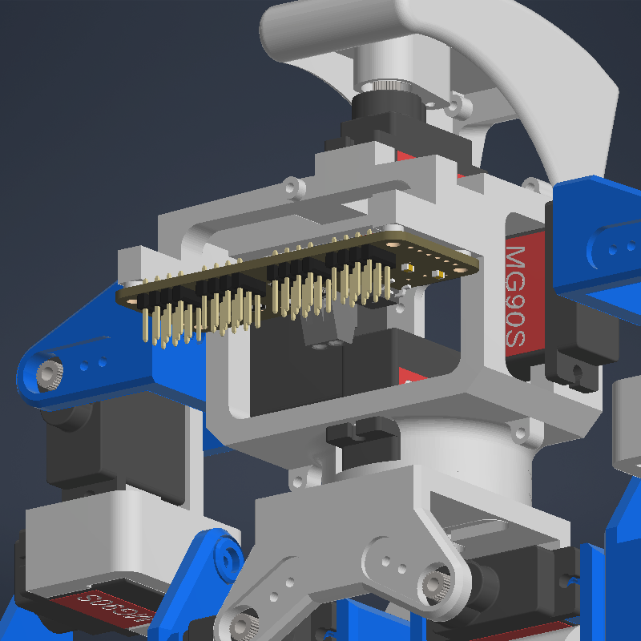
CAD/NX25_original/vistas_armado/cerca_torso_pca.png
