rodrigoqweds90/Proyecto-Robot/CAD/NX25_original/vistas_armado/costado.png

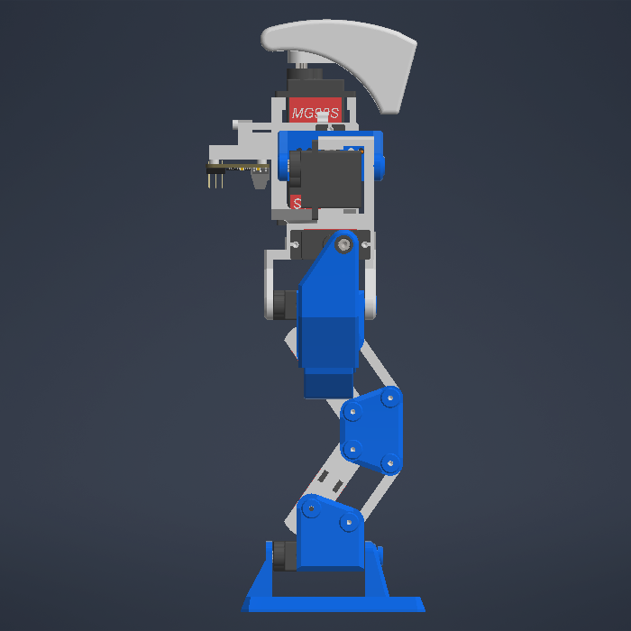
CAD/NX25_original/vistas_armado/costado.png
