rodrigoqweds90/Proyecto-Robot/CAD/NX25_original/vistas_armado/NX25_armado_4_vistas.png

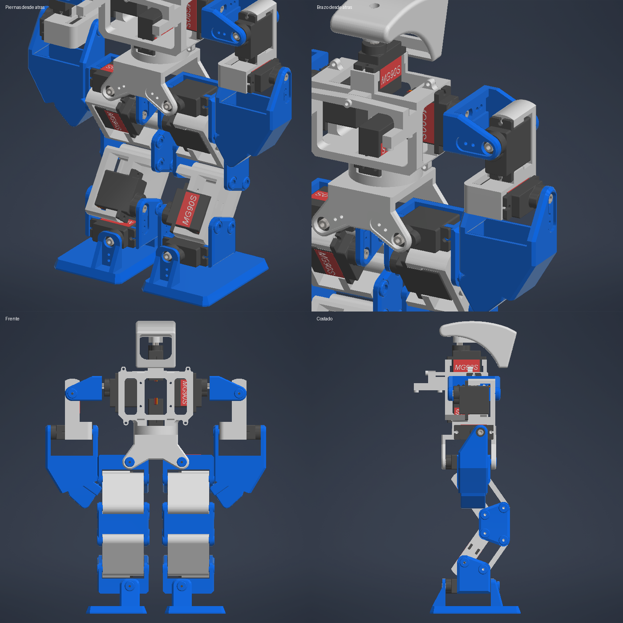
CAD/NX25_original/vistas_armado/NX25_armado_4_vistas.png
