rodrigoqweds90/Proyecto-Robot/CAD/Nuevo/vistas_torso/prueba_horn.png

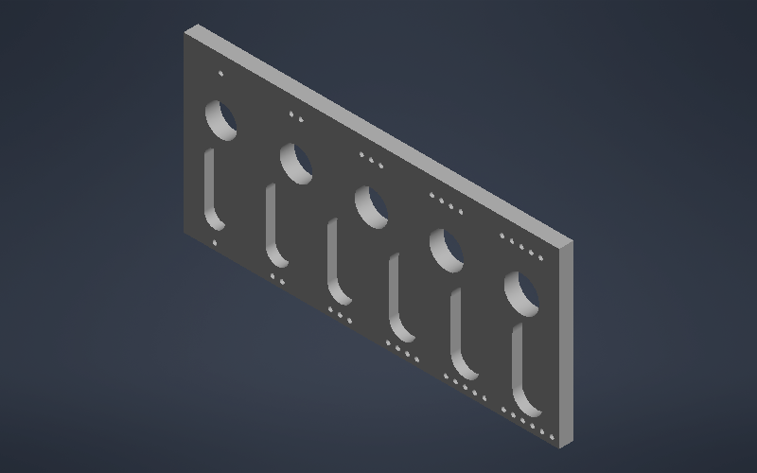
CAD/Nuevo/vistas_torso/prueba_horn.png
