rodrigoqweds90/Proyecto-Robot/CAD/Nuevo/fea/debug_b02.png

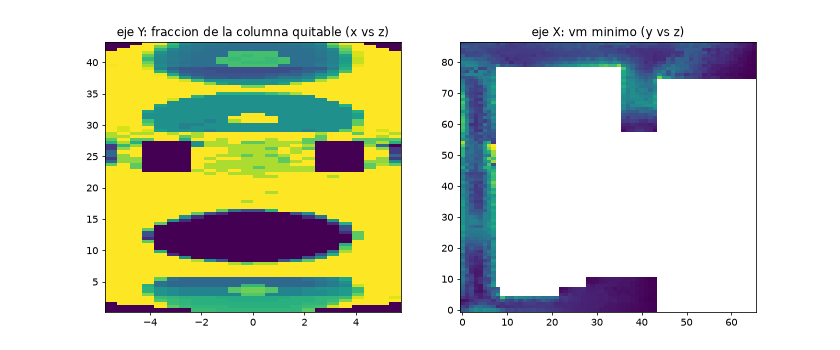
CAD/Nuevo/fea/debug_b02.png
