rodrigoqweds90/Proyecto-Robot/app/config.py

"""Constantes globales de comunicacion. El mapeo de servos ya no vive aqui:
esta en channel_config.py y es editable desde la app (menu Configuracion)."""

SERVO_FREQ_HZ = 50
PULSO_MIN_ABS = 500
PULSO_MAX_ABS = 2450
PULSO_CENTRO = 1475
