rodrigoqweds90/Proyecto-Robot/(commit log)

2026-09-01 Version inicial: firmware ESP32 + app de control de robot
    Firmware: PCA9685 (servos), MPU6050 (IMU con fix de orientacion),
    WiFi AP + TCP, protocolo serie compartido, OLED de caras.
    App: control manual de 16 servos, guardar/aplicar/sobrescribir poses,
    secuencias categorizadas con exportacion, indicador de giroscopio,
    subida de firmware desde la app, instalador con Inno Setup.
2026-09-14 Añade panel de mando, ajustes de posiciones/secuencias y actualiza firmware
    Reemplaza attitude_indicator por mando_panel, mejora storage y
    robot_link, y actualiza binarios de firmware ESP32.
2026-09-30 Agrega el CAD del robot NX25 variante B y los avances de firmware y app
    - CAD/Nuevo: scripts de Inventor (torso, cabeza, pelvis, piezas, uniones, soportes de armado),
    piezas .ipt/.iam, STL de impresion, verificaciones y resultados de esfuerzos
    - Torso reforzado en la zona del interruptor (barras y aros en el plano de la capa)
    - Cabeza: rebaje del horn con mas holgura y postes M2 para la pantalla OLED
    - CAD/Componentes y CAD/NX25_original: modelos de servos, electronica y el NX25 de GitHub
    - app y firmware: ajustes del panel y del indicador de actitud
    - .gitignore: respaldos (OldVersions) y temporales del calculo de esfuerzos quedan fuera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
2026-10-17 Robot2: masas reales y comparacion del CoG con Inventor
    r2_masas_reales.py calcula el centro de masa con las masas reales de la
    electronica (+10 % de cables y tornilleria), los casos de estabilidad y los
    torques de servo. r2_inventor_masas.py aplica esas masas en memoria a
    Robot2.iam, compara el CoG de Inventor y cierra todo sin guardar.
2026-10-19 Caminata que funciona (paso del usuario), simulador 2D/3D y respaldo antes del firmware sincronizado
    - herramientas/caminata_usuario.py: adelante/atras armado por el usuario, un cambio por pose
    - caminata_lado_giro.py: paso de costado (funciona) y giro (todavia no gira)
    - simular_caminata.py, visor_simulador.py, visor3d.py: simulador estatico con vista 3D del CAD
    - respaldo_camina_ok/: firmware.bin y datos de la app de este momento
2026-10-19 Movimiento sincronizado: comando POSET en el firmware y casilla en Secuencias
    POSET,p0..p15,ms mueve los 16 servos para que lleguen juntos en ms, con arranque
    y frenado suaves. POSE queda igual. En la app la casilla 'Movimiento sincronizado'
    (apagada por defecto) manda cada paso de la secuencia con POSET y su duracion.
    build_installer.ps1: guion largo cambiado por '-' (PowerShell 5.1 no parseaba el script).
2026-10-19 app/firmware: binario con POSET (lo que sube el boton Subir firmware)
2026-10-19 Subir firmware: espera a que el puerto se libere y explica los errores en espanol
    Al desconectar la app justo antes de flashear, Windows tardaba en soltar el COM y
    esptool fallaba con 'Acceso denegado'. Ahora espera hasta 8 s a que se pueda abrir,
    y si falla dice que hacer (puerto ocupado por otro programa, cable, puerto, BOOT).
2026-10-19 Secuencias rapidas calculadas paso por paso y POSET que termina 30 ms antes
    acelerar_secuencias.py: tiempo minimo de cada paso por velocidad del servo (MG90S/MG92B
    a 6 V, 40 % con carga, pico 1.5x por la curva suave) y por equilibrio (punto de apoyo
    efectivo instante por instante con el simulador, 3 mm adentro del pie). Nunca mas lento
    que lo ya probado. Escribe '<nombre> rapido' (necesitan Movimiento sincronizado).
    App: el movimiento de POSET dura 30 ms menos que el paso, asi el firmware (tick de
    15 ms) completa cada pose antes de recibir la siguiente.
2026-10-19 Subir firmware: reintenta a 115200 si se corta, detecta memoria flash que no responde
    Placas con CH340 perdian la comunicacion a 460800 ('serial noise or corruption'):
    ahora reintenta solo a 115200. Si el ESP32 no puede leer su memoria flash (tipico
    con GPIO12 en alto al arrancar, o placa danada) lo explica en vez de un error en ingles.
    La consola ya no muestra codigos de color de esptool.
2026-10-19 Subir firmware: MD5 que no coincide tambien se explica como memoria flash que no responde
2026-10-19 Caminata fluida: 4 poses por paso y modo Continuo (curva suave por todas las poses)
    - caminata_usuario.py: 'Adelante fluido' junta centrar + inclinar al otro lado en un solo
    movimiento, y la de apoyo a vertical + la otra pasando doblada a la vez (6 -> 4 poses).
    - app/curva.py: curva cubica monotona por todas las poses (no se pasa de ningun angulo).
    - Secuencias: casilla 'Continuo (mas fluido)': manda la curva en tramos de 50 ms
    (temporizador de precision) con POSET lineal, sin frenar en cada pose.
    - Firmware: POSET,...,ms,1 = velocidad pareja (sin el modo, igual que antes).
    - acelerar_secuencias.py: verificar_continuo() revisa velocidad de servos y punto de apoyo
    sobre la misma curva q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
2026-10-19 Secuencias finales: 3 pasos de erguido a erguido (para bucle), rapidas y lentas; limpieza
    - secuencias_finales.py arma todas las secuencias de la app y borra lo que no usa ninguna:
    Adelante / Atras / Costado izq / Costado der '3 pasos' (fluidas, tiempos calculados y
    verificadas en modo continuo) y sus versiones 'lento' (400 ms, las ya probadas).
    - caminata_usuario.py y caminata_costado.py (antes caminata_lado_giro.py) solo arman poses.
    - Fuera: giro (no giraba), pruebas de paso largo y poca inclinacion (mas lentas y sin margen
    segun el simulador), caminata_propia.py, caminata_fases.py.
2026-10-19 Movimientos: poses y secuencias exportadas para importar en otra PC
2026-10-19 Simulador con brazos y prueba de caminata con contrapeso y balanceo
    - simular_caminata.py: brazos en 3 grupos por lado (hombro, codo, mano) que giran con su
    servo; ejes sacados de la salida de cada servo en el CAD, signos probados por el usuario.
    Ejes de cadera y tobillo corregidos (salida del servo, 5 mm adentro de la linea de la pierna).
    - visor 3D: los brazos se mueven con la secuencia.
    - caminata_brazos.py: 'Prueba adelante 3 pasos brazos' (brazo del pie de apoyo abierto 60,
    el otro pegado 5, balanceo 20 opuesto a las piernas). Margen quieto 6.8 -> 8.5 mm.
2026-10-19 CAD: STL nuevos y actualizados (Robot2 piezas y revision, brackets de cadera, moldes calibrador, Pelvis)
2026-10-26 Secuencias de un ciclo para bucle y margen de equilibrio mas estricto en las rapidas
    - secuencias_finales.py: cada secuencia es un ciclo (paso izquierdo + derecho) que se repite sin
    saltos y se alcanza directo desde Inicio; se borran las de 3 pasos. Los tiempos de la primera pose
    sirven para entrar desde Inicio y para la vuelta del bucle; verificado con 3 vueltas en Continuo.
    - acelerar_secuencias.py: ningun paso puede perder mas de 6 mm de margen por moverse rapido
    (las rapidas anteriores perdian hasta 16 mm al pasar el peso de un pie al otro y se sentian bruscas).
    - caminata_brazos.py: brazos abiertos 30 grados (no 60) mas balanceo, como un ciclo para bucle.
    - La limpieza conserva la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
2026-11-04 Firmware: mando EasySMX por Bluepad32, OLED en el mismo I2C y sin giroscopio
    - Arranque en modo MANDO (Bluetooth clasico, Bluepad32) o WIFI, exclusivos; MODO,WIFI / MODO,MANDO lo cambia y reinicia.
    - OLED en el bus del PCA9685 (GPIO21/22), enviada pagina por pagina para no frenar los servos.
    - Fuera MPU6050, balance y nivelado (codigo anterior en 9a44668).
    - Se compila con arduino-cli y el paquete esp32-bluepad32 (sync_firmware.ps1), particion no_ota.
    - App: fuera la pestana de balance; firmware .bin regenerado.
2026-11-04 CAD: Robot2, molde calibrador, brackets de cadera y ajustes de piezas M3
2026-11-07 Firmware: la OLED se busca en 0x3C o 0x3D al arrancar
    Estaba fija en 0x3D y la mayoria de los OLED vienen en 0x3C; como begin() de
    Adafruit no comprueba que haya alguien, la cara no salia sin ningun aviso.
2026-11-07 Firmware: caras solo con ojos, sin boca
    Cada expresion se arma con la forma de los ojos: neutral (rectangulos
    redondeados), feliz (arcos "^"), triste (parpado caido hacia afuera) y
    sorpresa (circulos grandes).
2026-11-07 Mando: el robot guarda las secuencias y las ejecuta solo con el mando
    - App, pestana Mando: "Enviar al robot" pasa las secuencias asignadas (en
    pulsos) y que hace cada boton, una linea por vez con respuesta del robot.
    - Firmware: lo guarda en LittleFS (/mando.txt) y al apretar un boton corre
    su secuencia, pose o comando. Con "repetir", sigue en bucle mientras se
    mantiene; al soltar termina la vuelta y vuelve a Inicio.
